MikAmperka/abot_src/ros/README.md

# The Amperka robot "Abot".
RPI4, ROS, DiffDrive, RPLidar, SLAM.
