MikAmperka/abot_src/ARTICLE_RU/description/RU.md

---
title: Как сделать робота на ROS своими руками
short: Собираем своего робота на Raspberry Pi 4 под управлением ROS и C++
date: 2021-04-07
author: Максим Данилин
all_tags:
 - Raspberry Pi 4
 - С++
 - ROS
 - 3D-печать
 - Linux
 - Solidworks
 - RPLIDAR
 - Troyka HAT
 - Двухканальный Н-мост
 - SLAM
 - Навигация
---

## Введение

Привет!

В этой статье мы на подробном примере расскажем о том, как построить настоящего робота целиком на инфракструктуре ROS. Это будет наш первый простой робот со своей операционной системой.

Далее мы постараемся пошагово и как можно подробнее рассказать вам о процессе проектирования, конструирования и программирования робота, а также расскажем, с каким трудностями и проблемами мы столкнулись.

Создание свеого робота — это не самая сложная, но и не тривиальная задача. Она требует опредёленных навыков хотя бы на минимальном уровне:

- Работа с OS Linux.
- Твердотельное 3D-моделирование.
- Программирование на С++ или Python.
- Навыки 3D-печати.

Также вам понадобится персональный компьютер под управлением OS Linux, Windows и локальная сеть Wi-Fi.

Все исходники — как конструкторские САПР-файлы, так и исходный код — мы разместили в GitHub-репозитории [https://github.com/gabbapeople/abot](https://github.com/gabbapeople/abot).

## Цель робота

Постройка робота начинается с идеи. Прежде чем бежать собирать своего робота, вам нужно ответить для себя на следующие вопросы:

- Как должен выглядеть мой робот?
- Из каких частей/сегментов будет состоять мой робот?
- Что должен делать мой робот и как?

Все промышленные роботы создаются с какой-либо целью. Люди стремится облегчить себе жизнь, переложив часть своих задач на роботов. Машины могут выполнять тяжелую физическую работу: например, как сварочные роботы-манипуляторы или транспортные роботы на автоматизированных складах-хранилищах. Или же роботы могут взяться за опасные для человека задачи: например, обезвредить бомбу вместо сапёра, работать в завалах или токсичных и ядовитых средах. А такие вещи, как робот-пылесос и беспилотный транспорт избавляют человека от рутинных задач для экономии времени.

Назначение робота практически полностью определяет его внешний вид, конструкцию и программу. Обычно робот, созданный для конкнретных задач в одной области, не способен работать в какой-либо другой. Цель создания нашего робота будет скорее обучающей и развлекательной, нежели практической.

Мы попробуем создать «офисного питомца» — робота, который будет жить с нами в офисе и передвигаться туда, куда мы ему скажем. При этом робот должен будет самостоятельно ориентироваться в помещении. Кажется, что навигация в офисе — это лёгкая задача, однако это совсем не так. Мы планируем постепенно добавлять нашему роботу новые функции, но начнём именно с этой конкретной задачи.

Поскольку мы решили, что наш робот не стационарный (как робот-манипулятор), а мобильный, то ему сперва понадобится какое-то подвижное шасси.

## Привод робота

### Типы приводов

Рассмотрим разные типы приводов мобильных роботов и выясним, какую механику они используют. Затем, сравнивая все плюсы и минусы, выберем привод для нашего робота.

Роботы могут передвигаться в 2D- или 3D-пространстве. Очевидно, что только летающие роботы способны маневрировать во всех плоскостях, и они чрезвычано сложны. Например, летающие дроны ориентируются в помещении или на местности, используя трёхмерные камеры глубины. Постройка такого робота потребует сложнейшего железа и программного обеспечения, поэтому летающего дрона мы не рассматриваем.

Если роботу нужно передвигаться только в двухмерном пространстве, всё становится уже проще. Мы можем рассмотреть движение робота как движение материальной точки в плоскости (X, Y) в [прямоугольной или Декартовой системе координат](https://ru.wikipedia.org/wiki/Прямоугольная_система_координат) (X, Y, Z).

Движение робота в плоскости может быть [голономным](https://ru.wikipedia.org/wiki/Голономная_система) (Holonomic) или [неголономным](https://ru.wikipedia.org/wiki/Неголономная_система) (Non-holonomic). Что это значит? При голономном движении робот способен свободно двигаться по любому вектору XY, не меняя при этом своей ориентации. При неголономном движении робот может передвигаться только в нескольких ограниченных направлениях.

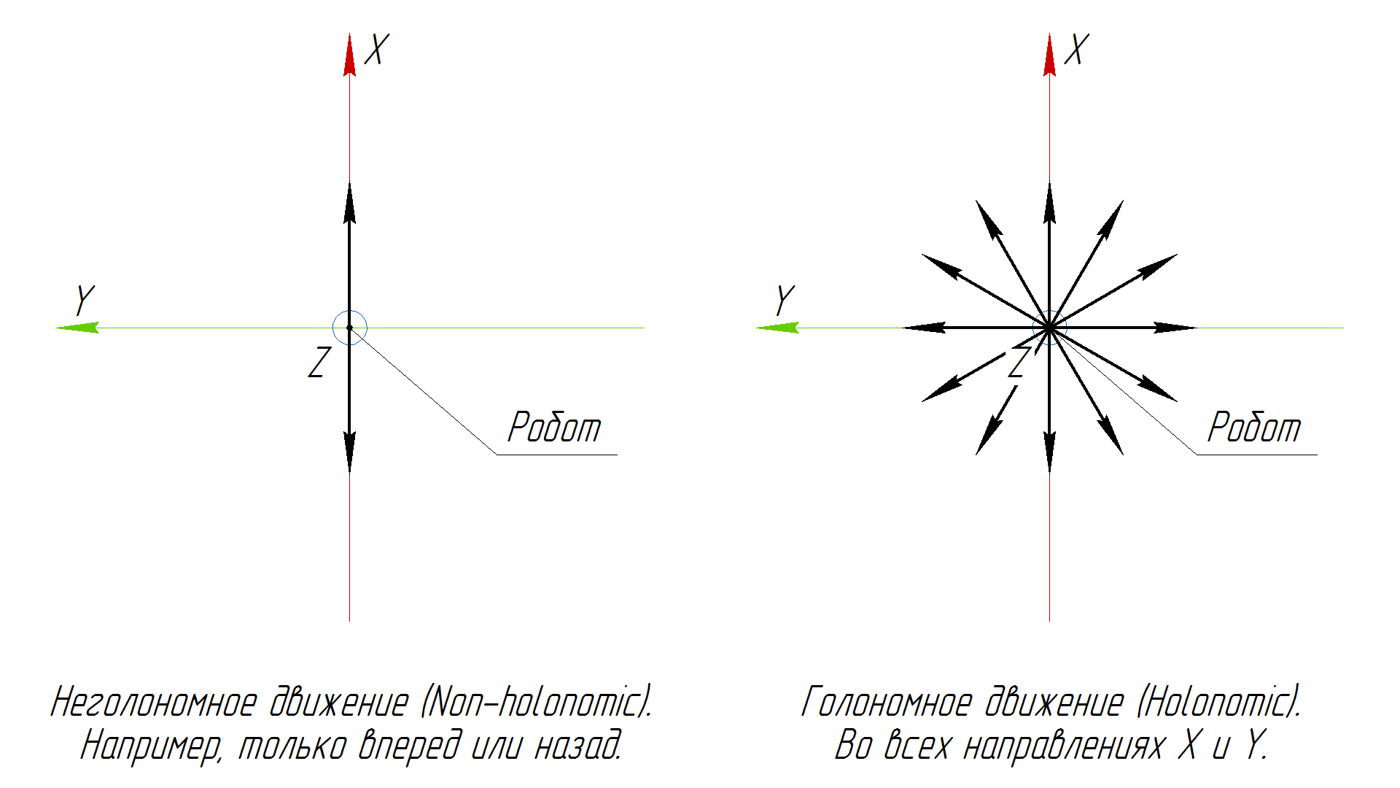
[picture p1: ARTICLE_RU/media/part_1/drive_0/schemes/part_1_ru_robot_drive_0_scheme_1.png]


Например, обычный автомобиль не может взять и подвинуться строго вправо или влево с места — значит, его движение неголономно. С другой стороны, если бы у автомобиля вместо обычных колёс стояли [всенаправленные](https://ru.wikipedia.org/wiki/Всенаправленное_колесо), то он смог бы двигаться голономно.

Вы, наверное, спрашиваете себя: «Зачем мне всё это нужно знать?» Понимание того, каким именно образом движется робот, и понимание принципов получения проекций его скоростей в системе координат чрезвычайно важно при создании управляющей программы. Чем больше направлений движения и вращения имеет робот, тем сложнее сконструировать его механику и контролировать его движение.

Ещё одиним важным фактором при выборе привода робота является сложность получения одометрии и её точность.

[Одометрия](https://ru.wikipedia.org/wiki/Одометрия) — это использование данных с установленных на роботе сенсоров и датчиков для расчёта его текущего положения и ориентации в пространстве. С некоторых приводов получить качественную одометрию очень легко — например, с двухколёсного дифференциального привода (2WD differential drive). Для этого достаточно парочки колёсных энкодеров. С других же приводов получить точную одометрию невероятно трудно: например, для шагающей робо-собаки или робота-гуманоида вам понадобятся десятки различных 2D/3D-сенсоров и сложнейший софт.

Мы попробовали собрать самые популярные способы передвижения для хобби-роботов.

### Дифференциальный привод двумя ведущими колёсами с пассивными опорами

[Двухколёсный дифференциальный привод](https://en.wikipedia.org/wiki/Differential_wheeled_robot) — самый простой и распространённый тип привода в любительской робототехнике. Именно он используется в домашних роботах-пылесосах.

Двухколёсное дифференциальное шасси состоит из двух ведущих колёс, которые установлены на противоположных сторонах корпуса, и одного или нескольких всенаправленных (пассивных) колёс или опор. Каждое ведущее колесо приводится в движение собственным мотором и управляется независимо друг от друга. Пассивные колёса-опоры устанавливаются на такое шасси для достижения равновесия всей платформы.

К слову, именно такой тип привода имеют наши [Робоняша](prod://robonyasha-iskra-js) и [Драгстер](prod://dragster).

Движение двухколёсного дифференциального привода неголономно. Перемещение робота здесь задаётся линейной скоростью по оси Х (вперёд или назад) и угловой скоростью вокруг оси Z (вращение на месте). Синтез этих двух скоростей заставляет робота поворачивать во время движения.

Вот основные типы движения такого робота:

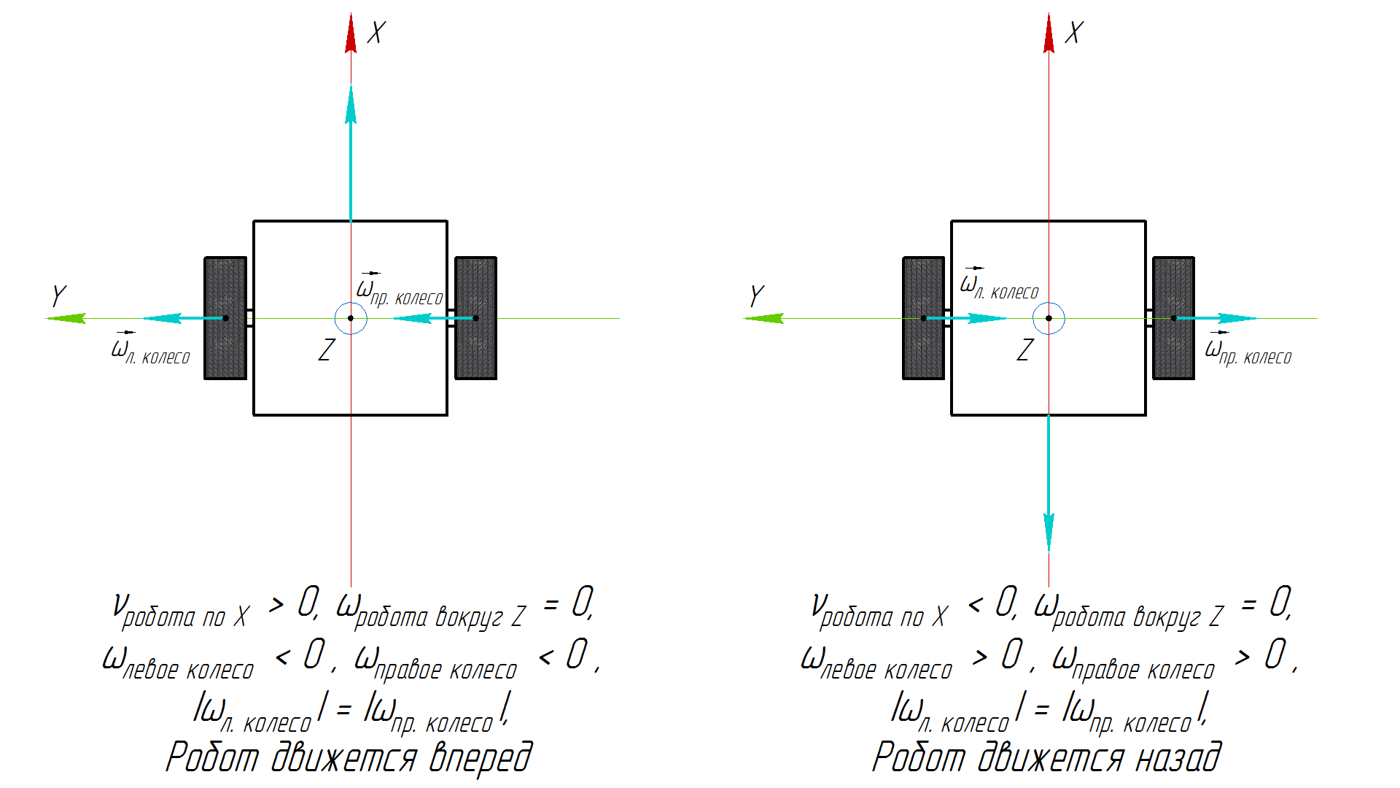
[picture p2: ARTICLE_RU/media/part_1/drive_1/schemes/part_1_ru_robot_drive_1_scheme_1.png]


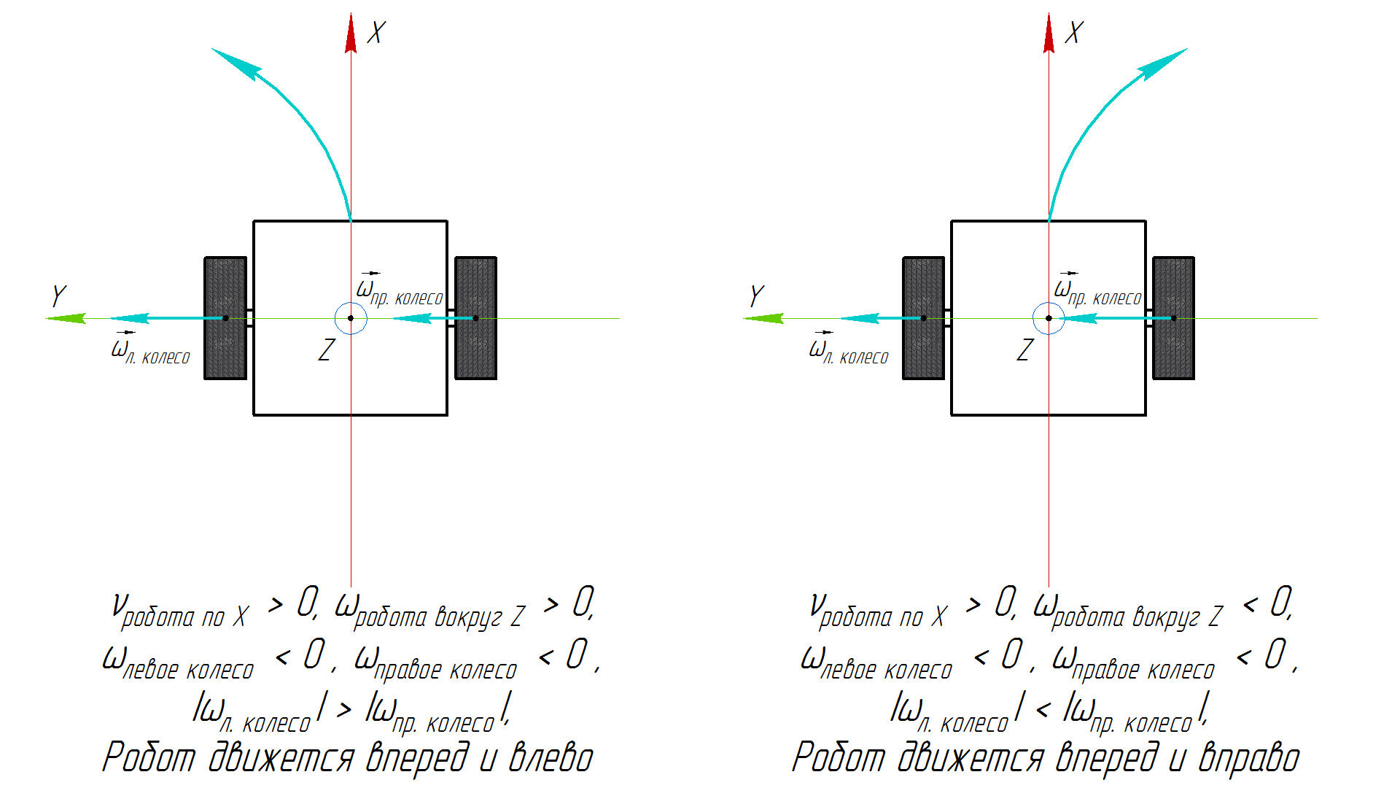
[picture p3: ARTICLE_RU/media/part_1/drive_1/schemes/part_1_ru_robot_drive_1_scheme_2.png]


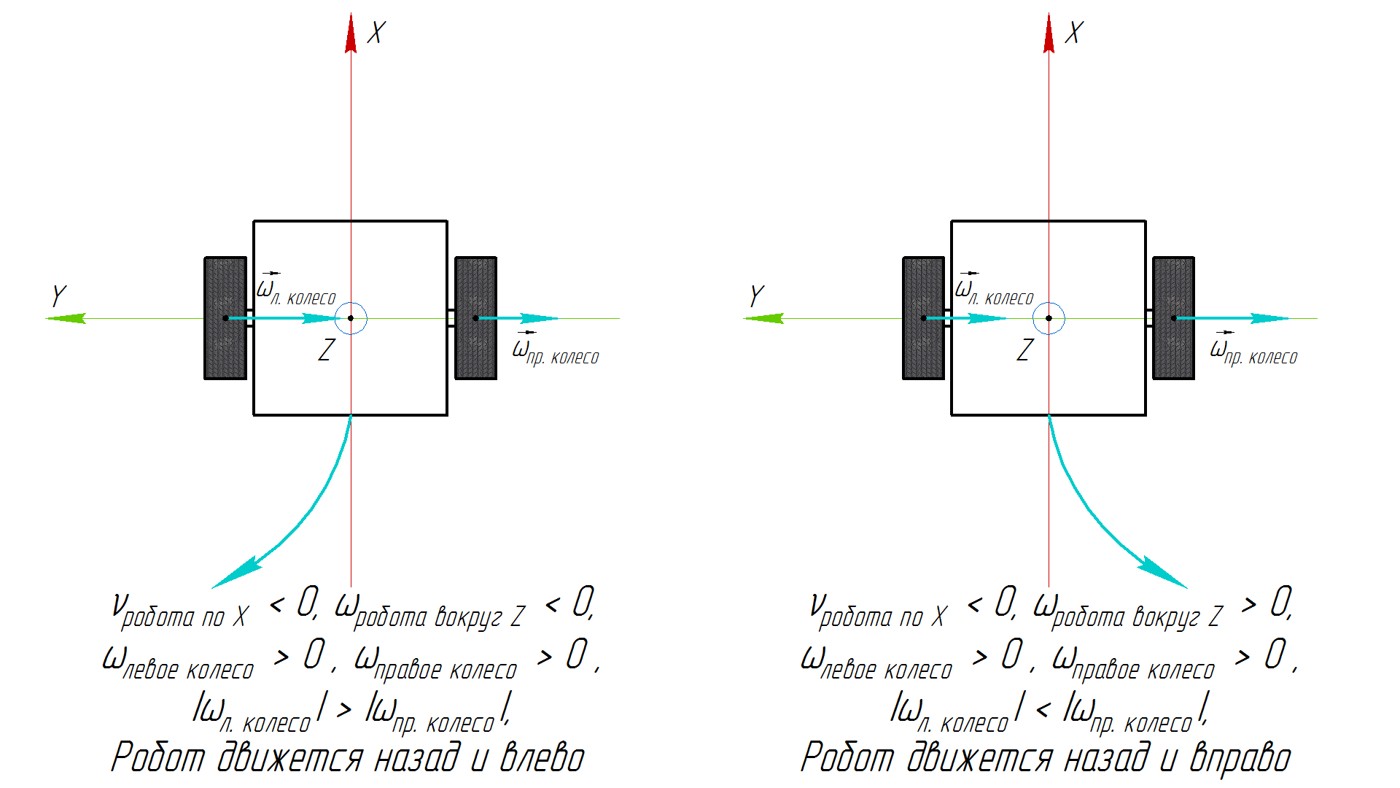
[picture p4: ARTICLE_RU/media/part_1/drive_1/schemes/part_1_ru_robot_drive_1_scheme_3.png]


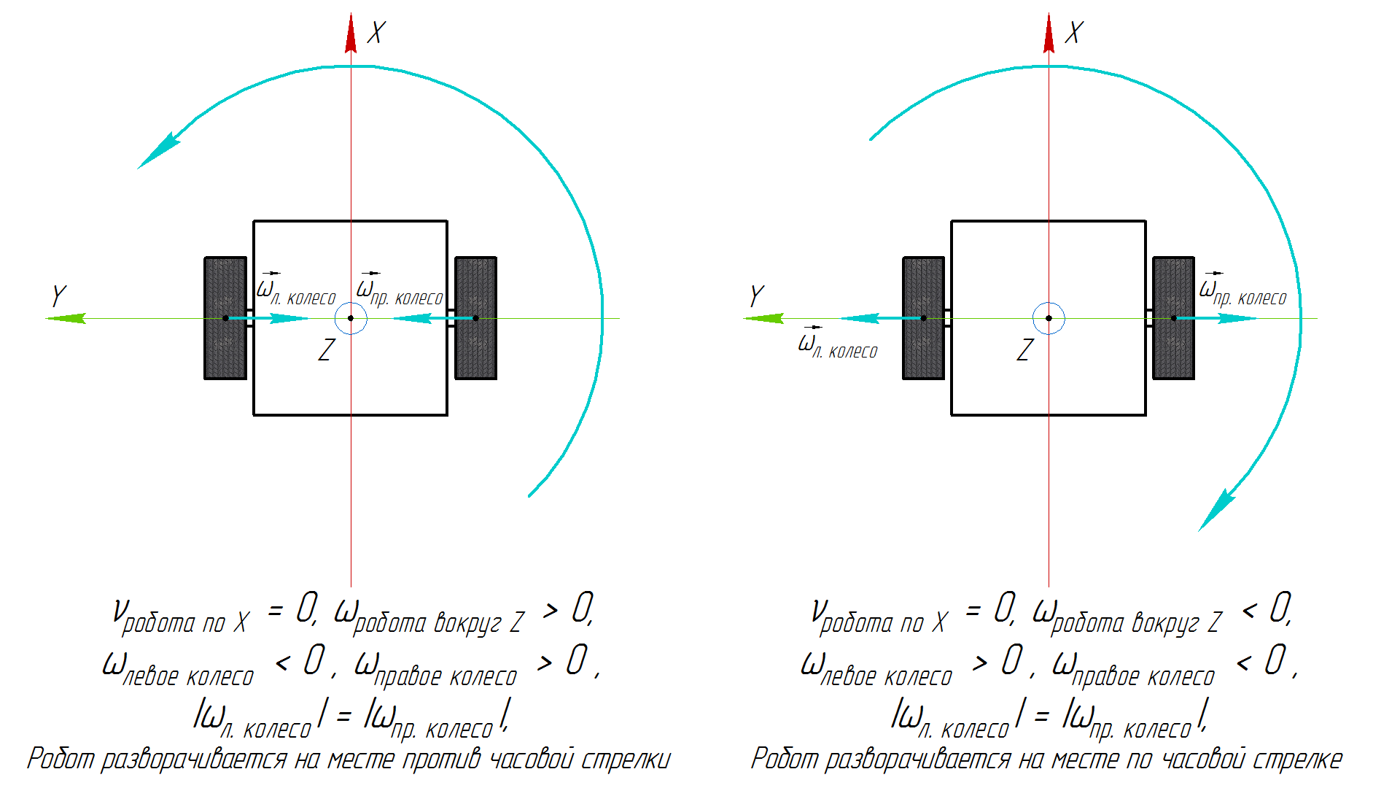
[picture p5: ARTICLE_RU/media/part_1/drive_1/schemes/part_1_ru_robot_drive_1_scheme_4.png]


Особенности шасси:

- Легко сконструировать.
- Легко программировать контроллер движения.
- Легко получить относительно качественную одометрию всего двумя датчиками вращения колёс.
- Шасси не предназначено для движения по бездорожью. Любая значительная преграда на пути может вывести двухколёсную платформу из равновесия. Чаще всего это шасси используется в помещении и для движения по ровной поверхности.

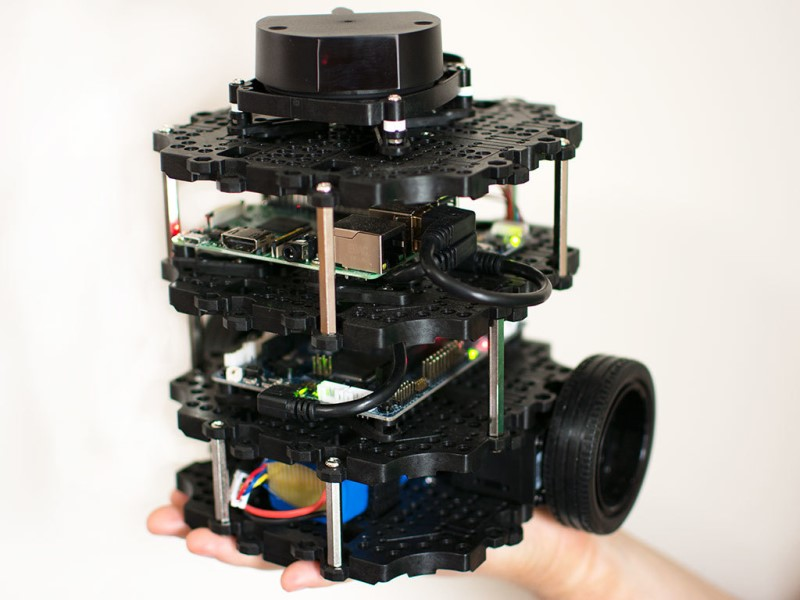
[picture p6: ARTICLE_RU/media/part_1/drive_1/showcase/part_1_robot_drive_1_showcase_1.jpg]


Turtlebot3 от Robotis

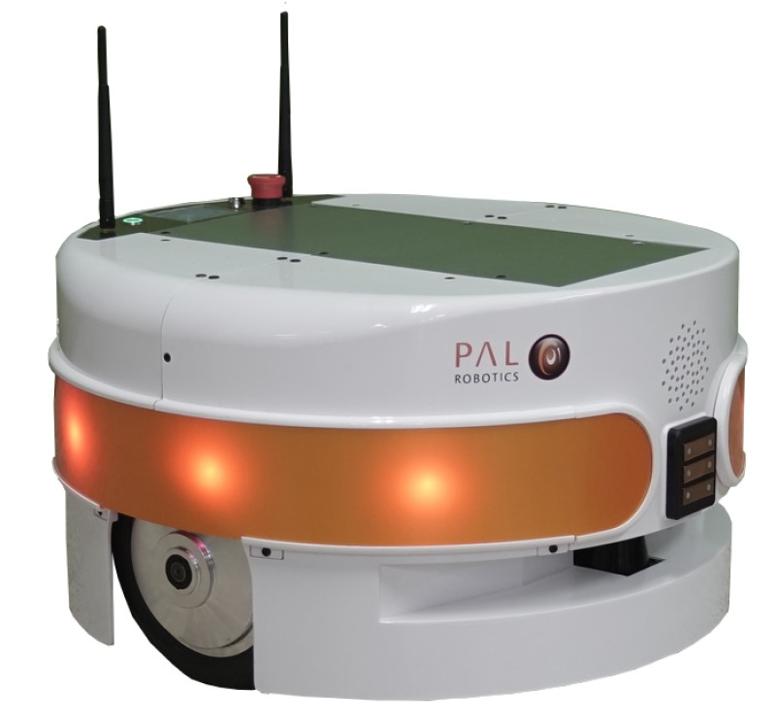
[picture p7: ARTICLE_RU/media/part_1/drive_1/showcase/part_1_robot_drive_1_showcase_2.jpg]


PAL Robotics

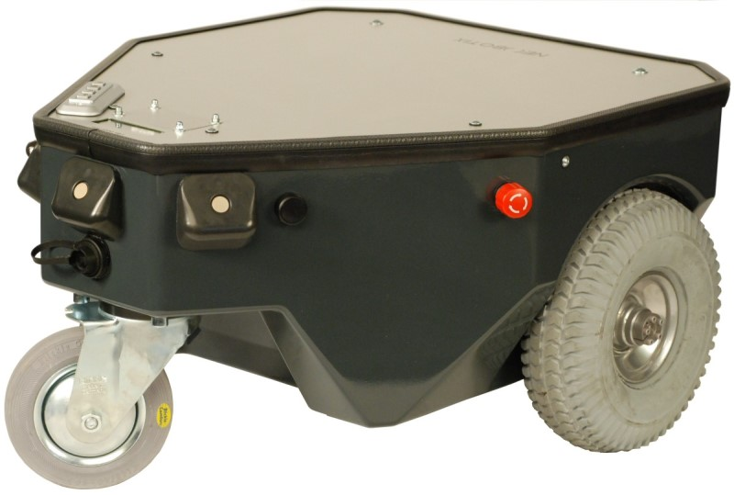
[picture p8: ARTICLE_RU/media/part_1/drive_1/showcase/part_1_robot_drive_1_showcase_3.jpg]


Мобильный робот MP-500 от Neobotix

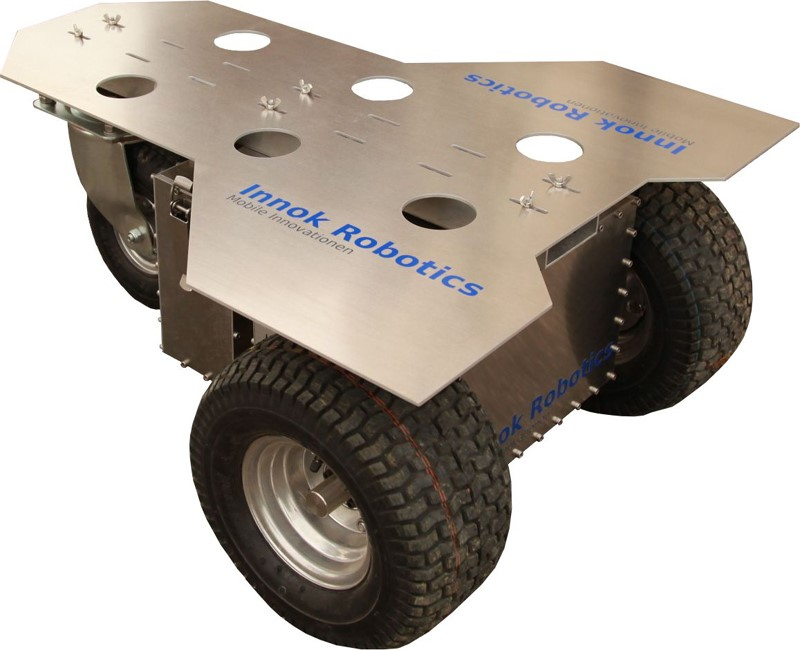
[picture p9: ARTICLE_RU/media/part_1/drive_1/showcase/part_1_robot_drive_1_showcase_4.jpg]


The Innok Robotics

### Дифференциальный привод Skid-steer

Привод skid-steer — это расширенная версия простого двухколёсного дифференциального привода. В этом приводе равновесие платформы достигается не пассивными колесами, как в двухколёсном варианте, а дополнительными ведущими. На каждой стороне робота может быть четыре, пять, шесть и более колёс, которые управляются общим мотором через передачи и вращаются с одинаковой скоростью. Обычно в этом шасси используются два двигателя (по одному на сторону), но бывают плафтормы, где каждое колесо управляется собственным мотором.
  
Движение привода skid-steer неголономно. Принцип движения такой же, как и у двухколёсного дифференциального привода.

Пример задания скоростей робота:

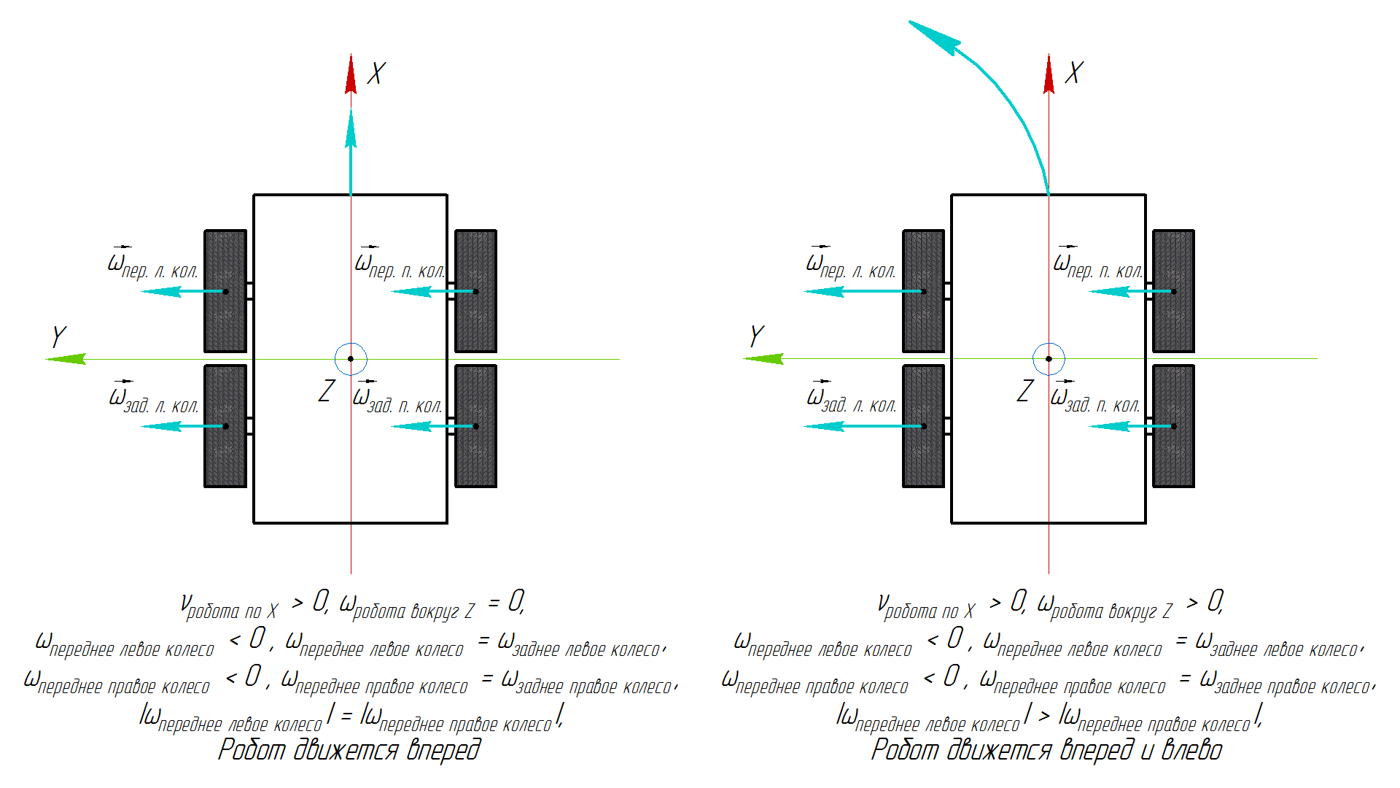
[picture p10: ARTICLE_RU/media/part_1/drive_2/schemes/part_1_ru_robot_drive_2_scheme_1.png]


Особенности шасси:

- В сравнении с двухколёсной платформой skid-steer обладает повышенной проходимостью. Это достигается благодаря множеству колёс и отсутствию пассивных опор. Робот с большими колесами может быть очень эффективен на пересечённой местности.
- Одометрию так же легко получить, используя датчики вращения колёс. Однако каждое колесо шасси skid-steer нуждается в собственном сенсоре. Точность одометрии в сравенении с двухколёсной платформой заметно ниже. При поворотах робота колёса шасси проскальзывают. При движении такого шасси по ровной местности моменты заноса и скольжения можно определить и исправить программно. Но для получения одометрии при движении платформы skid-steer по пересечённой местности одних только датчиков вращения колёс может быть уже не достаточно.

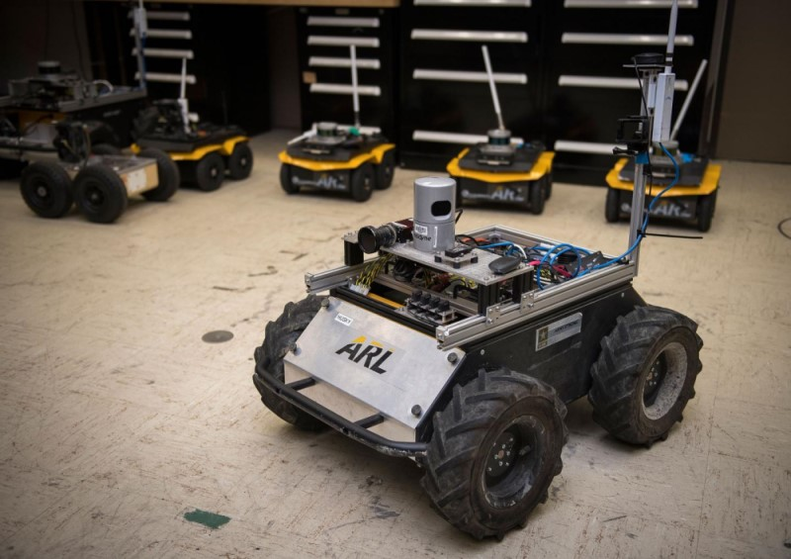
[picture p11: ARTICLE_RU/media/part_1/drive_2/showcase/part_1_robot_drive_2_showcase_1.jpg]


Husky robot

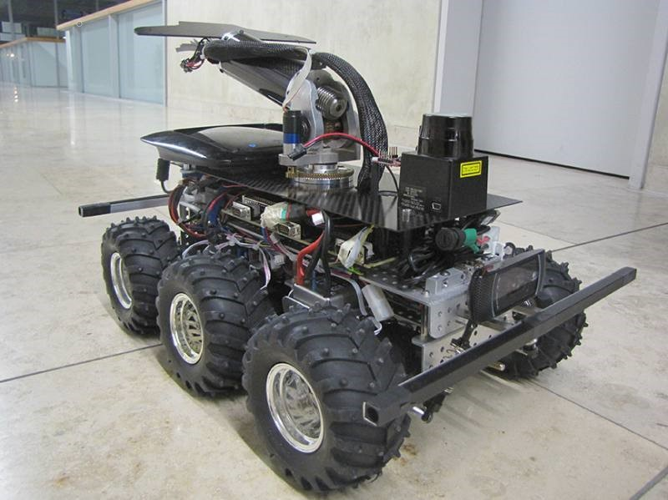
[picture p12: ARTICLE_RU/media/part_1/drive_2/showcase/part_1_robot_drive_2_showcase_2.jpg]


Wild Thumper 6WD от DAGU Electronics

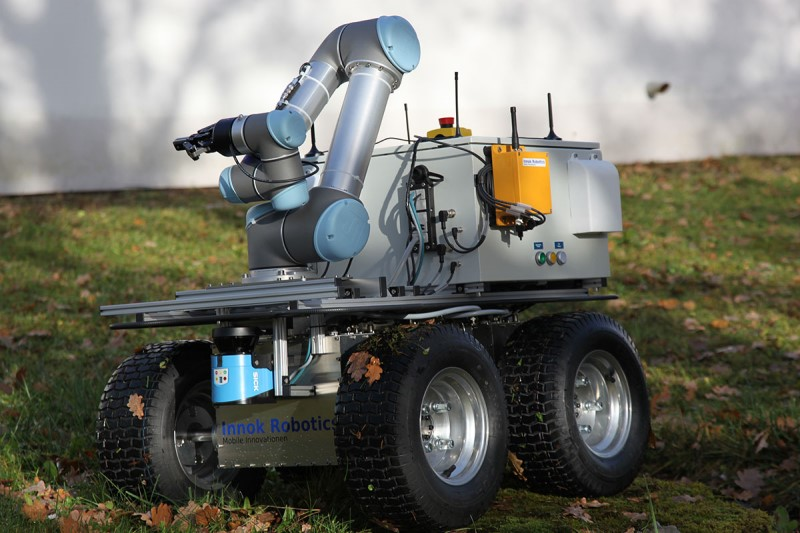
[picture p13: ARTICLE_RU/media/part_1/drive_2/showcase/part_1_robot_drive_2_showcase_3.jpg]


The Innok Robotics

### Дифференциальный привод с гусеницами

Дифференциальный привод с гусеницами (танковое шасси) — версия привода skid-steer с гусеницами вместо дополнительных колёс. Как и ранее, каждая гусеница и сторона робота контролируется одним мотором.

Можно интерпретировать этот привод как двухколёсный дифференциальный, где колесо имеет некруглую форму и увеличенную длину окружности. Или как привод skid-steer с бесконечным количеством колёс на определённой длине.

Движение привода с гусеницами неголономно. Принцип движения тут такой же, как и у привода skid-steer. Только для обработки перемещения робота используются не угловые скорости колёс, а скорости гусениц.

Особенности шасси:

- Танковое шасси обладает самыми высокими эксплуатационными характеристиками на пересечённой местности благодаря форме гусениц и сцеплению с землёй.
- Усложнённая механика. В конструкции танкового шасси множество непростых деталей: части трака, натяжители, опорные ролики и т. д.
- Получить одометрию ещё сложнее, чем при использовании привода skid-steer. При движении танкового шасси тоже происходят проскальзывания гусениц и заносы (особенно это заметно, когда робот-танк вращается на месте на ровной поверхности). Однако ввиду наличия всего двух датчиков вращения программно компенсировать ошибки одометрии очень тяжело. При движении по ровной поверхности одометрия неточная, а на пересечённой местности датчики вращения становятся практически бесполезны, и для одометрии понадобятся другие источники.

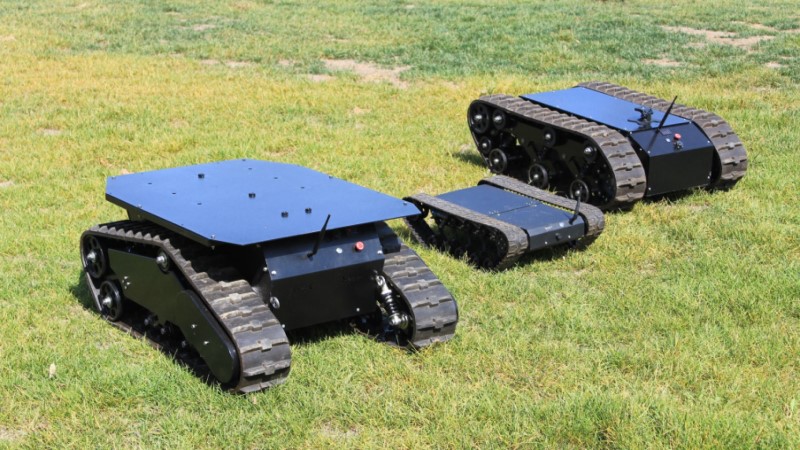
[picture p14: ARTICLE_RU/media/part_1/drive_3/showcase/part_1_robot_drive_3_showcase_1.jpg]


Robodyne MAXXII

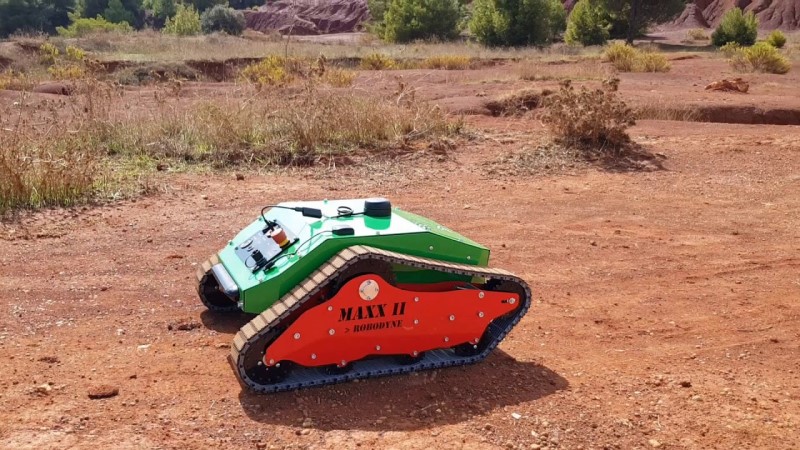
[picture p15: ARTICLE_RU/media/part_1/drive_3/showcase/part_1_robot_drive_3_showcase_2.jpg]


Tank chassis

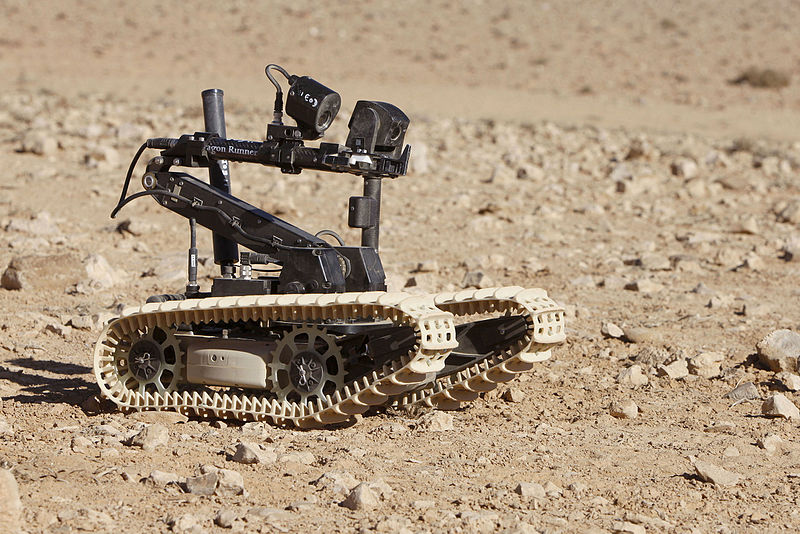
[picture p16: ARTICLE_RU/media/part_1/drive_3/showcase/part_1_robot_drive_3_showcase_3.jpg]


Dragon Runner Bomb Disposal Robot

### Рулевой привод Аккермана

Привод [Ackermann steering](https://en.wikipedia.org/wiki/Ackermann_steering_geometry) — самый распространённый в мире, так как используется в каждом автомобиле. Привод Аккермана состоит из двух ведущих и двух рулевых колёс. Ведущая пара колёс отвечает за движение робота, а рулевые колёса отвечают за повороты. Чтобы избежать заноса и скольжения, рулевое управление Аккермана спроектировано таким образом, что при повороте внутреннее колесо поворачивается на больший угол, чем внешнее. Для каждого колеса угол поворота рассчитывается на основе желаемого диапазона углов поворота робота.

Рулевой привод Аккермана имеет неголономное движение. Этот привод управляется линейной скоростью вдоль оси X и угловой скоростью по оси Z. Но в отличие от дифференциальных приводов, при ненулевой угловой скорости вокруг оси Z линейная скорость по X не может быть равна нулю. Как и автомобиль, робот не сможет развернуться, стоя на месте.

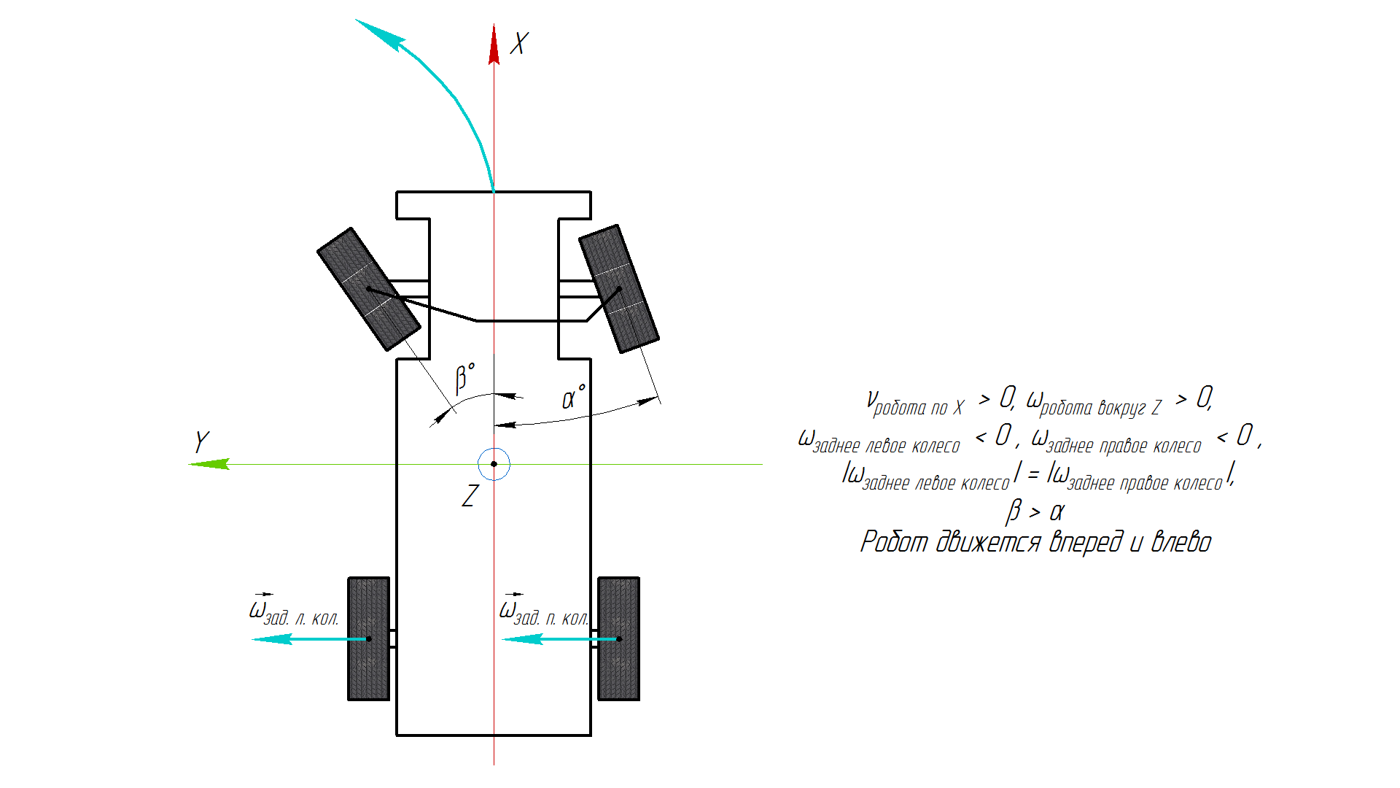
[picture p17: ARTICLE_RU/media/part_1/drive_4/schemes/part_1_ru_robot_drive_4_scheme_1.png]


Особенности шасси:

- Рулевое управление Аккермана обычно используют на ровной поверхности для быстродвижущихся роботов, которые нуждаются в большом дорожном просвете и сцеплении с землёй.
- Наличие вращающихся рулевых колёс усложняет конструкцию робота и требует дополнительных двигателей и приводов.
- Отличный пример использования этого привода в робототехнике — настоящие беспилотные автомобили. Кроме того, этот привод используется в хобби-робототехнике, если робот построен на базе радиоуправляемой игрушечной машинки.

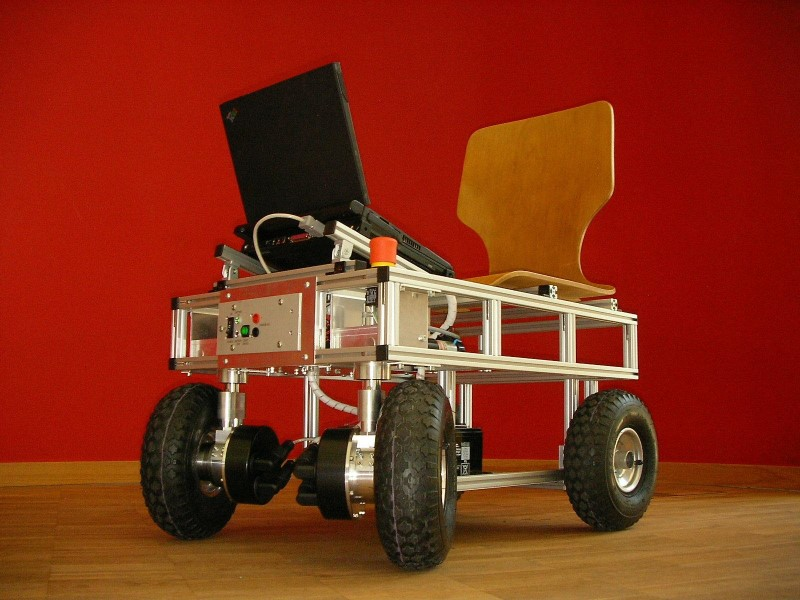
[picture p18: ARTICLE_RU/media/part_1/drive_4/showcase/part_1_robot_drive_4_showcase_1.jpg]


VolksBots

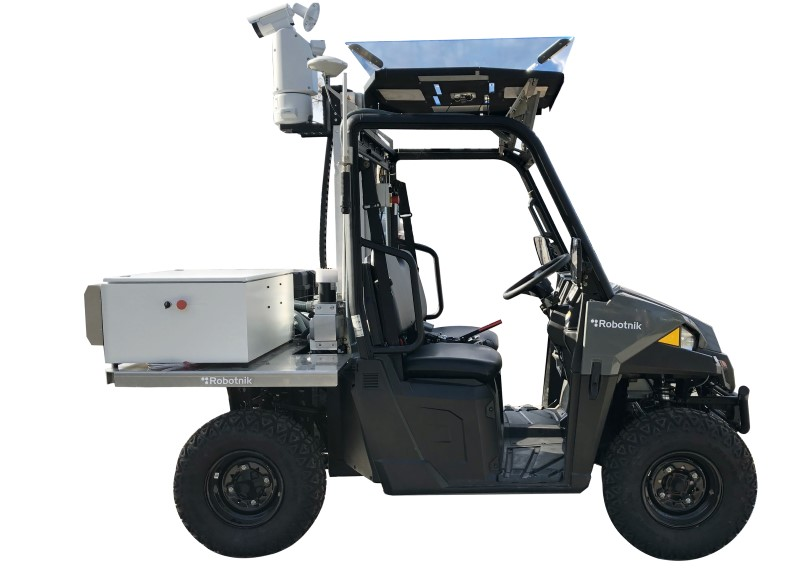
[picture p19: ARTICLE_RU/media/part_1/drive_4/showcase/part_1_robot_drive_4_showcase_2.jpg]


RB-CAR от Robotnik

### Привод с Omni-колёсами

Этот тип привода использует особые [Omni-колёса](https://en.wikipedia.org/wiki/Omni_wheel) вместо обычных. Поликолесо — это всенаправленное колесо с небольшими роликами, расположенными по окружности. Оси роликов перпендикулярны оси вращения колеса. Контролируя скорость и направление вращения поликолёс, вы можете заставить робота двигаться в любом направлении — другими словами, сделать его движение голономным.

Обычно шасси с Omni-колёсами насчитывает ровно 3 или 4 колеса. Шасси с тремя колёсами обеспечивает большую тягу, поскольку любая реактивная сила распределяется только через три точки, и робот хорошо сбалансирован даже на неровной местности. Всенаправленные колёса имеют высокую стоимость, поэтому трёхколёсное шасси обходится заметно дешевле, варианты с четырьмя.

Чаще всего для трёхколёсного шасси выбирают угол установки 120°. Иногда два колеса параллельны друг другу, а третье ставится перпендикулярно к ним. Последняя конструкция может быть более эффективной, потому что когда колёса расположены под углом 120°, только одно из них является ведущим, а два других по сути тормозят его, снижая общую скорость.

Поскольку колёса на таком шасси не выровнены по осям, каждое из них требует индивидуального расчёта скорости.

Пример определения векторов скоростей колёс для трёхколёсного шасси:

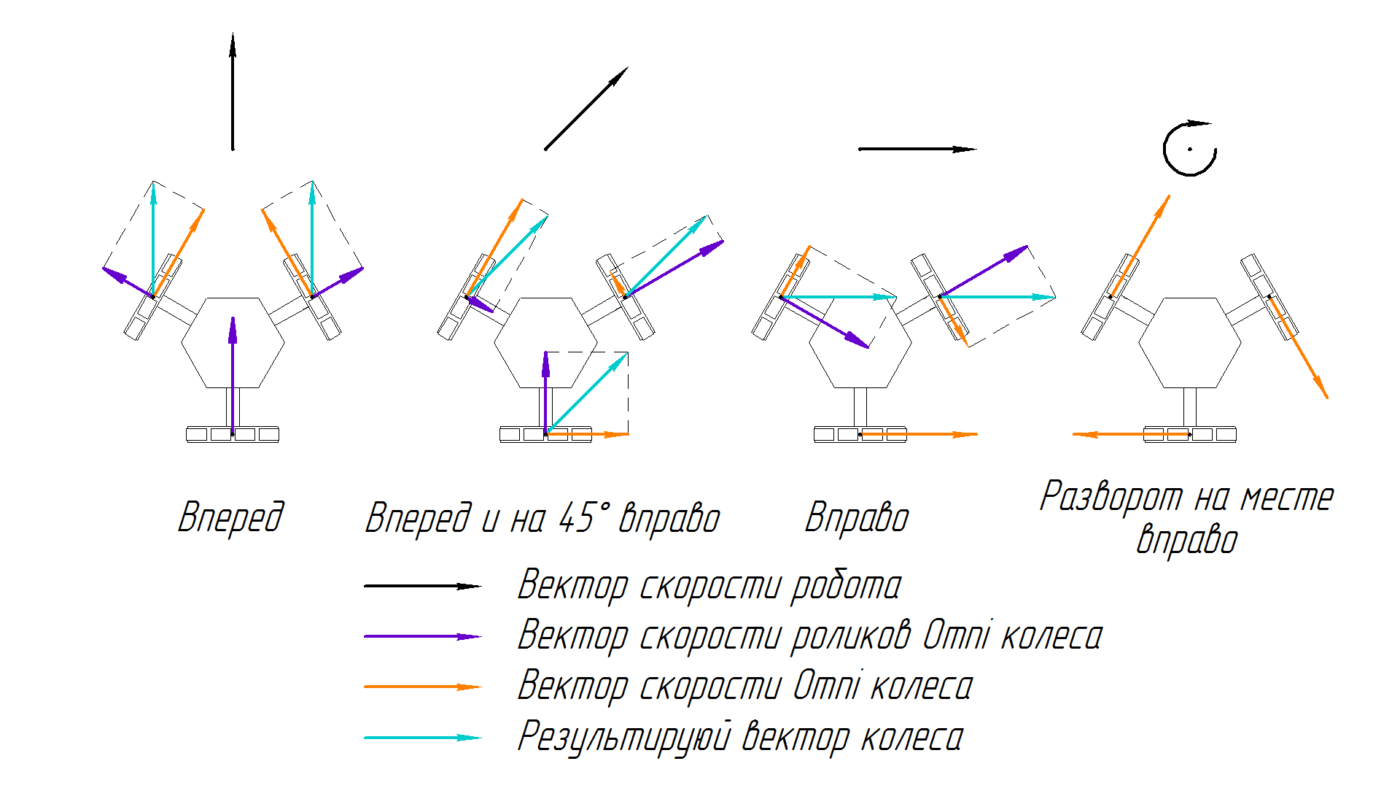
[picture p20: ARTICLE_RU/media/part_1/drive_5/schemes/part_1_ru_robot_drive_5_scheme_1.png]


Четырёхколёсное шасси имеет четыре ведущих колеса, расположенных под углом 90° друг к другу. Эта конструкция удобнее для расчёта скоростей, так как два колеса параллельны друг другу, а два других перпендикулярны к ним. Как и в трёхколёсном шасси, КПД всех колёс также не используется на 100%. Но в отличие от трёхколёсного шасси, здесь есть два ведущих колеса и два свободных. Таким образом, четырёхколёсное шасси движется быстрее, чем трёхколёсное. Четвёртое колесо добавляет шасси ещё одну точку опоры, и на неровной местности одно из колёс робота может оказаться в воздухе.

Пример определения скорости вращения колёс для четырёхколёсного шасси:

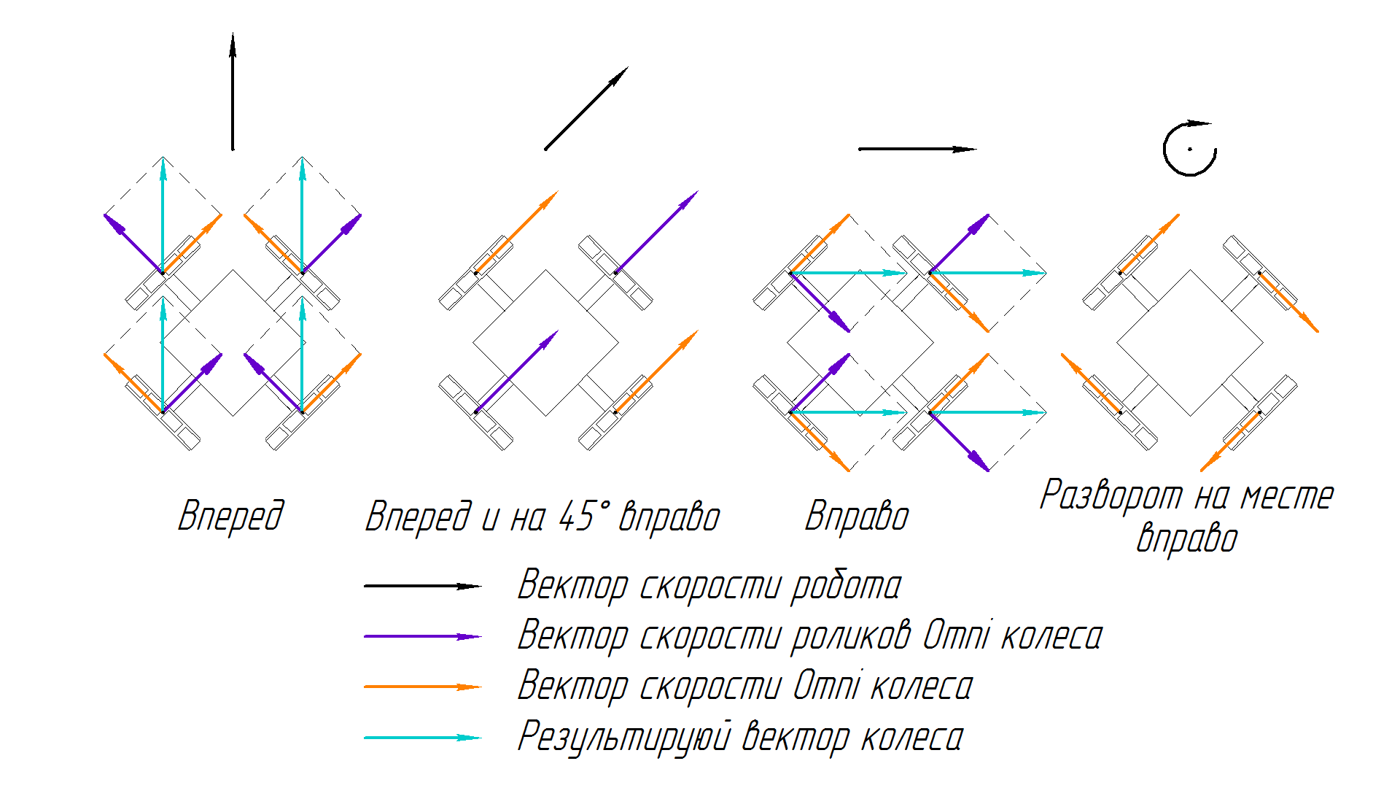
[picture p21: ARTICLE_RU/media/part_1/drive_5/schemes/part_1_ru_robot_drive_5_scheme_2.png]


Особенности шасси:

- Поскольку всенаправленные колёса представляют собой комбинацию из множества роликов, возникает сопротивление вращению, что приводит к повышенному трению и значительным потерям энергии.
- Не все колёса являются ведущими, в каждый момент времени эффективно работают лишь одно-два поликолеса.
- С помощью Omni-колёс достигается голономное движение робота.
- Работа поликолёс изначально строится на принципах проскальзывания. Невозможно поставить датчик вращения на каждый ролик Omni-колеса, поэтому полученная одометрия неточная.
- Чаще всего роботы с таким шасси используются внутри помещений на ровных и гладких поверхностях.

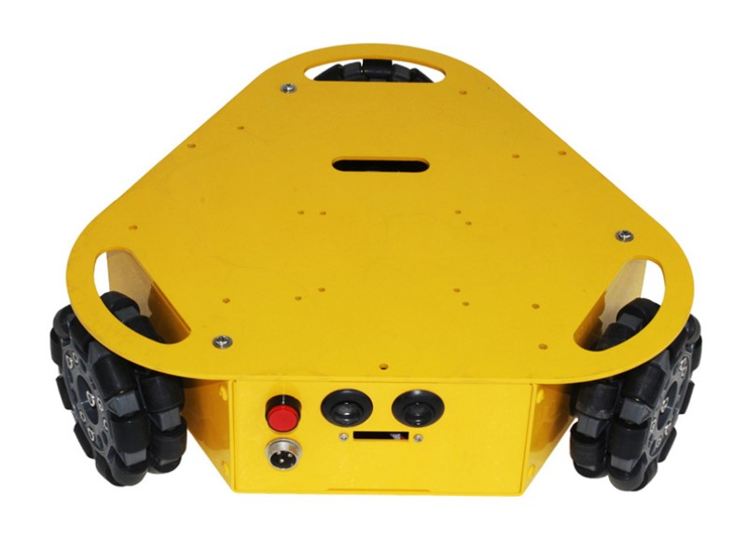
[picture p22: ARTICLE_RU/media/part_1/drive_5/showcase/part_1_robot_drive_5_showcase_1.jpg]


3WD Omni wheel chassis от NEXUS robot

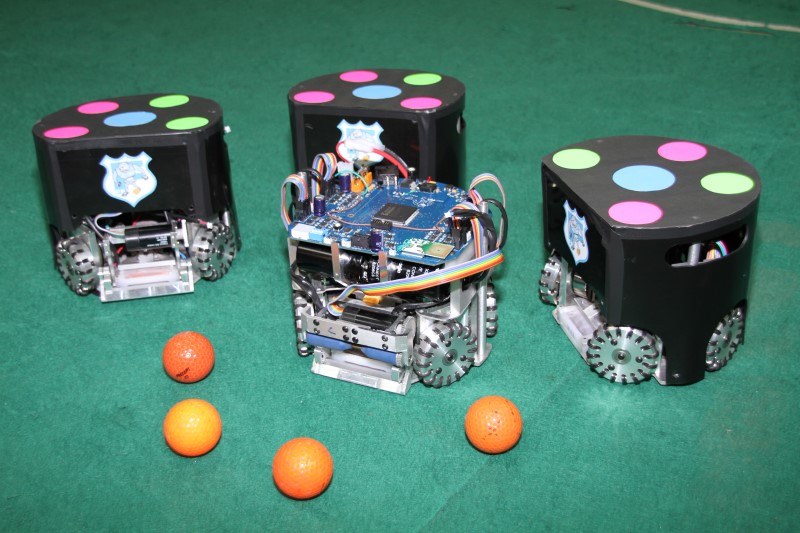
[picture p23: ARTICLE_RU/media/part_1/drive_5/showcase/part_1_robot_drive_5_showcase_2.jpg]


Soccer robots от RoboFEI Team

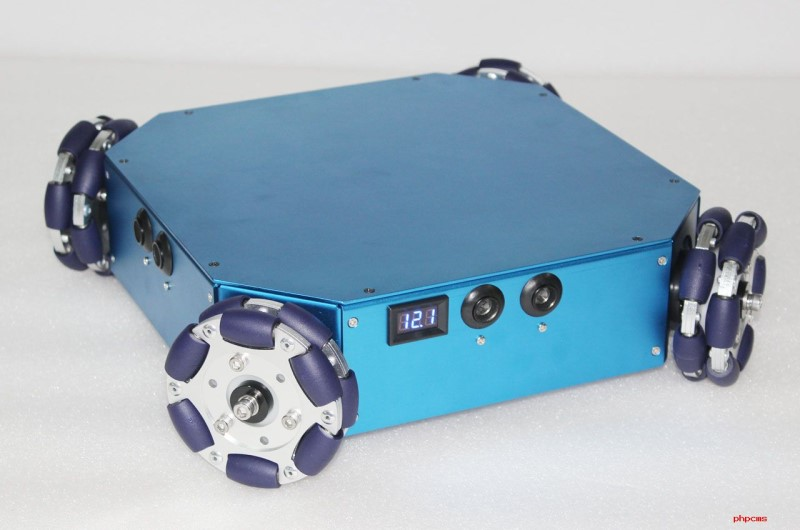
[picture p24: ARTICLE_RU/media/part_1/drive_5/showcase/part_1_robot_drive_5_showcase_3.jpg]


King Kong 4WD Omni Wheel chassis

### Привод с Mecanum-колёсами

Этот тип привода использует вместо обычных [колёса Илона (Mecanum)](https://ru.wikipedia.org/wiki/%D0%9A%D0%BE%D0%BB%D0%B5%D1%81%D0%BE_%D0%98%D0%BB%D0%BE%D0%BD%D0%B0), предназначенные для грузоподъёмных и проходимых роботов. По сути это разновидность Omni-колеса, только на шведском колесе Илона ролики по всей окружности обода расположены под углом 45° к плоскости и 45° к оси вращения колеса.

Поворот оси ролика позволяет использовать колёса Mecanum в приводах skid-steer. Эта комбинация объединяет преимущества шасси skid-steer и привода со всенаправленными колёсами. Колёса Илона заменяют обычные для достижения голономного движения робота. Чаще всего этот тип шасси имеет 4 Mecanum-колеса, но иногда встречается и 6 колёс.

При вращении колеса Илона прилагается сила под углом 45° к его оси. Направление вращения определяет направление приложенной силы. Комбинации сил от всех колёс позволяют роботу двигаться в разных направлениях.

Вгляните на схемы получения скоростей робота:

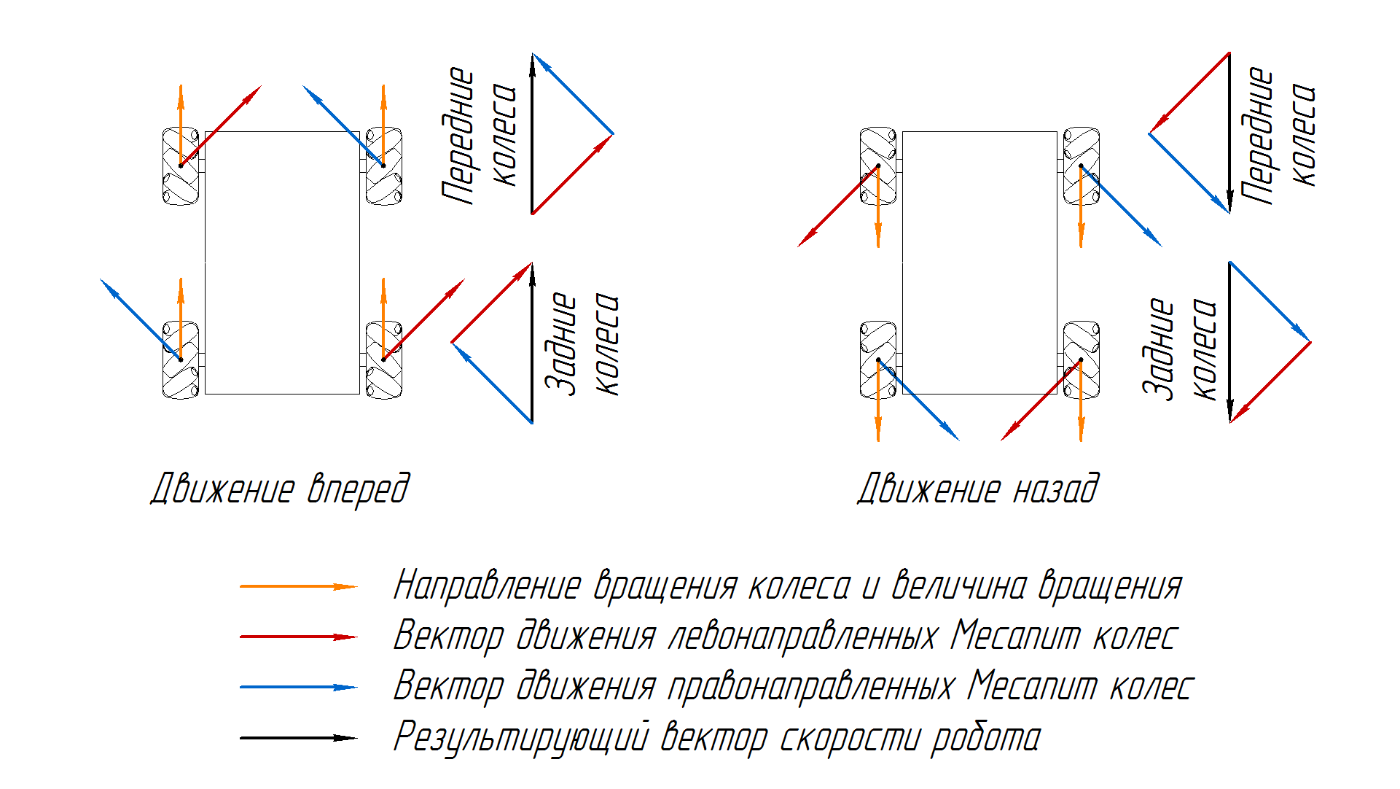
[picture p25: ARTICLE_RU/media/part_1/drive_6/schemes/part_1_ru_robot_drive_6_scheme_1.png]


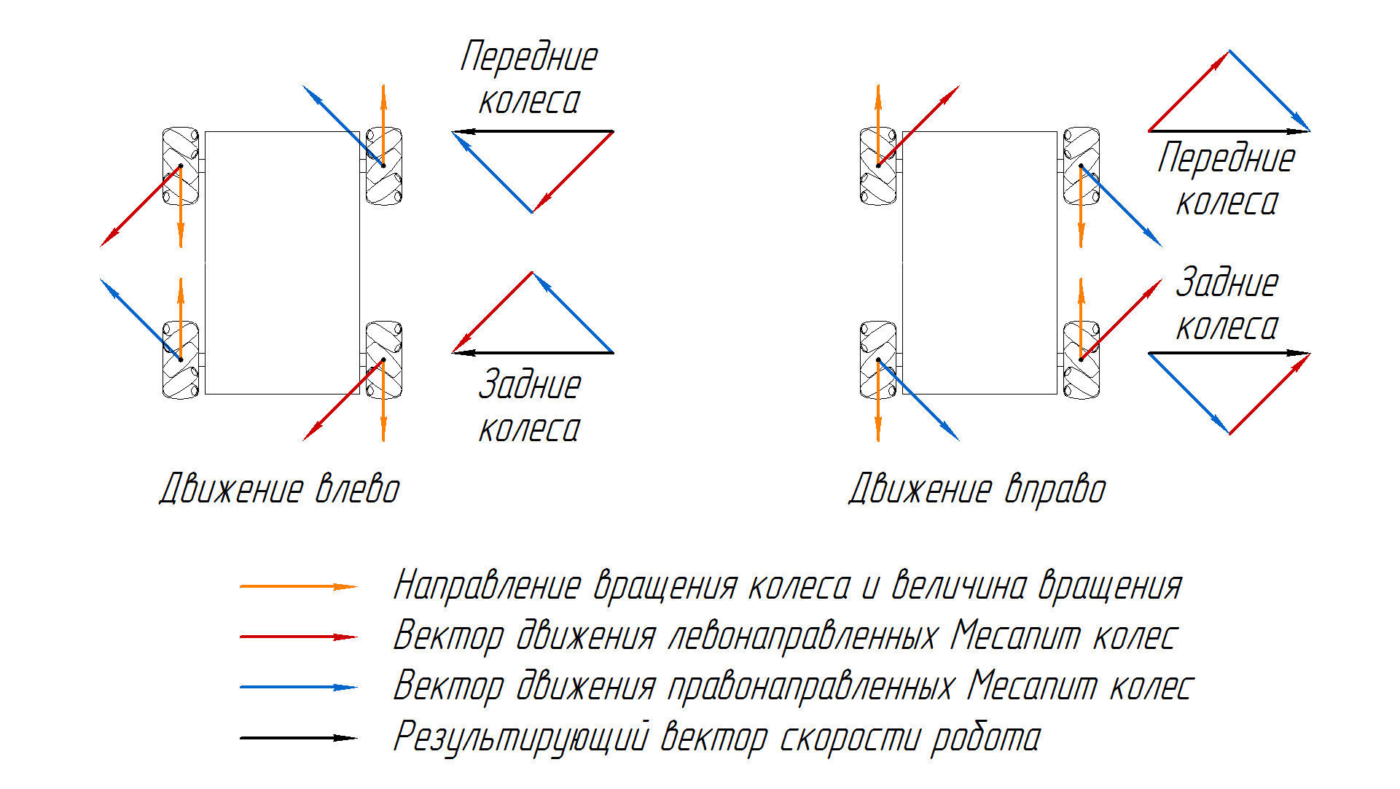
[picture p26: ARTICLE_RU/media/part_1/drive_6/schemes/part_1_ru_robot_drive_6_scheme_2.png]


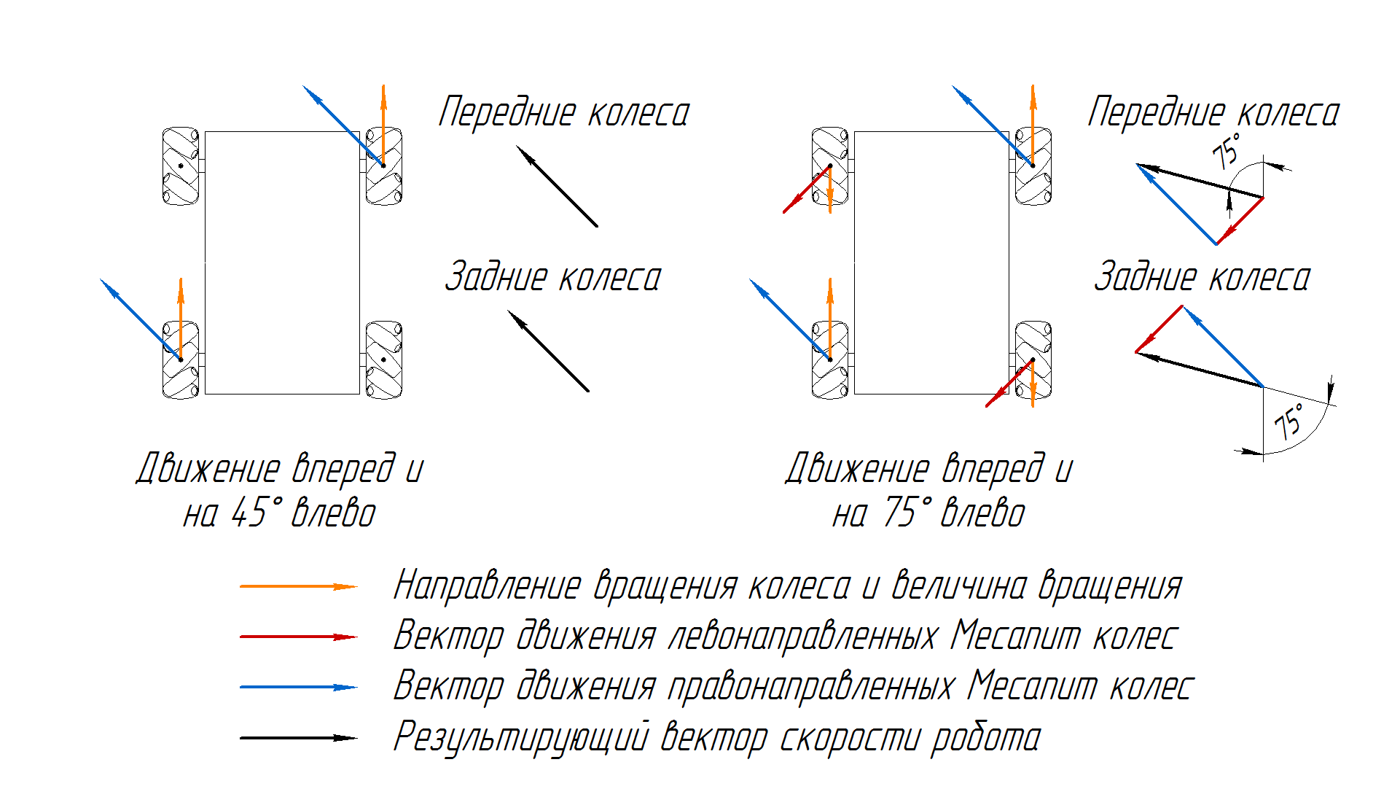
[picture p27: ARTICLE_RU/media/part_1/drive_6/schemes/part_1_ru_robot_drive_6_scheme_3.png]


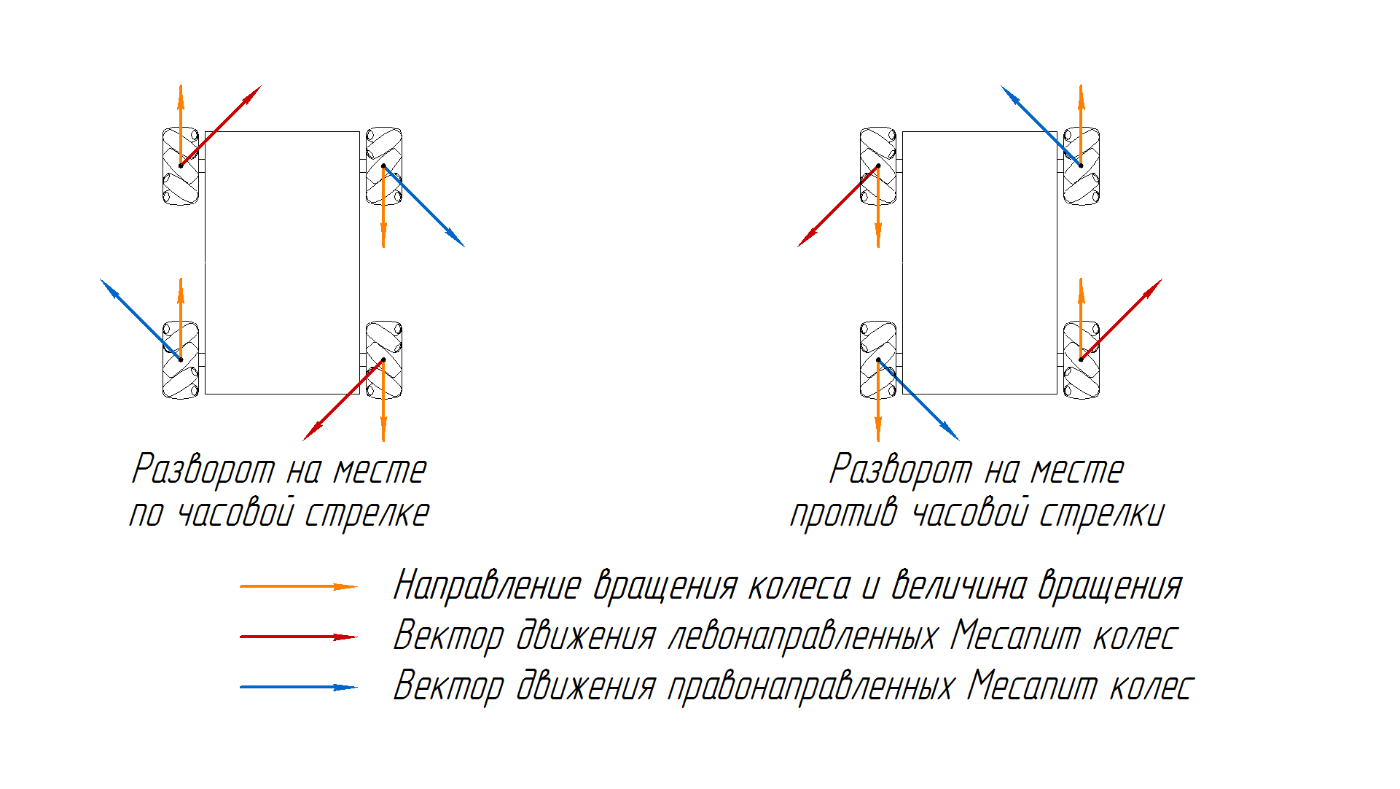
[picture p28: ARTICLE_RU/media/part_1/drive_6/schemes/part_1_ru_robot_drive_6_scheme_4.png]


Особенности шасси:

- Привод с колёсами Илона используется, если робот должен обладать голономным движением и высокой грузоподъёмностью.
- Чаще всего этот тип шасси встречается у грузовых роботов, которые работают на ровной и гладкой поверхности. При использовании такого шасси на бездорожье управление движением и получение качественной одометрии с датчиков вращения колеса крайне затруднено.

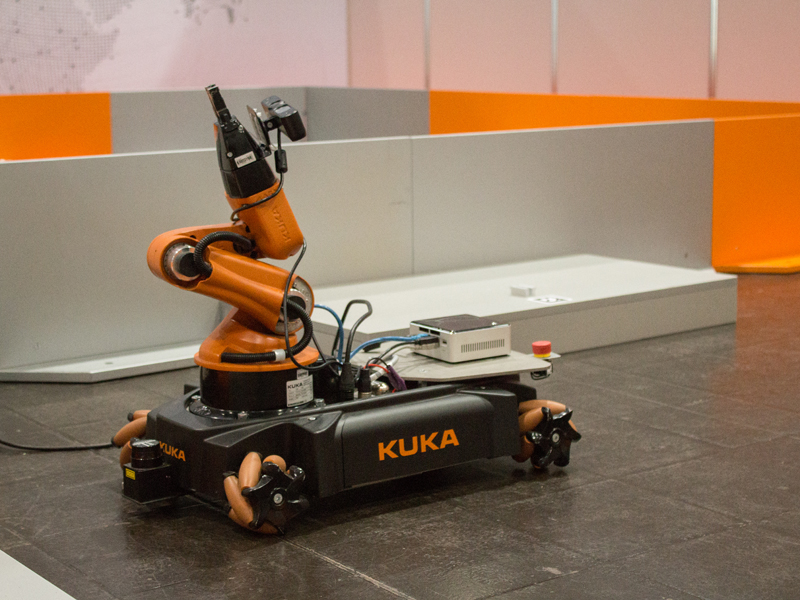
[picture p29: ARTICLE_RU/media/part_1/drive_6/showcase/part_1_robot_drive_6_showcase_1.jpg]


Kuka robot

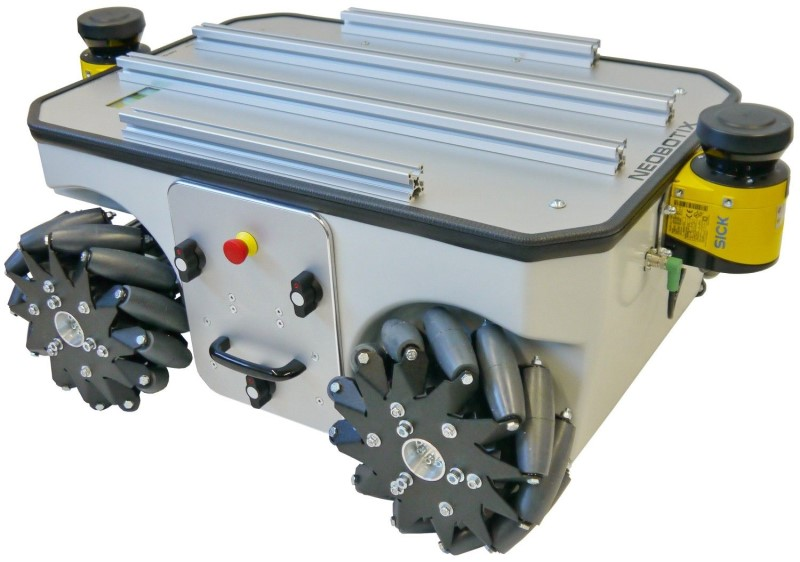
[picture p30: ARTICLE_RU/media/part_1/drive_6/showcase/part_1_robot_drive_6_showcase_2.jpg]


Mobile Robot MPO-500 от Neobotix

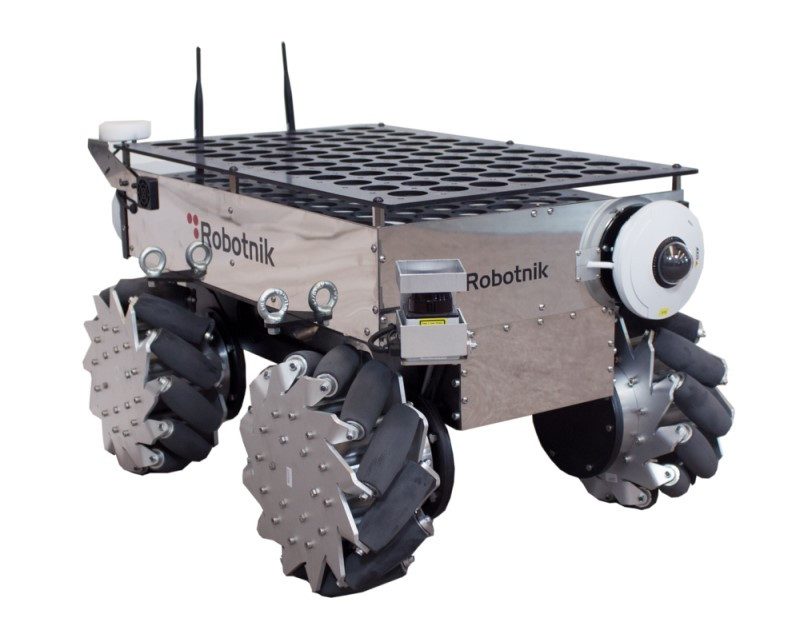
[picture p31: ARTICLE_RU/media/part_1/drive_6/showcase/part_1_robot_drive_6_showcase_3.jpg]


SUMMIT-XL STEEL от Robotnik

### Скелетные роботы

Эти роботы используют конечности или ноги, чтобы перемещаться. Движение таких роботов имитирует естественное движение живого организма.

Роботы на конечностях обладают голономным движением, также как и живые организмы, кинематику которых они повторяют. Например, робот-гексапод может идти в любом направлении, не меняя ориентацию своего тела.

Подобные роботы являюстя самыми мобильными, но и самыми сложными в конструировании. Скелет конечности должен обладать множеством стенепенй свободы. Для этого требуется множество двигателей и приводов, а также сложные системы управления. Из-за большого количества приводов скелетные роботы потребляют больше всего энергии. Для получения одометрии с шагающего шасси используется синтез данных с множества различных сенсоров (энкодеры приводов, IMU-сенсоры, 3D-лидары, 3D RGB-камеры глубины, контактные датчики давления и т. д.), а также машинное обучение.

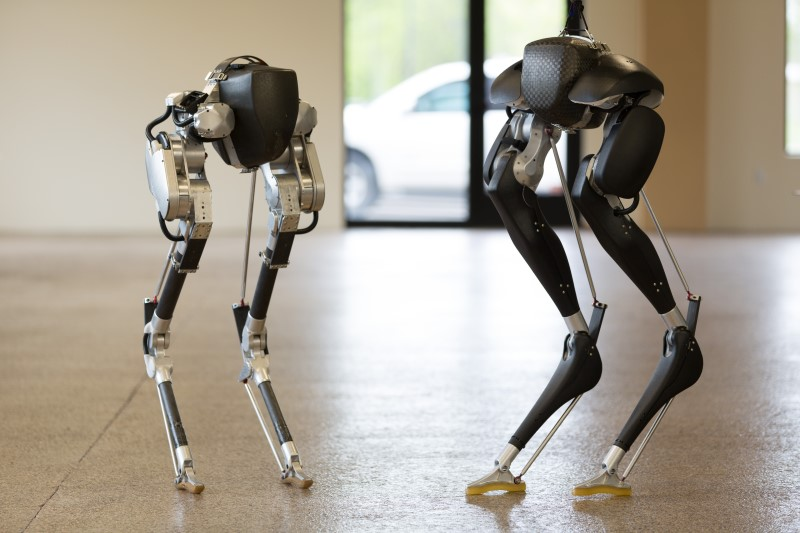
[picture p32: ARTICLE_RU/media/part_1/drive_7/showcase/part_1_robot_drive_7_showcase_1.jpg]


Agility Robotics

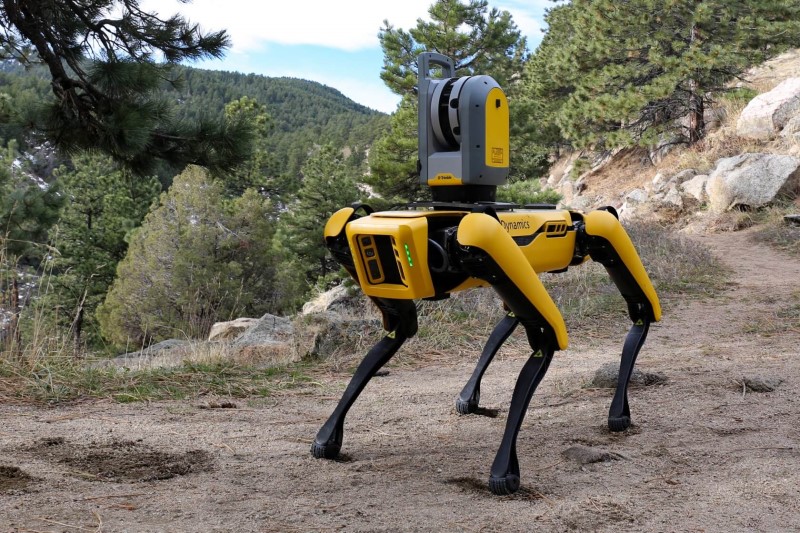
[picture p33: ARTICLE_RU/media/part_1/drive_7/showcase/part_1_robot_drive_7_showcase_2.jpg]


Spot от Boston Dynamics

### Другие типы приводов

В хобби-робототехнике существует великое множество уникальных приводов движения, которые используются крайне редко. Вот лишь некоторые из них:

- Segway drive — дифференциальный двухколёсный привод без пассивных колес. Равновесное состояние робота достигается с помощью датчиков и контроллеров. Пример — автономный сегвей.
- Forklift steering drive — разновидность рулевого привода Аккермана, но с задней парой рулевых колёс и передней парой ведущих.
- Independent drive — привод, в котором все колёса являются ведущими и рулевыми одновременно. Колёс может быть четыре, шесть и более. Пример — марсоход.
- Articulated drive — разновидность рулевого привода Аккермана. Чтобы рулить роботом в движении Articulated drive не поворачивает рулевые колёса, а деформирует всю рулевую часть рамы или шасси.
- Ball drive — привод, при котором робот балансирует и перемещается на сфере.
- Ползучие червеобразные и змееподобные роботы, движение которых основано на трении тела с поверхностью.

## Выбор шасси

Шасси робота напрямую зависит от выбранного типа привода. Мы выбрали двухколесный дифференциальный привод с пассивными колесами. Такой же привод используется в домашних роботах-пылесосах, а они как никто лучше справляются с задачей ориентации в помещении. Кроме того, это самое бюджетное шасси и самое простое в программировании.

При выборе типа привода мы руководствовались эффективностью колесной одометрии. Самая простая одометрия робота, которую вы можете получить - это датчики вращения, установленные на колесах. Обычно, такие датчики скорости представляют собой энкодеры, установленные на валах колес, валах двигателей или валах коробок передач.

Сперва мы попробовали танковое шасси [Rover 5](prod://rover-5-chassis) с резиновыми гусеницами. Установили дополнительные двигатели и энкодеы на колеса. Но, как оказалось, получить качественную одометрию только с помощью энкодеров довольно сложно. Когда робот вращается на месте и на высоких скоростях, гусеницы регулярно проскальзывают, и результирующая одометрия отличается от фактического положения робота. Поэтому мы решили начать с более простого шасси.

Вы можете сначала выбрать тип привода, который вам нравится, а затем самостоятельно построить шасси робота для этого типа. Или наоборот, купить готового шасси для робота и написать программу контроллер под него.

Чтобы самостоятельно собрать качественное робо-шасси, нужно обладать некоторыми навыками проектирования машин, разбираться в материалах, комплектующих и умело работать руками. Собранное своими руками шасси дает вам полное знание всех его деталей, узлов, ключевых моментов и слабых мест. Чем сложнее тип привода и шасси, тем больше вероятность, что вам придется собирать его самостоятельно.

С другой стороны, многие производители предоставляют высококачественные шасси для хобби робототехники. Если вы приобретете готовое шасси, то сможете сэкономить много времени на механической составляющей робота и потратить это время на электронную и программную часть.

**Это важно!** При покупке готового шасси выбирайте наиболее документированное, с маркировкой деталей, информацией о двигателях и полными чертежами основных деталей и компонентов в САПР.

### Шасси Turtle

В нашем роботе мы решили использовать двухколесный диффернциальный привод и робо-платформу [Turtle](prod://turtle-chassis) от DFRobot.

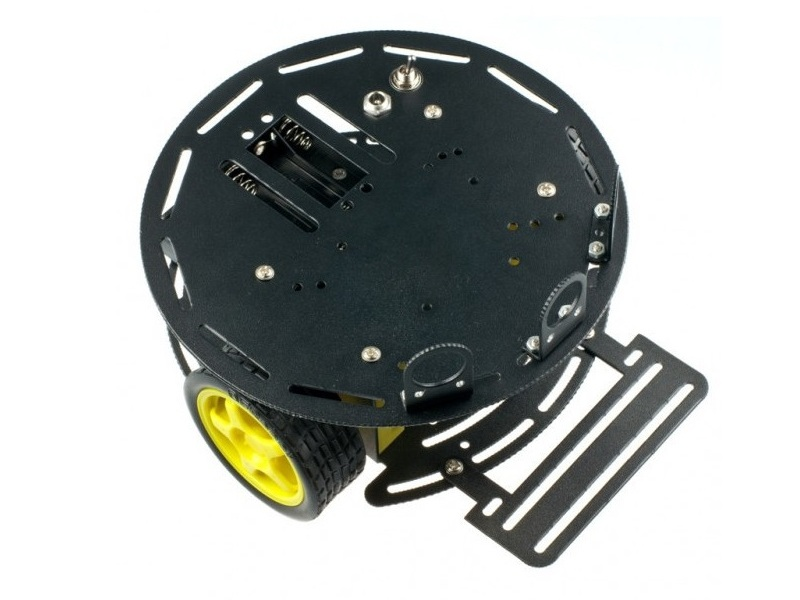
[picture p34: ARTICLE_RU/media/part_2/prod/part_2_prod_chassis_1.jpg]


Это шасси для небольшого робота. Рама изготовлена из металла и состоит из 2 согнутых листовых металлических пластин. Обе пластины имеют перфорацию и вырезы для установки электроники. Шасси имеет два [Мотор-редуктора типа TT с двухсторонним валом (160 об / мин 6 В L-образной формы)](https://www.dfrobot.com/product-100.html), два пластиковых колеса диаметром 65 мм и [15-миллиметровое стальное шариковое колесо](https://www.dfrobot.com/product-225.html). Этот комплект шасси также содержит много других деталей и креплений, но они нам не нужны. Нам нужна только рама шасси.

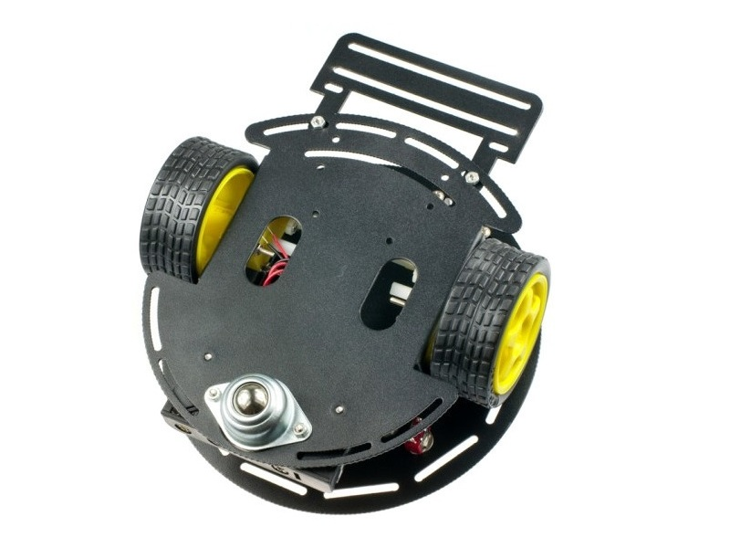
[picture p35: ARTICLE_RU/media/part_2/prod/part_2_prod_chassis_2.jpg]


Это не дорогое шасси, но и не самого лучшего качества:

- Данное шасси слабо документировано. Мы не нашли чертежи шасси в открытом доступе.
- Покрышки колес, которые идут в комплекте, пластиковые и бесполезные, потому что у них почти нет сцепления с землей. Мы сразу же заменили их резиновыми шинами от того же производителя - [Резиновое колесо для 4WD и 2WD (пара)](https://www.dfrobot.com/product-352.html).
- 1:120 Коробки передач моторов типа TT имеют пластиковые шестерни. Было бы лучше, если бы коробка передач была сделана из металла.
- Двигатели постоянного тока работают без обвязки и генерируют значительное количество электромагнитных наводок. На полной скорости эти двигатели существенно влияют на работу близлежащих аналоговых и цифровых электронных устройств.

Подводя итог, можно сказать, что это шасси не предел мечтаний, но оно доступно и популярно в хобби-робототехнике. Выбирая не дорогое шасси, будьте готовы приобрести ответственные детали и комплектующие или изготовить их самостоятельно.

### Энкодеры

Для колесной одометрии нам понадобятся датчики угла поворота или [энкодеры](https://en.wikipedia.org/wiki/Rotary_encoder). Часто готовые шасси уже имеют энкодеры, но эта платформа поставляется без них. По типу отдаваемых данных энкодеры могут быть [абсолютными](https://en.wikipedia.org/wiki/Rotary_encoder#Absolute_encoder) или [инкрементный](https://en.wikipedia.org/wiki/Incremental_encoder).

Абсолютный энкодер выдает сигнал, который однозначно соответствует углу поворота вала. Энкодеры этого типа не требуют привязки системы отсчета к какому-либо нулевому положению.

Инкрементный энкодер генерирует импульсы на выходе. Контроллер подсчитывает количество импульсов с помощью счетчика и определяет текущее положение вала. Сразу после включения контроллера положение вала неизвестно. Существует специальная нулевая отметка, через которую вал должен пройти после включения. Эта метка используется для привязки системы отсчета к нулевой позиции. Основным недостатком энкодеров такого типа является невозможность определить пропуск импульса, вызванный какой-либо причиной. Пропуски импульсов накапливают погрешность в угле поворота вала до тех пор, пока не будет пройдена нулевая отметка. Инкрементный кодер может быть без нулевой отметки. В этом случае отсчет импульсов, полученный в начале накопления, является началом системы отсчета.

По типу действия энкодеры могут быть оптическими, магнитными и механическими. Оптический энкодер использует свет, падающий на фотодиод через щели в металлическом или стеклянном диске, установленном на вращающемся валу. Механический энкодер также имеет вращающийся диск, но здесь угол считывают механические переключатели или контакты. Магнитные энкодеры имеют магнит, установленный на вращающемся валу. Эти энкодеры используют датчики Холла для считывания вращения вала с магнитом.

В основном в хобби-робототехнике используются оптические и магнитные инкрементные энкодеры или магнитные абсолютные энкодеры. Не имеет значения, какой тип энкодера использовать. При выборе энкодера основными параметрами являются количество каналов передачи данных, количество импульсов на оборот (PPR) и максимально допустимая скорость вращения вала.

Наиболее популярны квадратурные энкодеры с двумя каналами А и В. Редко у энкодеров хобби есть канал с нулевой отметкой - Z. Чем выше значение PPR, тем меньше угол поворота вала, который может зафиксировать датчик. Чем точнее энкодер, тем точнее одометрия робота, поэтому не пренебрегайте высококачественными энкодерами и не используйте энкодеры с низким значением PPR. Максимальная скорость вращения может быть любой, так как большинство энкодеров способно работать на очень высоких скоростях. Скорее всего, скорость вращения, которую вы будете измернять, будет в несколько раз меньше максимальной. Даже если вы планируете использовать высокоскоростные BLDC двигатели с высоким значением kv, то существуют энкодеры работающие с максимальными скоростями 28000 об/мин, 60000 об/мин или даже больше.

Если вы используете двигатель с коробкой передач, установите поворотный энкодер на вал двигателя, а не на вал колеса или коробки передач. Это важно. Эта настройка уменьшает минимальный читаемый угол поворота колеса и делает вашу одометрию более точной. Энкодеры могут устанавливаться и на оси передач и редукторов но обычно это делается в приводах скелетных роботов.

Мы обзавелись двумя такими двигателями с энкодерами - [Мотор-редуктор TT с энкодером (6V 160RPM 120:1 L Shape)](https://www.dfrobot.com/product-1458.html)

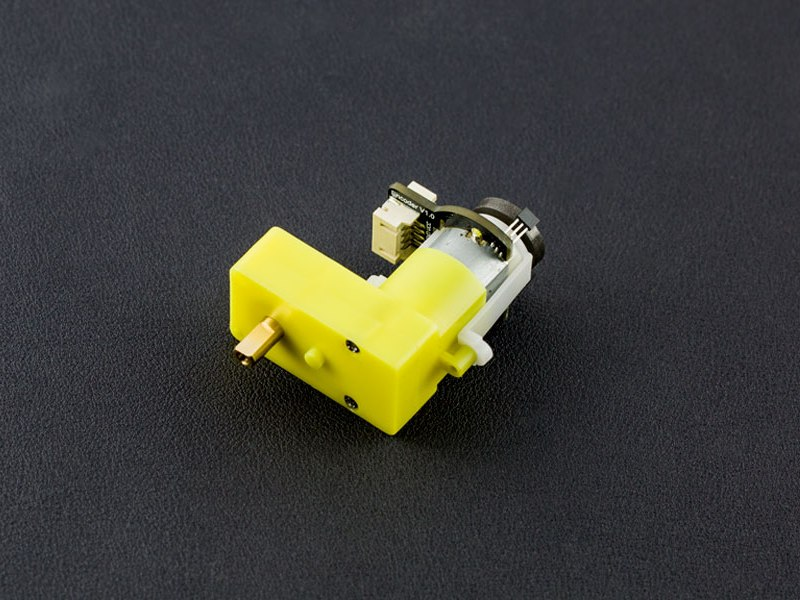
[picture p36: ARTICLE_RU/media/part_2/prod/part_2_prod_chassis_3.jpg]


Почему мы выбрали именно эти моторы?

- Во-первых, их конструкция специально разработана для нашего Turtle шасси, и нам не придется придумывать крепление.
- Во-вторых, производитель исправил существенные недостатки, заменил пластиковые шестерни металлическими и добавил схему двигателя обвязку.
- Эта сборка имеет квадратурный магнитный энкодер с разрешением 16 PPR. Энкодер установлен на валу двигателя. Передаточное отношение редуктора 120:1 дает полное разрешение в 1920 импульсов на оборот колеса с минимальным измеряемым шагом в 0°11'15". Для поставленной нам задачи такой точности более чем достаточно.

Заменив моторы и убрав все лишнее, мы получил вот такое шасси:

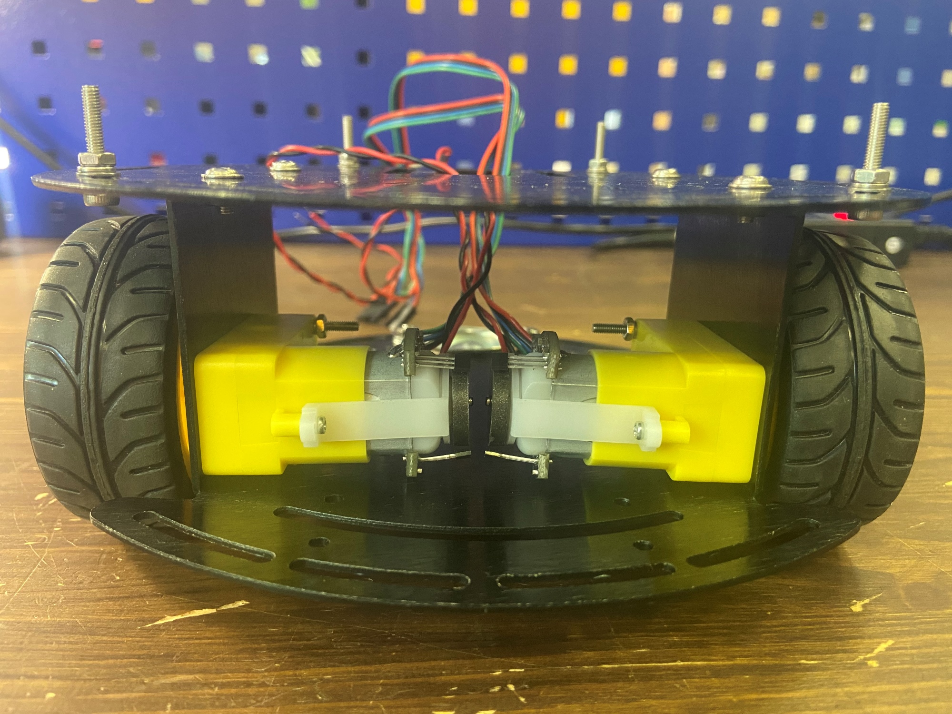
[picture p37: ARTICLE_RU/media/part_2/irl/part_2_irl_chassis_1.jpg]


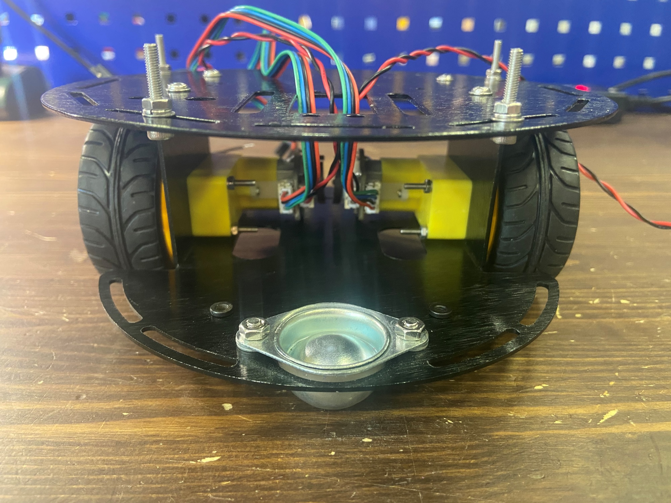
[picture p38: ARTICLE_RU/media/part_2/irl/part_2_irl_chassis_2.jpg]


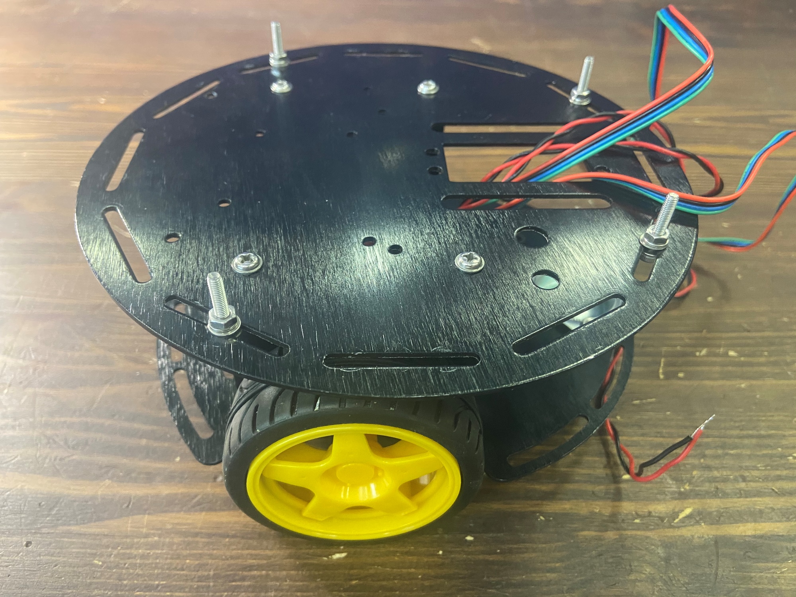
[picture p39: ARTICLE_RU/media/part_2/irl/part_2_irl_chassis_3.jpg]


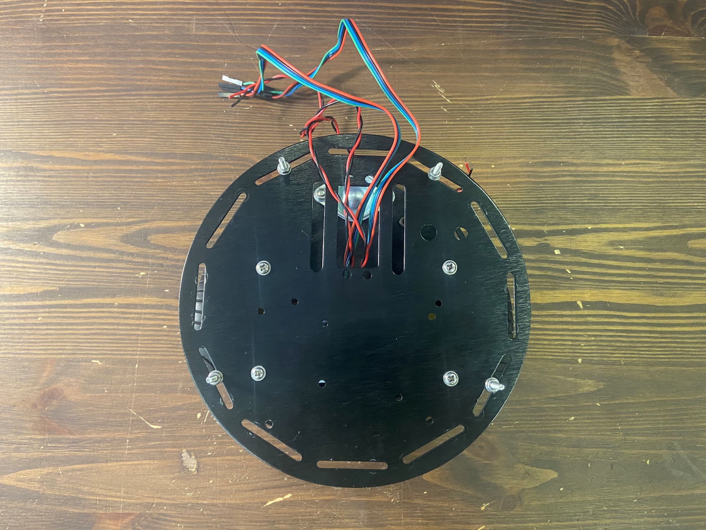
[picture p40: ARTICLE_RU/media/part_2/irl/part_2_irl_chassis_4.jpg]


## ROS

Мы разобрались с шасси. Давайте начнем разбираться в программном обеспечении. Для настоящих роботов привычные нам программы микроконтроллеров не подходят. Вместо этого мы используем ROS.

[ROS(Robot Operation System)](https://www.ros.org) - это [операционная система](https://en.wikipedia.org/wiki/Operating_system) для роботов. ROS обеспечивает весь необходимый функционал для распределенной работы всех узлов робота. На самом деле ROS-это библиотека, надстройка поверх компьютерной операционной системы. ROS предоставляет стандартные услуги операционной системы, такие как аппаратная абстракция, низкоуровневое управление устройствами, реализация часто используемых функций, передача сообщений между процессами и управление пакетами.

ROS имеет графовую архитектуру, где обработка данных происходит в узлах - нодах (`nodes`), которые могут принимать и передавать сообщения между собой. ROS состоит из двух частей. Первая, это ядро - `roscore`. Ядро отвечает за работу системы и взаимодействие всех пакетов. Вторая часть - это пользовательские пакеты (`packages`) или наборы этих пакетов, организованных в стек.

Пакетов очень и очень много. Поскольку ROS-это проект с открытым исходным кодом, благодаря сообществу уже написало большинство пакетов, реализующих стандартные функции роботов. Поэтому ROS так крут и популярен - из-за наличия готовых пакетов с открытым исходным кодом. Тем не менее, некоторые ноды нам придется написать самостоятельно, например низкоуровневые драйверы, но большая часть программного обеспечения уже сделана. Нам останется только собрать все вместе.

Сам ROS и большинство его пакетов очень хорошо документированы. Вы можете найти ответы практически на любые вопросы в [вики ROS](http://wiki.ros.org). Для ознакомления с разработкой под ROS настоятельно рекомендуем вам ознакомиться с ROS вики.

ROS содержит множество пакетов для создания виртуального робота и симулирования его поведения, например стек пакетов [`gazebo_ros_pkgs`](http://wiki.ros.org/gazebo_ros_pkgs). C помощью Gazebo вы можете даже [симулировать знаменитого робота Atlas](http://gazebosim.org/tutorials?tut=drcsim_control_sync&cat=) от Boston dynamics у себя на компьютере.

Изначально ROS предназначен для постройки сложных роботов, которые могут стоить тысячи долларов. Поэтому, прежде чем тратить финансы на какие - либо реальные дорогостоящие физические детали и узлы робота, ROS предлагает - сначала смоделировать робота в симулировать его в виртуальной среде и только потом реализовать его в реальном мире.

Мы сделаем все наоборот. Мы сделаем робота из дешевых деталей, которые у нас уже есть. Не будем использовать симуляцию, но настроим ROS для нашего конкретного робота.

Чтобы использовать программное обеспечение ROS эффективно и для мониторинга, лучше установить его на две разные машины. Первая машина с ROS - это ваш настольный компьютер под управлением ОС Linux. Вторая машина - это бортовой компьютер, установленный на роботе, также работающем под управлением Linux. Позже мы свяжем эти две машины, и ROS будет работать в сети.

Предположим, что у вас уже есть настольный компьютер. Теперь вам нужно рзобраться с бортовым.

## Бортовой компьютер

### Выбор железа

Итак, робот работает на ROS, ROS работает на Linux. Давайте выберем для робота бортовой компьютер работающий на OS Linux.

Большие мобильные роботы способные нести большую нагрузку имеют на борту большие и мощные компьютеры. Если не стоит вопрос в размере боротвого компьютера то чаше всего на робота устанавливают мощный бортовой ноутбук. Наш робот маленький. На нем нет места для кучи оборудования и нечем это оборудование питать. Поэтому мы и используем [одноплатный компьютер](https://en.wikipedia.org/wiki/Single-board_computer). Сегодня существует множество одноплатных компьютеров. Самые популярные это:

- [Raspberry Pi Zero, 3, 4](https://www.raspberrypi.org) - это самые популярные платы. Изначально Raspberry Pi предназначен для обучения программированию и Linux. Эти платы самые дешевые. Семейство Raspberry Pi имеет множество реплик и копий платы оригинала дополненного различными периферийными интерфейсами и устройствами для любой задачи - Orange Pi, Rock Pi, Banana Pi.
- [NVIDIA Jetson Nano Developer Kit](https://www.nvidia.com/ru-ru/autonomous-machines/embedded-systems/jetson-nano/) - это самая многофункциональная плата. Она может быть использована для настольного ПК, но изначально предназначена для разработки мобильного искусственного интеллекта и машинного обучения. Эта плата использует мощный графический процессор из множдества ядер NVIDIA для вычислений.
- [Coral Dev Board](https://coral.ai/products/dev-board/) - это лучшая плата машинного обучения с использованием фреймворка Tensorflow. Плата специально разработана для работы с нейронной сетью TensorFlow Lite для микроконтроллеров.
- [ODYSSEY X86J4105800](https://www.seeedstudio.com/ODYSSEY-X86J4105800-p-4445.html) - самый большой и мощный одноплатник. Он способная работать под полноценной Windows 10 и имеет все функции настольного ПК.
- [Rock Pi N10](https://wiki.radxa.com/RockpiN10) - лучшая плата для машинного обучения. Эта плата имеет вычислительную мощность до 3,0 Терафлопс.

Вы можете выбрать любой одноплатник для робота. Тщательно выясните особенности каждой конкретной платы и определите ту, которая подходит вам лучше всего.

Мы не планируюем заниматься машинным обучением или выполнять массивные вычисления, а это означает, что почти любой негабаритный одноплатник подходит для нашего робота.

Мы выбрали [Raspberry Pi 4 Model B на 4 ГБ](prod://raspberry-pi-4-model-b-4-gb). Плата Raspberry Pi 4 может сильно нагреваться, так что мы установили на нее [пару алюминиевых радиаторов](prod://heatsink-passive-raspberry-pi) для пассивного охлаждения.

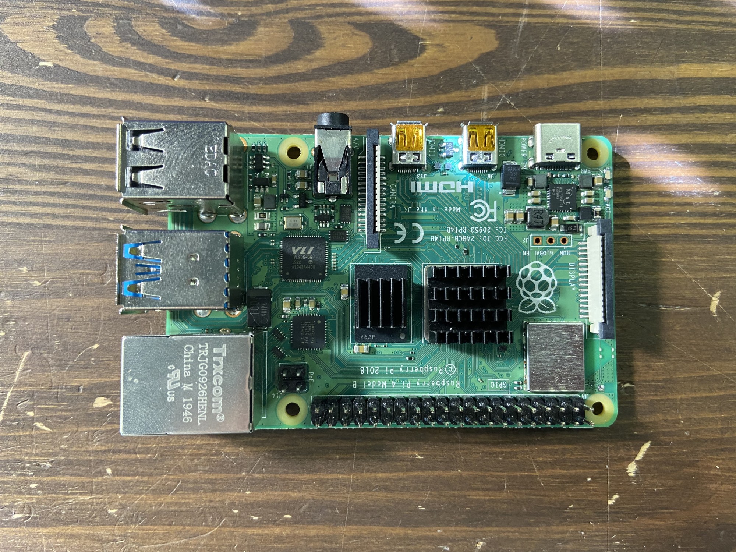
[picture p41: ARTICLE_RU/media/part_3/irl/part_3_irl_mcu_1.jpg]


Подключите любую клавиатуру и мышь к USB-портам платы. Подключите любой дисплей или монитор с помощью кабеля micro-HDMI. 

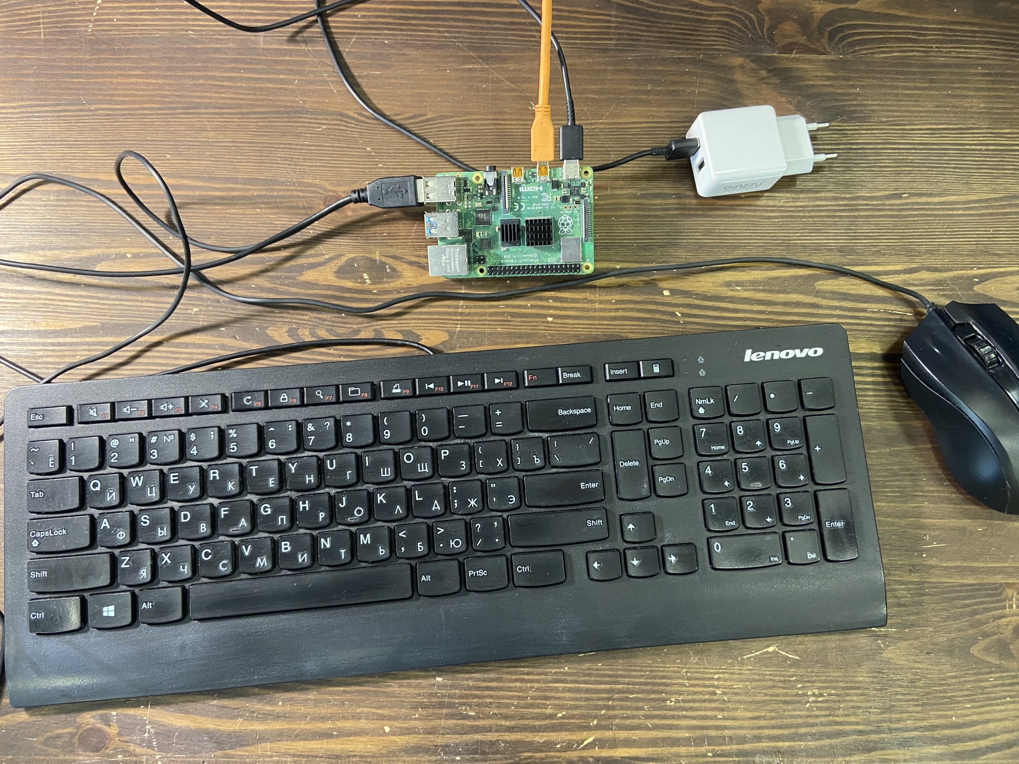
[picture p42: ARTICLE_RU/media/part_3/irl/part_3_irl_mcu_2.jpg]


Все это нам нужно для установки программного обеспечения и отладки программ в первый раз. Позже мы не будем использовать мышь, клавиатуру или дисплей, так как будем работать с Raspberry Pi по сети с помощью SSH.

Производитель одноплатника рекомендует использовать источник питания 3 А и более. Когда мы установим Raspberry Pi на робота, мы обеспечим плату достаточным напряжением и током, но в первый раз мы можем запитать плату от любого источника питания USB через кабель USB Type-C, например от [импульсного блока питания Ginzzu GA-3311UW](prod://usb-power-plug-3a)

***Важно*** Помните! Плату Raspberry Pi 4 с установленной в нее картой памяти не следует выключать просто отключив ее от питания. Выключайте плату правильно, средствами операционной системы.

### Выбор и установка дистрибутива Linux

Прежде чем выбрать ОС для установки, вам нужно выбрать, какую версию ROS использовать. ROS [выпускает дистрибутивы](http://wiki.ros.org/Distributions) для различных операционных систем и архитектур - Ubuntu, Debian, Windows, других ОС Linux. Глобальные обновления ROS основаны на глобальных обновлениях ОС Ubuntu. Вскоре после выходна новой версии Ubuntu появляется и новая версия ROS. Предыдущие версии ROS продолжают поддерживаться до тех пор, пока поддерживается дистрибутивы Ubuntu, для которого они были созданы ([EOL](https://en.wikipedia.org/wiki/End-of-life_(продукт))). На момент написания этого руководства нам доступны два поддерживаемых дистрибутива ROS:

- [ROS Melodic Morenia](http://wiki.ros.org/melodic) нацеленная на [Ubuntu 18.04 (Bionic)](https://releases.ubuntu.com/bionic/). Поддерживает Ubuntu 17.10 (Artful). Дата релиза - 23 мая 2018. Дата конца поддержки - май 2023 (Bionic).
- [ROS Noetic Ninjemys](http://wiki.ros.org/noetic) нацеленная на [Ubuntu 20.04 (Focal)](https://releases.ubuntu.com/focal/). Дата релиза - 23 мая 2020. Дата конца поддержки - май 2025 (Focal).

Официальная документация [рекомендует](https://www.ros.org/install/) установку последней версии ROS - Noetic для последней версии Ubuntu ОС - Focal. ROS живет благодаря сообществу. Если ядро обновляется всегда вовремя то обноваление и поддержка различных пакетов может запаздывать. Обратите внимание, что некоторые интересные пакеты все еще не обновлены для новой версии Noetic, и вам, возможно, придется собирать их вручную.

Перейдем в раздел установки ROS Noetic и взглянем, какие OS и какие [архитектуры](https://en.wikipedia.org/wiki/Comparison_of_instruction_set_architectures) мы можем использовать:

- Ubuntu Focal на `amd64`, `armhf`, `arm64`.
- Debian Buster на `amd64`, `arm64`.
- Windows 10 на `amd64`.
- Не гарантировано, любой дистрибутив Linux на `amd64`, `i686`, `arm`, `armv6h`, `armv7h`, `aarch64`.

Raspberry Pi 4 B имеет набор инструкций ARMv8-A и поддерживает 32-разрядные и 64-разрядные вычисления. Обычно пользователи устанавливают 32-разрядную ОС на Raspberry. Однако у нашей малины 4 ГБ оперативной памяти, (и, кстати, может быть и 8 ГБ). С таким объемом оперативной памяти вы можете попробовать 64-разрядную ОС. С определенными задачами 64-разрядная версия ОС будет справляться быстрее.

Для ROS Noetic мы устанавливаем на одноплатник Ubuntu Server 20.04.2 arm64. Для хранения ОС вам понадобится флэш-накопитель microSD. Чем больше емкость карты, и ее класс тем лучше. Мы использовали [microSD карточку на 16 ГБ](prod://microsd-16gb).

Скачайте образ ОС. Перейдите на официальный сайт [Ubuntu](https://ubuntu.com). Затем перейдите в раздел **Downloads → Ubuntu for IOT → [Raspberry Pi 2, 3 or 4](https://ubuntu.com/download/raspberry-pi)**. Загрузите образ 64-разрядной ОС Ubuntu Server для `arm`.

Установите программу для создания загрузочных флэш-дисков. Мы используем официальную программу от Raspberry - Raspberry Pi Imager. Перейдите на официальный сайт [Raspberry website](http://www.raspberrypi.org). Затем перейдите в раздел **Downloads → Raspberry Pi Imager**. Загрузите и установите [Raspberry Pi Imager](https://www.raspberrypi.org/software/) для вашей ОС.

Вставьте SD-карту в компьютер и отформатируйте ее.

Запустите Raspberry Pi Imager. Затем войдите в меню **Operating system** menu and select **Use custom**.

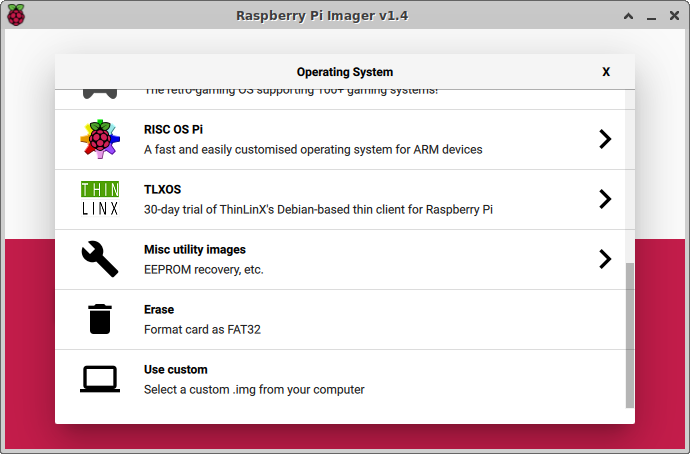
[picture p43: ARTICLE_RU/media/part_4/part_4_linux_install_1.png]


Укажите путь к скаченному образу Ubuntu, затем путь к вашей флеш карте и нажмите кнопку **Write**.

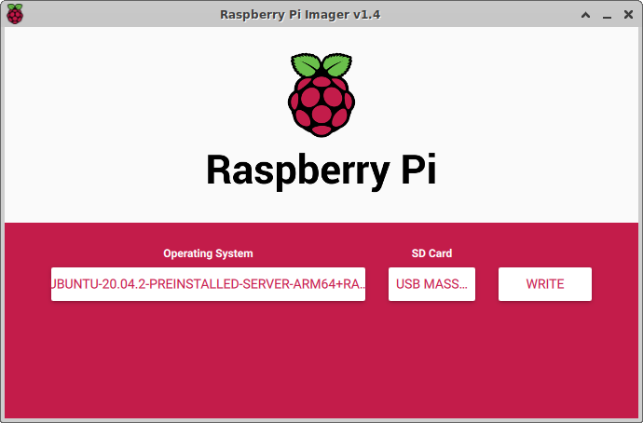
[picture p44: ARTICLE_RU/media/part_4/part_4_linux_install_2.png]


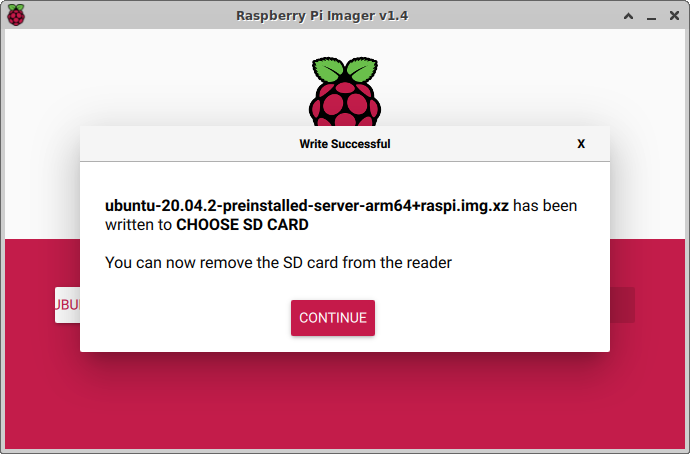
[picture p45: ARTICLE_RU/media/part_4/part_4_linux_install_3.png]


Когда запись ОС завершена вставьте microSD флешку в Raspberry Pi и включите плату подав на нее питание.

### Первый запуск

Убедимся, что Linux работает. При первой загрузке Ubuntu логин - `ubuntu`, пароль - `ubuntu`. При первом входе, ОС просит нас изменить стандартный пароль. Установите новый. Обратите внимание: пароль не может быть палиндромом; это одна из стандартных настроек ОС Ubuntu Server.

```bash
Ubuntu 20.04.2 LTS ubnutu tty1

ubuntu login: ubuntu
Password:
You are requested to change your password immediately (root enforced)
Changing password for ubuntu.
(current) UNIX password:
Enter new UNIX password:
Retype new UNIX password:
Welcome to Ubuntu 20.04.2 LTS (GNU/Linux 5.4.0-1015-raspi aarch64)

 * Documentation:  https://help.ubuntu.com
 * Management:     https://landscape.canonical.com
 * Support:        https://ubuntu.com/advantage

  System information as of Wed Apr 1 17:25:35 UTC 2020

  System load:  0.27                Swap usage:  0%          Users logged in: 0
  Usage of /:   12.8% of 14.03GB    Temperature: 46.7 C 
  Memory usage: 6%                  Processes:   134

0 packages can be updated.
0 updates are security updates.

The programs included with the Ubuntu system are free software;
the exact distribution terms for each program are described in the
individual files in /usr/share/doc/*/copyright.

Ubuntu comes with ABSOLUTELY NO WARRANTY, to the extent permitted by
applicable law.

To run a command as administrator (user "root"), use "sudo <command>".
See "man sudo_root" for details.

ubuntu@ubuntu:~$
```

Пароль для `root` не установлен в Ubuntu по умолчанию, и вход в систему пользователя `root` отключен. Включим учетную запись `root` и установим для нее пароль. Затем переключимся на `root`: 

```bash
sudo passwd root
su root
```

При желании вы можете переименовать стандартное имя текущего хоста в более привлекательное. Мы назовем бортовой компютер `robot`.

Отредактируем файл `/etc/hostname` и заменим `ubuntu` на `robot`:

```bash
nano /etc/hostname
```

Затем перезагрузимся и снова войдите в систему под `root`:

```bash
reboot now
```

### Настройка Wi-Fi и графической оболочки

Теперь нам нужно подключиться к Интернету через Wi-fi адаптер на Raspberry. Предполагается, что у вас уже есть точка доступа Wi-Fi.

Первый шаг - определить имя вашего беспроводного сетевого интерфейса. Имя интерфейса беспроводной сети может быть разное но обычно это `wlan0`:

```bash
ls /sys/class/net/
```

Затем перейдем в каталог `/etc/netplan` и найдем соответствующие файлы конфигурации Netplan. Файл конфигурации имеет имя типа `50-cloud-init.yaml`:

```bash
ls /etc/netplan/
```

Отредактируем файл конфигурации Netplan:

```bash
nano /etc/netplan/50-cloud-init.yaml
```

Весь файл конфигурации должен выглядеть примерно так, как показано ниже. Убедитесь, что все блоки кода выровнены. Для выравнивания используйте пробелы вместо табуляции. Замените строки `SSID` и `PASSWORD` на имя и пароль вашей сети Wi-Fi.

```bash
# This file is generated from information provided by the datasource.  Changes
# to it will not persist across an instance reboot.  To disable cloud-init's
# network configuration capabilities, write a file
# /etc/cloud/cloud.cfg.d/99-disable-network-config.cfg with the following:
# network: {config: disabled}
network:
    ethernets:
        eth0:
            dhcp4: true
            optional: true
    version: 2
    wifis:
        wlan0:
            optional: true
            access-points:
                "SSID":
                    password: "PASSWORD"
            dhcp4: true
```

Запустим службу, перезагрузимся и войдем в систему:

```bash
systemctl start wpa_supplicant
reboot now
```

Применим изменения Netplan и подключимся к беспроводной сети:

```bash
sudo netplan generate
sudo netplan apply
```

Еще раз перезагрузимся и снова войдем в систему. Теперь наша Raspberry в сети Wi-Fi, и мы можем пропинговать наш сетевой шлюз:

```bash
ip addr show
ping 192.168.88.1
```

Следующим шагом будет установка графического интерфейса для удобства работы с OS. Обновим список пакетов из репозитория, обновим пакеты их и установим любую понравившуюся графическую оболочку. Например, мы выбрали [XFce](https://en.wikipedia.org/wiki/Xfce):

```bash
sudo apt-get update && apt-get upgrade
sudo apt-get install xubuntu-desktop
```

Установка графической оболочки может занять некоторое время. После установки перезагрузимся и войдите в систему под `ubuntu`.

## Установка и настройка ROS

Мы установим ROS на две машины, на Raspberry Pi и на настольный компьютер. Затем мы обьединим ROS на этих компьютерах в единую сеть.

Зачем нужно два компьютера с ROS? Разработка программного обеспечения для робота тесно связана с ресурсоемкой визуализацией. Работа с графикой, трехмерными обьектами и визуализация на Raspberry существенно тормозит разработку ПО.

Кроме этого некоторые поставленные нами задачи, например навигация в помещении, очень сложные и требуют большие вычислительные мощности. Выполнение подобных задач на  Raspberry может быть очень медленно а то и вовсе невыполнимо.

Если бы вместо Raspberry Pi на нашем роботе стоял мощный ноутбук, то мы смогли бы вести весь проект от начала и до конца на одной ROS машине. В нашем случае, ROS на роботе будет оперировать простыми вычислениями и поддерживать работу драйверов низкого уровня а настольный компьютер с ROS будет осуществлять трудоемкие вычисления навигации и визуализацию.

### Установка ROS на Raspberry

Установим ROS Noetic на Raspberry так как рекомендуется в [installation guide for ROS Noetic](http://wiki.ros.org/noetic/Installation/Ubuntu). Откроем новый терминал и продолжим под юзером `ubuntu`.

Настроим Raspberry на прием программного обеспечения из репозитория [packages.ros.org](http://packages.ros.org/):

```bash
sudo sh -c 'echo "deb http://packages.ros.org/ros/ubuntu $(lsb_release -sc) main" > /etc/apt/sources.list.d/ros-latest.list'
```

Настраиваем ключи:

```bash
sudo apt-key adv --keyserver 'hkp://keyserver.ubuntu.com:80' --recv-key C1CF6E31E6BADE8868B172B4F42ED6FBAB17C654
```

Обновим список пакетов:

```bash
sudo apt-get update
```

Установим полную версию ROS используя стек пакетов `ros-noetic-desktop-full`:

```bash
sudo apt install ros-noetic-desktop-full
```

Настраиваем переменные окружения ROS и автоматически добавляем их в bash сеанс при каждом новом запуске Ubuntu:

```bash
echo "source /opt/ros/noetic/setup.bash" >> ~/.bashrc
source ~/.bashrc
```

Установим пакет `rosdep`. `rosdep` позволяет вам легко устанавливать системные зависимости для исходного кода, который вы хотите скомпилировать, и необходим для запуска некоторых основных компонентов в ROS:

```bash
sudo apt-get install python3-rosdep python3-rosinstall python3-rosinstall-generator python3-wsstool build-essential
```

Инициализируем `rosdep`:

```bash
sudo rosdep init
rosdep update
```

Убедимся, что ROS на Raspberry работает. Откроем новый терминал и запустим ядро ROS:

```bash
roscore
```

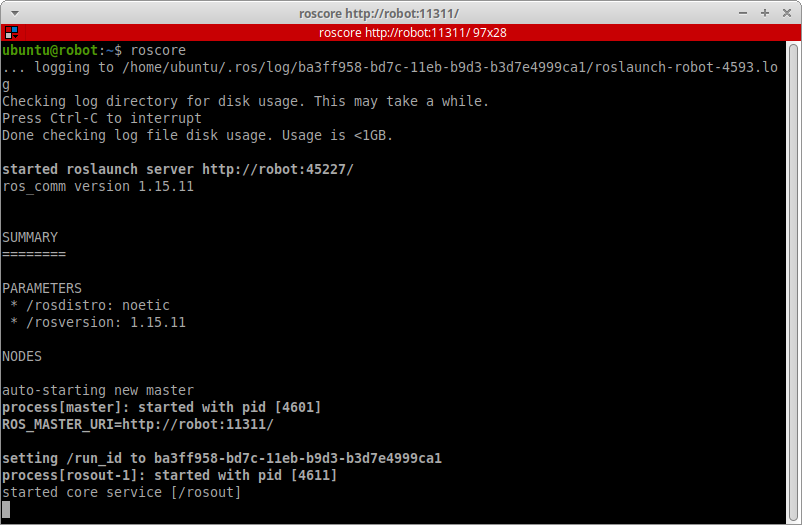
[picture p46: ARTICLE_RU/media/part_5/rpi_side/part_5_rpi_side_screen_1.png]


### Установка ROS на настольный компьютер

Установка ROS на настольный компьютер ничем не отличается от установки ROS на Raspberry. Установка версии ROS по-прежнему зависит от версии операционной системы Linux, установленной у вас на настольном компьютере.

Наш настольный компьютер работает под Ubuntu 20.04.1 LTS Focal поэтому на него мы так же устанавливаем ROS Noetic.

### Создание рабочего пространства ROS

Прежде чем создавать рабочее пространство, мы настоятельно рекомендуюем вам прочитать [уроки ROS для начинающих](http://wiki.ros.org/ROS/Tutorials). Это отличная документация. В первый раз документация может показаться сложной и непонятной. Со временем, когда вы привыкнете к ROS, официальная документация ответит вам на все возникающие вопросы. Ознакомьтесь с документаций и, для начала, попытайтесь понять некоторые основные принципы ROS:

- Что такое переменные среды ROS?
- Как выглядит файловая система ROS и какова структура пакета ROS?
- Что такое ноды или узлы (`nodes`), топики или темы (`topics`), сервисы (`sevices`), сообщения (`messages`), издатели (`publishers`), подписчики (`subscribers`)?
- Каким образом все описанные выше обьекты взаимодействуют друг с другом?

Создадим новое рабочее пространство ROS. Рабочее пространство ROS - это место, где вы храните все программное обеспечение робота или проекта: пакеты с нодами, исполняемые файлы, файлы конфигурации, файлы описаний и прочее. На самом деле рабочее пространство - это просто папка в файловой системе Linux.

Мы назвали наше рабочее пространство `ros`. Пакеты с исходным кодом должны находиться в подкаталоге `src`.

```bash
mkdir -p ~/ros/src
cd ~/ros/
```

Рабочее пространство в настоящее время пусто, давайте соберем его с помощью [catkin](http://wiki.ros.org/catkin). Это удобный инструмент для компиляции исходного кода C++ или Python, создания исполняемых файлов, связывания пакетов, и этот инструмент регулярно используется при работе с ROS.

```bash
catkin_make
```

Взгляните в каталог рабочего пространства. Теперь там появились папки `build` и `devel`. В папке `build` хранятся исполняемые файлы, бинарные файлы и файлы сборки. Папка `devel` содержит множество сгенерированных файлов setup.*sh, которые используются для наложения рабочей области ROS поверх среды Linux.

### Процесс разработки

Поскольку мы используем ROS на двух компьютерах то и рабочее пространство нужно создать на обоих машинах. И там и там нужно держать одинаковые и актуальные файлы вашего проекта. Да, звучит не очень удобно, но такова цена за использование двух машин вместо одной.

Добиться актуализации данных и синхронизировать рабочие пространсва на декстопном компьютере и Raspberry можно используя `git` или различные утилиты типа `rsync`.

Далее, если мы производим какие нибудь изменения в рабочем пространсве `ros` то подразумевается что эти изменения выполнены как на Raspberry так и на настольном компьютере. Наш проект будет храниться в одинаковом виде в двух местах. Но, на разных машинах, мы будем запускать разные части нашего проекта.

### Настойка локальной сети и сети ROS

Настроим общение по сети между настольным копьютером и Raspberry а так же обьединим ROS на обоих в компьютерах в сеть. В [вики ROS](http://wiki.ros.org) есть подробная статья о настройки [ROS на нескольких машинах](http://wiki.ros.org/ROS/Tutorials/MultipleMachines).

Узнаем IP адреса Raspberry и IP адрес дектопного компьютера в локальной сети. У нас настольный компютер имеет адрес в сети `192.168.88.24` а Raspberry `192.168.88.82`. IP адрес можно узнать утилитами `ip addr` или `ifconfig`

Настольный компьютер имеет имя `robot-user` а Raspberry имя `robot`. Имена можно посмотреть в файле `/etc/hostname`.

Отредактируем `etc/hosts` на обоих машинах:

```bash
sudo nano /etc/hosts
```

Добавим в этот файл несколько строк:

```bash
192.168.88.24 robot-user
192.168.88.82 robot
```

В сети ROS может быть запущено только одно ядро `roscore`. Именно машина с запущенным ядром отвечает за работу всей системы. Такая машина в сети ROS будет являться **master** а остальные машины **slave**. Мы в качестве **master** выбираем настольный компьютер `robot-user`. Для всех компьютеров с ROS в сети нужно указать какая именно машина является **master**.

Добавим новые сетевые переменные окружения ROS в автозапуск. Сперва на настольном компьютере:

```bash
echo "ROS_MASTER_URI=http://robot-user:11311" >> ~/.bashrc
echo "ROS_HOSTNAME=robot-user" >> ~/.bashrc
echo "ROS_IP=192.168.88.24" >> ~/.bashrc
```

А затем так же на raspberry:

```bash
echo "ROS_MASTER_URI=http://robot-user:11311" >> ~/.bashrc
echo "ROS_HOSTNAME=robot" >> ~/.bashrc
echo "ROS_IP=192.168.88.82" >> ~/.bashrc
```

Перезагрузим обе машины и протестируем сеть ROS.

Запустим ядро на настольном компьютере:

```bash
roscore
```

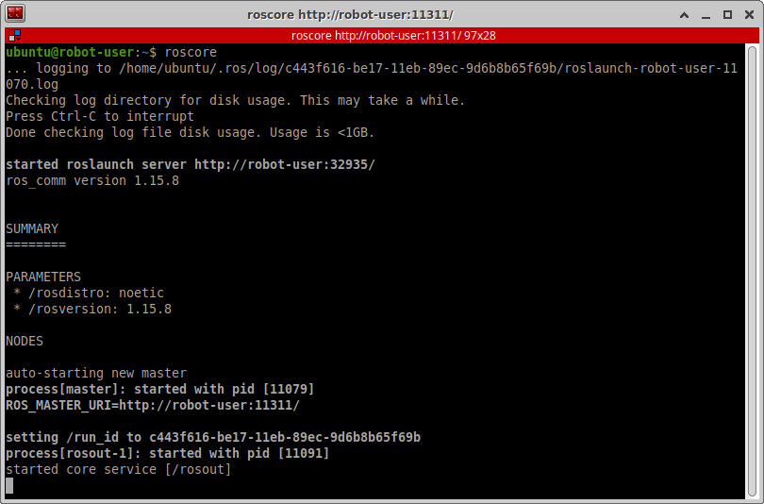
[picture p47: ARTICLE_RU/media/part_5/desk_side/part_5_desk_side_screen_1.png]


Как мы видим из лога ядро ROS запустилось на машине которая имеет в сети имя `robot-user`. А значит мы уже можем увидеть ядро в сети. На Raspberry проверим появились ли какие либо топики ROS:

```bash
rostopic list
```

У нас появились два системных топика ROS. Это значит что ROS на Raspberry видит наш мастер.



## Описание робота (Robot Description)

Пришло время дать нашему роботу имя. Мы решили назвать нашего робота - `abot`, акроним от Amberka Bot.

Имя робота очень важно так как имя является своего рода пространством имен (`namespace`) при работе с программным обеспечением.

Человек, работающий с роботом, может физически взаимодействовать с ним. В любой момент вы можете потрогать робота, взглянуть на части из которых он состоит, взвесить его или снять размеры с его деталей. То есть у вас есть к нему доступ.

Программное обеспечение для робота также должно иметь полный доступ к роботу в любой момент времени. Для этого программе необходимо предоставить полное описание реального робота.

### Формат URDF

Для описания роботов существют различные форматы. ROS использует формат [URDF (Unified Robot Description Format)](http://wiki.ros.org/urdf). Этот формат является специализацией формата [XML](https://en.wikipedia.org/wiki/XML).

С помощью URDF можно описать каждую часть реального робота. Чем лучше описание робота, тем больше программных функций можно использовать, например, для физического моделирования. Детали робота - сегменты (links), сочленения (joints), датчики (sensors) организованы в виде дерева. Описание URDF может различается в зависимости от реализации, но есть несколько основных элементов:

- `<link>` - описывает кинематические и динамические свойства жесткой инерционной детали робота (абслолютно твердого тела). Элемент также может включать визуальные составляющию и свойства коллизий (collisions).
- `<visual>` - описывает визуальные свойства `<link>`. Этот элемент определяет геометрическую форму объекта детали робота (`куб, цилиндр, сфера) или 3D-модель визуализации.
- `<collision>` - описывает упрощенную геометрию части робота. Элемент используется для задания хитбоксов и областей, используемых в физических расчетах во время моделирования.
- `<inertial>` - описывает инерционные свойства части робота. Элемент определяет массу детали робота, центр масс и [тензор инерции](https://ru.wikipedia.org/wiki/Тензор_инерции) детали в виде матрицы 3х3.
- `<joint>` описывает шарнир, сочленение, соединение двух жестких частей (`<link>`). Этот элемент определяет кинематику и динамику соединения, пределы безопасного движения, физическое демпфирование и параметры трения.
- `<transmission>` описывает взаимосвязь между приводом и `<joint>`.

Описание робота с множеством частей и соединений может занимать тысячи строк и быть неудобным для чтения. Решением является язык макросов [xacro](http://wiki.ros.org/xacro). С помощью `xacro` вы можете создавать более короткие и удобочитаемые XML-файлы, используя макросы.

Для описание нашего abot'a мы использем `urdf` и `xacro`. Вы можете просмотреть примеры описаний роботов в [URDF уроках](http://wiki.ros.org/urdf/Tutorials).

Вы можете написать описание вашего робота в формате URDF вручную. Создайте новый пустой файл и описывайте элемент за элементом. Однако, это трудоемкий процесс, требующий внимания, потому что можно наделать много ошибок. Процесс создания файла URDF можно автоматизировать с помощью специального программного обеспечения, которое экспортирует 3D-модель робота в URDF. А для этого вам понадобится 3D модель робота в [САПР (Системе автоматизированного проектирования)](https://ru.wikipedia.org/wiki/Система_автоматизированного_проектирования).

### 3D модель робота в САПР

В теории, 3D-модель робота можно создать в любом 3D редакторе, но лучше использовать твердотельное моделирование.

Мы используюем [SolidWorks 2017](https://www.solidworks.com) на настольном компьютере под управлением ОС Windows. Мы выбрали SolidWorks, потому что в нем есть отличный плагин для экспорта проекта в формат URDF.

Старайтесь не описывать сразу всего робота. Добавляйте различные части к модели постепенно. Это поможет вам освоить процесс описания. Мы начал с деталирования шасси робота.

Все наше шасси пришлось детализировать вручную. Вот почему так важны чертежи от производителя. Вот что у нас получилось:

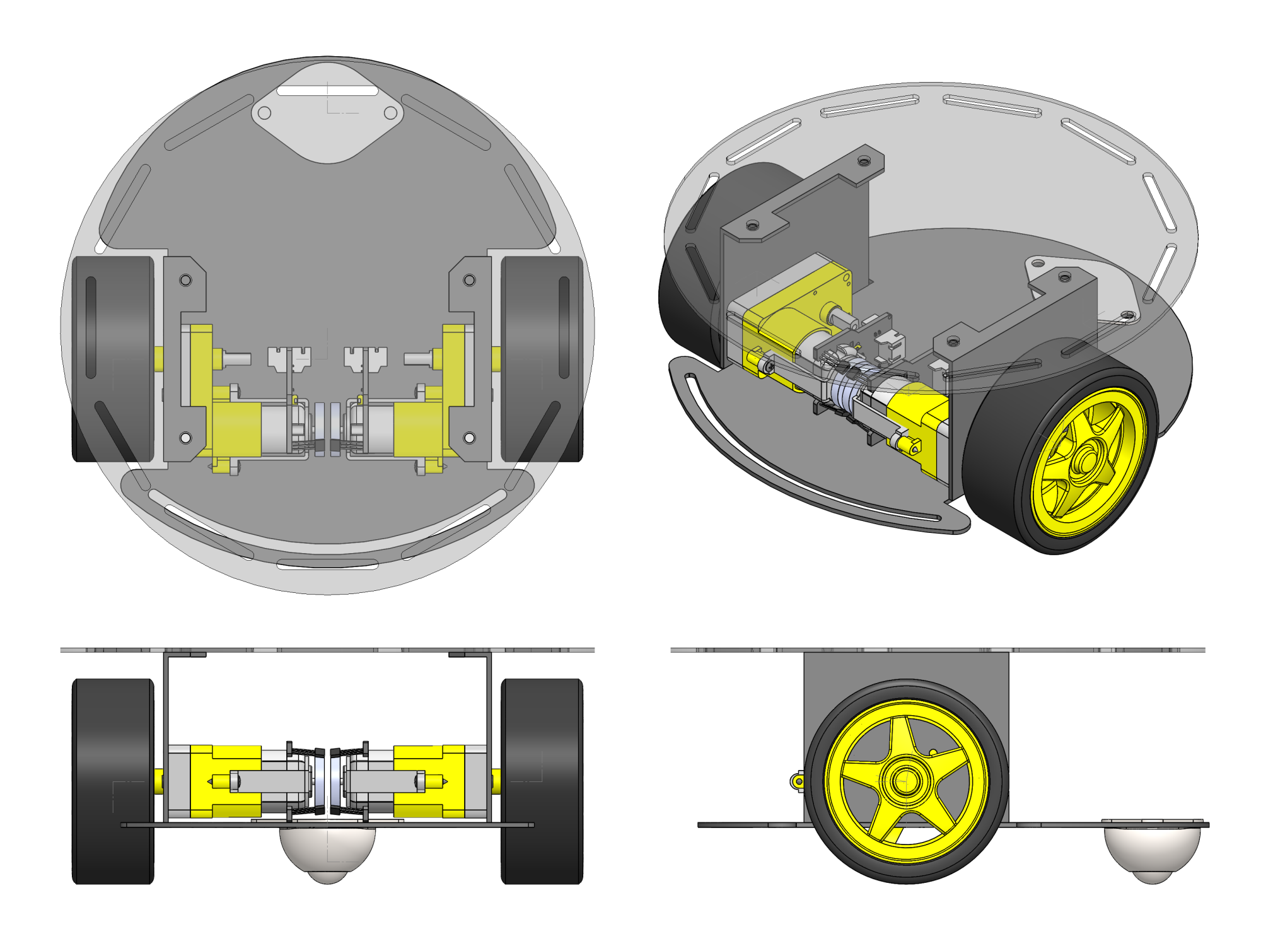
[picture p48: ARTICLE_RU/media/part_6/cad/part_6_cad_drawing_1.png]
part_6_cad_drawing_1


На данный момент наша модель состоит из четырех сегментов:

- `abot_base`
- `abot_left_wheel`
- `abot_right_wheel`
- `abot_caster_wheel`

И трех сочленений (joints):

- `left_wheel_to_base`
- `right_wheel_to_base`
- `caster_wheel_to_base`

Для правильного экспорта нужно выполнить несколько действий.

Добавьте системы координат. Определите системы координат для всех сегментов. Лучше всего указывать системы координат от исходных точек деталей модели. Лучше использовать центр симметрии детали, точку на оси симметрии или центр масс в качестве начала системы координат.

ROS и URDF требуют правосторонних систем координат ([Правило правой руки](https://ru.wikipedia.org/wiki/Правило_буравчика)). Определите, где находится передняя, задняя и верхняя части вашего робота. Ось X должна указывать вперед, ось Y - влево, а ось Z - вверх. По умолчанию стандартные виды Solidworks и система координат повернуты на 90 градусов вокруг осей X и Z. Для удобства правильного размещения осей в Solidworks можно разместить направляющие линии.

Каждый сегмент модели имеет свою систему координат:

- `CS_BASE`
- `CS_RIGHT_WHEEL`
- `CS_LEFT_WHEEL`
- `CS_CASTER_WHEEL`

Система координат `CS_BASE` условно расположена в центре нашего робота. `CS_LEFT_WHEEL` и `CS_RIGHT_WHEEL` находятся в центрах колес. `CS_CASTER_WHEEL` находится в центре сферы всенаправленного опорного колеса.

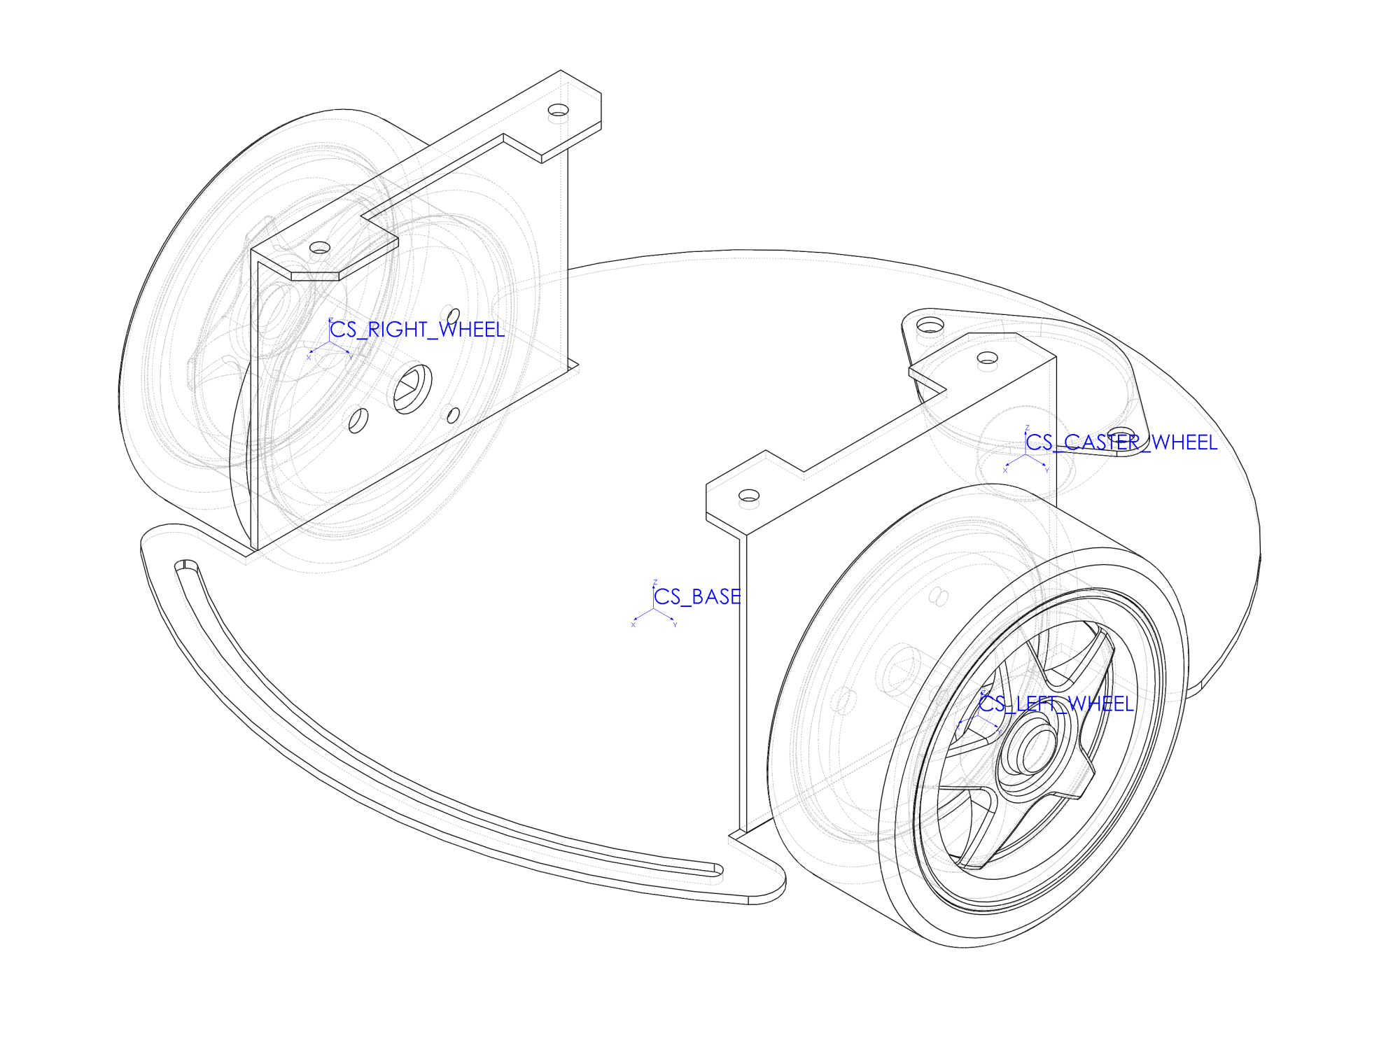
[picture p49: ARTICLE_RU/media/part_6/cad/part_6_cad_drawing_2.png]
part_6_cad_drawing_2


Добавьте оси вращения для подвижных соединений, сочленений (joints). У нас есть три подвижных соединения - два вращающихся на осях колеса и одно всенаправленное колесо которое вращается во все стороны. Всенаправленное колесо не нуждается в оси. Для колес мы поместили оси `AXIS_LEFT_WHEEL` и `AXIS_RIGHT_WHEEL`.

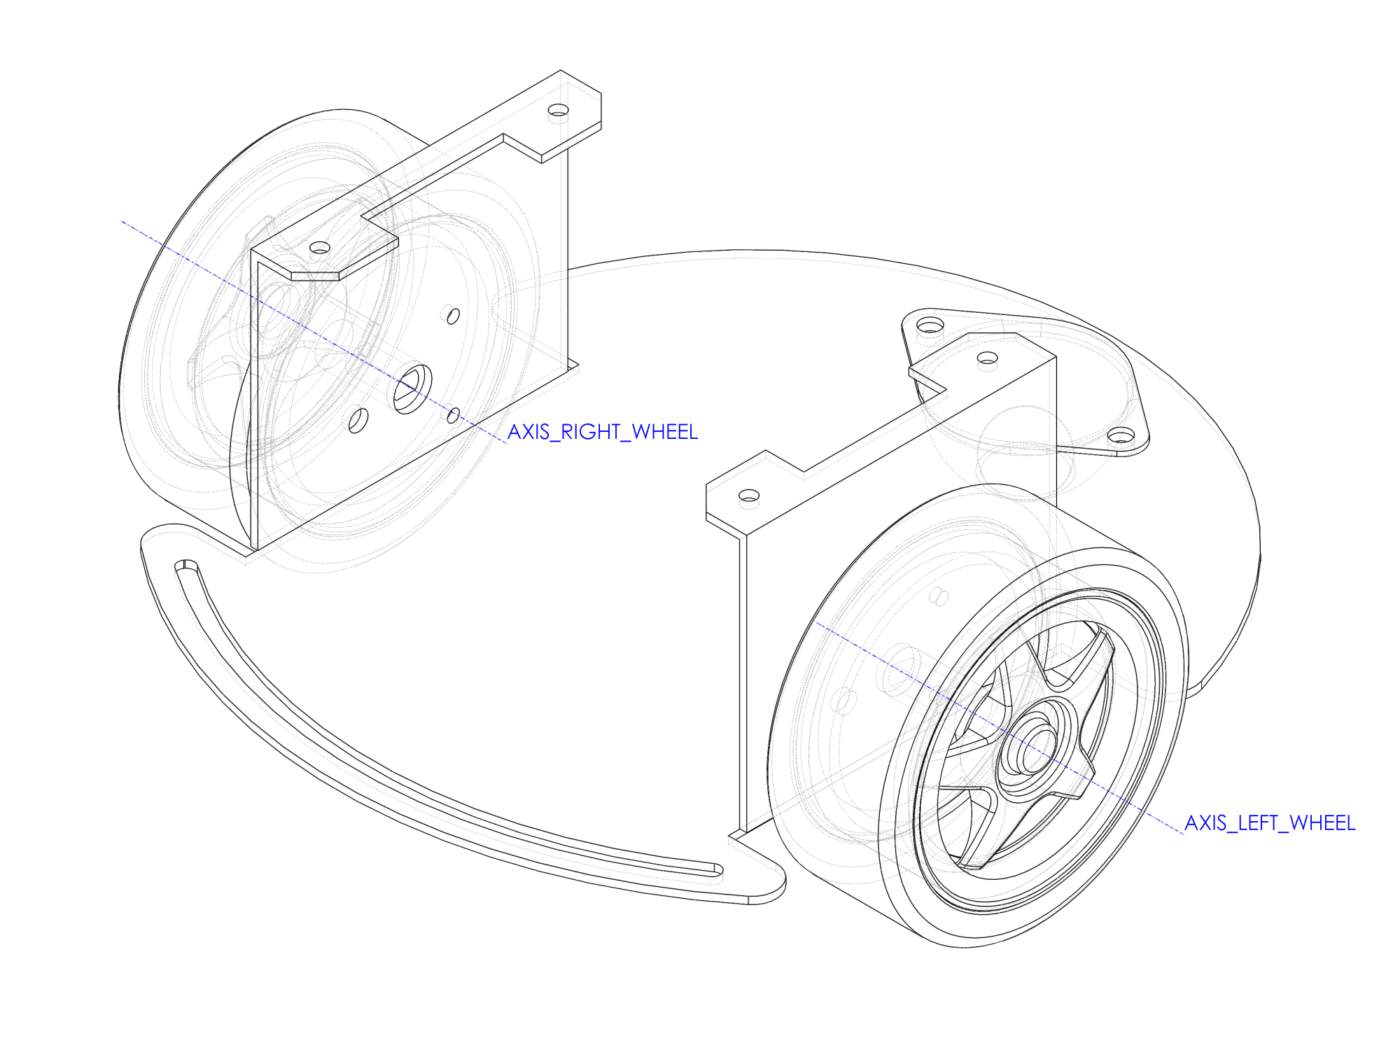
[picture p50: ARTICLE_RU/media/part_6/cad/part_6_cad_drawing_3.png]
part_6_cad_drawing_3


Если вы планируете использовать описание вашего робота в симуляциях, вам необходимо так же задать реальные материалы для всех деталей модели. Вы можете подобрать материалы приблизительно, из стандартной библиотеки материалов SolidWorks. Экспортер использует материалы деталей для моделирования и расчета инерционных параметров сегментов - массы, координаты центра масс а так же тензора инерции.

### Экспорт в URDF

Чтобы экспортировать модель, мы установили специальный плагин [`solidworks_urdf_exporter`](https://github.com/ros/solidworks_urdf_exporter). Последовательность установки хорошо описана в [документации на плагин](http://wiki.ros.org/sw_urdf_exporter).

После установки включите этот плагин в SolidWorks. Для этого перейдите в меню **Tools → Add-Ins** и установите флажок рядом с плагином `SW2URDF`. Чтобы начать экспорт, перейдите в раздел **Tools - Export as UPDF** или в **Files - Export as UPDF**. Откроется меню экспорта. В этом меню необходимо указать все сегменты, используемые в модели.

Сначала мы указываем сегмент `abot_base`. Это базовый сегмент и родительский сегмент. В качестве базового сегмента для робота лучше выбрать что-то массивное, например каркас корпуса робота.

Затем мы определем три дочерних сегмента для `abot_base` и систему координат `CS_BASE`. Для задания геометрии этого сегмента мы выбираем все части 3D-модели, кроме боковых колес и всенаправленного колеса. При экспорте выбранные нами детали преобразуются в mesh-модели формата STL необходимые для визуализации.

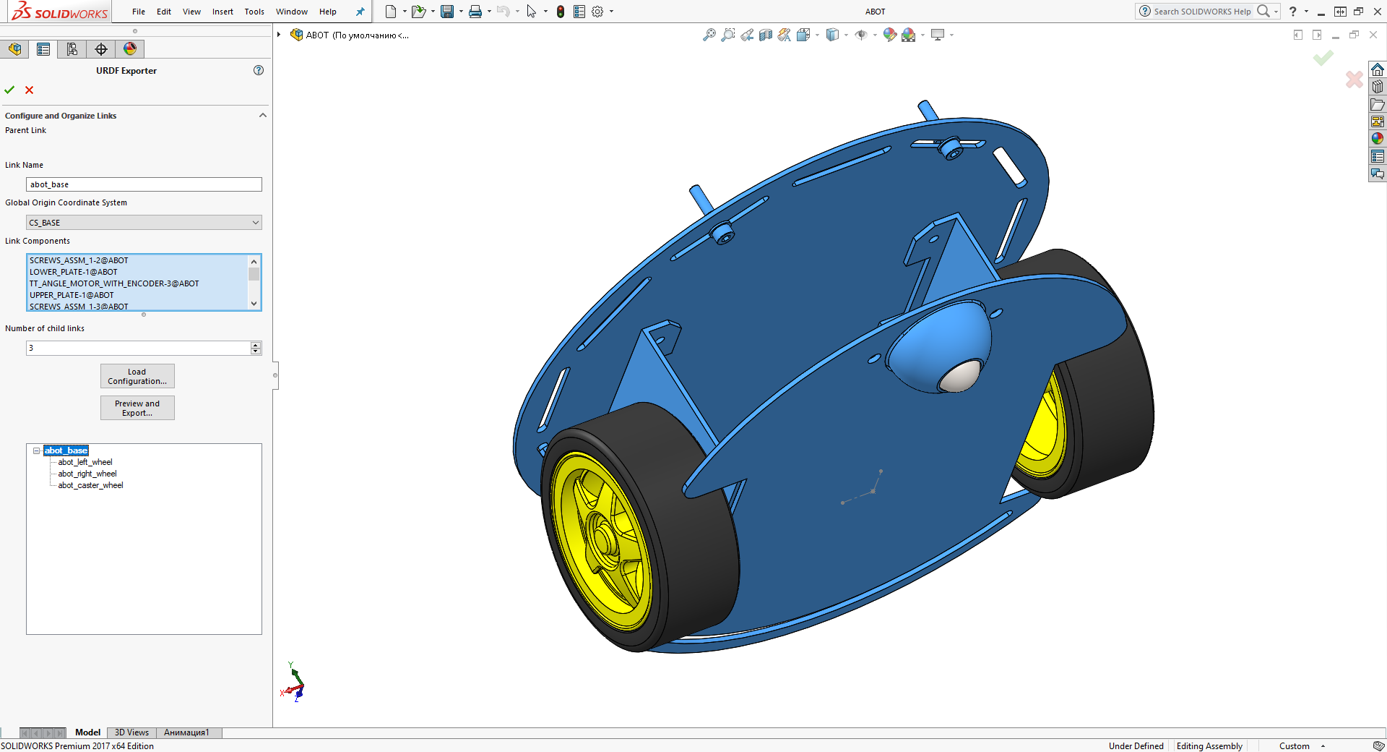
[picture p51: ARTICLE_RU/media/part_6/cad/part_6_cad_drawing_4.png]
part_6_cad_drawing_4


Следующий шаг - описать сегменты боковых колес. Эти сегменты являются сегментами потомками `abot_base`. Мы установили имена соединений `abot_left_wheel` и `abot_right_wheel`. В качестве систем координат мы выбираем соответствующие `CS_LEFT_WHEEL` и `CS_RIGHT_WHEEL`. Оси вращения колес - `AXIS_LEFT_WHEEL` и `AXIS_RIGHT_WHEEL`. В качестве геометрии мы выбираем детали колес нашей 3D-модели. Для обычного колеса тип соединения (joint) является `continuous`. Так же задаем имена для сочленений колес - `left_wheel_to_base` и `right_wheel_to_base`.

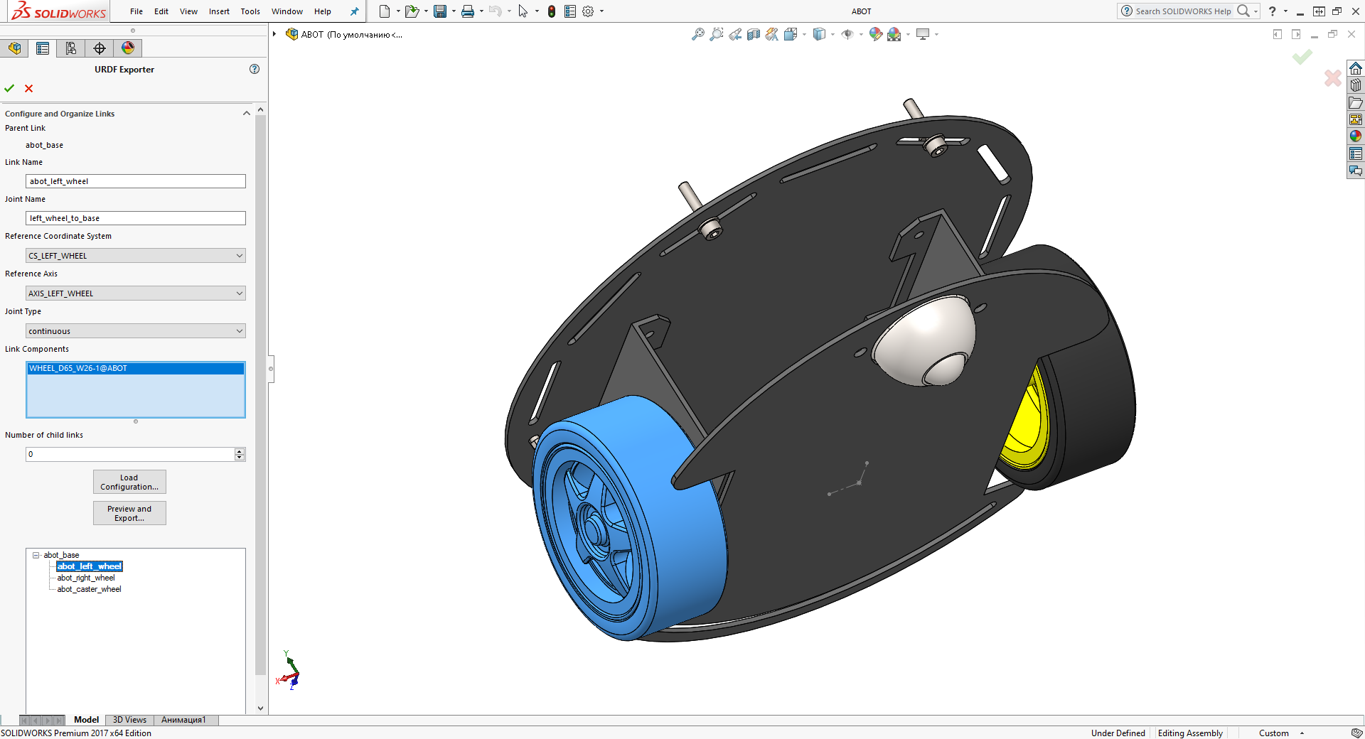
[picture p52: ARTICLE_RU/media/part_6/cad/part_6_cad_drawing_5.png]
part_6_cad_drawing_5


Добавляем последний сегмент `abot_caster_wheel` и сочленение `caster_wheel_to_base` для всенаправленного колеса. Здесь тип соединения должен быть `continuous`, а система координат - `CS_CASTER_WHEEL`.

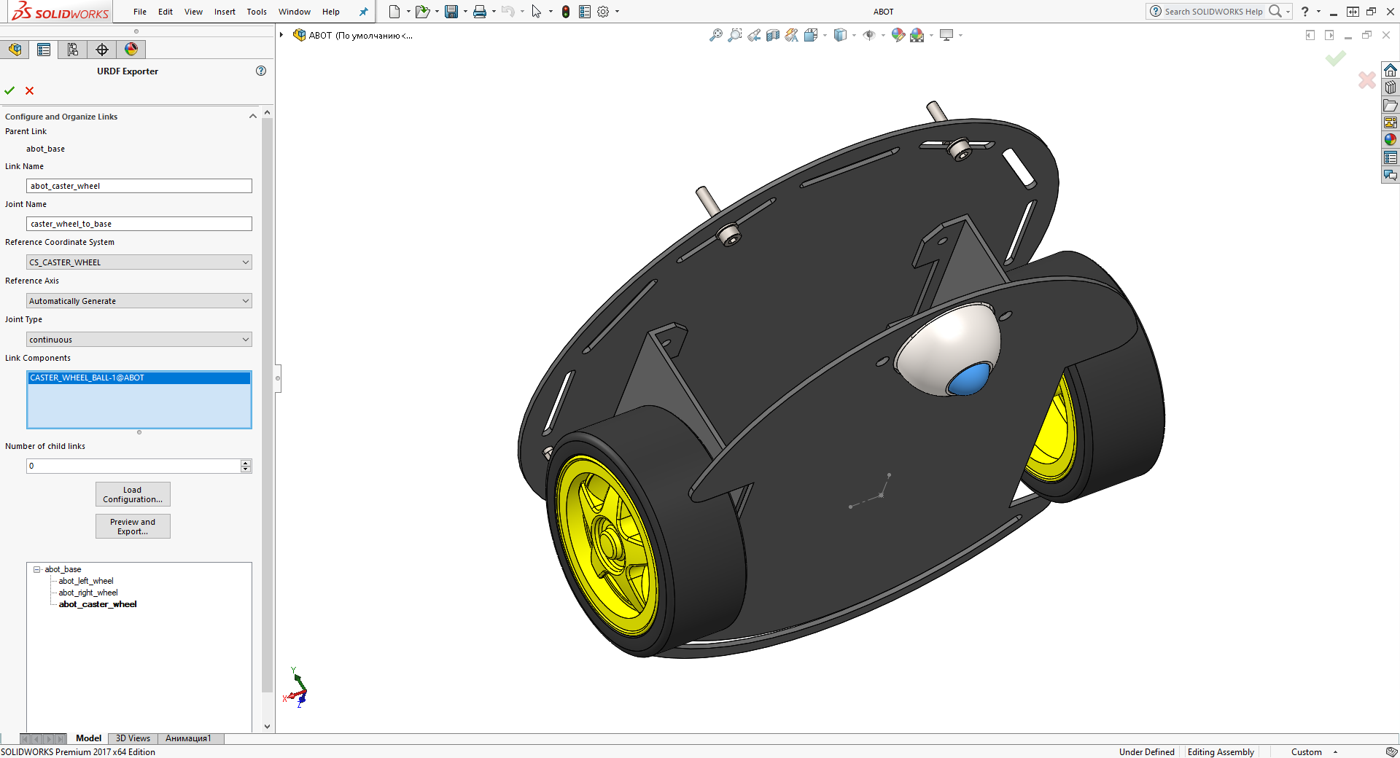
[picture p53: ARTICLE_RU/media/part_6/cad/part_6_cad_drawing_6.png]
part_6_cad_drawing_6


**Важно** Для двухколесного дифференциального привода, последнее, всенаправленное колесо никак не влияет на алгоритм задания скоростей движения робота. Мы не можем управлять этим колесом, задавать скорость его вращения и контролировать его. То есть, в теории, нет необходимости описывать его в модели и можно "слить" сегмент всенаправленного колеса с базовым сегментом всего робота. Однако это не так. Описывать желательно все подвижные части вашего робота. Если что то в роботе двигается - значит для этого нужно сочленение (joint) даже если вы не планируете его использовать. Особенно это важно если вы планируте использовать симуляции. Например, мы можем не описывать всенаправленное колесо, тогда оно останется в описании робота твердой опорой и частью другого сегмента. В этом случае при симуляции поведения движения робота описанного таким образом, программа не будет знать что это колесо. Программа расценит колесо как твердый обьект который роботу приходится "тащить" по полу и который создает силы трения и препятствует движению. Таким образом движение робота в симуляции и в реальной жизни будет координально отличаться.

Когда вы опишите все сегменты и сочленения, нажмите кнопку **Preview and Export.. button**.

Проверьте параметры сочленений и нажмите кнопку **Next**.

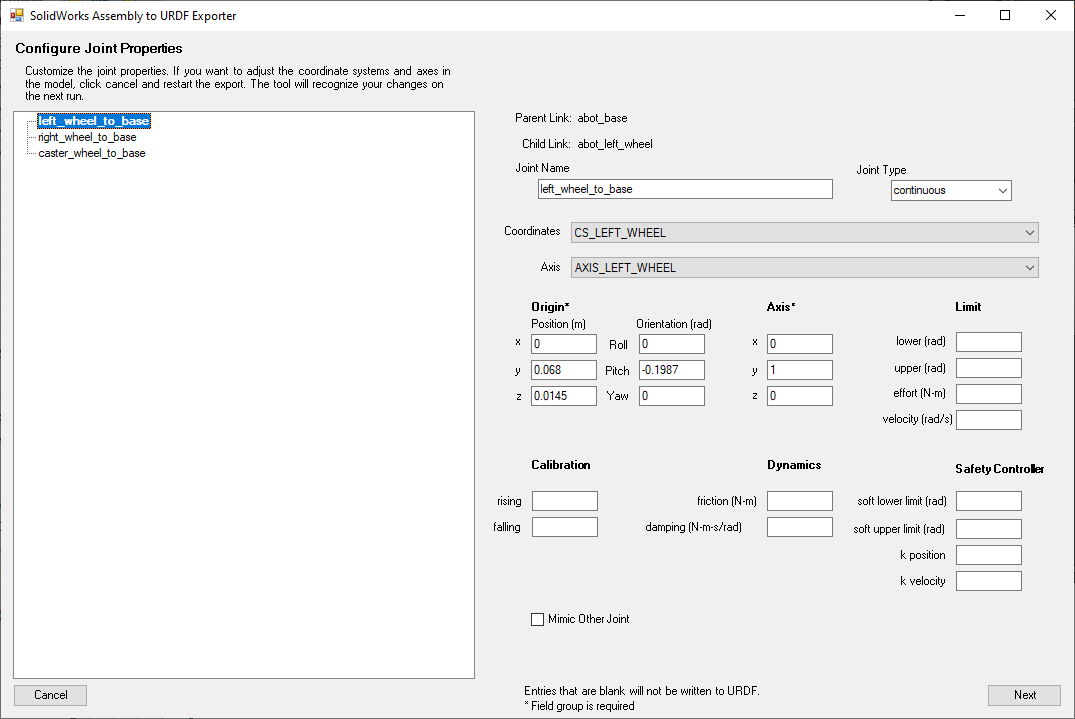
[picture p54: ARTICLE_RU/media/part_6/cad/part_6_cad_drawing_7.png]
part_6_cad_drawing_7


Проверьте параметры сегментов.

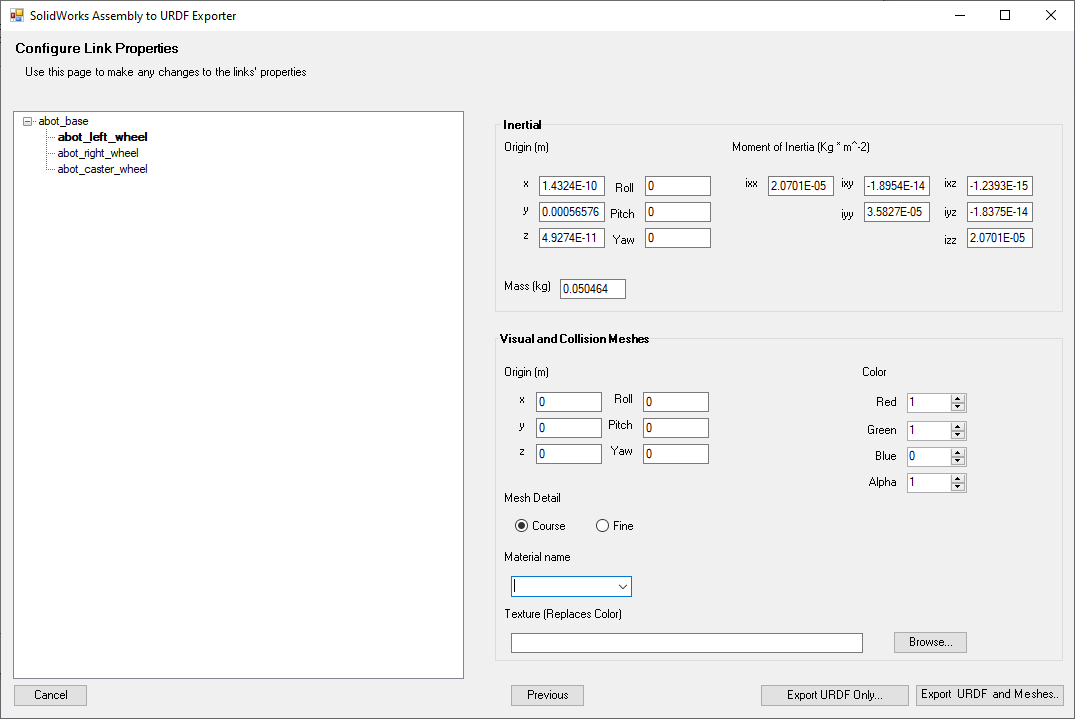
[picture p55: ARTICLE_RU/media/part_6/cad/part_6_cad_drawing_8.png]
part_6_cad_drawing_8


Обратите внимание, если вы укажете материал деталей, то программа экспортер сама вычислит массу сегментов, их центры массс и тензор инерции. Это крайне важные параметры если вы планируете симулировть робота!

Завершите экспорт, нажав на кнопку **Export URDF and Meshes..**. Укажите имя папки для экспорта. Мы назвали нашу папку `abot`. Экспортер создаст в этой папке готовый пакет ROS со многими файлами, которые вам в действительности не нужны. Вам нужны 3D-файлы формата *.STL из папки `meshes` и файл описания `abot.urdf` из папки `urdf`.

Отложим эти файлы на некоторое время в сторону.

## Пакет robot_description

Вернемся на Linux и перейдем в наше рабочее пространство `ros` настольном компьютере.

Cоздадим наш первый пакет проекта робота. Это пакет который содержит описание робота. Традиционно этот пакет называют `robot_description`. Чтобы избежать путаницы с именем, мы назовем его `abot_description`. В директории `ros/src`, в терминали вводим:

```bash
catkin_create_pkg abot_description tf rviz urdf xacro
```

С помощью этой команды вы можете создать пустой пакет ROS, а именно файлы `CMakelists.txt` и `package.xml`. В команде после имени пакета указываются ппакеты зависимости. Для пакета `abot_description` мы установливаем пакеты зависимостей `tf`, `urdf`, `xacro` и `rviz`.

Для каждого пакета ROS не забывайте указывать необходимые пакеты зависимости а так отредактировать файлы `CMakelists.txt` и `package.xml` при добавлении новых функций. Подробнее о процессе создания пакета читайте в [учебной статье](http://wiki.ros.org/ROS/Tutorials/CreatingPackage).

Внутри пакета мы создаем четыре папки с именами `urdf`, `meshes`, `rviz`, and `launch`.

```bash
mkdir abot_description/urdf abot_description/meshes abot_description/rviz abot_description/launch
```

В папку `abot_description/meshes` нужно поместить 3D STL файлы сгенерированные ранее при экспорте нашей модели в URDF. В папку `abot_description/urdf` поместите файл `abot.urdf` так же сгенерированный при экспорте.

***Важно*** Внутри пакета ROS, в папке c именем `launch` традиционно хранятся файлы запуска нод. Эти файлы имеют расширение .launch. С помощью `launch` файлов можно запустить несколько ROS нод используя всего один терминал. Кроме этого через `launch` файл можно задать различные параметры для нод или глобальные параметры для параметрического сервера ROS. Читайте подробнее в [документации на `roslaunch`](http://wiki.ros.org/roslaunch).

### Приводим в порядок URDF файл описания робота

Экспортер генерирует описание URDF в одном большом файле. Это не всегда удобно. Откройте файл `abot.urdf` и посмотрите, как выглядит описание робота.

В будущем мы будем постоянно совершенствовать нашего робота и расширять его описание, поэтому для удобства давайте разделим файл `abot.urdf` на несколько частей с помощью макросов `xacro` и исправим некоторые сгенерированные ошибки.

Мы решил разделить описание на несколько частей:

- `abot.xacro` - основная информация о роботе, о его базовых сегментах.
- `abot_left_wheel.xacro` - описание сегмента левого колеса и сочленения левого колеса с базой робота.
- `abot_right_wheel.xacro` - описание сегмента правого колеса и сочленения правого колеса с базой робота.
- `abot_caster_wheel.xacro` - описание сегмента всенаправленного колеса и сочленения всенаправленного колеса с базой робота.
- `abot_materials.xacro` - описание цветов для визуализации.

Давайте разбираться. Начнем с простого. Создадим цвета для визуализации. В папке `urdf` cоздадим файл `abot_materials.xacro` и заполните его несколькими элементами описывающими цвета:

```xml
<?xml version="1.0"?>
<robot
	xmlns:xacro="http://www.ros.org/wiki/xacro">
	<material name="Green">
		<color rgba="0.0 1.0 0.0 1.0"/>
	</material>
	<material name="Blue">
		<color rgba="0.0 0.0 1.0 1.0"/>
	</material>
	<material name="Red">
		<color rgba="1.0 0.0 0.0 1.0"/>
	</material>
	<material name="White">
		<color rgba="1.0 1.0 1.0 1.0"/>
	</material>
	<material name="Yellow">
		<color rgba="1.0 1.0 0.0 1.0"/>
	</material>
</robot>
```

Теперь создадим файл `abot.xacro` и заполним его информацией о сегменте `abot_base`.

Изменим путь до трехмерных файлов с  `package://abot/meshes/abot_base.STL` на `package://abot_description/meshes/abot_base.STL`.

Включим `abot.xacro` файл с нашими цветами `abot_materials.xacro` и замените все экспортированные теги `material` на новые. Пусть сегмент `abot_base` визуализируется белым цветом. 

Вот какое получилось содержание файла `abot.xacro`.

```xml
<?xml version="1.0" encoding="utf-8"?>
<robot name="abot"
	xmlns:xacro="http://www.ros.org/wiki/xacro">
	<!-- Matherials -->
	<xacro:include filename="$(find abot_description)/urdf/abot_matherials.xacro" />
	<!-- abot_base -->
	<link name="abot_base">
		<inertial>
			<origin xyz="-0.024498 1.0952E-13 0.022295" rpy="0 0 0"/>
			<mass value="0.27459"/>
			<inertia ixx="0.00032396" ixy="-1.1142E-12" ixz="-9.1302E-06" iyy="0.00030091" iyz="-3.3253E-10" izz="0.00056103"/>
		</inertial>
		<visual>
			<origin xyz="0 0 0" rpy="0 0 0" />
			<geometry>
				<mesh filename="package://abot_description/meshes/abot_base.STL" />
			</geometry>
			<material name="White" />
		</visual>
		<collision>
			<origin xyz="0 0 0" rpy="0 0 0" />
			<geometry>
				<mesh filename="package://abot_description/meshes/abot_base.STL" />
			</geometry>
		</collision>
	</link>
</robot>
```

Еще одна фундаментальная деталь. Согласно конвенции, описание URDF для ROS должно иметь сегмент с именем `base_link`. Именно этот сегмент служит отправной точкой для дерева описания робота. Вы можете добавить этот сегмент в дерево описания с любой простой геометрией, например, со сферой радиусом 1 мм. 

Мы добавляем в описание `base_link` и "прикрепляем" его к сегменту `abot_base` с помощью соединения `fixed`. Добавляем следующие строки в файл `abot.xacro`:

```xml
<!-- base_link -->
<link name="base_link">
	<visual>
		<origin xyz="0 0 0" rpy="0 0 0" />
		<geometry>
			<sphere radius="0.001" />
		</geometry>
	</visual>
</link>
<joint name="base_link_to_abot_base" type="fixed">
	<origin xyz="0 0 0" rpy="0 0 0" />
	<parent link="base_link" />
	<child link="abot_base" />
</joint>
```

Заполним файлы для правого колеса (`abot_right_wheel.xacro`), для левого колеса (`abot_left_wheel.xacro`) и всенаправлленого колеса (`abot_caster_wheel.xacro`) подобным образом. Отредактируем все экспортированные данные, и разделим их по файлам. Пусть все колеса будут зелеными.

Файл описания левого колеса:

```xml
<?xml version="1.0" encoding="utf-8"?>
<robot name="abot"
	xmlns:xacro="http://www.ros.org/wiki/xacro">
	<!-- left_wheel -->
	<link name="abot_left_wheel">
		<inertial>
			<origin xyz="1.9255E-10 0.00056576 -1.0414E-10" rpy="0 0 0"/>
			<mass value="0.050464"/>
			<inertia ixx="2.0701E-05" ixy="-3.8089E-14" ixz="1.3584E-15" iyy="3.5827E-05" iyz="2.1838E-15" izz="2.0701E-05"/>
		</inertial>
		<visual>
			<origin xyz="0 0 0" rpy="0 0 0" />
			<geometry>
				<mesh filename="package://abot_description/meshes/abot_left_wheel.STL" />
			</geometry>
			<material name="Green" />
		</visual>
		<collision>
			<origin xyz="0 0 0" rpy="0 0 0" />
			<geometry>
				<mesh filename="package://abot_description/meshes/abot_left_wheel.STL" />
			</geometry>
		</collision>
	</link>
	<joint name="left_wheel_to_base" type="continuous">
		<origin xyz="0 0.068 0.0145" rpy="0 0 0" />
		<parent link="abot_base" />
		<child link="abot_left_wheel" />
		<axis xyz="0 1 0" />
	</joint>
</robot>
```

Файл описания правого колеса:

```xml
<?xml version="1.0" encoding="utf-8"?>
<robot name="abot"
	xmlns:xacro="http://www.ros.org/wiki/xacro">
	<!-- right_wheel -->
	<link name="abot_right_wheel">
		<inertial>
			<origin xyz="1.9255E-10 -0.00056576 1.0414E-10" rpy="0 0 0"/>
			<mass value="0.050464"/>
			<inertia ixx="2.0701E-05" ixy="3.8089E-14" ixz="-1.3584E-15" iyy="3.5827E-05" iyz="2.1838E-15" izz="2.0701E-05"/>
		</inertial>
		<visual>
			<origin xyz="0 0 0" rpy="0 0 0" />
			<geometry>
				<mesh filename="package://abot_description/meshes/abot_right_wheel.STL" />
			</geometry>
			<material name="Green" />
		</visual>
		<collision>
			<origin xyz="0 0 0" rpy="0 0 0" />
			<geometry>
				<mesh filename="package://abot_description/meshes/abot_right_wheel.STL" />
			</geometry>
		</collision>
	</link>
	<joint name="right_wheel_to_base" type="continuous">
		<origin xyz="0 -0.068 0.0145" rpy="0 0 0" />
		<parent link="abot_base" />
		<child link="abot_right_wheel" />
		<axis xyz="0 1 0" />
	</joint>
</robot>
```

Файл описания всенаправленного колеса:

```xml
<?xml version="1.0" encoding="utf-8"?>
<robot name="abot"
	xmlns:xacro="http://www.ros.org/wiki/xacro">
	<!-- caster_wheel -->
	<link name="abot_caster_wheel">
		<inertial>
			<origin xyz="0 1.6073E-19 0" rpy="0 0 0"/>
			<mass value="0.011207"/>
			<inertia ixx="2.1965E-07" ixy="-1.5533E-55" ixz="-1.9776E-56" iyy="2.1965E-07" iyz="-2.2674E-40" izz="2.1965E-07"/>
		</inertial>
		<visual>
			<origin xyz="0 0 0" rpy="0 0 0" />
			<geometry>
				<mesh filename="package://abot_description/meshes/abot_caster_wheel.STL" />
			</geometry>
			<material name="Green" />
		</visual>
		<collision>
			<origin xyz="0 0 0" rpy="0 0 0" />
			<geometry>
				<mesh filename="package://abot_description/meshes/abot_caster_wheel.STL" />
			</geometry>
		</collision>
	</link>
	<joint name="caster_wheel_to_base" type="continuous">
		<origin xyz="-0.078 0 -0.011" rpy="0 0 0" />
		<parent link="abot_base" />
		<child link="abot_caster_wheel" />
		<axis xyz="0 1 0" />
	</joint>
</robot>
```

Включим все новые файл описания колес в конец главного файла `abot.xacro`.

```xml
<!-- Wheels -->
<xacro:include filename="$(find abot_description)/urdf/abot_left_wheel.xacro" />
<xacro:include filename="$(find abot_description)/urdf/abot_right_wheel.xacro" />
<xacro:include filename="$(find abot_description)/urdf/abot_caster_wheel.xacro" />
```

### Визуализация URDF модели

Давайте визуализируем нашего робота в ROS на настольном компьютере машине и посмотрим что получается.

Для визуализации используем мощный инструмент `rviz`. Вы можете прочитать больше о `rviz` в [документации на вики](http://wiki.ros.org/rviz).

Если вы установили полную версию ROS (`ros-desktop-full`), то у вас уже есть все необходимые пакеты ROS для визуализации. Однако так же нужно установить дополнительный пакет `joint-state-publisher-gui` для ручного управления сочленениями. Для нашей ROS Noetic устанавливаем:

```bash
sudo apt-get install ros-noetic-joint-state-publisher-gui
```

Создадим новый файл запуска нод ROS. В ROS эти файлы имеют разрешение *.launch.

В нашем пакете `abot_description` в папке `launch` создаем файл `display_model.launch`. Заполним файл следующими строками:

```xml
<launch>
	<!-- Args -->
	<arg name="gui" default="true" />
	<arg name="model" default="$(find abot_description)/urdf/abot.xacro" />
	<!-- Params -->
	<param name="use_gui" value="$(arg gui)" />
	<!-- Robot Description from URDF -->
	<param name="robot_description" command="$(find xacro)/xacro --inorder $(arg model)" />
	<node name="joint_state_publisher_gui" pkg="joint_state_publisher_gui" type="joint_state_publisher_gui" />
	<node name="robot_state_publisher" pkg="robot_state_publisher" type="robot_state_publisher" />
	<!-- Rviz -->
	<node name="rviz" pkg="rviz" type="rviz" required="false"/>
</launch>
```

Что делает этот файл? При запуске данный файл загрузит необходимые для визуализации ноды ROS а так же загрузит URDF описание нашего робота на сервер параметров ROS. 

Перейдем в наше рабочее пространство `ros` и соберем его с нашим новым пакетом `abot_description`.

```bash
cd ~/ros
catkin_make
```

Загрузим переменные окружения нашего рабочего пространства и запустим `display_model.launch`.

```bash
source devel/setup.bash
roslaunch abot_description display_model.launch
```

Если вы все сделали верно то появится оконо `rviz` и окно `joint_state_publisher_gui`.

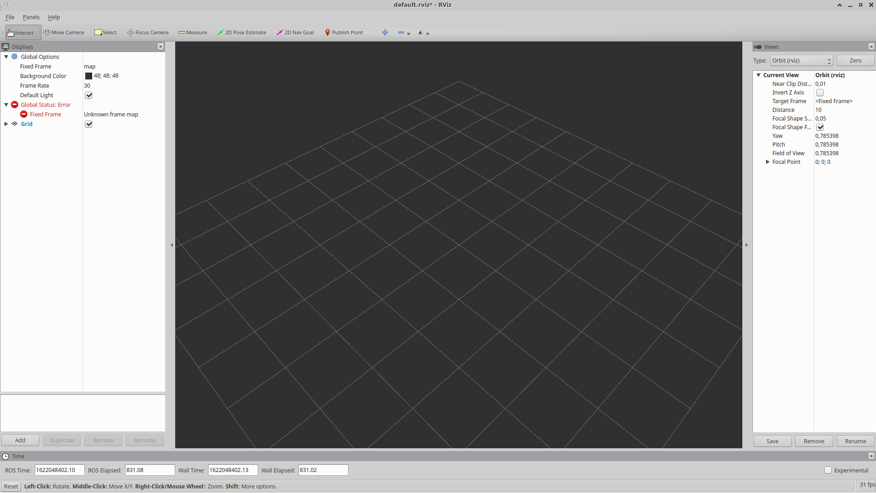
[picture p56: ARTICLE_RU/media/part_6/rviz/part_6_rviz_screen_1.png]
part_6_rviz_screen_1


В окне `rviz`, в меню **Displays → Global Options** устанавливаем значение параметра `Fixed Frame` в `base_link`. 

Нажимаем кнопку **Add** в левой нижней части экрана и добавляем две визуализцаии `RobotModel` и `TF`. 

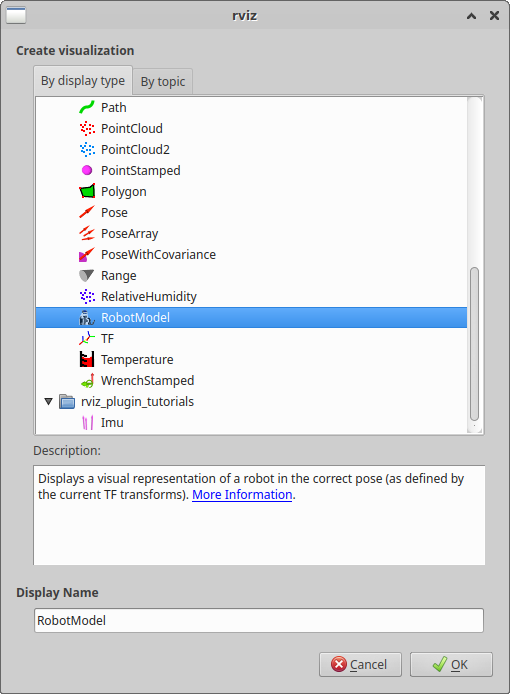
[picture p57: ARTICLE_RU/media/part_6/rviz/part_6_rviz_screen_2.png]
part_6_rviz_screen_2


На экране появится модель робота созданная по нашему URDF описанию и дерево транформаций.

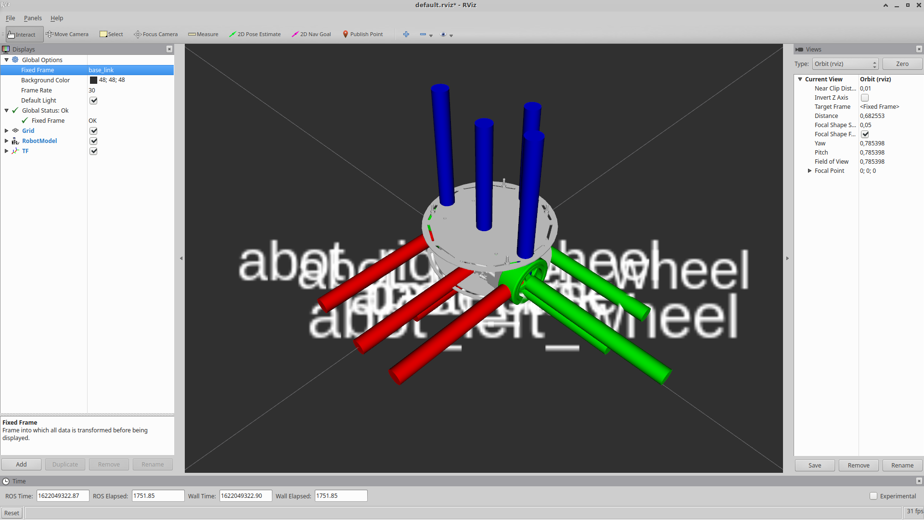
[picture p58: ARTICLE_RU/media/part_6/rviz/part_6_rviz_screen_3.png]
part_6_rviz_screen_3


Выглядит не очень понятно. Это потому что сейчас `rviz` имеет стандартные настройки. Вы можете настроить отображение всех данных под себя и сохранить файл настроек. Файл настроек имеет разрешение *.rviz.

Например, мы сохраняем настройки `rviz` для отображения модели в виде файла `abot_model.rviz` в папке `abot_description/rviz` и добавляем соответствующий аргумент в файл запуска `display_model.launch`.

Теперь наш файл запуска `display_model.launch` выглядит таким образом:

```xml
<launch>
	<!-- Args -->
	<arg name="gui" default="true" />
	<arg name="rvizconfig" default="$(find abot_description)/rviz/abot_model.rviz" />
	<arg name="model" default="$(find abot_description)/urdf/abot.xacro" />
	<!-- Params -->
	<param name="use_gui" value="$(arg gui)" />
	<!-- Robot Description from URDF -->
	<param name="robot_description" command="$(find xacro)/xacro --inorder $(arg model)" />
	<node name="joint_state_publisher_gui" pkg="joint_state_publisher_gui" type="joint_state_publisher_gui" />
	<node name="robot_state_publisher" pkg="robot_state_publisher" type="robot_state_publisher" />
	<!-- Rviz -->
	<node name="rviz" pkg="rviz" type="rviz" args="-d $(arg rvizconfig)" required="false"/>
</launch>
```

А отображение модели стало намного более приятным и понятным:

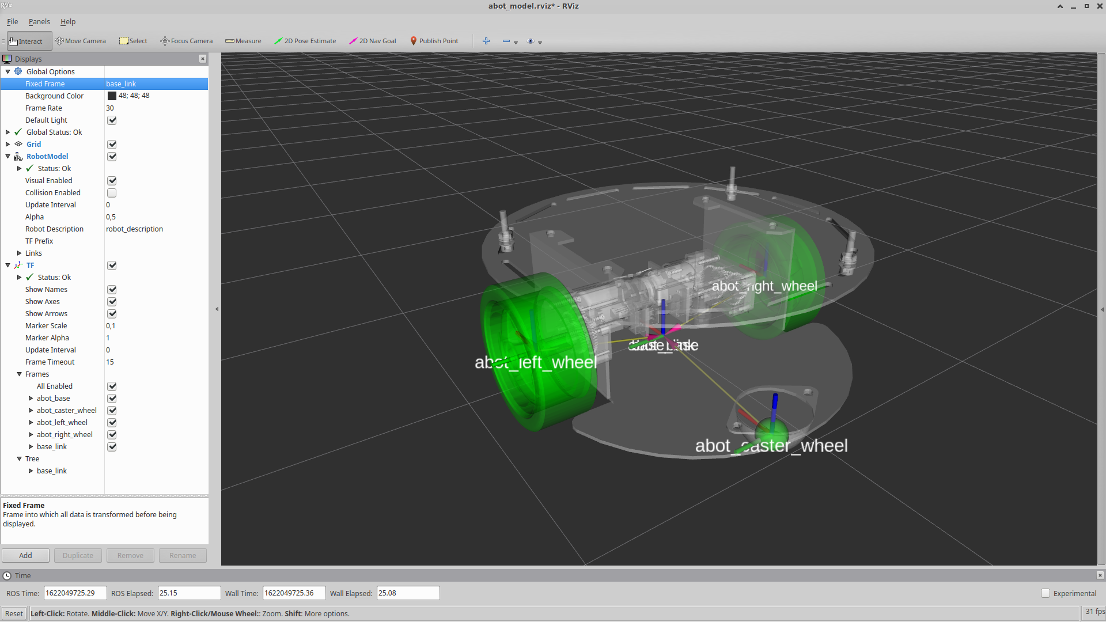
[picture p59: ARTICLE_RU/media/part_6/rviz/part_6_rviz_screen_4.png]
part_6_rviz_screen_4


Можно отключить видимость 3D моделей и проверьть все дерево элементов вашего описания а так же направление осей систем координат.

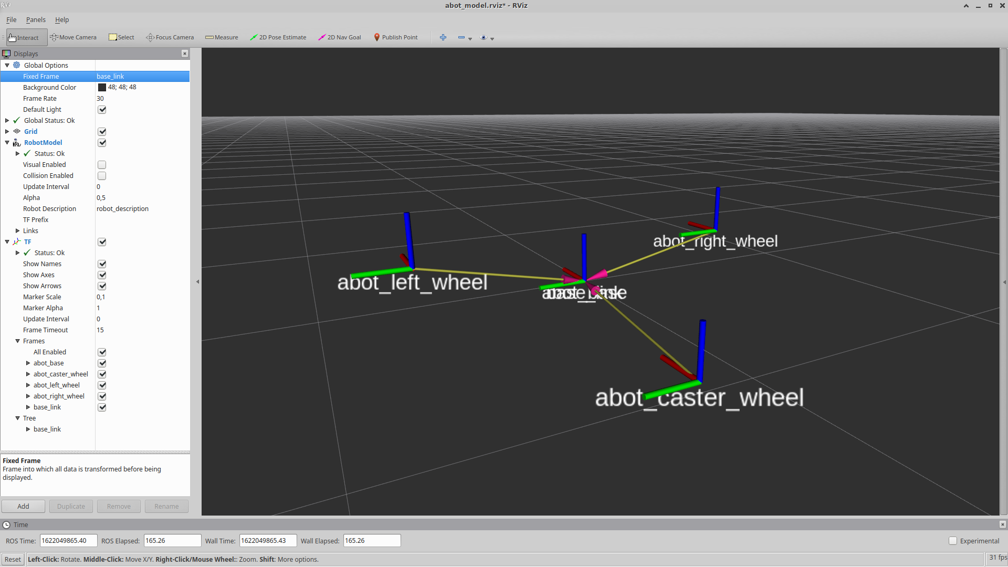
[picture p60: ARTICLE_RU/media/part_6/rviz/part_6_rviz_screen_5.png]
part_6_rviz_screen_5


Не забудьте что у нас открыто и второе окно `joint_state_publisher_gui`.

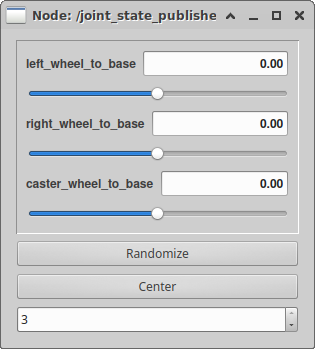
[picture p61: ARTICLE_RU/media/part_6/rviz/part_6_rviz_screen_6.png]
part_6_rviz_screen_6


Используя слайдеры в этом окне вы можете вручную поуправлять всеми сочленениями модели вашего робота. В нашем случае, перемещая слайдер мы вращаем колеса.

### Footprint робота

Сейчас, при визуализации, наш робот находится в точке (0, 0, 0) на плоскости `grid` которая выступает в роли пола а фиксированный кадр `Fixed Frame` в котором отображается наш робот является глобальным (`Global Frame`). На самом деле робот не должен находится в этой точке, ведь он стоит на своих колесах а не замурован где-то в полу.

Нам необходимо "поднять" робота над полом а так же указать его проекцию на пол - его `footprint`. В соответствии конвенцией в ROS, для этого используется сегмент `base_footprint`. Нам нужно ввести в описание нашего робота этот новый сегмент и связать его с базовым сегментом `base_link`. Так же нужно указать геометрические размеры проекции робота на пол и клиренс.

Добавим новые данные в основной файл описания робота `abot.xacro`. Добавим параметр `clearance` в начало файла. Это будет расстояние в метрах от пола до исходных точкек сегментов `base_link` и `abot_base`. Поместим следующую строку в начало файла `abot.xacro`:

```xml
<xacro:property name="clearance" value="0.018" />
```

В качестве проекции робота на пол можно указать простую геометрическую фигуру. Например, наш робот условно круглый и в качестве проекции мы можем указать цилиндр высотой в 1 мм и радиусом 100 мм. Пусть на визуализации цвет проекции будет синим.

Добавляем в `abot.xacro` новый сегмент и связываем его с имеющимися.

```xml
<!-- base_footprint -->
<link name="base_footprint">
	<visual>
		<origin xyz="0 0 0" rpy="0 0 0" />
		<geometry>
			<cylinder length="0.001" radius="0.010" />
		</geometry>
		<material name="Blue" />
	</visual>
</link>
<joint name="base_footprint_to_base_link" type="fixed">
	<origin xyz="0 0 ${clearance}" rpy="0 0 0" />
	<parent link="base_footprint" />
	<child link="base_link" />
</joint>
```

Давайте опять запустим визуализацию `rviz`, но в качестве фиксированного кадра визуализации (`Fixed Frame`) укажем `base_footprint`.

Теперь наш робот стоит на земле своими колесами:

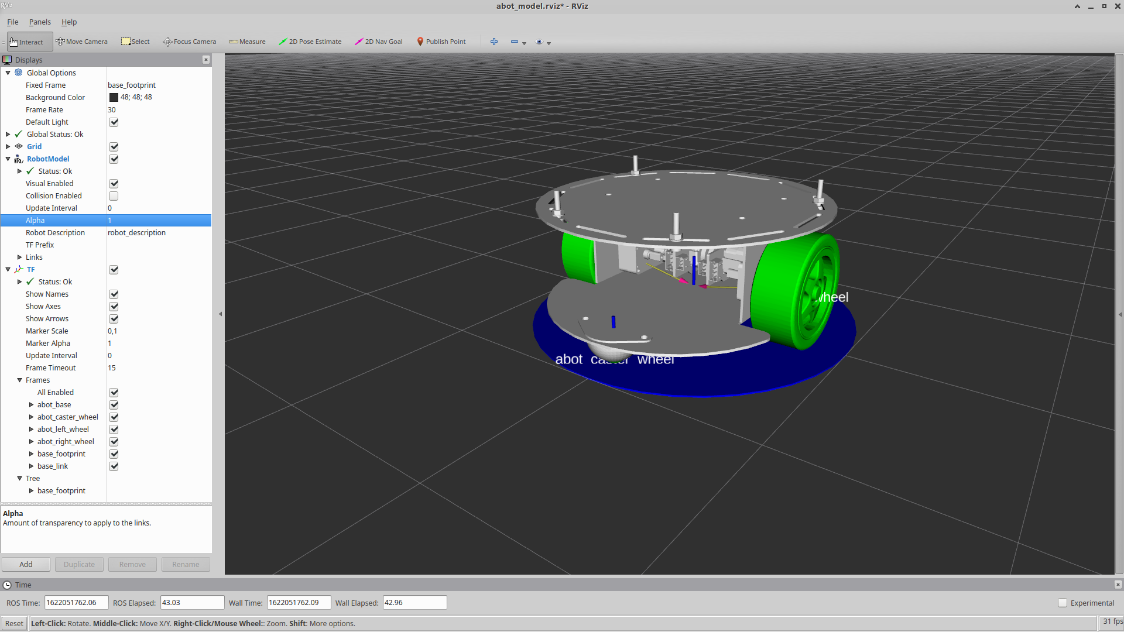
[picture p62: ARTICLE_RU/media/part_6/rviz/part_6_rviz_screen_7.png]
part_6_rviz_screen_7


Сейчас дерево сегментов и сочлненений нашего робота выглядит так:

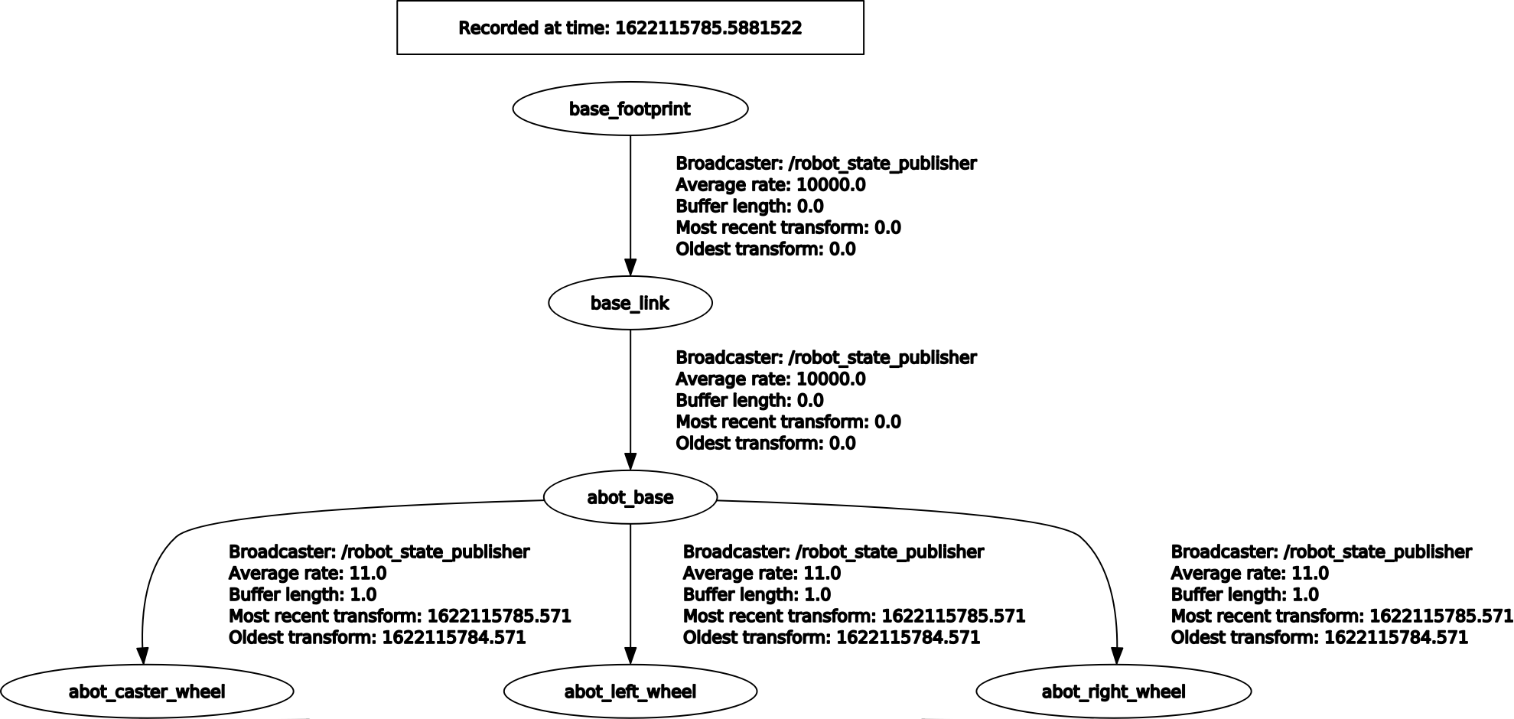
[picture p63: ARTICLE_RU/media/part_6/rqt/part_6_rqt_screen_1.png]
part_6_rqt_screen_1


## Raspberry Pi Hat и крепление электроники

Следующим нашим шагом будет подключение двигатели и энкодеров к роботу. Одноплатник Raspberry в этом плане - отличный выбор, так как дает прямой доступ к контактам GPIO.

Однако не всегда удобно подключать электронику к плате Raspberry напрямую. Лучше использовать специальные платы расширения и адаптеры.

Для нашего робота мы используем универсальный хаб для Raspberry [Troyka HAT](prod://raspberry-pi-troyka-hat).

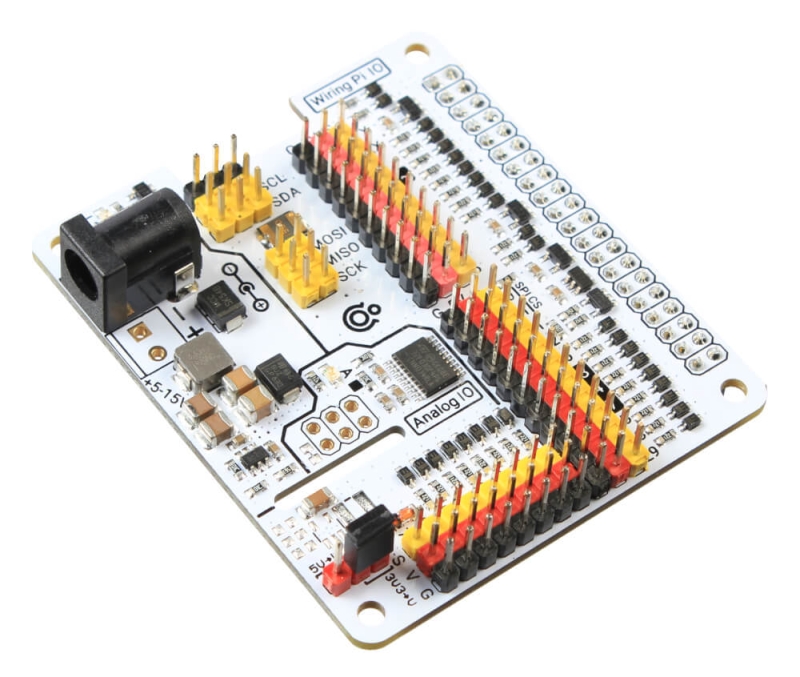
[picture p64: ARTICLE_RU/media/part_7/prod/part_7_prod_electronics_1.jpg]


Этот адаптер легко вставляется в гребенку пинов Raspberry. Установим Troyka HAT на Raspberry:

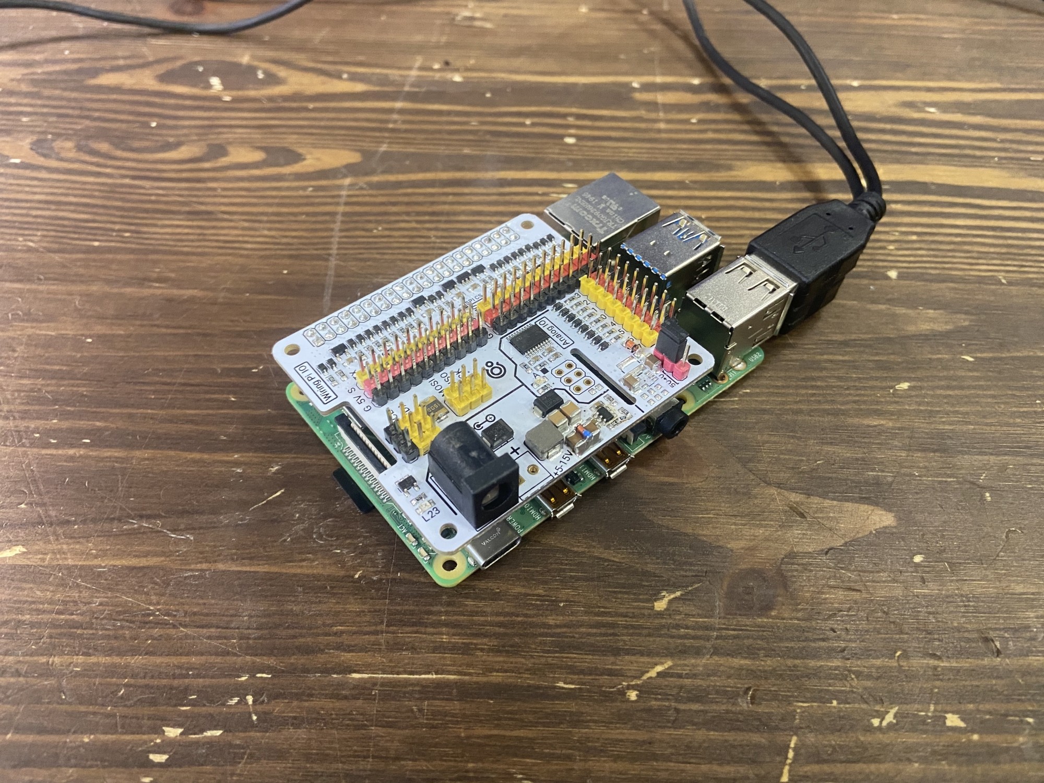
[picture p65: ARTICLE_RU/media/part_7/irl/part_7_irl_electronics_1.jpg]


Troyka HAT также имеет дополнительный контроллер-расширитель GPIO портов. Этот контроллер обеспечивает восемь дополнительных портов ввода-вывода с аппаратной поддержкой 12-битного АЦП и 16-битной ШИМ. Позже мы обязательно воспользуемся этой собенностью.

Так выглядит распиновка платы Troyka HAT:

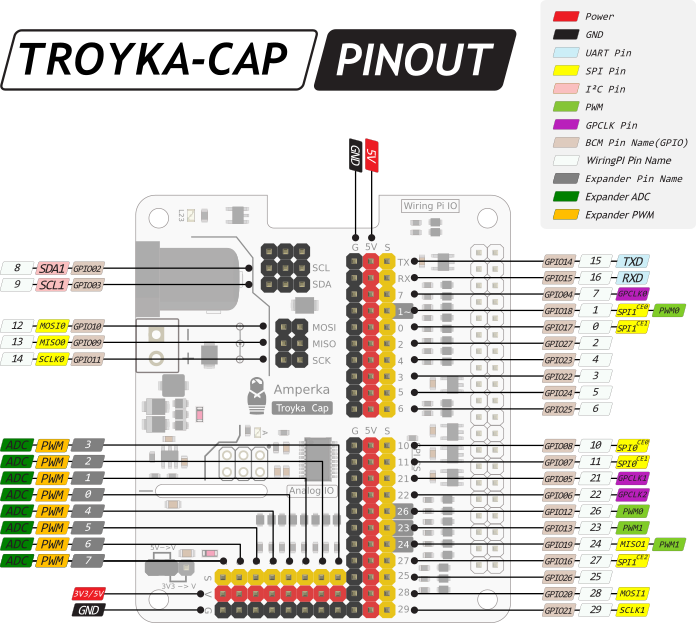
[picture p66: ARTICLE_RU/media/part_7/schemes/part_7_schemes_1.png]


Пришло время прикрепить наш бортовой компьютер к шасси робота. Можно не заморачиваться с крепежом и прикрепить Raspberry хоть на двухсторонний скотч. Однако если вы хотите сделать качественного робота, все следует делать по уму.

Для крепления электроники мы спроектировали и напечатали на 3D принтере новую деталь для робота в виде панели или диска. На этой детали мы сделали отверстия для крепежа Raspberry и прочих электронных компонентов. Деталь напечатали на [Prusa i3 MK3S](prod://3d-printer-prusa-i3-mk3s) из [серого PLA-пластика ESUN](prod://3d-printer-filament-esun-pla-plus-grey).

Вот так выглядит панель:

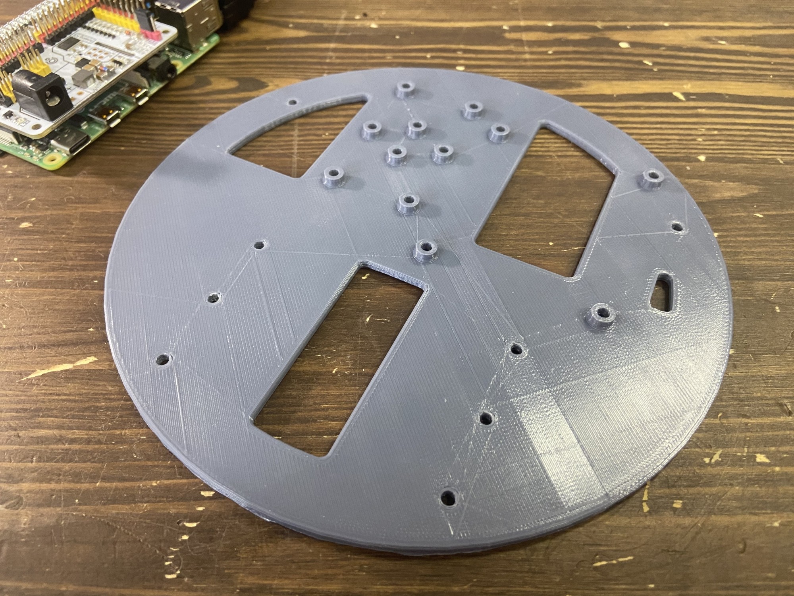
[picture p67: ARTICLE_RU/media/part_7/irl/part_7_irl_electronics_2.jpg]


Крепим на напечатанную панель Raspberry винтами M2,5x10, гайками M2,5 и контрим гроверными шайбами M2,5.

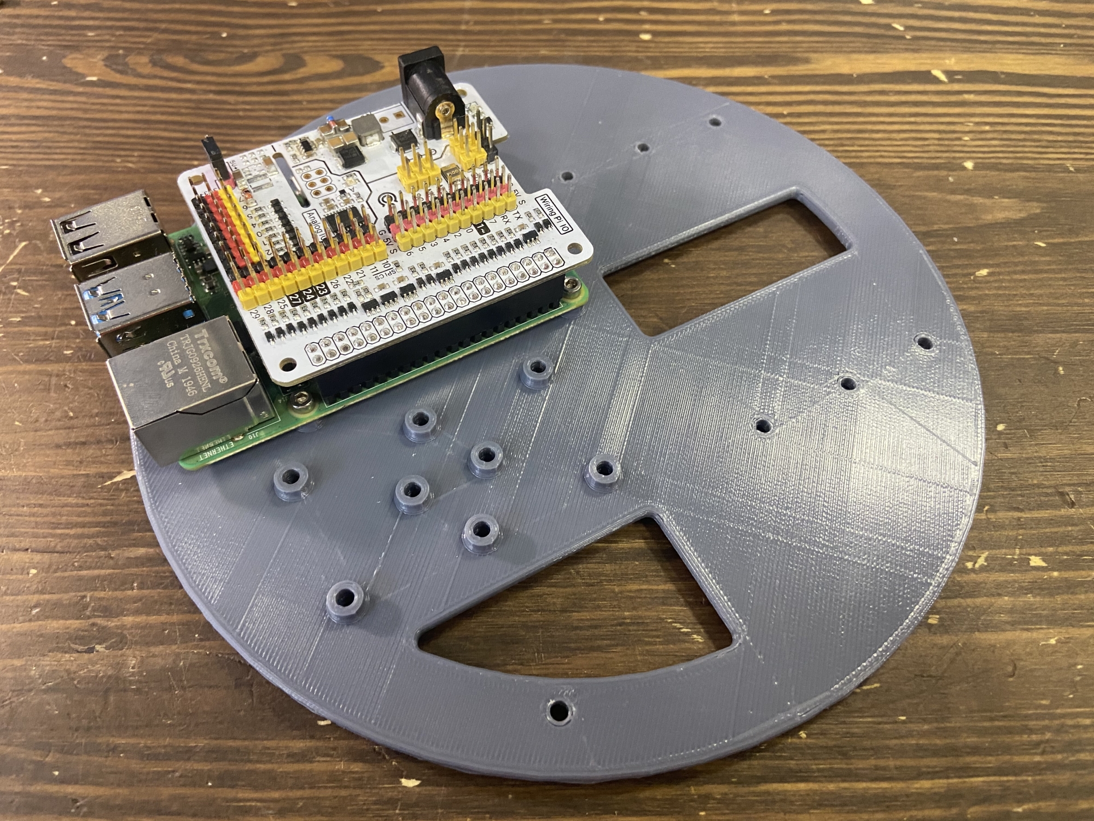
[picture p68: ARTICLE_RU/media/part_7/irl/part_7_irl_electronics_3.jpg]


## Бортовое питание

Для бортового питания нашего робота мы будем использовать [Li-ion аккумуляторы](https://ru.wikipedia.org/wiki/Литий-ионный_аккумулятор). Энергии нужно много, одна только Raspberry Pi 4 нуждается в 3 А тока а ведь помимо нее на борту робота будут и другие потребители. Так что нужны аккумуляторы с большой токоотдачей и емкостью. Можно использовать [Li-po аккумуляторы](https://ru.wikipedia.org/wiki/Литий-полимерный_аккумулятор) которые обычно применяются в радиоуправляемых моделях и способны отдавать токи величиной в 2С и более. Однако слишком уж большие токи нам не к чему и мы решили использовать именно Li-ion аккумуляторы в формате 18650.

Мы выбрали аккумуляторы [Li-Ion 18650 Ansmann 3.6 В 2600 мА·ч](battery-li-ion-18650-rechargeable-fourfold-protection).

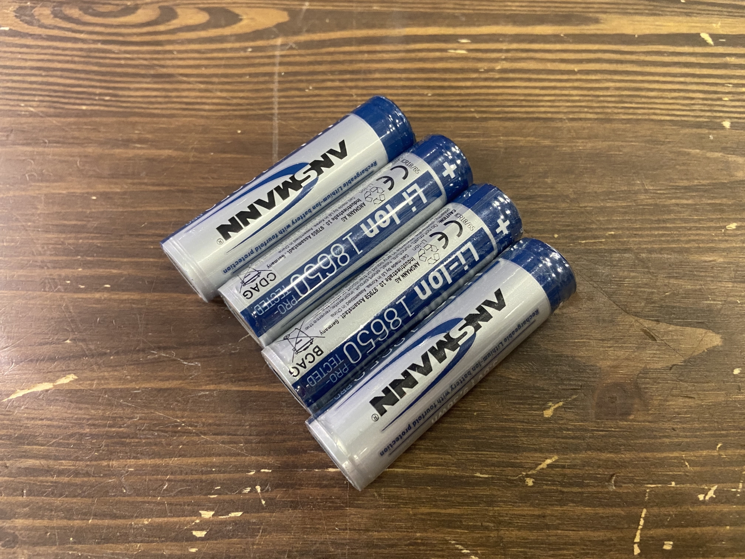
[picture p69: ARTICLE_RU/media/part_7/irl/part_7_irl_electronics_4.jpg]


Один такой аккумулятор это одна Li-ion "банка" 3.6 В с максимальной отдачей тока в 5 А. Всего мы будем использовать четыре аккумулятора соединенных попарно паралеленно. В сумме это даст нам батарею 7.2 В и 5200 мА·ч. Это не так уж и много для мобильного робота, но на первое время нам хватит. Еще один существенный плюс этих аккумуляторов это наличие схемы защиты от грубокого разряда и короткого замыкания.

7.2 В с батареи мы можем подать на DC-разъём платы Troyka HAT и на ее понижающий DC-DC преобразователь. Этими же 7.2 В мы можем управлять двумя 6-вольтовыми DC моторами в нашем шассии.

Аккумуляторы поместим в два [батарейных отсека 2x18650](https://www.chipdip.ru/product1/8007250932).

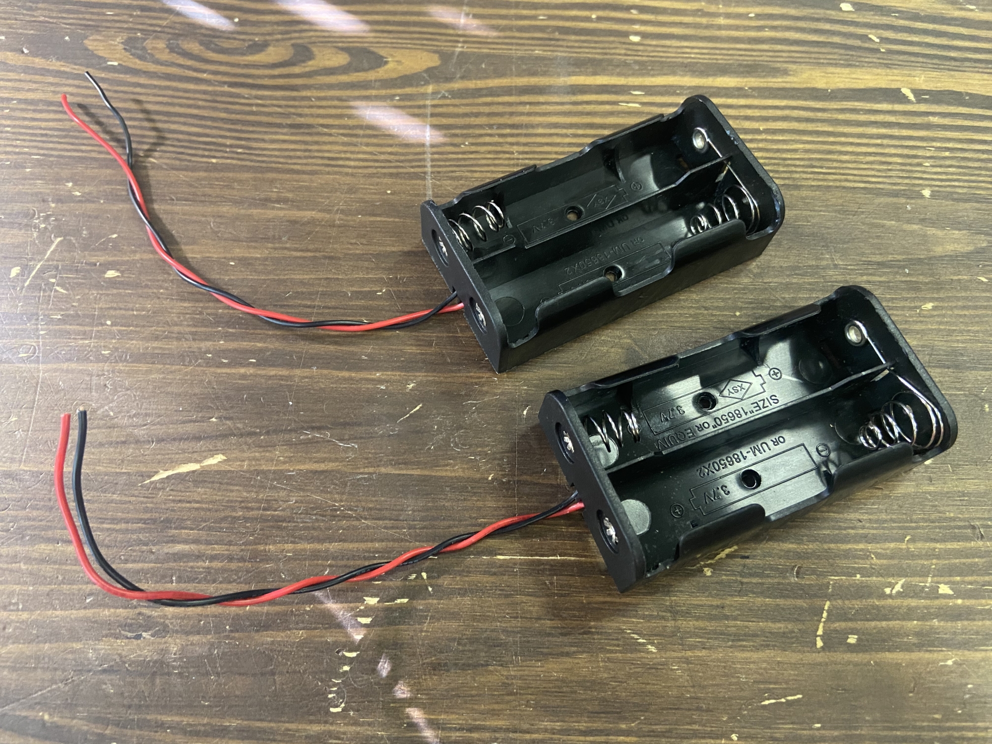
[picture p70: ARTICLE_RU/media/part_7/irl/part_7_irl_electronics_5.jpg]


Батарейные отсеки крепим на панели робота винтами М2х6, гайками М2, контрим гроверными шайбами М2.

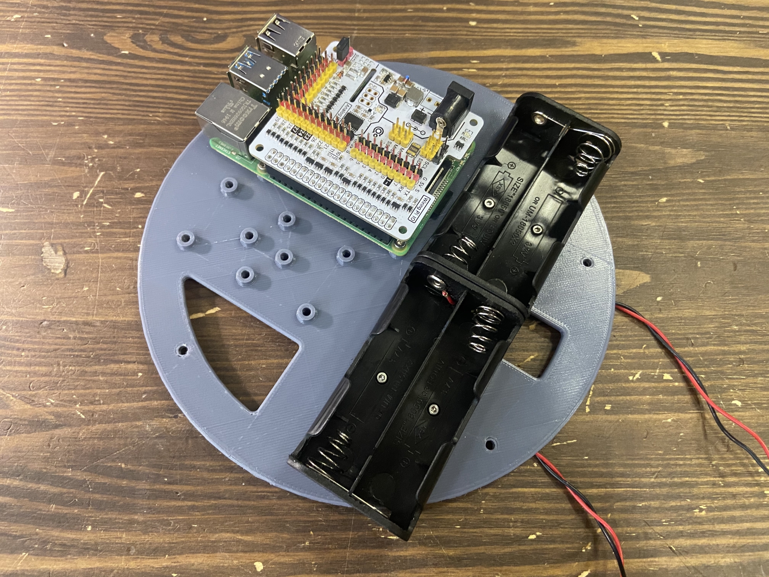
[picture p71: ARTICLE_RU/media/part_7/irl/part_7_irl_electronics_6.jpg]


Примерим собранную панель на шасси:

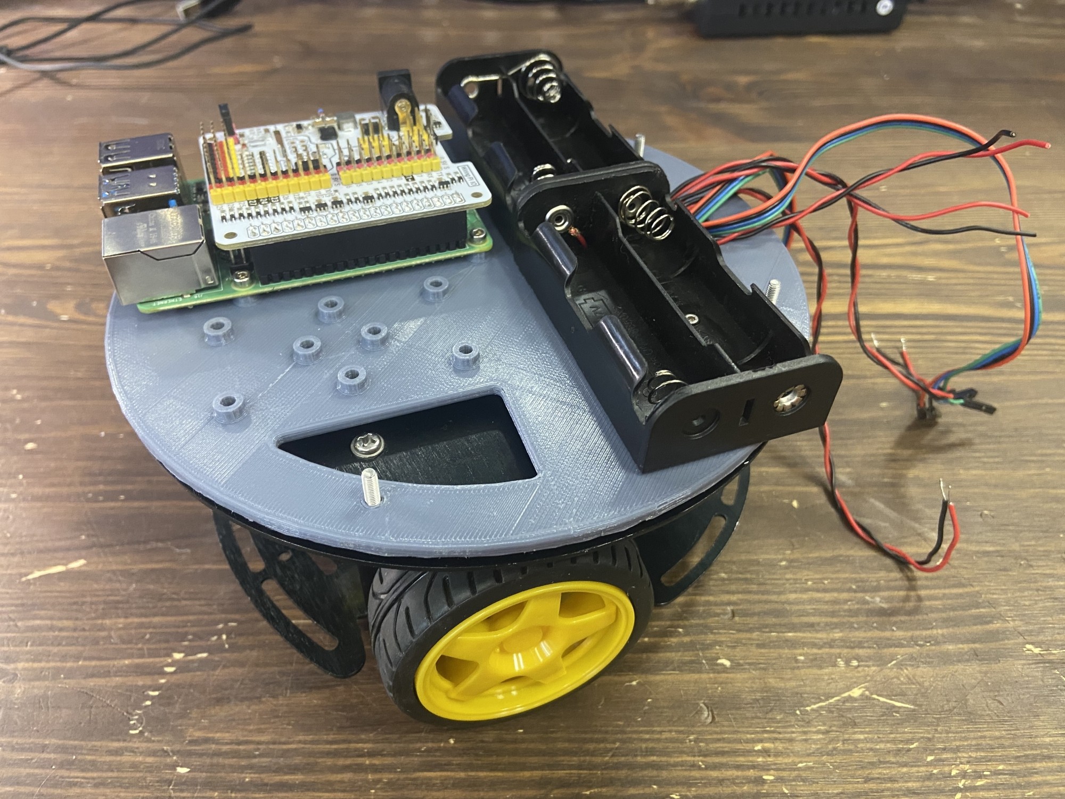
[picture p72: ARTICLE_RU/media/part_7/irl/part_7_irl_electronics_7.jpg]


## Актуализация модели робота

С добавлением новой напечатанной детали наш робот внешне немного изменился. А это значит что изменилась его 3D модель. И мы должны отредактировать его URDF описание.

***Важно*** Всегда регистрируйте любые изменения реального робота как в САПР документации так и в URDF описании. Это действие не является обязательным но оно прививает привычку контролировать документацию и поможет вам быстрее находить ошибки программах и что еще важнее причины ошибок.

Обновляем 3D модель:

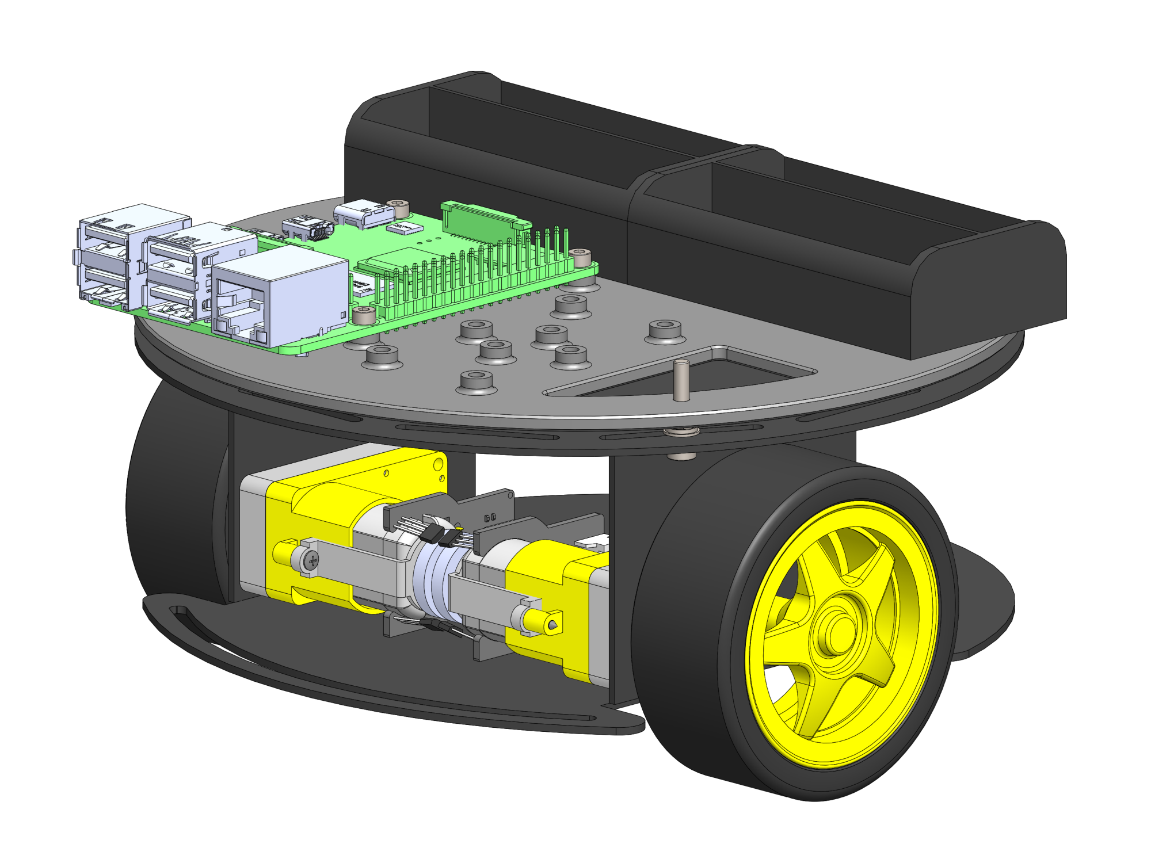
[picture p73: ARTICLE_RU/media/part_7/cad/part_7_cad_1.png]


Также обновляем URDF описание робота. Делаем все через экспортер, так же как в прошлый раз. На этот раз не будем описывать процесс экспорта так же подробно. В этот раз у нас изменился только сегмент `abot_base`. А именно его `<visual>` составляющая, STL файл а так же инерционные свойства.

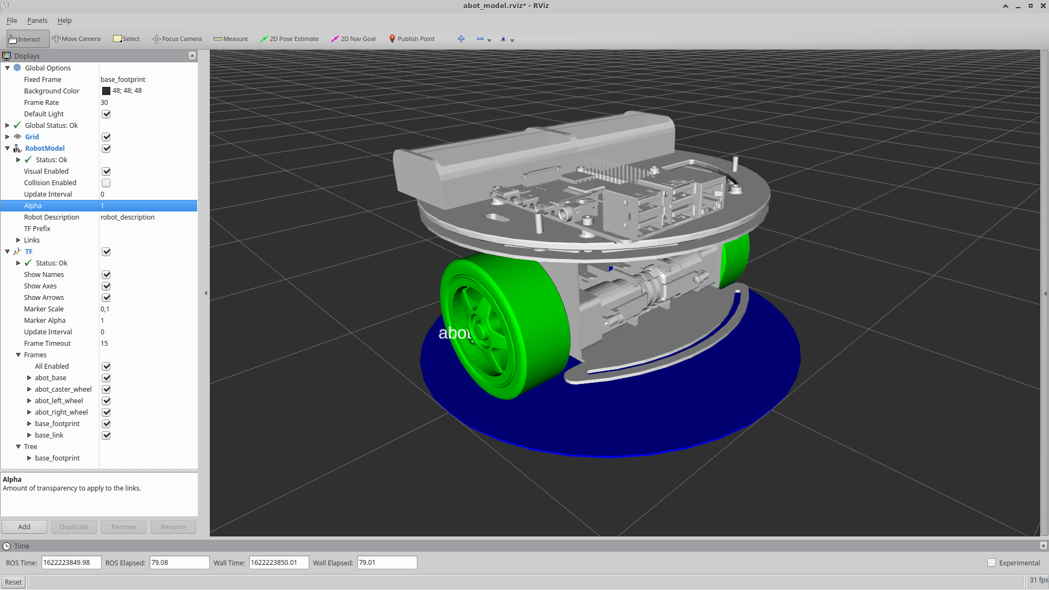
[picture p74: ARTICLE_RU/media/part_7/rviz/part_7_rviz_1.png]


## Низкоуровневые драйверы

Давайте начнем писать драйверы для железа нашего робота.

### Пакет abot_driver

Создадим в рабочем пространстве `ros` новый ROS пакет который будет отвечать за драйверы.

Назовем пакет `abot_driver`.

Не забываем оформлять файлы `CMakelists.txt` и `package.xml` для каждого нового пакета. В качестве пакетов зависимостей устанавливаем:

- [`roscpp`](http://wiki.ros.org/roscpp)
- [`std_msgs`](http://wiki.ros.org/std_msgs)

Внутри пакета создаем папку с именем `src`. В папке с именем `src` в ROS конвенционально хранятся исходные файлы программ.

***Важно*** ROS ноды которые мы напишем для этого пакета будут запускаться только на Raspberry (не на настольном компьютере).

### Библиотека WiringPi

Чтобы использовать контакты Raspberry GPIO, вам нужна библиотека. Существует множество библиотек для управления GPIO Raspberry, они различаются по языку и по глубине использования функций. Существуют библиотеки для C, С++, C#, Python, JavaScript, Perl, Java и Ruby. Вы можете просмотреть [полный список существующих библиотек](https://docs.google.com/spreadsheets/d/1sFCJuPZ9k5GN0A6j7gHRckvbwIdnwzPH1sTCuPNFNRQ/edit#gid=0), который мы наши. Мы будем использовать библиотеку для C++ [WiringPi](http://wiringpi.com/) потому что писать наши ноды ROS мы так же будем на C++.

WiringPi это не сложная и известная библиотека. Однако она уже долгое время не поддерживается, потому что ее [разработка была прекращена](http://wiringpi.com/wiringpi-deprecated/). В ней и сейчас есть нереализованные функции и программные ошибки. Последняя официальная версия библиотеки - [2.52 для Raspberry Pi 4B](http://wiringpi.com/wiringpi-updated-to-2-52-for-the-raspberry-pi-4b/), и она собрана для архитектуры `armhf` а унас архетектура `arm64`.

На просторах Github мы нашли хороший форк библиотеки - [https://github.com/WiringPi/WiringPi](https://github.com/WiringPi/WiringPi). Мы будем использем эту версию библиотеки WiringPi и cоберем ее под нашу версию Linux.

В терминале на Raspberry Pi вводим:

```bash
git clone https://github.com/WiringPi/WiringPi.git
cd WiringPi
./build
```

Убедимся, что библиотека собралась и установилась правильно:

```bash
gpio -v
```

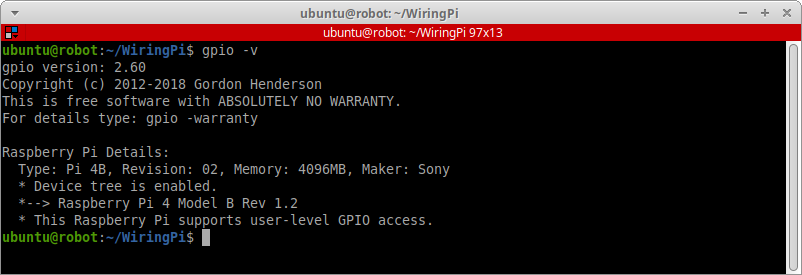
[picture p75: ARTICLE_RU/media/part_8/rpi_side/part_8_rpi_side_screen_1.png]


Чтобы просмотреть назначение всех контактов Raspberry Pi 4B а так же их GPIO/Broadcom/WiringPi маппинг, используйте команду:

```bash
gpio readall
```

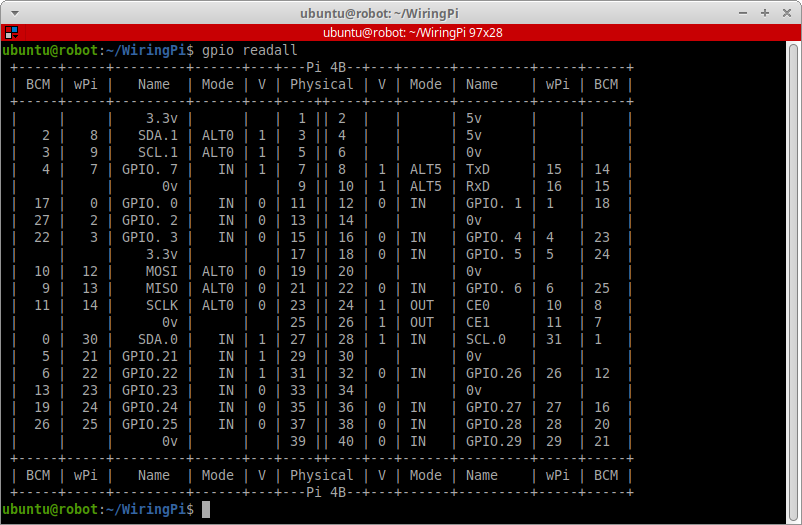
[picture p76: ARTICLE_RU/media/part_8/rpi_side/part_8_rpi_side_screen_2.png]


### Драйвер энкодеров

Наш первый драйвер это драйвер для считывания показаний энкодеров моторов.

#### Схема подключения энкодеров

Мы используем квадратурные энкодеры, каждый из которых имеет два канала - A и B, и подключается по двум проводам. Энкодер генерирует простые логические сигналы (HIGH или LOW). Если вал двигателя вращается быстро, то и изменения в логических сигналах так же генерируются быстро. Поэтому, чтобы случайно не пропустить какие либо изменения, мы будем считывать сигналы с энкодеров используя аппаратные прерывания Raspberry. Raspberry допускает использование прерывания на всех выводах, и вы можете подключить энкодер к любым неиспользуемым пинам.

Мы подключили энкодер левого двигателя к выводу Broadcom `BCM 17` (пин 0 для WiringPi) и `BCM 27` (пин 2 для WiringPi 2). Энкодер правого двигателя на выводы `BCM 24` (пин 5 для WiringPi) и `BCM 25` (пин 6 для WiringPi).

Энкодеры питаются от 5 В. 5 В можно взять с колодок Troyka Hat.

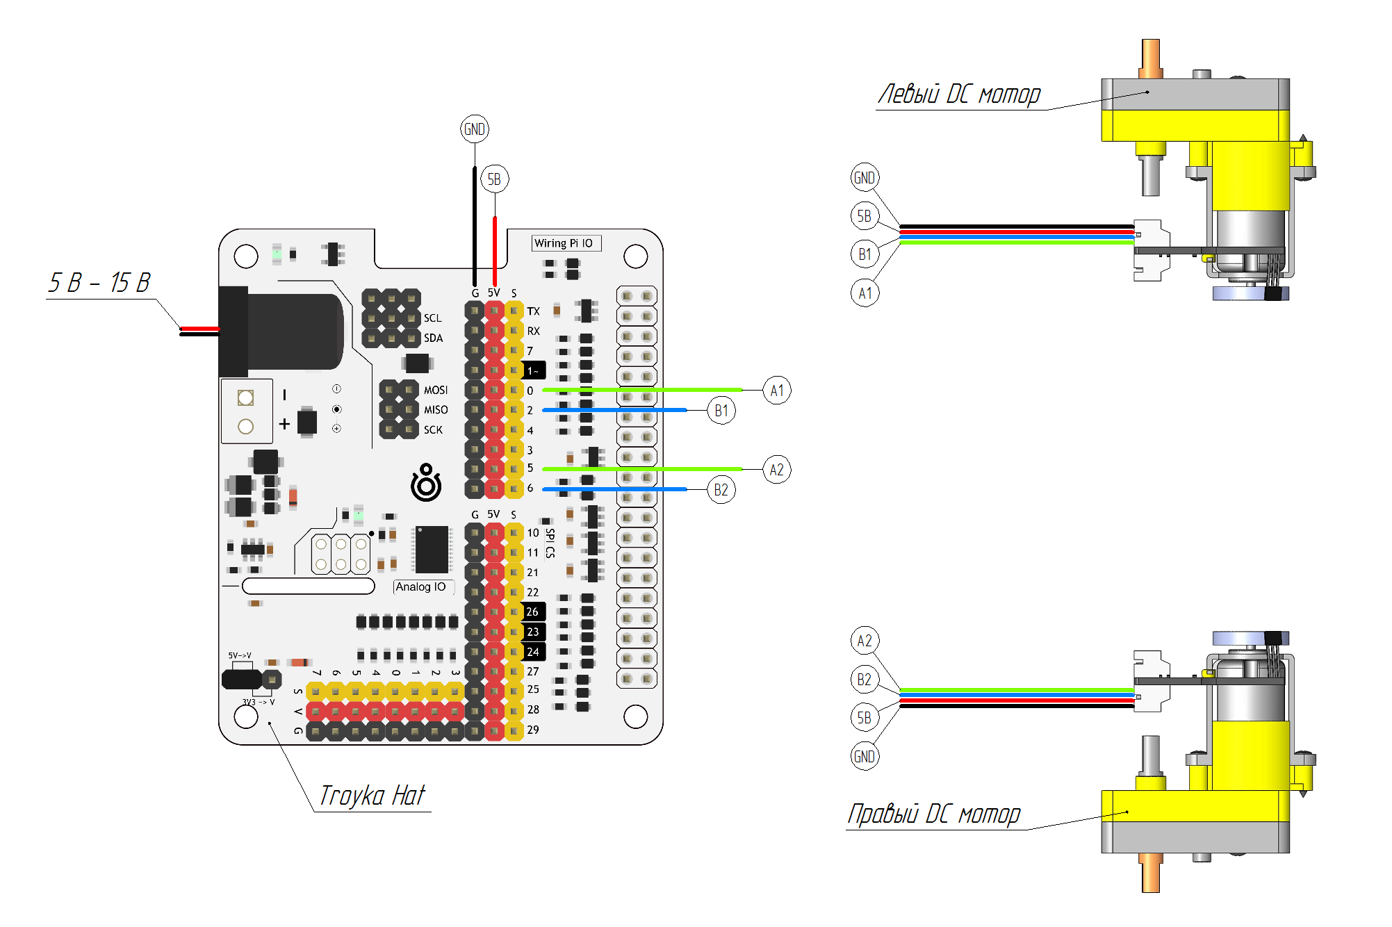
[picture p77: ARTICLE_RU/media/part_8/schemes/part_8_schemes_1.png]


#### Класс Encoder

Напишем класс С++ для декодирования квадратурного энкодера на Raspberry с использованием прерываний.

Чтобы использовать прерывания, мы создали две глобальные Сallback функции `encoder IS R1` и `encoderISR2`. Необработанные значения тиков энкодера содержатся в переменных `encoderPosition1` и `encoderPosition2` типа `long`. Так же нам нужна будет проверка на "переполнение" этих переменных, но об этом позже.

Задайте значение PPR (Импульсы на оборот) ваших энкодеров в коде. Для наших энкодеров значение `PULSES_PER_REVOLUTION` равно 1920.

Создаем заголовочный С++ файл `encoder_wiring_pi.hpp` в папке `abot_driver/src`.

```cpp
#ifndef ENCODER_WIRING_PI_HPP_
#define ENCODER_WIRING_PI_HPP_

#include <ros/ros.h>
#include <wiringPi.h>

#define ENCODER_1_PIN_A 17  // Wiring pi 0 = BCM 17
#define ENCODER_1_PIN_B 27  // Wiring pi 2 = BCM 27
#define ENCODER_2_PIN_A 24  // Wiring pi 5 = BCM 24
#define ENCODER_2_PIN_B 25  // Wiring pi 6 = BCM 25

#define PULSES_PER_REVOLUTION 1920

namespace EncoderWiringPiISR {

    volatile long encoderPosition1;
    volatile long encoderPosition2;
    volatile uint8_t encoderState1;
    volatile uint8_t encoderState2;

    void encoderISR(const int pinA, const int pinB, volatile long &encoderPosition, volatile uint8_t &encoderState) {
        uint8_t valA = digitalRead(pinA);
        uint8_t valB = digitalRead(pinB);
        uint8_t s = encoderState & 3;
        if (valA) s |= 4;
        if (valB) s |= 8; 
        encoderState = (s >> 2);
        switch (s) {
            case 1: case 7: case 8: case 14:
                encoderPosition++;
                return;
            case 2: case 4: case 11: case 13:
                encoderPosition--;
                return;
            case 3: case 12:
                encoderPosition += 2;
                return;
            case 6: case 9:
                encoderPosition -= 2;
                return;
        }
    }

    void encoderISR1(void) {
        encoderISR(ENCODER_1_PIN_A, ENCODER_1_PIN_B, encoderPosition1, encoderState1);
    }

    void encoderISR2(void) {
        encoderISR(ENCODER_2_PIN_A, ENCODER_2_PIN_B, encoderPosition2, encoderState2);
    }
}

class EncoderWiringPi {
public:
    EncoderWiringPi(const int &pinA, const int &pinB, void (*isrFunction)(void), volatile long* encoderPosition);
    double getAngle();
private:
    int _pinA;
    int _pinB;
    volatile long* _encoderPosition;
    double _initial_angle;
    double ticks2Angle(long position);
};

EncoderWiringPi::EncoderWiringPi(const int &pinA, const int &pinB, void (*isrFunction)(void), volatile long* encoderPosition) {
    _encoderPosition = encoderPosition;

    if (wiringPiSetupSys() < 0) {
        ROS_ERROR("Encoder wiringPi error: GPIO setup error");
        throw std::runtime_error("");
    }
    ROS_INFO("Encoder wiringPi: GPIO setup");

    _pinA = pinA;
    _pinB = pinB;
    pinMode(_pinA, INPUT);
    pinMode(_pinB, INPUT);
    pullUpDnControl(_pinA, PUD_UP);
    pullUpDnControl(_pinB, PUD_UP);

    if (wiringPiISR(_pinA, INT_EDGE_BOTH, isrFunction) < 0) {
        ROS_ERROR("Encoder wiringPi error: ISR pinA error");
        throw std::runtime_error("");
    }

    if (wiringPiISR(_pinB, INT_EDGE_BOTH, isrFunction) < 0) {
        ROS_ERROR("Encoder wiringPi error: ISR pinB error");
        throw std::runtime_error("");
    }

    _initial_angle = ticks2Angle(*_encoderPosition);
    ROS_INFO("Encoder wiringPi: ISR setup");
}

double EncoderWiringPi::getAngle() {
    double current_angle = ticks2Angle(*_encoderPosition);
    return current_angle - _initial_angle;
}

double EncoderWiringPi::ticks2Angle(long position) {
    return position * ((double)2 * M_PI / PULSES_PER_REVOLUTION / 2);
}

#endif // ENCODER_WIRING_PI_HPP_
```

#### Нода энкодеров

Теперь напишем ROS ноду для наших энкодеров. Назовем ее `encoders`.

Как будет работать эта нода? Класс `Encoder` который мы описали выше считывает сигналы с энкодеров используя прерывания, накапливает их а затем конвертирует в углы поворота колес (в радианах). Углы поворота колес используются для расчета одометрии робота и для определения текущей скорости вращения колес.

Так же мы создадим класс `EncodersPair` который использует углы поворота колес для расчета:

- Пройденного каждым колесом растояния (`left_wheel_angle`, `right_wheel_angle`). В нашем случае, пройденное расстояние мы храним в виде количества оборотов колеса в радианах.
- Текущей скорости вращения колеса (`letf_wheel_velocity`, `right_wheel_velocity`) в радианах в секунду.

Расчеты производятся раз в 10 мс по ROS таймеру `encoders_timer` , то есть с частотой 100 герц.

Пройденные колесами расстояния помещаются в сообщения типа `std_msgs/Float64` и публикуются в топики `/abot/left_wheel/angle` и `/abot/right_wheel/angle`.

Теукщие скорости вращения колес так же помещаются в сообщения типа `std_msgs/Float64` и публикуются в топики `/abot/left_wheel/current_velocity` и `/abot/right_wheel/current_velocity`.

Создадим файл `encoders.cpp` в папке `abot_driver/src`:

```cpp

#include "encoder_wiring_pi.hpp"
#include <std_msgs/Float64.h>
#include <chrono>

typedef boost::chrono::steady_clock time_source;

class EncodersPair {
public:
    EncodersPair(double update_rate);
private:
    ros::NodeHandle node;

    ros::Publisher left_wheel_angle_pub;
    ros::Publisher right_wheel_angle_pub;
    ros::Publisher left_wheel_velocity_pub;
    ros::Publisher right_wheel_velocity_pub;

    ros::Timer encoders_timer;

    std_msgs::Float64 left_wheel_angle_msg;
    std_msgs::Float64 right_wheel_angle_msg;
    std_msgs::Float64 left_wheel_velocity_msg;
    std_msgs::Float64 right_wheel_velocity_msg;

    EncoderWiringPi encoder_left;
    EncoderWiringPi encoder_right;

    double left_wheel_angle;
    double right_wheel_angle;
    double left_wheel_velocity;
    double right_wheel_velocity;
    double left_wheel_position;
    double right_wheel_position;

    time_source::time_point last_time;

    void encodersCallback(const ros::TimerEvent& event);
};

EncodersPair::EncodersPair(double update_rate) :
    encoder_left(ENCODER_1_PIN_A, ENCODER_1_PIN_B, &EncoderWiringPiISR::encoderISR1, &EncoderWiringPiISR::encoderPosition1),
    encoder_right(ENCODER_2_PIN_A, ENCODER_2_PIN_B, &EncoderWiringPiISR::encoderISR2, &EncoderWiringPiISR::encoderPosition2) {
    
    left_wheel_angle_pub = node.advertise<std_msgs::Float64>("/abot/left_wheel/angle", 1);
    right_wheel_angle_pub = node.advertise<std_msgs::Float64>("/abot/right_wheel/angle", 1);
    left_wheel_velocity_pub = node.advertise<std_msgs::Float64>("/abot/left_wheel/current_velocity", 1);
    right_wheel_velocity_pub = node.advertise<std_msgs::Float64>("/abot/right_wheel/current_velocity", 1);
   
    encoders_timer = node.createTimer(ros::Duration(update_rate), &EncodersPair::encodersCallback, this);
}

void EncodersPair::encodersCallback(const ros::TimerEvent& event) {
    time_source::time_point this_time = time_source::now();
    boost::chrono::duration<double> elapsed_duration = this_time - last_time;
    ros::Duration elapsed(elapsed_duration.count());
    last_time = this_time;

    left_wheel_angle = -1 * encoder_left.getAngle();
    right_wheel_angle = 1 * encoder_right.getAngle();

    left_wheel_angle_msg.data = left_wheel_angle;
    right_wheel_angle_msg.data = right_wheel_angle;

    left_wheel_angle_pub.publish(left_wheel_angle_msg);
    right_wheel_angle_pub.publish(right_wheel_angle_msg);

    double delta_left_wheel = left_wheel_angle - left_wheel_position;
    double delta_right_wheel = right_wheel_angle - right_wheel_position;

    left_wheel_position += delta_left_wheel;
    left_wheel_velocity = delta_left_wheel / elapsed.toSec();

    right_wheel_position += delta_right_wheel;
    right_wheel_velocity = delta_right_wheel / elapsed.toSec();
 
    left_wheel_velocity_msg.data = left_wheel_velocity;
    right_wheel_velocity_msg.data = right_wheel_velocity;

    left_wheel_velocity_pub.publish(left_wheel_velocity_msg);
    right_wheel_velocity_pub.publish(right_wheel_velocity_msg);
}

int main(int argc, char** argv) {
    ros::init(argc, argv, "encoders");
    EncodersPair encoders_pair(0.01);
    ros::spin();
    return 0;
}
```

Добавим новый исполняемый файл в правило сборки `CMakelists.txt` пакета `abot_driver`:

```makefile
add_executable(encoders src/encoders.cpp)
target_link_libraries(encoders ${catkin_LIBRARIES} -lwiringPi -lpthread -lcrypt -lm -lrt)
```

Собремем пакет `abot_driver` с новой нодой:

```bash
cd ~/ros
catkin_make
```

#### Тест энкодеров

Проверим как работает новая нода `encoders`.

Если вдруг вы выключили ядро (`roscore`) на настольном компьютере то включите его заного.

В рабочем пространстве на Raspberry, под `root`, запустим новую ноду вручную:

```bash
cd ~/ros
su root
source devel/setup.bash
rosrun abot_driver encoders
```

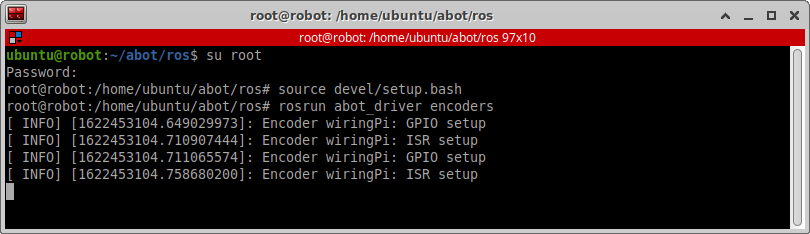
[picture p78: ARTICLE_RU/media/part_8/rpi_side/part_8_rpi_side_screen_3.png]


На настольном компьютере, проверим появились ли новые топики `/abot/left_wheel/angle`, `/abot/right_wheel/angle`, `/abot/left_wheel/current_velocity` и `/abot/right_wheel/current_velocity` созданные нодой `encoders`.

```bash
rostopic list
```



Посмотрим какие сообщения приходят в эти топики командой `rostopic echo`. Например посмотрим на пройденный путь и скорость вращения правого колеса:

```bash
rostopic echo /abot/right_wheel/angle
rostopic echo /abot/right_wheel/current_velocity
```

Проверим работу энкодеров. Установим робота на какую-нибудь подставку. Будем руками поворачивать колесо робота и при этом наблюдать за изменениями угла поворота и скорости вращения в мониторе топика.

Например, повернув правое колесо примерно на один оборот. Значение угла поворота колеса в топике `/abot/right_wheel/angle` должно соответственно измениться с `0` до примерно `2 * PI`.

Ту же операцию проделаем и с левым колесом.

<iframe width="1280"
        height="720"
        src="https://www.youtube.com/embed/Xif2Y0600SY"
        title="Abot. Encoders test."
        frameborder="0"
        class="article__cover-youtube"
        allowfullscreen="">
</iframe>

### Драйвер моторов

Второй наш драйвер это драйвер для управления двумя DC моторами установленными на шасси.

#### Подключение моторов

Моторы нужно подключить к Raspberry. Но мы не можем напрямую подключить двигатели постоянно тока к плате Raspberry и управлять ими. Нам нужен специльный модуль - плата которая будет управлять моторами.

Наши DC моторы, не потребляют больших токов и не нуждаются в большом напряжении поэтому в качестве платы управления мы можем использовать небольшой H-мост. Мы используем [двухканальный H-мост](prod://troyka-h-bridge-dual) в формате Troyka-модуля. Этот модуль разработан для управления двумя DC моторами с максимальным током до 1,2 А на канал.

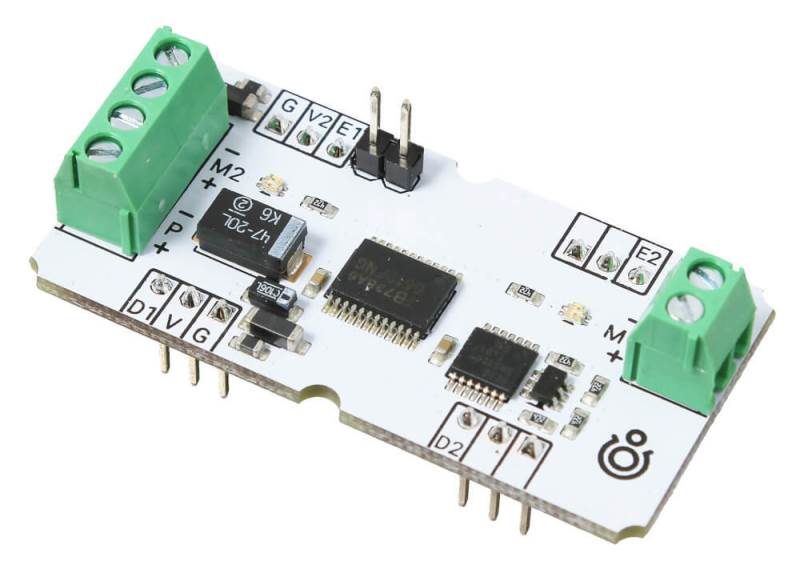
[picture p79: ARTICLE_RU/media/part_8/prod/part_8_prod_electronics_1.jpg]


Мы также используем адаптер [Troyka Pad 1×2](prod://troyka-pad-1x2) для более удобного подключения Troyka модулей. С помощью адаптера мы можем прикрепить двухканальный H-мост к нашей панели электроники. На панели мы зарнее предусмотрели монтажные отверстия для двухюнитого Troyka Pad.

Закрепляем модуль на панели:

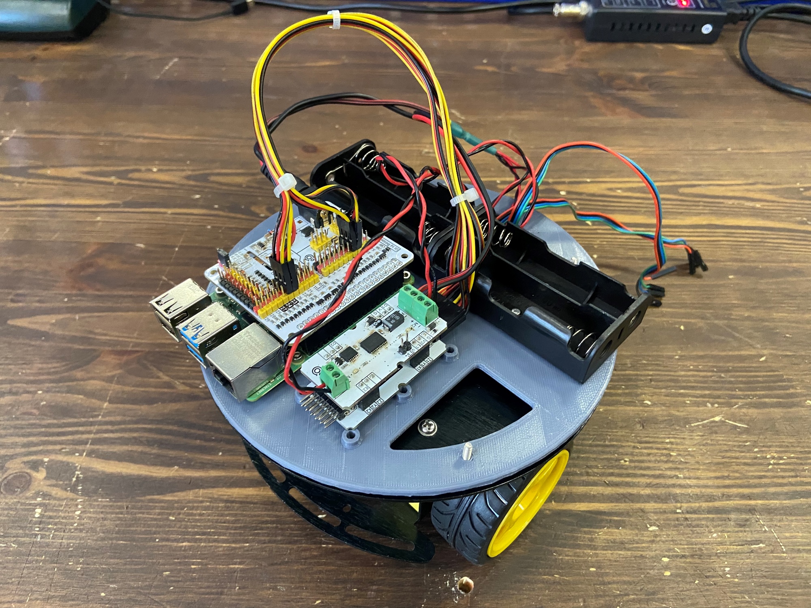
[picture p80: ARTICLE_RU/media/part_8/irl/part_8_irl_electronics_1.jpg]


Два контакта - D и E, управляют одним каналом двигателя. Вывод E (Enable) принимает ШИМ сигнал который отвечает за скорость вращения двигателя. Вывод D (Направление) принимает логический (HIGH или LOW) сигнал для задания направления вращения. Всего нужно четыре контакта для управления двумя DC моторами. 

#### Схема подключения моторов

Raspberry Pi 4B может генерировать аппаратный ШИМ-сигнал только на двух каналах `PWM0` и `PWM1`. Эти каналы мы и будем использовать. Кроме аппаратного, Raspberry может генерировать программный ШИМ-сигнал на любом из своих выводов, но такой сигнал будет потреблять значительную часть вычислительной мощности. Канал `PWM0` может быть назначен на Broadcom вывод `BCM 12` (пин 26 для WiringPi) или `BCM 18` (пин 1 для WiringPi). Канал `PWM1` может быть назначен на вывод Broadcom `BCM 13` (пин 23 для WiringPi) или `BCM 19` (пин 24 для WiringPi). Логические контакты для управления направлением вращения моторов можно подлючить к любым пинам Raspberry.

Мы подключили левый двигатель к WiringPi контактам 7 и 1, а правый двигатель к WiringPi контактам 12 и 13:

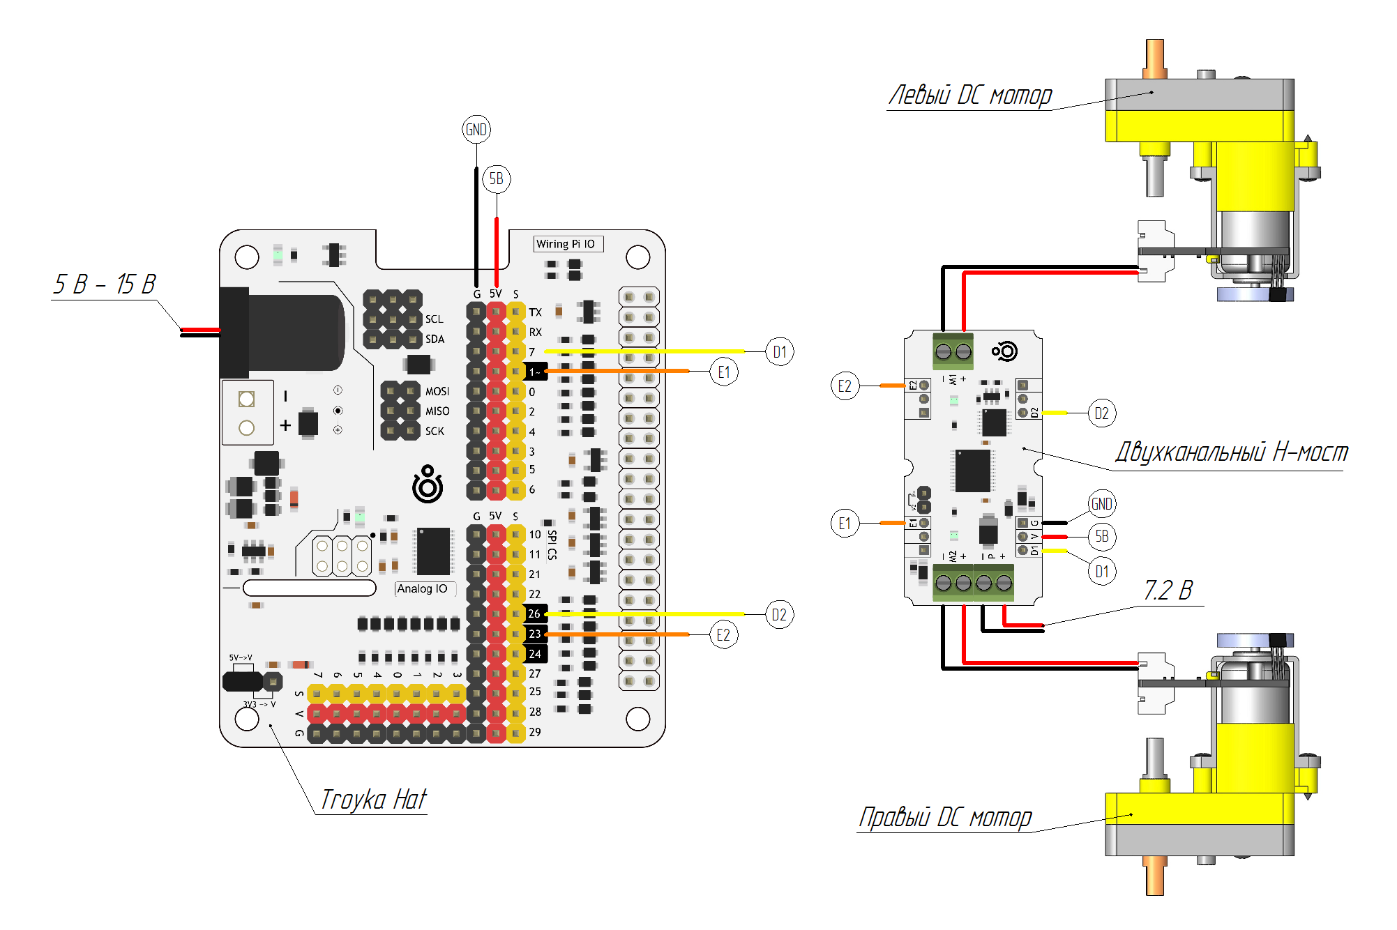
[picture p81: ARTICLE_RU/media/part_8/schemes/part_8_schemes_2.png]


#### Класс DCMotor

Напишем простой С++ класс для управления двигателем постоянного тока на ROS и Raspberry через H-мост.

Вал двигателя может вращаться `cw` - clockwise (по часовой стрелке), `ccw` - counter clockwise (против часовой стрелки) или остановиться  - `stop`. Разрешение аппаратного ШИМ Raspberry составляет 10 бит (максимальное значение - `1023`).

Создим заголовочный файл C++ `dc_motor_wiring_pi.hpp` и поместим его в папку `abot_driver/src`.

```cpp
#ifndef DC_MOTOR_WIRING_PI_HPP_
#define DC_MOTOR_WIRING_PI_HPP_

#include <ros/ros.h>
#include <wiringPi.h>

#define RPI_MAX_PWM_VALUE 1023

class DCMotorWiringPi {
public:
    DCMotorWiringPi(int8_t direction_pin, int8_t enable_pin);
    void cw(uint16_t val);
    void ccw(uint16_t val);
    void stop();
private:
    int8_t _direction_pin;
    int8_t _enable_pin;
    uint16_t protectOutput(uint16_t val);
};

DCMotorWiringPi::DCMotorWiringPi(int8_t direction_pin, int8_t enable_pin) {
    _direction_pin = direction_pin;
    _enable_pin = enable_pin;
    if (wiringPiSetupGpio() < 0) {
        ROS_ERROR("DCMotor wiringPi error: GPIO setup error");
        throw std::runtime_error("");
    }
    ROS_INFO("DCMotor wiringPi: GPIO setup");
    pinMode(_direction_pin, OUTPUT);
    pinMode(_enable_pin, PWM_OUTPUT);
    stop();
    ROS_INFO("DCMotor wiringPi: Motor setup");
}

void DCMotorWiringPi::stop() {
    pwmWrite(_enable_pin, 0);
    digitalWrite(_direction_pin, 0);
}

void DCMotorWiringPi::cw(uint16_t val) {
    pwmWrite(_enable_pin, protectOutput(val));
    digitalWrite(_direction_pin, 1);
}

void DCMotorWiringPi::ccw(uint16_t val) {
    pwmWrite(_enable_pin, protectOutput(val));
    digitalWrite(_direction_pin, 0);
}

uint16_t DCMotorWiringPi::protectOutput(uint16_t val) {
    return val > RPI_MAX_PWM_VALUE ? RPI_MAX_PWM_VALUE : val;
}

#endif // DC_MOTOR_WIRING_PI_HPP_
```

#### PID-контроллер

Для управления скоростью вращения колес мы будем использовать [PID-контроллер](мhttps://ru.wikipedia.org/wiki/ПИД-регулятор). Каждому колесу будет присвоен свой PID-контроллер. Задача PID-контроллера - поддержание необходимой скорости вращения колеса.

Реализацию программы PID-контроллера писать самим не обязательно, в ROS уже есть готовый пакет - [`pid`](http://wiki.ros.org/pid).

Установим ROS пакет `pid` на Raspberry:

```bash
sudo apt-get install ros-noetic-pid
```

Принцип действия PID-контроллера для колеса нашего робота:

- На вход PID-контроллера (Input или State) поступает текущая скорость вращения колеса (в радианах в секунду). Текущая скорость вращения считается нодой энкодеров и публикуюется в топики `/abot/right_wheel/current_velocity` и `/abot/left_wheel/current_velocity`.
- Целью PID-контроллера (Setpoint) является поддержание требуемой скорости вращения колеса (в радианах в секунду). Нужную нам скорость вращения мы будем публиковать в топики `/abot/right_wheel/target_velocity` и `/abot/left_wheel/target_velocity`.
- На выходе PID-контроллера (Output или Сontrol effort) будет величина ШИМ которую нужно подать на H-мост для коррекции скорости вращения. Значения ШИМ будем публиковать в топики `/abot/right_wheel/pwm` и `/abot/left_wheel/pwm`.

Настроим два PID-контроллера для левого и правого колеса.

В пакете `abot_driver` создадим папку `launch`. В этой папке создадим новый файл `abot_pid.launch` для запуска двух нод `controller` из пакета `pid`.

```xml
<launch>
    <node name="controller" pkg="pid" type="controller" ns="/abot/left_wheel" output="screen" >
        <param name="node_name" value="left_wheel_pid" />
        <param name="Kp" value="1.0" />
        <param name="Ki" value="0.0" />
        <param name="Kd" value="0.0" />
        <param name="upper_limit" value="10.23" />
        <param name="lower_limit" value="-10.23" />
        <param name="windup_limit" value="10.23" />
        <param name="max_loop_frequency" value="100.0" />
        <param name="min_loop_frequency" value="100.0" />
        <remap from="/abot/left_wheel/setpoint" to="/abot/left_wheel/target_velocity" />
        <remap from="/abot/left_wheel/state" to="/abot/left_wheel/current_velocity" />
        <remap from="/abot/left_wheel/control_effort" to="/abot/left_wheel/pwm" />
    </node>
    <node name="controller" pkg="pid" type="controller" ns="/abot/right_wheel" output="screen" >
        <param name="node_name" value="right_wheel_pid" />
        <param name="Kp" value="1.0" />
        <param name="Ki" value="0.0" />
        <param name="Kd" value="0.0" />
        <param name="upper_limit" value="10.23" />
        <param name="lower_limit" value="-10.23" />
        <param name="windup_limit" value="10.23" />
        <param name="max_loop_frequency" value="100.0" />
        <param name="min_loop_frequency" value="100.0" />
        <remap from="/abot/right_wheel/setpoint" to="/abot/right_wheel/target_velocity" />
        <remap from="/abot/right_wheel/state" to="/abot/right_wheel/current_velocity" />
        <remap from="/abot/right_wheel/control_effort" to="/abot/right_wheel/pwm" />
    </node>
</launch>
```

Этим файлом мы запустим две ноды PID-контроллера. Эти ноды подписываются на топики `/abot/right_wheel/target_velocity`, `/abot/left_wheel/target_velocity`, `/abot/right_wheel/current_velocity` и `/abot/left_wheel/current_velocity`.

Оба PID-контроллера работают с частотой в 100 герц (за это отвечают параметры `min_loop_frequency` и `max_loop_frequency`). Для корректировки скорости наши PID-контроллеры публикуют значения ШИМ в топики `/abot/right_wheel/pwm` и `/abot/left_wheel/pwm`. 

***Важно*** Значения ШИМ находятся в диапазоне от [-10.23 , 10.23]. Мы решили отправлять значения ШИМ именно в таком диапазоне, а не в диапазоне от [-1023 , 1023]. Это обусловлено особенностями подбора коэффициентов контроллера - `Kp`, `Ki`, `Kd` в ROS пакете `pid`. По нашему опыту, в ROS не очень часто можно встретить целочисленные значения. Большинство ROS нод обмениваются сообщениями со значениями типа [floating-point (с_плавающей_запятой)](https://ru.wikipedia.org/wiki/Число_с_плавающей_запятой) и в диапазоне от [-1.0 , 1.0]. 

На этом этапе мы задаем стандартные значения коэффициентов `Kp`, `Ki`, `Kd`. Настраивать коэффициенты будем чуть позже.

#### Нода моторов

Теперь мы можем написать окончательную ROS ноду для моторов робота. Назовем ее `dc_motors`.

Создадим файл `dc_motors.cpp` в папке `about_driver/src`.

Как будет работать нода моторов? Нода подписывается на два топика ROS - `/abot/right_wheel/pwm` и `/abot/left_wheel/pwm`. Через эти топики нода получает сообщения типа `std_msgs/Float64`. Эти сообщения содержат значения ШИМ сигналов коррекции скоростей в диапазоне [-10.23 , 10.23]. Далее эти значения умножаются на 100 и отправляются на H-мосты через обьекты класса `DCMotorWiringPi`.

```cpp
#include "dc_motor_wiring_pi.hpp"
#include <std_msgs/Float64.h>

#define MOTOR_1_PIN_D 4     // Wiring pi 7 = BCM 4
#define MOTOR_1_PIN_E 18    // Wiring pi 1 = BCM 18
#define MOTOR_2_PIN_D 12    // Wiring pi 26 = BCM 12
#define MOTOR_2_PIN_E 13    // Wiring pi 23 = BCM 13

DCMotorWiringPi left_dc_motor(MOTOR_1_PIN_D, MOTOR_1_PIN_E);
DCMotorWiringPi right_dc_motor(MOTOR_2_PIN_D, MOTOR_2_PIN_E);

void leftMotorCallback(const std_msgs::Float64& msg) {
    int16_t pwm = msg.data * 100;
    if (pwm > 0) {
        left_dc_motor.ccw(abs(pwm));
    } else if (pwm < 0) {
        left_dc_motor.cw(abs(pwm));
    } else if (pwm == 0) {
        left_dc_motor.stop();
    }
}

void rightMotorCallback(const std_msgs::Float64& msg) {
    int16_t pwm = msg.data * 100;
    if (pwm > 0) {
        right_dc_motor.ccw(abs(pwm));
    } else if (pwm < 0) {
        right_dc_motor.cw(abs(pwm));
    } else if (pwm == 0) {
        right_dc_motor.stop();
    }
}

int main(int argc, char **argv) {
    ros::init(argc, argv, "dc_motors");
    ros::NodeHandle node;
    ros::Subscriber left_motor_target_vel_sub = node.subscribe("/abot/left_wheel/pwm", 1, &leftMotorCallback);
    ros::Subscriber right_motor_target_vel_sub = node.subscribe("/abot/right_wheel/pwm", 1, &rightMotorCallback);
    ros::spin();
    return 0;
}
```

Добавим новый исполняемый файл в правило сборки `CMakelists.txt` в нашем пакете `abot_driver`.

```makefile
add_executable(dc_motors src/dc_motors.cpp)
target_link_libraries(dc_motors ${catkin_LIBRARIES} -lwiringPi -lpthread -lcrypt -lm -lrt)
```

Собремем пакет `abot_driver` с новой нодой:

```bash
cd ~/ros
catkin_make
```

### Запуск драйверов

Отлично! Наши драйверы готовы.

Давайте создадим новый файл запуска для всех созданных нод чтобы нам не приходилось каждый раз запускать все драйверы вручную. 

В пакете `abot_driver` в папке `launch` создадим файл запуска `abot_drivers.launch`. В нем запустим созданные нами ноды а так же включим файл запуска PID-контроллеров:

```xml
<launch>
    <node name="encoders" pkg="abot_driver" type="encoders" output="screen" />
    <node name="dc_motors" pkg="abot_driver" type="dc_motors" output="screen" />
    <include file="$(find abot_driver)/launch/abot_pid.launch" />
</launch>
```

Теперь мы можем запускать все наши драйверы одновременно и одной командой. Запустим драйверы на Raspberry:

```bash
su root
source devel/setup.bash
roslaunch abot_driver abot_drivers.launch
```

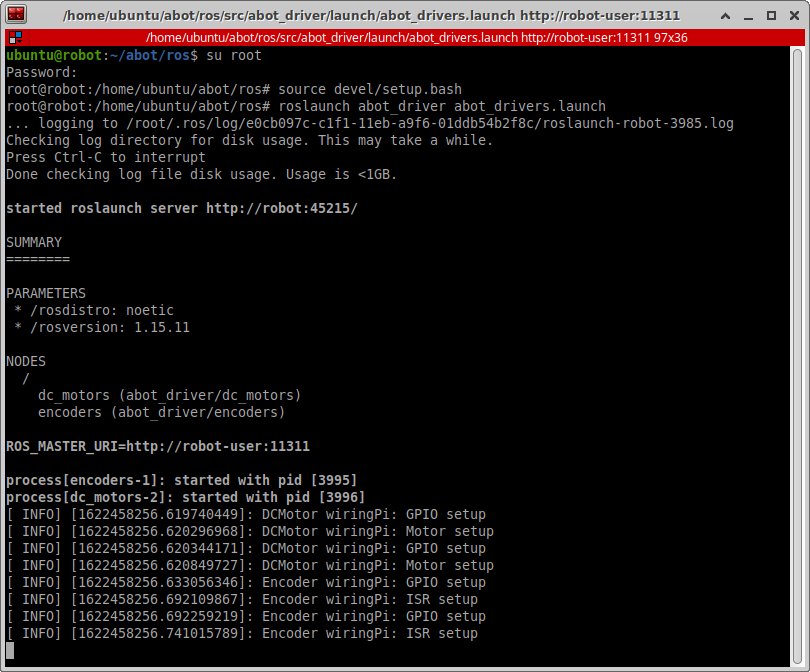
[picture p82: ARTICLE_RU/media/part_8/rpi_side/part_8_rpi_side_screen_5.png]


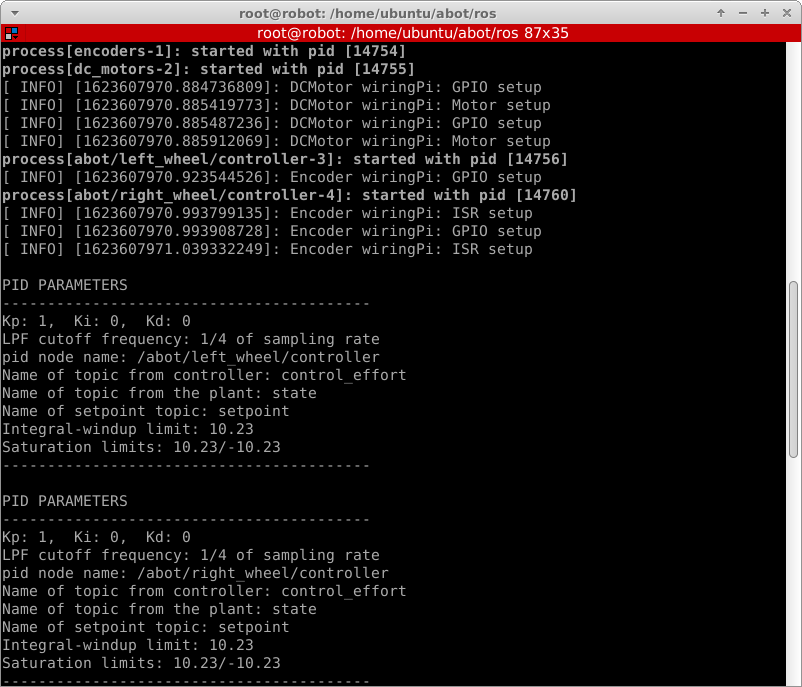
[picture p83: ARTICLE_RU/media/part_8/rpi_side/part_8_rpi_side_screen_6.png]


На настольном компьютере проверяем что появились топики от обоих драйверов и от PID-контроллеров:

```bash
rostopic list
```

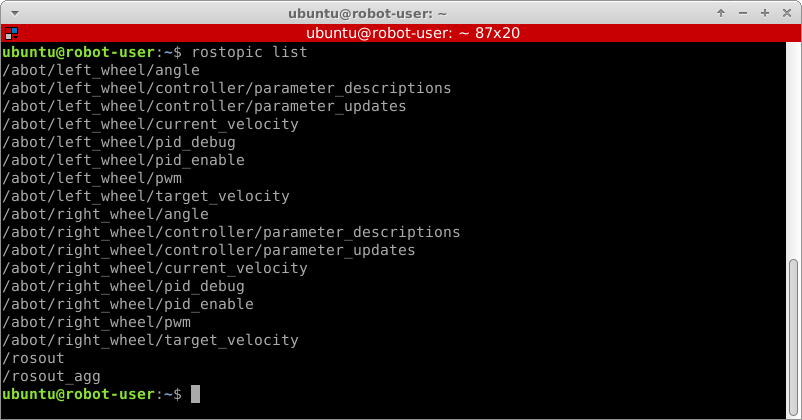
[picture p84: ARTICLE_RU/media/part_8/desk_side/part_8_desk_side_screen_2.png]


### Тест моторов и настройка параметров PID-контроллера

Протестируем как работают наши моторы. И настроим коэффициенты PID-контроллеров.

На Raspberry в первом терминале запустим все наши драйверы под пользователем `root`:

```bash
cd ~/ros
su root
source devel/setup.bash
roslaunch abot_driver abot_drivers.launch
```

Чтобы публиковать значения в топики вручную через терминалы, используем ROS утилиту [`rqt`](http://wiki.ros.org/rqt).

`rqt` это святая святых любого разработчика под ROS. Набор плагинов `rqt` предоставляет графический интерфейс для взаимодействия пользователя с нодами и топиками, мониторинга, визуализации графов зависиомостей и много чего еще.

На настольном компьютере, в новом терминале вводим:

```bash
rqt
```

Перед нами появится окно `rqt`.

Сперва откроем плагин для публикации сообщений в топик. Нажмем **Plugins → Topics → Message Publisher**. В появившимся окне добавим два наших топика задания скоростей - `/abot/left_wheel/target_velocity` и `/abot/right_wheel/target_velocity`. В эти топики будем публиковать сообщения типа `std_msgs/Float64`. В столбце `rate` установим частоту публикации сообщений в 100 герц. Для запуска процесса публикации нужно установить галочку слева от имени топика.



Теперь откроем плагин для просмотра сообщений в топике. Нажмем **Plugins → Visualisation → Plot**. Данный плагин отслеживает значения в указанных топиках и строит график изменения этих значений в реальном времени. Например для отслеживания скоростей левого колеса добавим два наших скоростей - `/abot/left_wheel/target_velocity` и `/abot/left_wheel/current_velocity`.

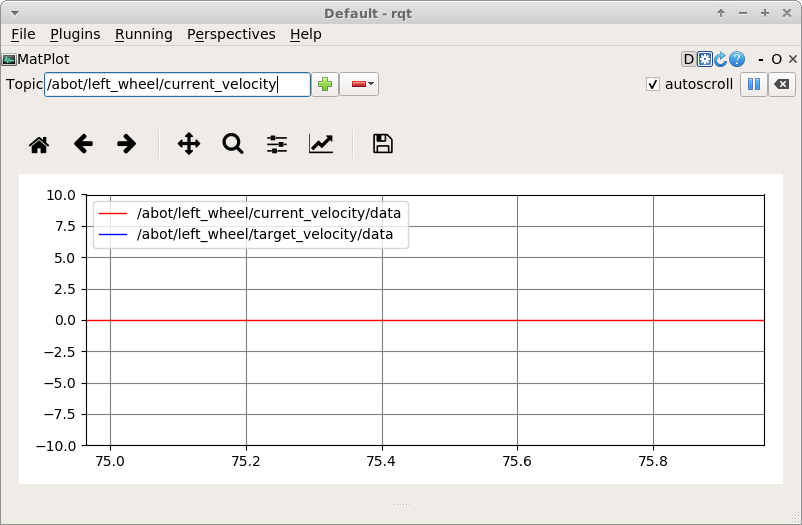
[picture p85: ARTICLE_RU/media/part_8/desk_side/part_8_desk_side_screen_4.png]


Еще откроем плагин для настройки коэффициентов PID-контроллера в реальном времени. Нажмем **Plugins → Dynamic Reconfigure**.

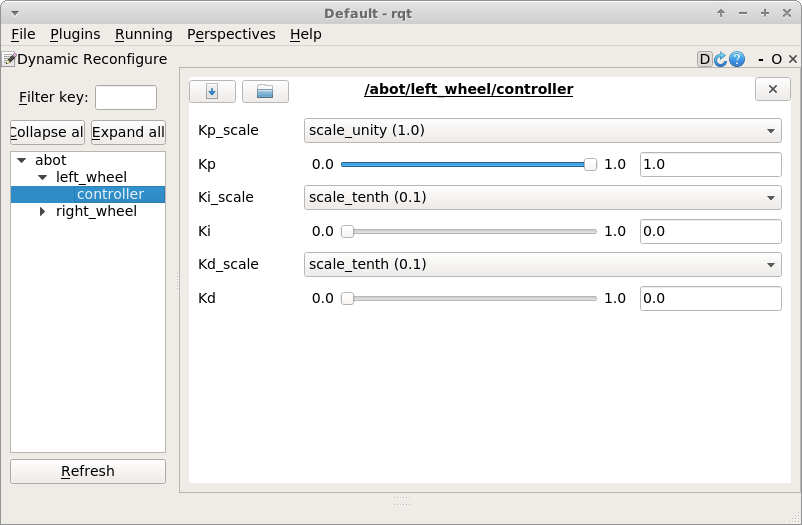
[picture p86: ARTICLE_RU/media/part_8/desk_side/part_8_desk_side_screen_5.png]


На этом шаге вам нужно скоректировать коэффициенты обоих PID-контроллеров. Нужно добиться того чтобы колесо вращалось именно с заданной скоростью. Так же желательно добиться плавной регулировки скорости, без резких разгонов и торможений. Чем больше дейстительная скорость вращения соответствует реальной тем легче будет реальзовать навигацию робота.

Оперируем значениями в топиках `/abot/left_wheel/target_velocity`, `/abot/right_wheel/target_velocity` и коэффициентами PID-контроллеров и наблюдаем за скоростями вращения колес `/abot/right_wheel/сurrent_velocity` и `/abot/left_wheel/сurrent_velocity`.

<iframe width="1280"
        height="720"
        src="https://www.youtube.com/embed/YhNl_YzcEuA"
        title="Abot. Motors test."
        frameborder="0"
        class="article__cover-youtube"
        allowfullscreen="">
</iframe>

## Контроль движения

Сейчас мы можем управлять колесами робота отдельно, а так же узнать скорость их вращения и поддерживать ее. Теперь нам нужно создать контроллер, который будет оперировать скоростью движения всего робота, то есть управлять его приводом.

### Пакет robot_control

В ROS есть много готовых контроллеров - [`ros_controllers`](http://wiki.ros.org/ros_controllers?distro=noetic). Ознакомьтесь с ними.

Шасси нашего робота представляет собой дифференциальный двухколесный привод. Для этого типа привода есть готовое решение - контроллер [`diff_drive_controller`](http://wiki.ros.org/diff_drive_controller). Это означает, что нам не нужно будет писать алгоритм получения скоростей дифференциального привода.

Традиционно в ROS пакет с контроллерами робота называют `robot_control`. Мы назовем наш пакет `abot_control`.

Cоздим новый пакет с именем `abot_control` в рабочей области `ros` нашего проекта. Этот пакет будет хранить описание контроллеров нашего робота. Для пакета установим следующие пакеты-зависимости:

- [`controller_manager`](http://wiki.ros.org/controller_manager)
- [`hardware_interface`](http://wiki.ros.org/hardware_interface?distro=noetic)
- [`trajectory_msgs`](http://wiki.ros.org/trajectory_msgs)
- [`ros_controllers`](http://wiki.ros.org/ros_controllers)
- [`joint_state_controller`](http://wiki.ros.org/joint_state_controller)
- [`robot_state_publisher`](http://wiki.ros.org/robot_state_publisher).

#### Настройки контроллеров робота

В созданном пакете `abot_control` создим папку `config` а в ней файл `abot_controllers.yaml`. Этот файл будет хранить настройки контроллеров нашего робота. В ROS файлы настроек контроллеров традиционно имеют формат *.yaml.

Сперва у нашего робота будет два контроллера.

Первый контроллер - это контроллер типа `joint_state_controller/JointStateController`. Он отвечает за обновление положений всех сочленений (`joints`) вашего робота на параметрическом сервере ROS.

Любому используемому контроллеру нужно дать имя. Мы назвали этот первый контроллер `joint_state_controller`.

Контроллер имеет один единственный параметр - частоту обновления положений сочленений - `publish_rate`. Установим частоту обновления в `100` герц.

```yaml
joint_state_controller:
  type: joint_state_controller/JointStateController
  publish_rate: 100
```

Второй контроллер - это контроллер типа `diff_drive_controller/DiffDriveController`. Мы назвали его `mobile_abot`.

Этот тип контроллера, непосредственно отвечает за движение двухколесного робота. Как это работает? Мы даем контроллеру входные данные. Например, мы хотим чтобы робот ехал с линейной скоростью в 1 м/c и угловой скростью в 2 рад/c. Но не знаем какие при этом должны быть скороти колес. Контроллер берет эти входные данные, так же он берет значения текущих скоростей и положение робота полученный с одометрии, обрабатывает все это и на выходе отдает необходимые угловые скорости вращения колес чтобы наш робот двигался именно таким образом.

В ROS движение робота конвенционально осуществляется через топики, которые обмениваются сообщения типа `geometry_msgs/Twist`. Сообщение этого типа состоит из двух векторов `linear` и `angular` типа `geometry_msgs/Vector3`. Каждый такой вектор - трехмерный. Вектор `geometry_msgs/Vector3 linear` описывает линейные скорости робота вдоль осей X Y Z в глобальной системе координат. Вектор `geometry_msgs/Vector3 angular` представляет скорость вращения робота вокруг осей X Y Z.

Наш двухколесный дифференциальный привод обладает неголономным движением. Этот привод контролируется только линейной скростью по оси X и угловой скоростью вокруг оси Z. Таким образом наш вектор скорости `linear` будет всегда иметь нулевые линейные скорости по осям Y и Z и нулевые угловые скорости вокруг осей X и Y.

Принцип работы этого контроллера. Мы будем отправлять желаемые векторы скорости робота в топик `/cmd_vel`. Контроллер будет анализировать полученные векторы, вычислять необходимые скорости вращения правого и левого колес и отправлять рассчитанные значения в топики моторов левого и правого колеса. Одновременно с этим, контроллер будет считывает текущие углы поворота колес и вычислять текущую траекторию и одометрию робота. Сообщения об одометрии имеют тип `nav_msgs/Odometry` и публикуются в топик `/odom`.

В отличии от первого нашего котроллера, этот имеет множество параметров, но вы можете настроить только основные из них. Вам необходимо указать:

- Имена сочленений из описания робота для правого и левого колеса - `left_wheel` и `right_wheel`. У нас это `left_wheel_to_base` и `right_wheel_to_base`.
- Имя базового сегмента робота - `base_frame_id`. У нас это `base_footprint`.
- Максимальную линейную скорость и ускорение робота робота вдоль оси X, а также максимальную угловую скорость и ускорение робота вокруг оси Z. Минимальные значения этих скоростей можно не указывать, по умолчанию они равны максильным с противоположным знаком.
- Матрицы смещения `twist_covariance_diagonal` и `pose_covariance_diagonal` для одометрии. Эти параметры можно оставить по умолчанию.

***Важно*** Откуда можно узнать максимальные значения скоростей и ускорений робота? Эти параметры - расчетные. Например, максимальную линейную скорость робота по оси Х легко вычислить замерив пройденный путь колеса при максимальной скорости вращения. Тем не менее точный расчет максимальных скоростей а ососбенно ускорений робота это трудная математическая задача и для ее решения пришлось бы написать десяток тестов. Мы же только новички в робототехнике поэтому максимальные скорости будем вычислять эмпирически.

Сперва мы установили все скорости и ускорения равными нулю а затем постепенно увеличивали их и наблюдали за поведением робота во время отладки. Не стоит задавать слишком большие значения скоростей и ускорений. Так же стоит помнить о том что робот не сможет двигаться со скоростью выше чем та что указана в файле конфигурации контроллера. Нужно найти золотую середину.

Мы установили частоту работы контроллера в `100` герц а наши максимальные скорости и ускорения выглядят следующим образом:

```yaml
mobile_abot:
  type : "diff_drive_controller/DiffDriveController"
  left_wheel: 'left_wheel_to_base'
  right_wheel: 'right_wheel_to_base'
  publish_rate: 100.0
  pose_covariance_diagonal: [0.001, 0.001, 1000000.0, 1000000.0, 1000000.0, 1000.0]
  twist_covariance_diagonal: [0.001, 0.001, 1000000.0, 1000000.0, 1000000.0, 1000.0]
  wheel_separation_multiplier: 1.0 # default: 1.0
  wheel_radius_multiplier    : 1.0 # default: 1.0
  cmd_vel_timeout: 0.1
  base_frame_id: base_footprint
  linear:
    x:
      has_velocity_limits : true
      max_velocity : 0.6 # m/s
      has_acceleration_limits: true
      max_acceleration : 6.0 # m/s^2
  angular:
    z:
      has_velocity_limits : true
      max_velocity : 4.71 # rad/s
      has_acceleration_limits: true
      max_acceleration : 9.42 # rad/s^2
  enable_odom_tf: true
```

#### Настраиваем описания робота для контроллера

Для правильного расчета скоростей и одометрии контроллеру необходимы еще два параметра: радиус колеса - `wheel_radius` и расстояние между колесами - `wheel_separation`. По умолчанию контроллер ищет эти параметры в описании робота `robot_description` а нашем случае в `abot_description`.

Кроме этого, нам необходимо внести некоторые радикальные изменения в описание робота. В настройках контроллера `mobile_abot` мы указали имена сочленений колес. Однако контроллер типа `diff_drive_controller/DiffDriveController` ожидает что сегменты колес, прикрепленные к этим сочленениям, имеют круглую форму.

Сейчас в описании нашего робота левое и правое колесо представлены в виде 3D модели взятой из .STL файла. Колесо круглой формы из .STL файла является лишь набором полигонов. Контроллеру же нужна точная геометрия колеса, то есть колесо должно быть описано математически.

Для этого мы создим еще два сегмента в URDF описании `abot_description`. Назовем их `left_wheel` и `right_wheel`. В этих сегментах мы опишем визуальную составлящую `<visual>` не 3D моделью а геометрией `<geometry>`. Теперь сочленения `left_wheel_to_base` и `right_wheel_to_base` будут вести к этим двум новым сегментам колес. Старые сегменты с 3D моделями мы не будем удалять а оставим их зафиксированными на новых. Новые сегменты колес описываем как цилиндры (`<cylinder>`) высотой 26 мм и радиусом 32,5 мм.

Вносим изменения в файл описания `abot.xacro`:

```xml
<xacro:property name="wheel_radius" value="0.0325"/>
<xacro:property name="wheel_separation" value="0.128"/>
<xacro:property name="wheel_width" value="0.026"/>
<xacro:property name="PI" value="3.1415926"/>
```

В описание левого колеса:

```xml
<link name="left_wheel">
	<visual>
		<origin xyz="0 0 0" rpy="${PI/2} 0 0" />
		<geometry>
			<cylinder length="${wheel_width}" radius="${wheel_radius}"/>
		</geometry>
		<material name="Green" />
	</visual>
	<collision>
		<origin xyz="0 0 0" rpy="${PI/2} 0 0" />
		<geometry>
			<cylinder length="${wheel_width}" radius="${wheel_radius}"/>
		</geometry>
	</collision>
</link>
<joint name="left_wheel_to_abot_left_wheel" type="fixed">
	<origin xyz="0 0 0" rpy="0 0 0" />
	<parent link="left_wheel" />
	<child link="abot_left_wheel" />
</joint>
<joint name="left_wheel_to_base" type="continuous">
	<origin xyz="0 0.068 0.0145" rpy="0 0 0" />
	<parent link="abot_base" />
	<child link="left_wheel" />
	<axis xyz="0 1 0" />
</joint>
```

В описание правого колеса:

```xml
<link name="right_wheel">
	<visual>
		<origin xyz="0 0 0" rpy="${PI/2} 0 0" />
		<geometry>
			<cylinder length="${wheel_width}" radius="${wheel_radius}"/>
		</geometry>
		<material name="Green" />
	</visual>
	<collision>
		<origin xyz="0 0 0" rpy="${PI/2} 0 0" />
		<geometry>
			<cylinder length="${wheel_width}" radius="${wheel_radius}"/>
		</geometry>
	</collision>
</link>
<joint name="right_wheel_to_abot_right_wheel" type="fixed">
	<origin xyz="0 0 0" rpy="0 0 0" />
	<parent link="right_wheel" />
	<child link="abot_right_wheel" />
</joint>
<joint name="right_wheel_to_base" type="continuous">
	<origin xyz="0 -0.068 0.0145" rpy="0 0 0" />
	<parent link="abot_base" />
	<child link="right_wheel" />
	<axis xyz="0 1 0" />
</joint>
```

Дерево нашей модели теперь выглядит подобным образом:

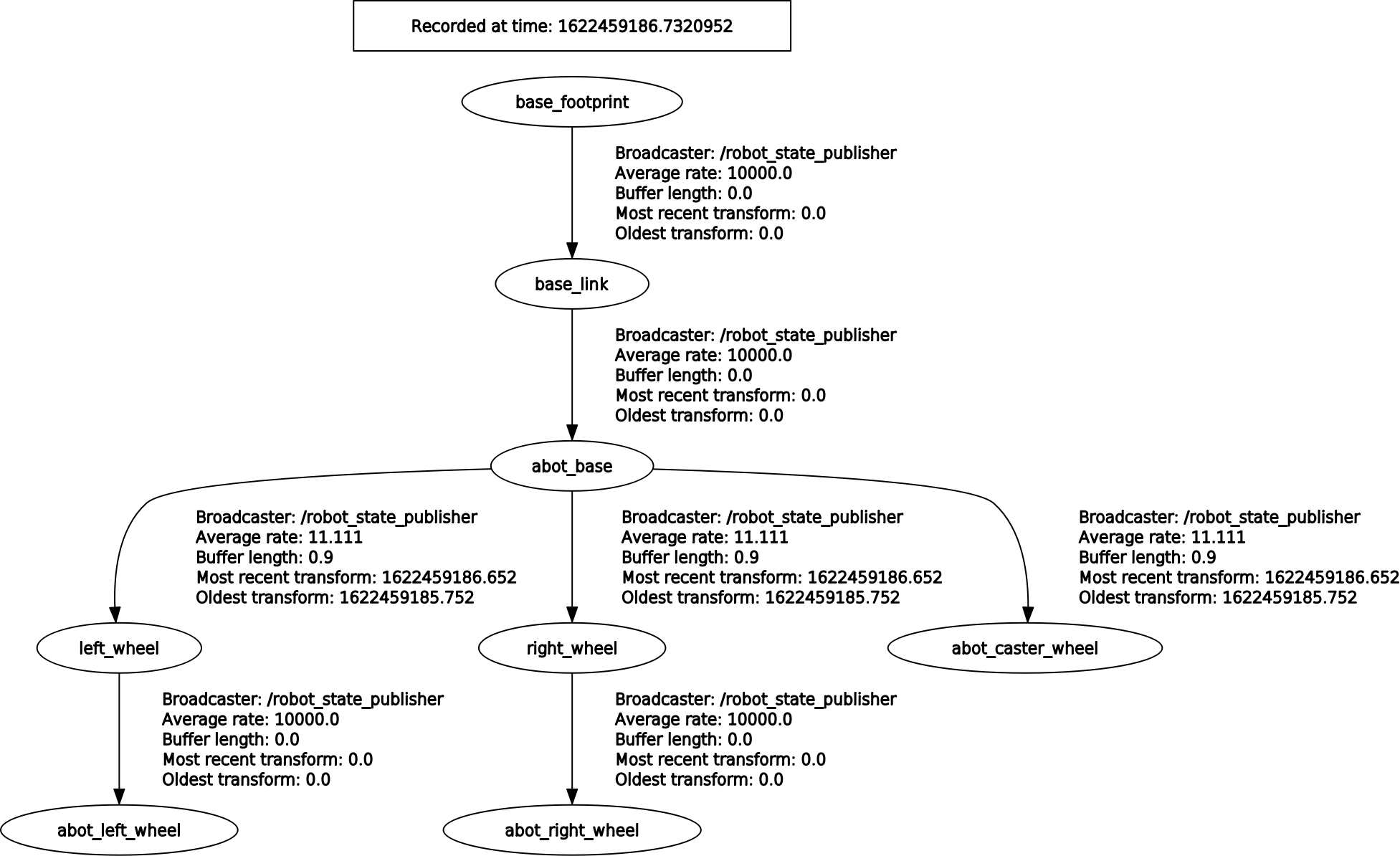
[picture p87: ARTICLE_RU/media/part_9/rqt/part_9_rqt_screen_1.png]


#### Запуск контроллеров

Для запуска контроллеров создадим новый файл запуска. Все контроллеры будем запускать одновременно.

В пакете `abot_control` создадим папку `launch` а в ней новый файл запуска `abot_control.launch`.

В новом файле запуска мы загрузим на параметрический сервер ROS параметры наших контроллеров из файла `abot_controllers.yaml` и запустим ноду менеджер контроллеров - `controller_spawner`:

```xml
<launch>
	<rosparam file="$(find abot_control)/config/abot_controllers.yaml" command="load"/>
	<node name="controller_spawner" pkg="controller_manager" type="spawner" respawn="false" output="screen"
		args="joint_state_controller mobile_abot"></node>
</launch>
```

### Пакет robot_base

Мы создали два контроллера и два драйвера. Контроллеры которые мы создали, полностью настроены и готовы к работе, но они не знают с чем именно им нужно работать. Мы должны соединить наши контроллеры с нашими драйверами. Для этого нам нужно написать так называемый [hardware interface](http://wiki.ros.org/hardware_interface). С помощью этого интерфейса мы подключим низкоуровневые драйверы нашего конкретного робота к ROS инфраструктуре более высокого уровня.

Традиционно в ROS для описания `hardware interface` используется пакет с именем `robot_base`. Нашу пакет уже по привычке называем `abot_base`.

Создаем в рабочем пространстве новый пакет `abot_base`.

В качестве пакетов зависимостей устанавливаем:

- [`controller_manager`](http://wiki.ros.org/controller_manager)
- [`hardware_interface`](http://wiki.ros.org/hardware_interface?distro=noetic)
- [`trajectory_msgs`](http://wiki.ros.org/trajectory_msgs)
- [`roscpp`](http://wiki.ros.org/roscpp)
- `diff_drive_controller`

#### Класс AbotHardwareInterface

В пакете `abot_base` необходимо создать определенный класс C++, наследник С++ класса `hardware_interface::RobotHW` пакета `hardware_interface` в ROS. Это обязательное условие. Подробнее вы можете прочитать в [вики на пакет ros_controls](https://github.com/ros-controls/ros_control/wiki). Данный класс-наследник должен регистрировать все описанные контроллеры робота и взаимодествовать с драйверами.

Мы назвали наш класс `AbotHardwareInterface`. Класс подписывается на топики драйверов `/abot/left_wheel_angle` and `/abot/right_wheel_angle` и публикует сообщения в топики `/abot/left_wheel_target_velocity` и `/abot/right_wheel_target_velocity`.

Два главных метода класса это `updateJointsFromHardware` и `writeCommandsToHardware`. Метод `updateJointsFromHardware` обрабатывает текущие углы поворота колес с драйвера, вычислят текущие скорости вращения колес и передает их в наш контроллер `mobile_abot`. С другой стороны метод `writeCommandsToHardware` берет от контроллера `mobile_abot` значения необхоидмых скоростей колес и отправляет их в драйвер.

В пакете `abot_base` создаем папку `src` а в ней новый заголовочный файл C++ `abot_hardware_interface.hpp`.

```cpp

#ifndef ABOT_HARDWARE_INTERFACE_HPP_
#define ABOT_HARDWARE_INTERFACE_HPP_

#include <boost/assign/list_of.hpp>
#include <sstream>
#include <std_msgs/Float64.h>
#include <std_srvs/Empty.h>

#include <controller_manager/controller_manager.h>
#include <hardware_interface/joint_command_interface.h>
#include <hardware_interface/joint_state_interface.h>
#include <hardware_interface/robot_hw.h>
#include <ros/ros.h>
#include <ros/console.h>

class AbotHardwareInterface : public hardware_interface::RobotHW {
public:
    AbotHardwareInterface(ros::NodeHandle node, ros::NodeHandle private_node, double target_max_wheel_angular_speed);

    void updateJointsFromHardware(const ros::Duration& period);
    void writeCommandsToHardware();
private:
    ros::NodeHandle _node;
    ros::NodeHandle _private_node;

    hardware_interface::JointStateInterface _joint_state_interface;
    hardware_interface::VelocityJointInterface _velocity_joint_interface;

    ros::Subscriber _left_wheel_angle_sub;
    ros::Subscriber _right_wheel_angle_sub;
    ros::Publisher _left_wheel_vel_pub;
    ros::Publisher _right_wheel_vel_pub;

    struct Joint {
        double position;
        double position_offset;
        double velocity;
        double effort;
        double velocity_command;

        Joint()
            : position(0)
            , velocity(0)
            , effort(0)
            , velocity_command(0) {}
    } _joints[2];

    double _left_wheel_angle;
    double _right_wheel_angle;
    double _max_wheel_angular_speed;

    void registerControlInterfaces();
    void leftWheelAngleCallback(const std_msgs::Float64& msg);
    void rightWheelAngleCallback(const std_msgs::Float64& msg);
    void limitDifferentialSpeed(double& diff_speed_left_side, double& diff_speed_right_side);
};

AbotHardwareInterface::AbotHardwareInterface(ros::NodeHandle node, ros::NodeHandle private_node, double target_max_wheel_angular_speed)
    : _node(node)
    , _private_node(private_node)
    , _max_wheel_angular_speed(target_max_wheel_angular_speed) {

    registerControlInterfaces();

    _left_wheel_vel_pub = _node.advertise<std_msgs::Float64>("/abot/left_wheel/target_velocity", 1);
    _right_wheel_vel_pub = _node.advertise<std_msgs::Float64>("/abot/right_wheel/target_velocity", 1);
    _left_wheel_angle_sub = _node.subscribe("abot/left_wheel/angle", 1, &AbotHardwareInterface::leftWheelAngleCallback, this);
    _right_wheel_angle_sub = _node.subscribe("abot/right_wheel/angle", 1, &AbotHardwareInterface::rightWheelAngleCallback, this);
}

void AbotHardwareInterface::writeCommandsToHardware() {
    double diff_angle_speed_left = _joints[0].velocity_command;
    double diff_angle_speed_right = _joints[1].velocity_command;

    limitDifferentialSpeed(diff_angle_speed_left, diff_angle_speed_right);

    std_msgs::Float64 left_wheel_vel_msg;
    std_msgs::Float64 right_wheel_vel_msg;

    left_wheel_vel_msg.data = diff_angle_speed_left;
    right_wheel_vel_msg.data = diff_angle_speed_right;

    _left_wheel_vel_pub.publish(left_wheel_vel_msg);
    _right_wheel_vel_pub.publish(right_wheel_vel_msg);
}

void AbotHardwareInterface::updateJointsFromHardware(const ros::Duration& period) {

    double delta_left_wheel = _left_wheel_angle - _joints[0].position - _joints[0].position_offset;
    double delta_right_wheel = _right_wheel_angle - _joints[1].position - _joints[1].position_offset;

    if (std::abs(delta_left_wheel) < 1) {
        _joints[0].position += delta_left_wheel;
        _joints[0].velocity = delta_left_wheel / period.toSec();
    } else {
        _joints[0].position_offset += delta_left_wheel;
    }

    if (std::abs(delta_right_wheel) < 1) {
        _joints[1].position += delta_right_wheel;
        _joints[1].velocity = delta_right_wheel / period.toSec();
    } else {
        _joints[1].position_offset += delta_right_wheel;
    }
}

void AbotHardwareInterface::registerControlInterfaces() {
    ros::V_string joint_names = boost::assign::list_of("left_wheel_to_base")("right_wheel_to_base");

    for (unsigned int i = 0; i < joint_names.size(); i++) {
        hardware_interface::JointStateHandle joint_state_handle(joint_names[i], &_joints[i].position, &_joints[i].velocity, &_joints[i].effort);
        _joint_state_interface.registerHandle(joint_state_handle);

        hardware_interface::JointHandle joint_handle(joint_state_handle, &_joints[i].velocity_command);
        _velocity_joint_interface.registerHandle(joint_handle);
    }
    registerInterface(&_joint_state_interface);
    registerInterface(&_velocity_joint_interface);
}

void AbotHardwareInterface::leftWheelAngleCallback(const std_msgs::Float64& msg) {
    _left_wheel_angle = msg.data;
}

void AbotHardwareInterface::rightWheelAngleCallback(const std_msgs::Float64& msg) {
    _right_wheel_angle = msg.data;
}

void AbotHardwareInterface::limitDifferentialSpeed(double& diff_speed_left_side, double& diff_speed_right_side) {
    double large_speed = std::max(std::abs(diff_speed_left_side), std::abs(diff_speed_right_side));
    if (large_speed >  _max_wheel_angular_speed) {
        diff_speed_left_side *=  _max_wheel_angular_speed / large_speed;
        diff_speed_right_side *=  _max_wheel_angular_speed / large_speed;
    }
}

#endif // ABOT_HARDWARE_INTERFACE_HPP_
```

Весь этот процесс может быть описан классической [теорией управления](https://ru.wikipedia.org/wiki/Теория_управления). У нас есть [контроллер типа closed-loop](https://en.wikipedia.org/wiki/Control_theory#Closed-loop_transfer_function). На входе контроллера - вектора скорости движения робота на плоскости (X, Y). На выходе - требуемая скорость вращения колес для заданной скорости робота. В качестве обратной связи используются текущая скорость вращения колес робота и одометрия.

#### Нода robot_base

Теперь создадим ноду `robot_base` которая запустит наш closed-loop контроллер и свяжет ROS с нашими драйверами. Нашу ноду назовем `abot_base`.

Нода будет принимать два параметра ROS:

- `control_frequency` - частота работа контроллера.
- `max_wheel_angular_speed` - максимальная угловая скрость вращения колеса. Этот параметр нужен чтобы случайно не отправить на драйвер колеса слишком большую скорость вращения.

Контроллер срабатывает по таймеру `control_loop` типа `ros::Timer` с частотой `control_frequency`.

В пакете `abot_base` создаем новый файл `abot_base.cpp`:

```cpp

#include <chrono>
#include <functional>
#include <ros/callback_queue.h>

#include "abot_hardware_interface.h"

typedef boost::chrono::steady_clock time_source;

void controlLoop(AbotHardwareInterface& hardware, controller_manager::ControllerManager& cm, time_source::time_point& last_time) {

    time_source::time_point this_time = time_source::now();
    boost::chrono::duration<double> elapsed_duration = this_time - last_time;
    ros::Duration elapsed(elapsed_duration.count());
    last_time = this_time;

    hardware.updateJointsFromHardware(elapsed);
    cm.update(ros::Time::now(), elapsed);
    hardware.writeCommandsToHardware();
}

int main(int argc, char** argv) {
    ros::init(argc, argv, "abot_base");
    ros::NodeHandle node;
    ros::NodeHandle private_node("~");

    int control_frequency;
    double max_wheel_angular_speed;

    private_node.param<int>("control_frequency", control_frequency, 1);
    private_node.param<double>("max_wheel_angular_speed", max_wheel_angular_speed, 1.0);

    AbotHardwareInterface hardware(node, private_node, max_wheel_angular_speed);

    controller_manager::ControllerManager cm(&hardware, node);

    ros::CallbackQueue abot_queue;
    ros::AsyncSpinner abot_spinner(1, &abot_queue);

    time_source::time_point last_time = time_source::now();

    ros::TimerOptions control_timer(
        ros::Duration(1 / control_frequency),
        boost::bind(controlLoop, std::ref(hardware), std::ref(cm), std::ref(last_time)), &abot_queue);

    ros::Timer control_loop = node.createTimer(control_timer);

    abot_spinner.start();
    ros::spin();
    return 0;
}
```

Не забываем пересобирать наш проект при добавлении в него новых исходных C++ файлов:

```bash
catkin_make
```

#### Запуск ноды robot_base

Создим файл запуска для новой ноды. В пакете `abot_base` создадим папку `launch` а в ней новый файл запуска `abot_base.launch`:

```xml
<launch>
	<node name="abot_base_node" pkg="abot_base" type="abot_base_node" output="screen">
		<param name="control_frequency" type="int" value="100"/>
		<param name="max_wheel_angular_speed" type="double" value="18.0"/>
	</node>
</launch>
```

### Тестируем движение робота

Пришло время проверить движение нашего робота. У нас есть все необходимое для этого.

Давайте создадим новый файл запуска для тестов движения робота. Назовем файл `bringup.launch`. Разместим его в пакете с описанием робота `abot_description`.

***Важно*** Это будет один из наших главных файлов запуска. Сейчас и далее, этот файл мы будем запускать только на Raspberry. ROS ноды запущенные этим файлом должны будут работать только на борту робота!

В этом файле запуска мы:

- Загрузим URDF описание робота на параметрический сервер ROS.
- Запустим драйверы робота.
- Запустим контроллеры робота.
- Запустим ноду `abot_base`.

```xml
<launch>
	<param name="robot_description" command="$(find xacro)/xacro '$(find abot_description)/urdf/abot.xacro' --inorder"/>
	<node name="robot_state_publisher" pkg="robot_state_publisher" type="robot_state_publisher" respawn="false" output="screen" />
	<include file="$(find abot_base)/launch/abot_base.launch" />
	<include file="$(find abot_control)/launch/abot_control.launch" />
	<include file="$(find abot_driver)/launch/abot_drivers.launch" />
</launch>
```

Для теста управлять роботом будем с настольного компьютера через сеть ROS. Убедитесь, что и робот, и настольный компьютер подключены к сети.

На настольном компьютере запускаем ядро ROS:

```bash
roscore
```

Затем на raspberry запускаем файл запуска `bringup.launch`.

```bash
cd ~/ros
su root
source devel/setup.bash
roslaunch abot_description bringup.launch
```

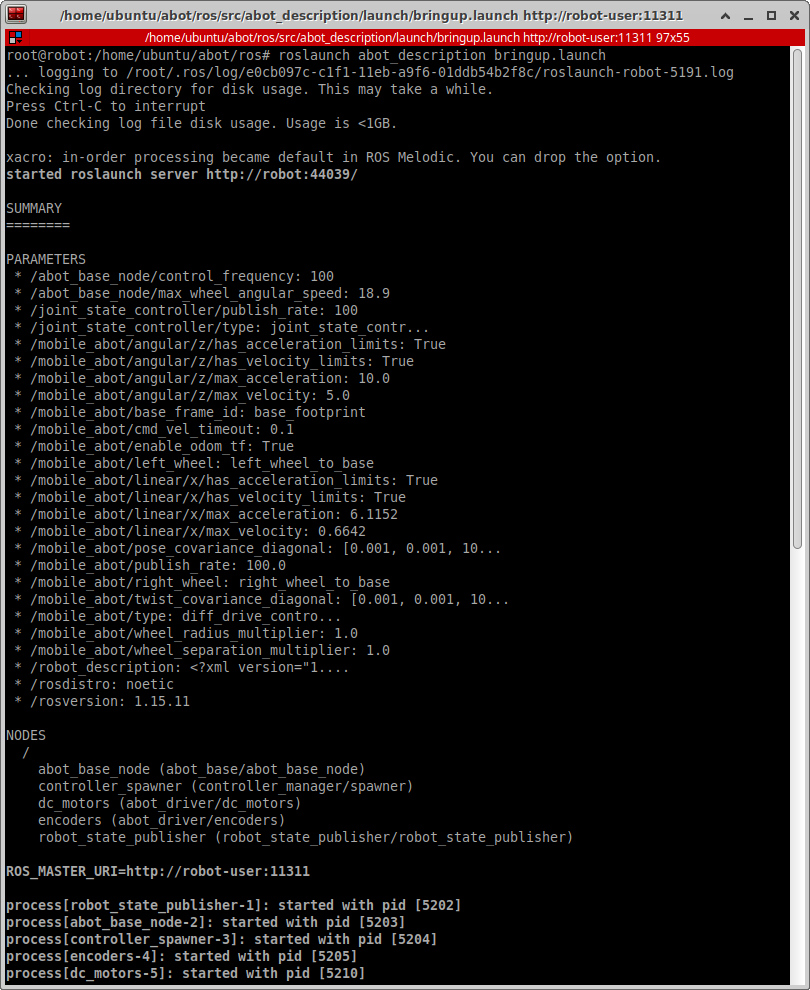
[picture p88: ARTICLE_RU/media/part_9/rpi_side/part_9_rpi_side_screen_1.png]


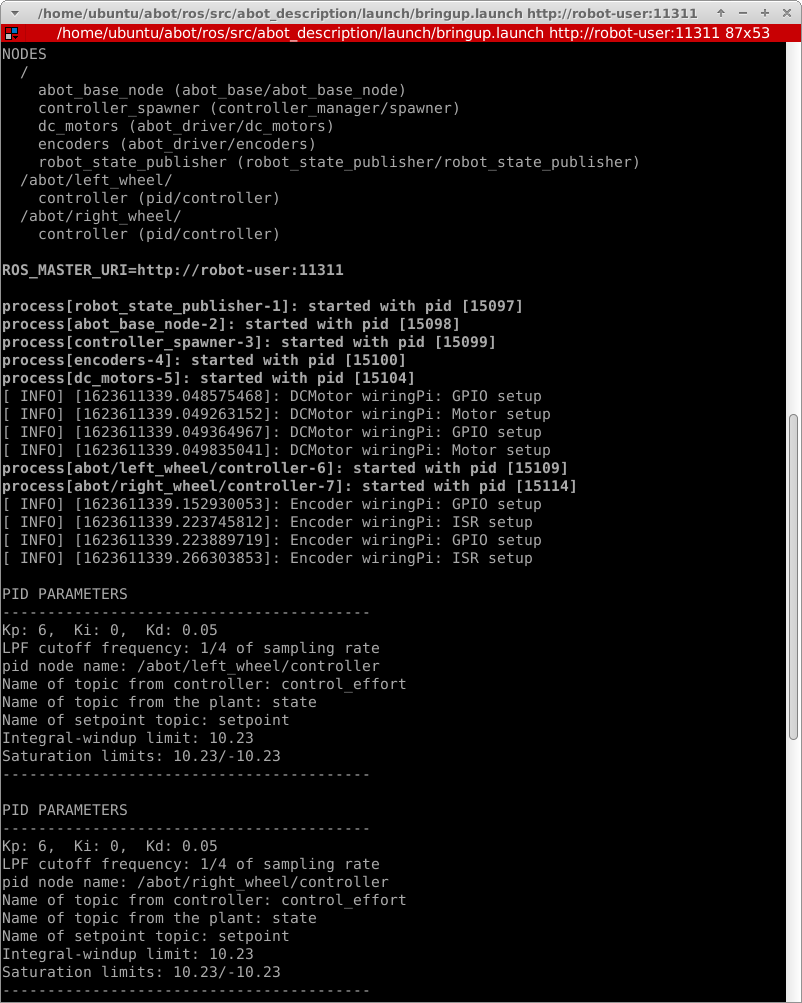
[picture p89: ARTICLE_RU/media/part_9/rpi_side/part_9_rpi_side_screen_2.png]


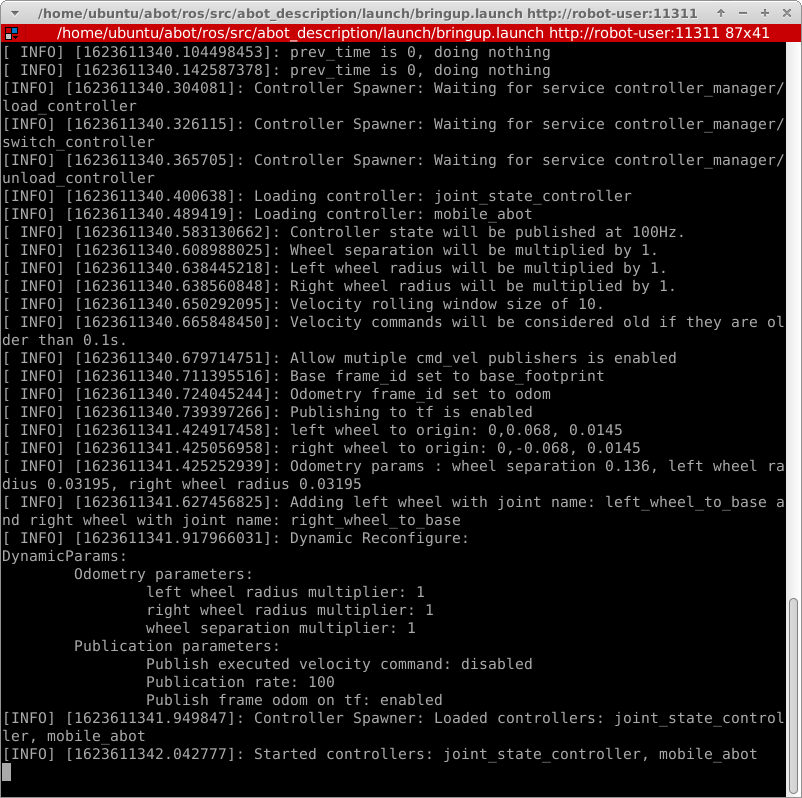
[picture p90: ARTICLE_RU/media/part_9/rpi_side/part_9_rpi_side_screen_3.png]


На настольном компьютере проверим список топиков ROS:

```bash
rostopic list
```

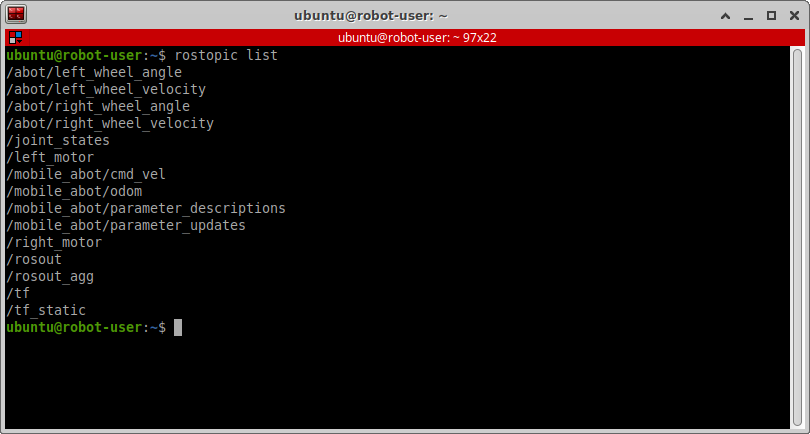
[picture p91: ARTICLE_RU/media/part_9/desk_side/part_9_desk_side_screen_1.png]


Как видите у нас появилось много новых топиков.

Самые интересные топики это топики созданные нашим контроллером движения дифференциального привода `mobile_abot` - `/mobile_abot/cmd_vel` и `/mobile_abot/odom`. Ради этих топиков мы и создавали наши контроллеры.

Топик `/mobile_abot/cmd_vel` принимает сообщения типа `geometry_msgs/Twist`. В этот топик мы отправляем желаемые скорости движения робота.

Топик `/mobile_abot/odom` отдает нам сообщения типа `nav_msgs/Odometry`. Эти сообщения содержат рассчитанную контроллером одометрию робота, его положение и ориентацию в пространстве. 

Попробуем порулить роботом.

Для рулежки будем использовать уже привычную утилиту `rqt` и плагин `rqt_robot_steering`. Этот плагин специально создан для управления двухколесным дифференциальным приводом.

На настольном комьютере, в новом терминале запустим `rqt`. В окне `rqt` выбираем **Plugins → Robot Tools → Robot Steering**. Откроется окно со слайдерами используемыми для рулежки.

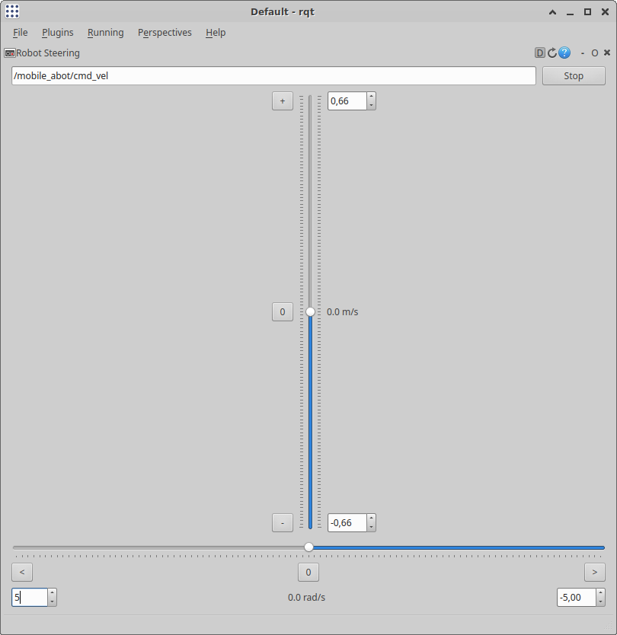
[picture p92: ARTICLE_RU/media/part_9/rqt/part_9_rqt_screen_2.png]


В верхней части окна в имени топика скоростей нам нужно написать имя нашего топика `/mobile_abot/cmd_vel`.

На краях слайдеров есть поля куда нужно установить максимальные и минимальные значения скоростей робота. Мы их уже знаем. Их можно взять из файла конфигурации контроллера - `abot_controllers.yaml`.

Начнем двигать слайдеры и следить за движением робота.

<iframe width="1280"
        height="720"
        src="https://www.youtube.com/embed/mcaFwJTXz0w"
        title="Abot. Robot steering test."
        frameborder="0"
        class="article__cover-youtube"
        allowfullscreen="">
</iframe>

### Визуализация одометрии

Мы проверили работу контроллера в одном направлении - отправили желаемые скорости робота в топик `/mobile_abot/cmd_vel`.

Теперь проверим как работает наш контроллер в обратном направлении - визуализируем одометрию робота.

В пакете `abot_description` в папке `launch` создадим новый файл запуска для визуализации одометрии. Назовем его `display_movement.launch`.

Визуализировать одометрию будем с помощью уже знакомого нам `rviz`. В файле запуска запустим ноду `rviz` с новым файлом настройки визуализации `abot_movement.rviz`. 

Новый файл настроек `abot_movement.rviz` отличается от прежнего `abot_model.rviz` тем что параметр `Fixed Frame` из меню `Global Options` теперь имеет значение `odom`. 

```xml
<launch>
	<arg name="rvizconfig" default="$(find abot_description)/rviz/abot_movement.rviz" />
	<arg name="model" default="$(find abot_description)/urdf/abot.xacro" />
	<param name="robot_description" command="$(find xacro)/xacro --inorder $(arg model)" />
	<node name="rviz" pkg="rviz" type="rviz" args="-d $(arg rvizconfig)" required="false"/>
</launch>
```

Запускаем все файлы запуска как в прошлой главе (если вы вдруг их закрыли, то запускаем на raspberry главный файл запуска `bringup.launch`, а на настольном компьютере `rqt` с плагином `rqt_robot_steering`).

Запускаем на настольном компьютере визуализацию одометрии:

```bash
cd ~/ros
source devel/setup.bash
roslaunch abot_description display_movement.launch
```

Откроется окно `rviz` с новыми настройками. Попробуйте порулить роботом из `rqt_robot_steering` и наблюдайте за визуализацией в `rviz`.

Вот она магия инфраструктуры ROS! Если вы все сделали верно, то любое реальное движение робота будет регистрироваться и визуализироваться в `rviz`! Одна ячейка сетки (`grid`) у нас равна 10 см. Мы можем даже не смотреть на реального робота (а может даже находиться в километре от него), но мы будем знать где он находится и куда смотрит.

<iframe width="1280"
        height="720"
        src="https://www.youtube.com/embed/hwrXCKCM0-I"
        title="Abot. Odometry visualisation."
        frameborder="0"
        class="article__cover-youtube"
        allowfullscreen="">
</iframe>

Изначально, при запуске `bringup.launch` робот находится в точке с координатой (0, 0, 0) в глобальной системе координат. В этих же координатах находится базовая точка одометрии - `odom`. Когда мы начинаем рулить роботом то мы уезжаем от этой базовой точки. В процессе движения `rviz` рисует нам вектор до базовой точки, тем самым показывая как далеко уехал робот с начала работы программы.

Эту визуализацию мы получили лишь используя простую колесную одометрию робота а именно два инкрементных энкодера. Представьте как точно можно отслеживать робота используя более точные сенсоры и алгоритмы.

Тем не менее колесная одометрия не является точной. Со временем данные одометрии начинают дрифтить (odometry drift) и в ней накаливаются ошибки. Точность одометрии достигается настройской драйверов робота и параметров контроллера движения.

Точность колесной одометрии легко проверить. Можно нарисовать под роботом, на его стартовой позиции, крестик обозначив таким образом координату (0, 0, 0) в реальном мире. Затем как следует порулить роботом определенное время, поделать развороты, повороты, разгоны и торможения. Спустя это время нужно сравнить вектор смещения робота относительно базовой точки `odom` в `rviz` с реальным смещением робота относительно крестика на полу. Если эти смещения более менее совпадают (робот смотрит в одну и ту же сторону, находится на примерно одинаковом расстоянии) то одометрию можно считать точной.

## Дистанционное управление

Мы можем управлять роботом через плагин `rqt_robot_steering` однако в "боевых условиях" не удобно двигать ползунки слайдеров на компьютере. Так же через плагин не удобно поворачивать роботом во время движения. Нам нужно удобное дистанционное управление роботом. 

В будущем наш робот будет ездить самостоятельно. Однако нам все равно нужно дистанционное ручное управление. Прежде всего для отладки программного обеспечения и для чтобы мы могли в случае чего перехватить атомномное управление роботом.

Мы сделаем дистанционное уравление роботом на джойстике Dualshock 4 от приставки Sony Playstation 4 по Bluetooth. Если вы до этого где то использовали свой джойстик Dualshock 4, сбросьте его настройки до заводских ткнув иголкой в кнопку в отверстии на задней крышке.

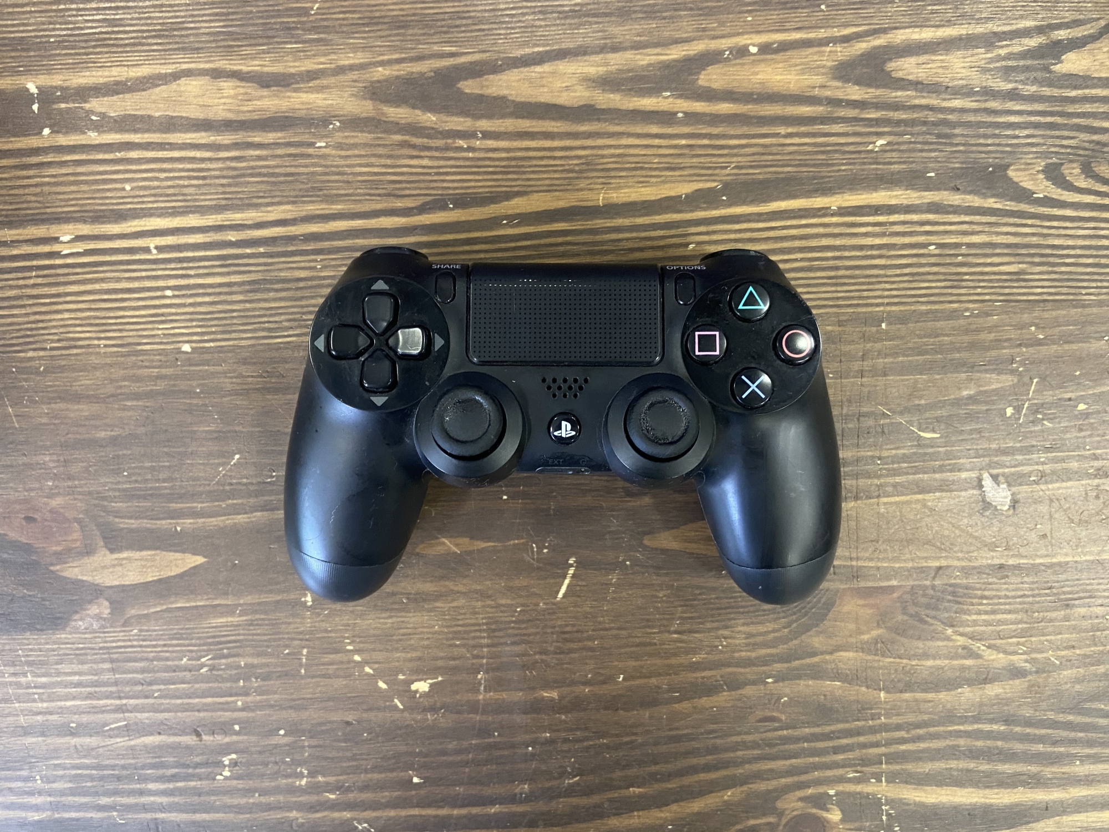
[picture p93: ARTICLE_RU/media/part_10/irl/part_10_irl_teleop_1.jpg]


### Установка драйверов

#### Настройка Bluetooth на Raspberry Pi

Плата Raspberry Pi 4 уже имеет на борту Bluetooth модуль, нам не нужно покупать какие-либо дополнительные шилды и платы.

Bluetooth чип на плате Raspberry общается с процессором Broadcom по аппаратному [UART интерфейсу](https://ru.wikipedia.org/wiki/Универсальный_асинхронный_приёмопередатчик). Изначально эта аппаратная UART шина доступна для ввода/вывода пользователю. То есть нам нужно отказаться от этого UART интерфейса и назначить на этот интерфейс Bluetooth модуль.

Устанавливаем специальный пакет `pi-bluetooth` который подключит драйверы для Bluetooth модуля и создаст новое устройство в системе.

```bash
sudo apt-get install pi-bluetooth
```

Установим ПО для управления Bluetooth и при желании графический интерфейс:

```bash
sudo apt-get install bluetooth bluez bluez-tools
sudo apt-get install blueman 
```

Перезагружаем Raspberry. Проверяем что Bluetooth модуль Raspberry вклюяился и работает (`UP RUNNING`):

```bash
hciconfig -a
```

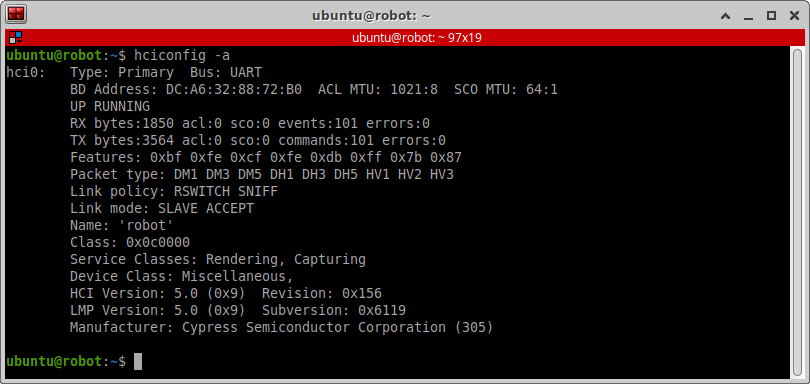
[picture p94: ARTICLE_RU/media/part_10/rpi_side/part_10_rpi_side_screen_1.png]


#### Настройка Bluetooth соединения

Теперь нам нужно создать пару между нашим джойстиком и Bluetooth модулем.

Чтобы джойстик перешел в режим спаривания нажмите одновременно кнопки **Share** и **PS4** и держите их одну - две секунды. Светодиодный индикатор джойстика начнет быстро мигать (быстрее обычного).

Запускаем `bluetoothctl` и режим сканирования.

```bash
bluetoothctl
power on
scan on
```

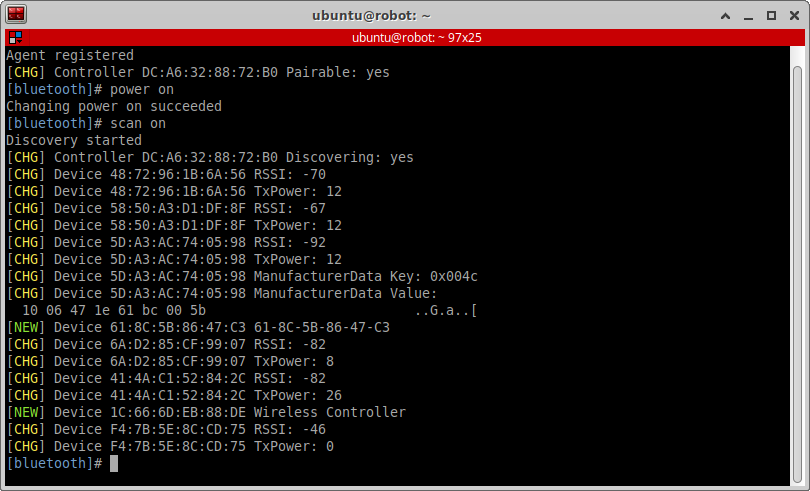
[picture p95: ARTICLE_RU/media/part_10/rpi_side/part_10_rpi_side_screen_2.png]


Джойстик должен определиться как `Wireless Controller`. Нам нужен MAC-адрес джойстика. Адрес нашего джойстика `1C:66:6D:EB:88:DE`.

Теперь, пока светодиод джойстика быстро мигает (идет режим спаривания), создадим новую пару устройств. Так же добавим наш джойстик в список доверенных устройств чтобы при включении джойстика подключение устанавливалось автоматически.

В том же `bluetoothctl` продолжаем:

```bash
trust 1C:66:6D:EB:88:DE
pair 1C:66:6D:EB:88:DE
connect 1C:66:6D:EB:88:DE
```

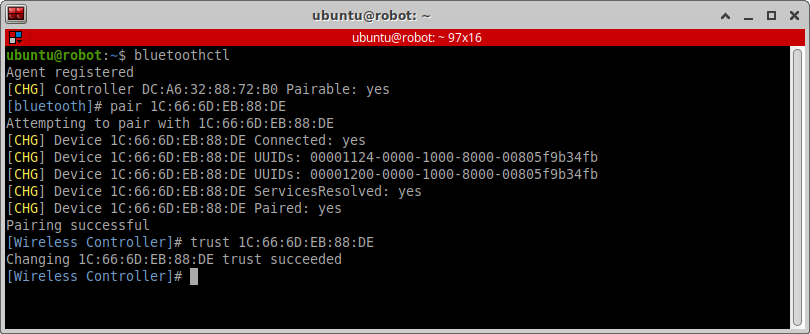
[picture p96: ARTICLE_RU/media/part_10/rpi_side/part_10_rpi_side_screen_3.png]


Создастся новая пара а светодиод джойстика начнет гореть ярко синим цветом.

#### Установка драйвера Dualshock 4

Теперь установим Linux драйвер для конкретно джойстика Dualshock 4.

Мы используем отличный драйвер [ds4drv](https://github.com/naoki-mizuno/ds4drv). Во-первых потому что у него открытый исходный код а во-вторых потому что в ROS уже есть пакет-обертка для этого драйвера.

Драйвер написан на Python поэтому сперва установим `pip` а уже используя `pip` установим `ds4drv`.

В терминале на Raspberry вводим:

```bash
sudo apt-get install python3-venv python3-pip
sudo apt-get install python-is-python3
sudo pip3 install ds4drv
```

Запустим драйвер `ds4drv` под `root`:

```bash
su root
ds4drv --hidraw
```

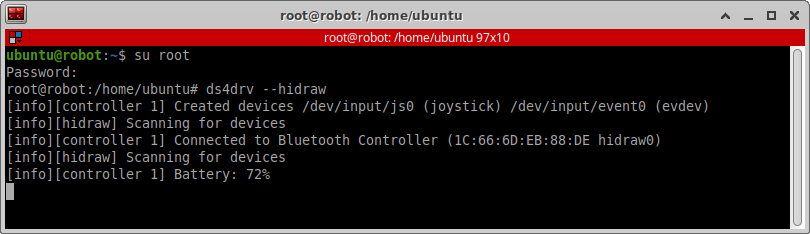
[picture p97: ARTICLE_RU/media/part_10/rpi_side/part_10_rpi_side_screen_4.png]


Пока драйвер запущен, в новом терминале проверим появилось ли новое устройство ввода. У нас оно появилось под именем `js0`:

```bash
ls /dev/input | grep js
```



При желании проверить все кнопки джойстика можно утилитой `jstest`:

```bash
sudo apt-get install jstest-gtk
jstest /dev/input/js0
```

#### Устанавливем пакет ROS для Dualshock 4

В ROS есть пакет [`ds4_driver`](http://wiki.ros.org/ds4_driver) который является оберткой драйвера `ds4drv`. 

Пакет не оффициальный. Он создан и поддреживается пользователем [naoki-mizuno](https://github.com/naoki-mizuno/ds4_driver). Этого пакета нет в сборке ROS Noetic поэтому мы соберем его вручную. 

Для этого скачаем его и просто добавим в наш ROS проект `ros`:

```bash
cd ~/ros/src
git clone https://github.com/naoki-mizuno/ds4_driver.git
cd ~/ros
catkin_make
```

Так же нужно установить ROS пакет для управления джойстиками - [`joy`](http://wiki.ros.org/joy):

```bash
sudo apt-get install ros-noetic-joy
```

### Пакет abot_teleop

Создадим в нашем проекте новый пакет для дистанционного управления роботом. Назовем его `abot_teleop`. В этом пакете будут храниться все наши ROS ноды, которые каким-либо образом относятся к дистанционному управлению. Установим пакеты-зависимости:

- [`roscpp`](http://wiki.ros.org/roscpp)
- [`geometry_msgs`](http://wiki.ros.org/geometry_msgs)
- [`sensor_msgs`](http://wiki.ros.org/sensor_msgs?distro=noetic)
- [`joy`](http://wiki.ros.org/joy)

Как это работает? Конвенционально в ROS, ноды джойстиков публикуют сообщения типа [`sensor_msgs/Joy`](http://docs.ros.org/en/api/sensor_msgs/html/msg/Joy.html). Пакет [`ds4_driver`](http://wiki.ros.org/ds4_driver) который мы добавили в наш проект cобирает информацию о статусе всех кнопок джойстика через Linux драйвер `ds4drv`. Затем пакет `ds4_driver` помещает состояние всех кнопок в сообщение и отправляет его в ROS топик `/joy`. Соответственно мы можем подписаться на этот топик и отслеживать нажата ли какая либо клавиша джойстика.

На джойстике очень много кнопок и все они нам не нужны. Пока мы будем использовать только левый и правый "грибок-манипулятор" для задания скоростей робота. Вертикальное перемещение левого грибка будет отвечать за линейный вектор скорости робота вдоль оси X. Горизонтальное перемещение правого грибка будет отвечать за угловую скорость робота вокруг оси Z.

#### Класс AbotTeleop

Напишем простой класс C++, который реагирует на изменения состояний кнопок джойстика. Назовем его `AbotTeleop`.

В пакете `abot_teleop` создаем папку `src` а в ней новый заголовочный С++ файл `about_teleop.hpp`.

Что делает этот класс? Класс подписывается на топик `/joy` и получает данные о состояниях всех кнопок Dualshock 4. Для грибков на джойстике, значения положения грибка находятся диапазоне от -1 до 1, где 0 - это нейтральное положение.

Затем положения левого и правого грибка умножаются на коэффициенты `_linear_speed_scale` и `_angular_speed_scale` для преобразования позиции грибка в значение скорости. Коэффициенты задаются через параметрический сервер. 

Полученные значения скорости преобразуются в вектора и помещаются в сообщение типа `geometry_msgs::Twist`. Готовое сообщение со скоростями для робота отправляется непосредственно в топик контроллера дифференциального привода - `/mobile_about/cmd_vel`.

```cpp
#ifndef ABOT_TELEOP_HPP_
#define ABOT_TELEOP_HPP_

#include <ros/ros.h>
#include <geometry_msgs/Twist.h>
#include <sensor_msgs/Joy.h>

#define PS4_AXIS_STICK_LEFT_LEFTWARDS 0
#define PS4_AXIS_STICK_LEFT_UPWARDS 1
#define PS4_AXIS_STICK_RIGHT_LEFTWARDS 2
#define PS4_AXIS_STICK_RIGHT_UPWARDS 3

class AbotTeleop {
public:
    AbotTeleop(ros::NodeHandle private_node);
private:
    ros::NodeHandle _node;
    ros::NodeHandle _private_node;
    ros::Subscriber _joy_sub;
    ros::Publisher _cmd_vel_pub;

    bool _last_zero_twist = true; 
    double _linear_speed_scale;
    double _angular_speed_scale;
    
    void joyCallback(const sensor_msgs::Joy::ConstPtr& joy);
};

AbotTeleop::AbotTeleop(ros::NodeHandle private_node) :
    _private_node(private_node) {

    _private_node.param<double>("linear_speed_scale", _linear_speed_scale, 0.0);
    _private_node.param<double>("angular_speed_scale", _angular_speed_scale, 0.0);
    _cmd_vel_pub = _node.advertise<geometry_msgs::Twist>("/mobile_abot/cmd_vel", 1);
    _joy_sub = _node.subscribe<sensor_msgs::Joy>("joy", 10, &AbotTeleop::joyCallback, this);
    ROS_INFO("Abot teleop node: Start");
}

void AbotTeleop::joyCallback(const sensor_msgs::Joy::ConstPtr& joy) {

    geometry_msgs::Twist twist;

    double twist_linear_x_vel =  _linear_speed_scale * joy->axes[PS4_AXIS_STICK_LEFT_UPWARDS];
    double twist_angular_z_vel = _angular_speed_scale * joy->axes[PS4_AXIS_STICK_RIGHT_LEFTWARDS];

    twist.linear.x = twist_linear_x_vel;
    twist.angular.z = twist_angular_z_vel;

    if (twist_linear_x_vel == 0 && twist_angular_z_vel == 0) {
        if (_last_zero_twist == false) {
            _cmd_vel_pub.publish(twist);
            _last_zero_twist = true;
        } 
    } else {
        _last_zero_twist = false;
        _cmd_vel_pub.publish(twist);
    }
}

#endif // ABOT_TELEOP_HPP_
```

#### Нода abot_teleop

Создадим простоую ROS ноду которая будет работать с нашим классом `AbotTeleop`.

В папке `src` пакета `abot_teleop` создадим следующий файл `abot_teleop.cpp`:

```cpp
#include "abot_teleop.hpp"

int main(int argc, char **argv) {
    ros::init(argc, argv, "abot_teleop");
    ros::NodeHandle private_node("~");
    AbotTeleop abotTeleop(private_node);
    ros::spin();
}
```

Добавим исполняемый файл в правило сборки пакета `CMakelists.txt`:

```makefile
add_executable(abot_teleop src/abot_teleop.cpp)
target_link_libraries(abot_teleop ${catkin_LIBRARIES})
```

Соберем проект с новым пакетом:

```bash
cd ~/ros
catkin_make
```

#### Запуск ноды abot_teleop

Cоздадим новый файл запуска для новых нод ответственных за дистанционное управление.

В пакете `abot_teleop` создадим папку `launch` а в ней файл `abot_teleop.launch`.

Эти файлом мы будем запускать две ноды из двух новых пакетов нашего проекта - `abot_teleop` и `ds4_driver`.

```xml
<launch>
	<arg name="addr" default="" />
	<arg name="use_standard_msgs" default="true" />
	<arg name="autorepeat_rate" default="50" if="$(arg use_standard_msgs)" />
	<node pkg="ds4_driver" type="ds4_driver_node.py" name="ds4_driver" output="screen" >
		<param name="device_addr" value="$(arg addr)" />
		<param name="use_standard_msgs" value="$(arg use_standard_msgs)" />
		<param name="autorepeat_rate" value="$(arg autorepeat_rate)" if="$(arg use_standard_msgs)" />
		<param name="deadzone" value="0.1" />
	</node>
	<node pkg="abot_teleop" type="abot_teleop" name="abot_teleop" >
		<param name="linear_speed_scale" type="double" value="0.20"/> 
		<param name="angular_speed_scale" type="double" value="1.57"/>
	</node>
</launch>
```

Параметр `deadzone` отвечает за "слепую зону" грибков джойстика. Установим его равным `0.1`. Так, значения грибков джойстика будут не равны нулю после 10% их хода.

Настраиваем коэффициенты преобразования скоростей из положений грибков джойстика. В `linear_speed_scale` устанавливаем максимальную линейную скорость робота `0.2` м/с, а в `angular_speed_scale` угловую скорость `1.57` рад/с. С такими скоростями вполне удобно рулить роботом с джойстика.

Не забудьте что нельзя задавать скорости больше тех что указаны в файле настроек контроллера дифференциального привода `abot_controllers.yaml`! Так же не стоит задавать слишком большие скорости, особенно угловые - роботом будет тяжело рулить.

Включим новый файл запуска в общий файл запуска робота `abot_description/bringup.launch`:

```xml
<include file="$(find abot_teleop)/launch/abot_teleop.launch" />
```

### Тестируем дистанционное управление

Все готово для управления роботом с помощью джойстика.

На Raspberry запустим главный файл запуска робота `bringup.launch` от `root`:

```bash
cd ~/ros
su root
source devel/setup.bash
roslaunch abot_description bringup.launch
```

На настольном компьютере запустим визуализацию движения робота (`display_movement.launch`). Все то же что и в прошлый раз:

```bash
cd ~/ros
source devel/setup.bash
roslaunch abot_description display_movement.launch
```

Управляем роботом с помощью джойстика и наблюдаем одометрию в `rviz`.

<iframe width="1280"
        height="720"
        src="https://www.youtube.com/embed/ljRfe1y0yBw"
        title="Abot. Teleoperation test."
        frameborder="0"
        class="article__cover-youtube"
        allowfullscreen="">
</iframe>

## Навигация

Давайте разбираться с навигацией робота.

Предположим, что вокруг робота есть какая-то среда. Чтобы ориентироваться в этой среде, робот должен "видеть" ее и локализоваться в ней. Для этого роботы используют различные датчики и сенсоры. То, как робот видит окружающую его среду, зависит от набора имеющихся у него датчиков.

Эти датчики могут быть простыми или сложными, работать в 2D или 3D пространстве. Это могут быть цифровые камеры, камеры глубины ([Time-of-Flight](https://ru.wikipedia.org/wiki/Time-of-Flight-камера)), лазерные/ультразвуковые/инфракрасные дальномеры, простые бинарные контактные датчики (бамперы) и так далее. Чем больше датчиков установлено на роботе и чем лучше они синхронизированы друг с другом, тем больше информации робот может получить об окружающем его мире. ROS поддерживает широкий спектр датчиков. Подробнее читайте в [документации на сенсоры в ROS](http://wiki.ros.org/Sensors).

### Лидар RPLIDAR A1

Новичкам, как мы, лучше всего начинать с простых но эффективных датчиков. Самым популярным датчиком среди новичков является [Лидар](https://ru.wikipedia.org/wiki/Лидар) с полем зрения в 360°.

Такой датчик способен отсканировать всю плоскость в которой он установлен. Почему именно лидар? Потому что этот тип датчиков настолько эффективен, что одного устройства может быть достаточно для реализации навигации в помещении!

Мы выбрали самый популярный и дешевый лидар [RPLIDAR A1](https://www.samtec.com/en/Lidar/A1) от SLAMTECH.

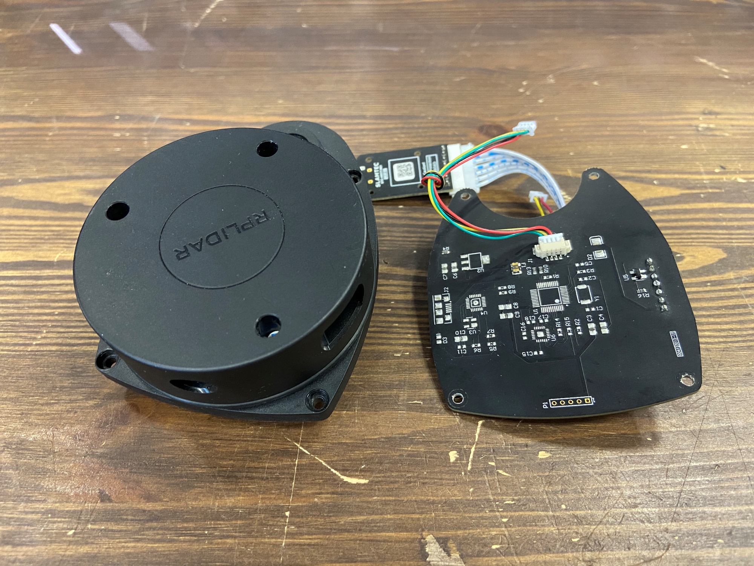
[picture p98: ARTICLE_RU/media/part_11/irl/part_11_irl_lidar_1.jpg]


Этот лидар обеспечивает 360-градусное поле сканирования с частотой обновления от 5,5 Гц до 10 Гц. Дальность действия лидара RPLIDAR A1 составляет около 8 метров. Этот лидар поставляется в виде готового устройства. Вы можете просто закрепить его на своем роботе и подключить к бортовому компьютеру робота. Самый простой способ подключения RPLIDAR это USB-порт, темболее что USB-UART преобразователь идет в комплекте.

Но главная причина, по которой мы используем этот конкретный лидар это пакет [`rplidar`](http://wiki.ros.org/rplidar) в ROS. Данный пакет официальный и поддерживается производителем лидара - SLAMTECH.

#### Крепление лидара

Чтобы закрепить лидар на роботе мы разработали еще одну деталь-площадку и напечатали ее на 3D-принтере. Печатали как и раньше на [Prusa i3 MK3S](prod://3d-printer-prusa-i3-mk3s) из [серого PLA-пластика ESUN](prod://3d-printer-filament-esun-pla-plus-grey).

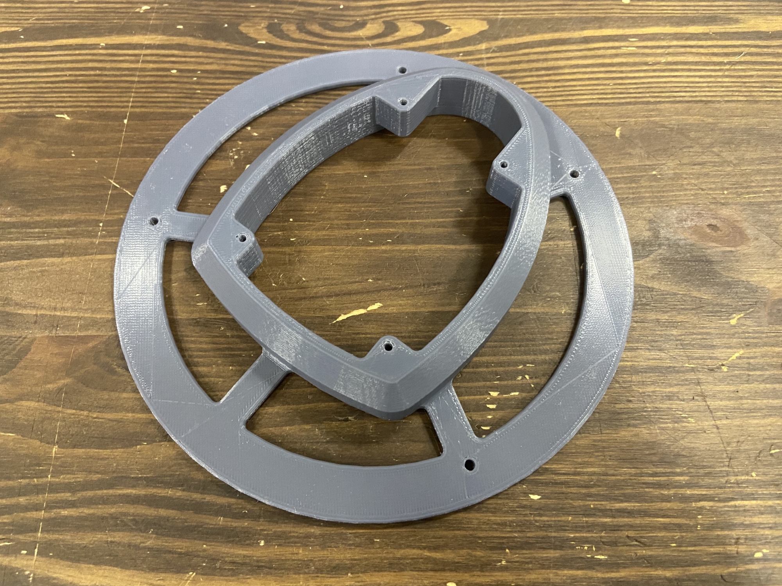
[picture p99: ARTICLE_RU/media/part_11/irl/part_11_irl_lidar_2.jpg]


В эту площадку мы встроили наш лидар и закрепили его винтами M2.5x25, гайками, шайбами и гроверными шайбами.

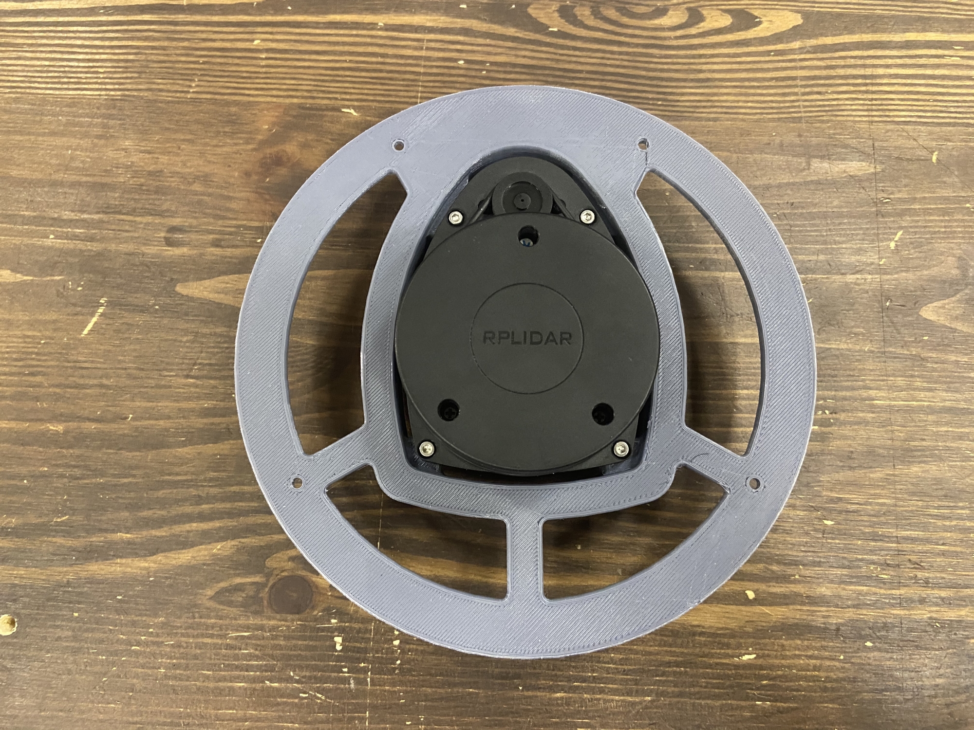
[picture p100: ARTICLE_RU/media/part_11/irl/part_11_irl_lidar_3.jpg]


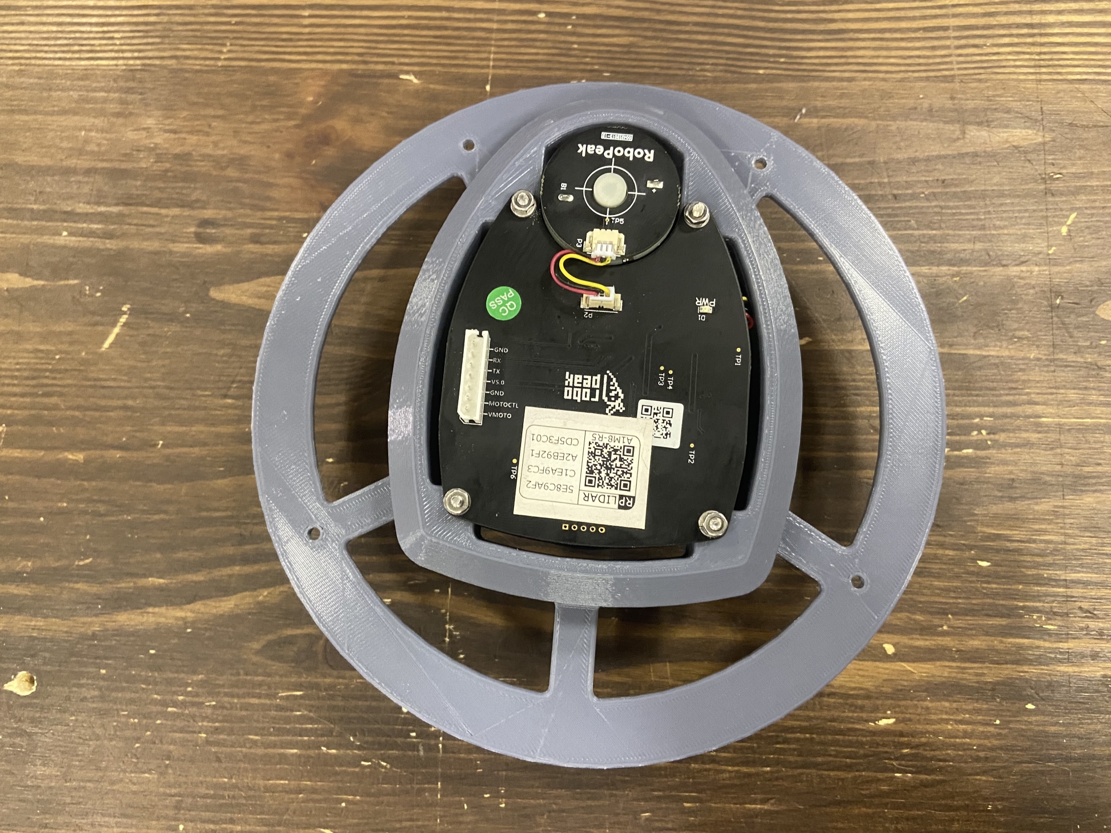
[picture p101: ARTICLE_RU/media/part_11/irl/part_11_irl_lidar_4.jpg]


Саму площадку установили на робота через стоки М3х60.

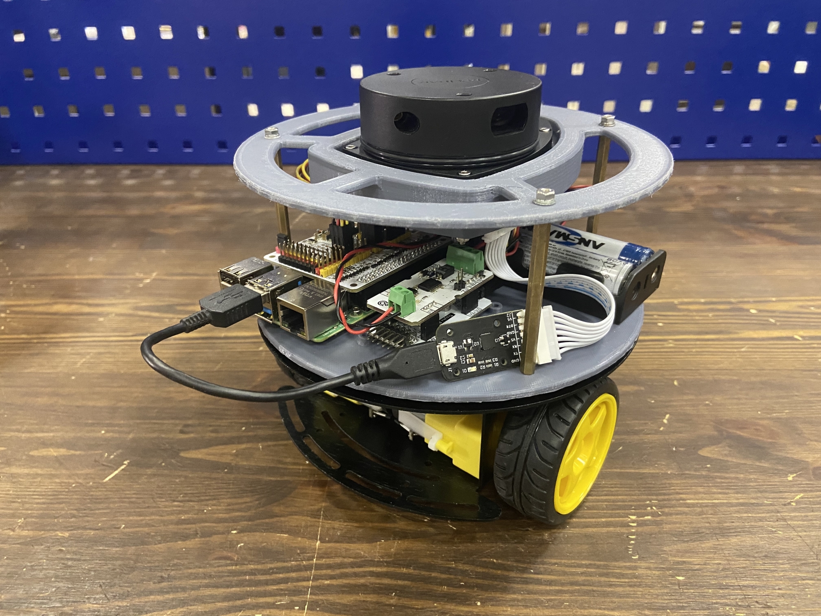
[picture p102: ARTICLE_RU/media/part_11/irl/part_11_irl_lidar_5.jpg]


Когда лидар вращается, вокруг него не должно быть никаких других частей робота, которые могли бы помешать процессу сканированию. На разных роботах лидары устанавливаются по-разному и в разных местах. Чаще всего лидар является самой высокой точкой робота. На наш взгляд лучше всего установить лидар ближе к земле. Эффективность обнаружения препятствий для лидаров, установленных таким образом, выше. Однако лидар установленный низко имеет меньший угол обзора и помехи в виде других окружающих его частей робота. Мы решил установить лидар традиционно сверху робота. Таким образом, наш лидар не сможет обнаружить обьекты высотой ниже робота, но зато сохранит полноценный круговой обзор.

#### Обновляем описание робота в 3D модели и URDF

Регистрируем изменения конструкии нашего реального робота в 3D модели.

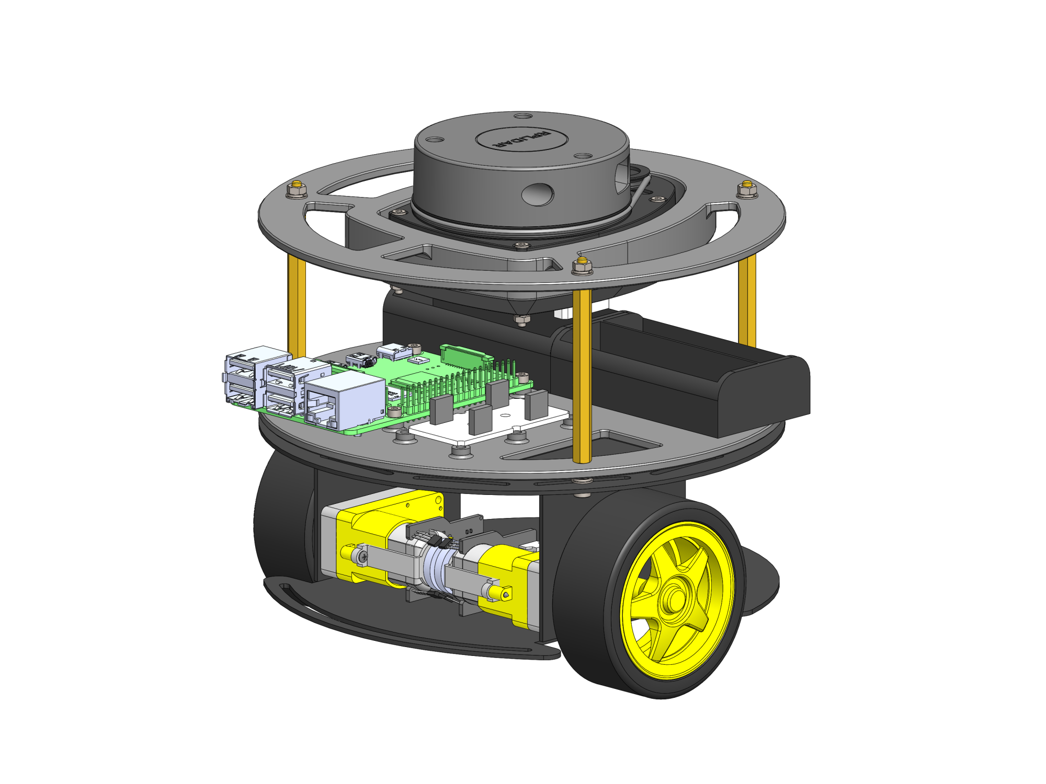
[picture p103: ARTICLE_RU/media/part_11/cad/part_11_cad_lidar_1.png]


Так же нужно обновить URDF описание робота. В этот раз помимо обновления визуальной части робота у нас появится описание нового слоя URDF - слоя датчиков и сенсоров.

Каждый сенсор или датчик в URDF описании должен иметь собственный сегмент. Нам нужно создать сегмент для лидара.

При добавлении датчиков и сенсоров в описание робота крайне важно установить их правильные системы координат. Системы координат датчиков будут впоследствии использованы для определения геометрической области их действия. Для RPLIDAR A1 в ROS рекомендуется следующая ориентация системы координат:

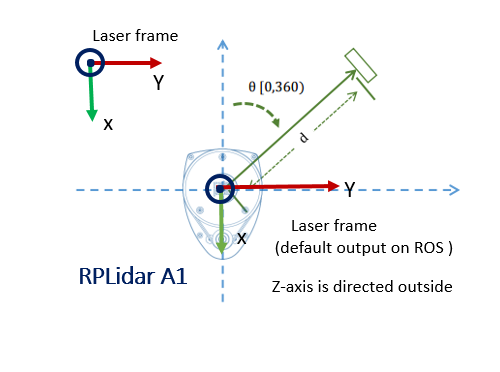
[picture p104: ARTICLE_RU/media/part_11/schemes/part_11_schemes_lidar_1.png]


В Solidworks создаем новую систему координат сегмента лидара `CS_LIDAR`. Начальная точка системы координат находится условно в центре лидара и в плоскости лазера.

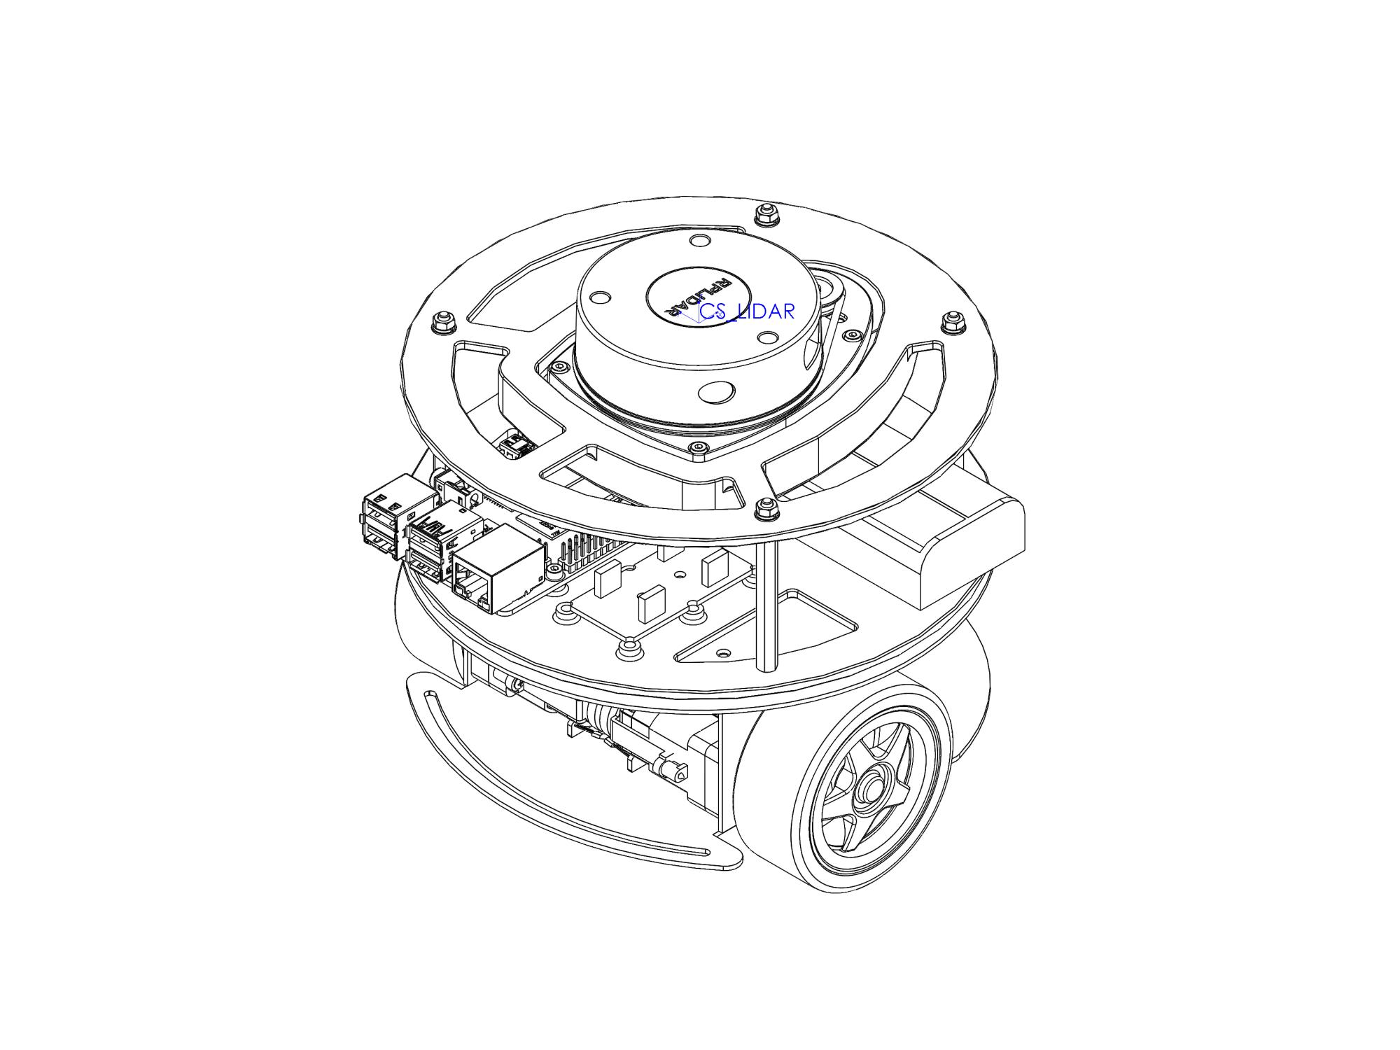
[picture p105: ARTICLE_RU/media/part_11/cad/part_11_cad_lidar_2.png]


Как и прежде используем плагин [`solidworks_urdf_exporter`](https://github.com/ros/solidworks_urdf_exporter) для экспорта URDF описания из 3D модели.

Обновляем визуальную составляющую для нашего базового сегмента `abot_base`. Новый сегмент - `abot_lidar`. Теперь у базового сегмента будет четыре сегмента наследника:

- `abot_left_wheel`
- `abot_right_wheel`
- `abot_caster_wheel`
- `abot_lidar`

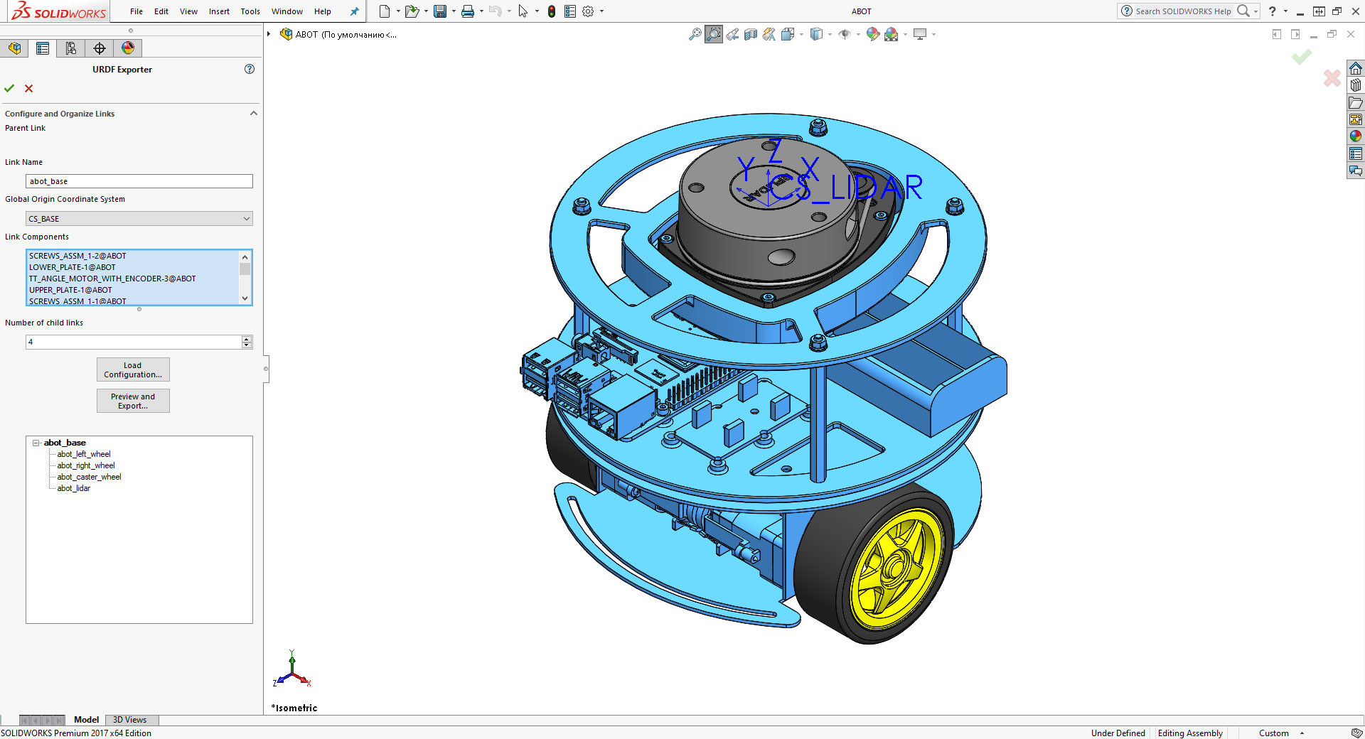
[picture p106: ARTICLE_RU/media/part_11/cad/part_11_cad_lidar_3.png]


Назовем сочленение сегмента лидара с базой робота `lidar_to_base`. В поле системы координат устанавливаем нашу систему координат Solidworks `CS_LIDAR`. Тип сочлененния - `fixed`. В качестве визуальной составляющей сегмента выбираем 3D модель лидара RPLIDAR A1.

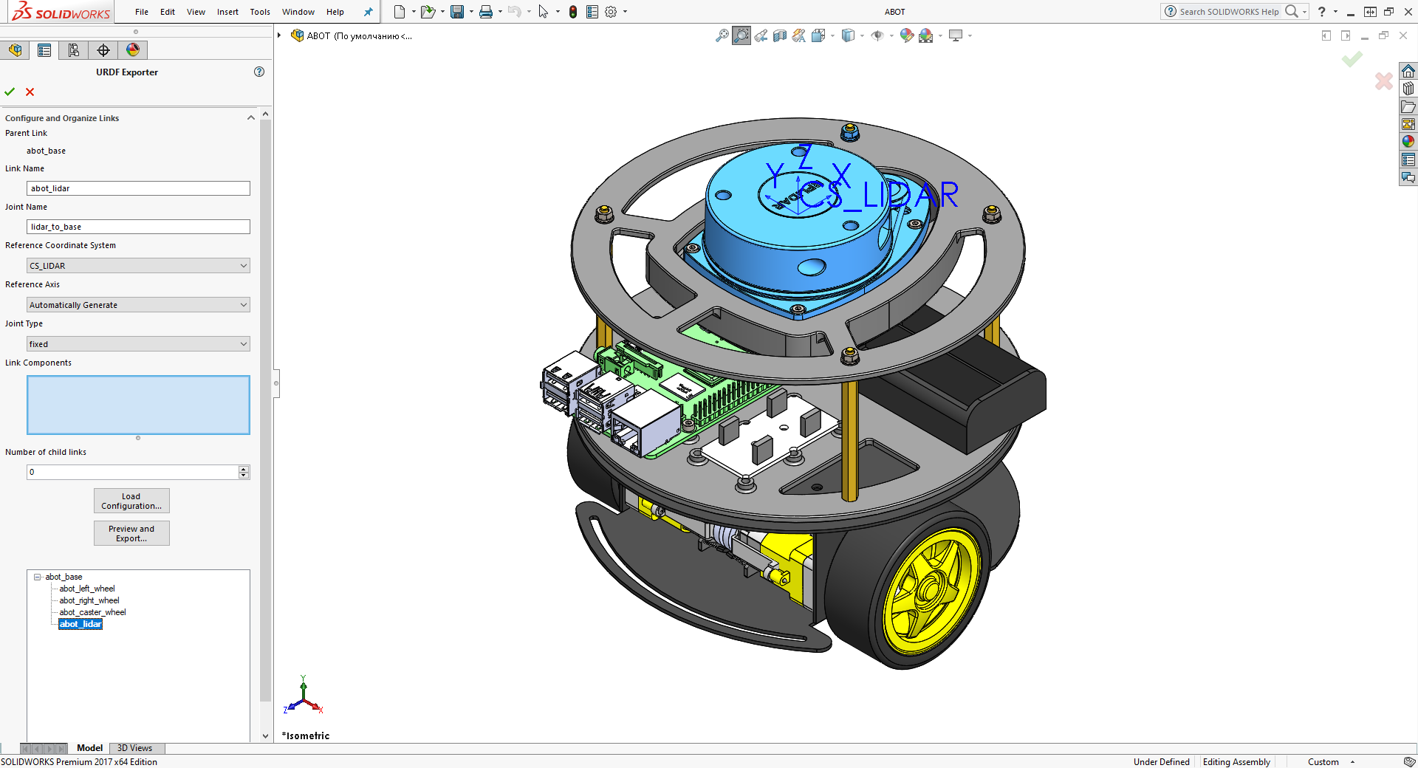
[picture p107: ARTICLE_RU/media/part_11/cad/part_11_cad_lidar_4.png]


Когда все готово нажимаем **Preview and Export...** заканчиваем процесс экспорта URDF описания.

Переносим новые сгенерированные экспортером 3D .STL модели в папку `meshes` в пакет описания нашего робота `abot_description`.

Как и прежде экспортер выдает нам все в виде одного большого URDF файла а нам нужно разбить его и разложить по полочкам. Что изменилось в описании? Изменились инерционные характеристики сегмента `abot_base` и добавился новый сегмент `abot_lidar` c новым сочленением `lidar_to_base`.

Для описания всех сенсоров и датчиков нашего робота используя макросы `xacro` создадим новый отдельный файл. Назовем его `abot_sensors.xacro` и поместив в папку `urdf` пакета `abot_description`.

В этот новый файл скопируем сгенерированное описание лидара. Пусть все сенсоры в нашем описании имеют желтый цвет.

```xml
<?xml version="1.0" encoding="utf-8"?>
<robot name="abot"
	xmlns:xacro="http://www.ros.org/wiki/xacro">
	<!-- lidar -->
	<link name="abot_lidar">
		<inertial>
		<origin xyz="0 0 0" rpy="0 0 0"/>
		<mass value="0"/>
		<inertia ixx="0" ixy="0" ixz="0" iyy="0" iyz="0" izz="0"/>
	</inertial>
	<visual>
		<origin xyz="0 0 0" rpy="0 0 0"/>
		<geometry>
			<mesh filename="package://abot_description/meshes/abot_lidar.STL"/>
		</geometry>
		<material name="Yellow" />
	</visual>
	<collision>
		<origin xyz="0 0 0" rpy="0 0 0"/>
		<geometry>
			<mesh filename="package://abot_description/meshes/abot_lidar.STL"/>
		</geometry>
	</collision>
	</link>
	<joint name="lidar_to_base" type="fixed">
		<origin xyz="-0.01 0 0.1419" rpy="0 0 ${PI}"/>
		<parent link="abot_base"/>
		<child link="abot_lidar"/>
		<axis xyz="0 0 0"/>
	</joint>
</robot>
```

Включите новый файл описания датчиков `abot_sensors.xacro` в наш основной файл описания `abot.xacro`:

```xml
<xacro:include filename="$(find abot_description)/urdf/abot_sensors.xacro" />
```

Протестируем как выглядит наше новое описание робота с лидаром в `rviz`. На настольном компьютере запустим файл визуализации модели `display_model.launch`:

```bash
cd ~/ros
source devel/setup.bash
roslaunch abot_description display_model.launch
```

Визуцализация робота обновилась:

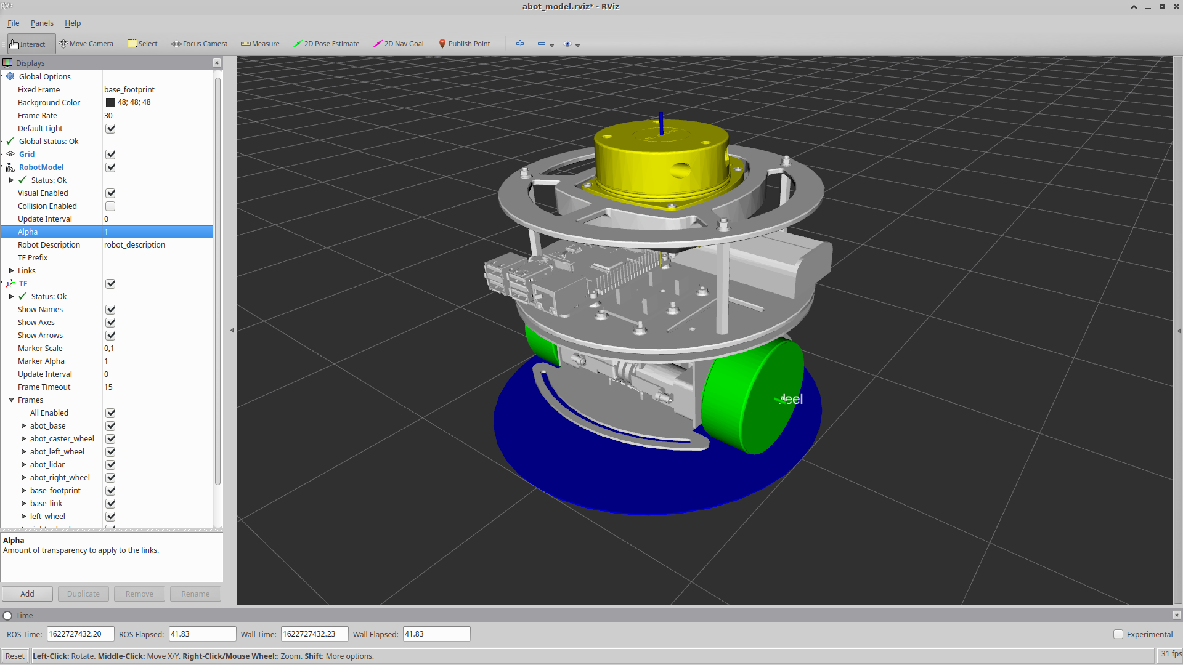
[picture p108: ARTICLE_RU/media/part_11/desk_side/part_11_desk_side_screen_1.png]


Так же проверяем положение и систему координат нового сегмента лидара в пространстве:

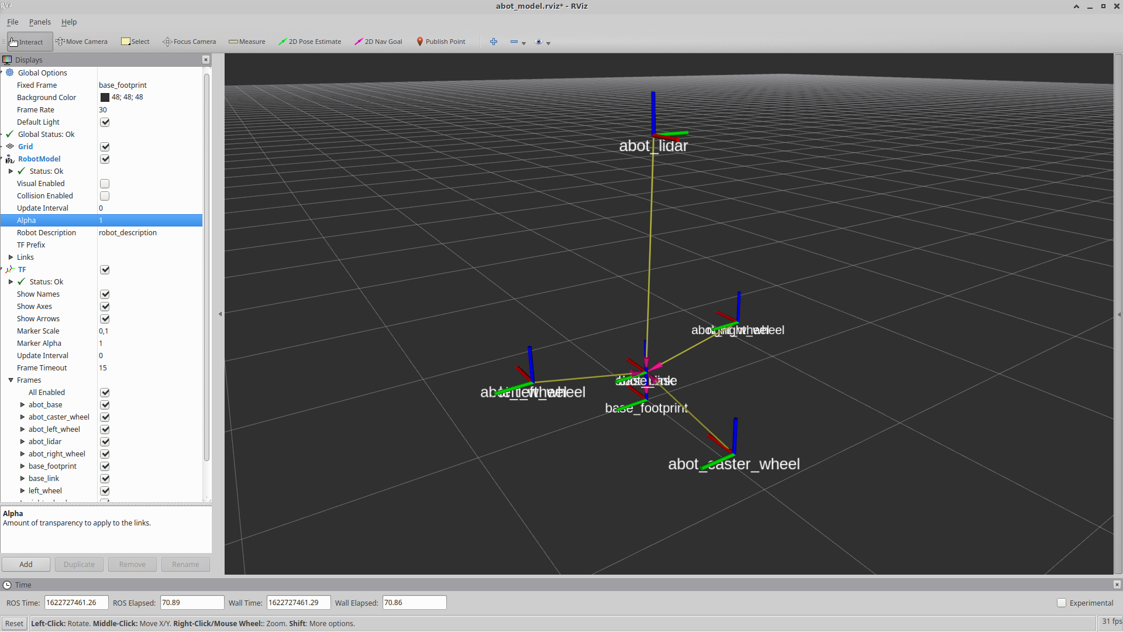
[picture p109: ARTICLE_RU/media/part_11/desk_side/part_11_desk_side_screen_2.png]


Теперь дерево сегментов и сочленений нашего робота выглядит так:

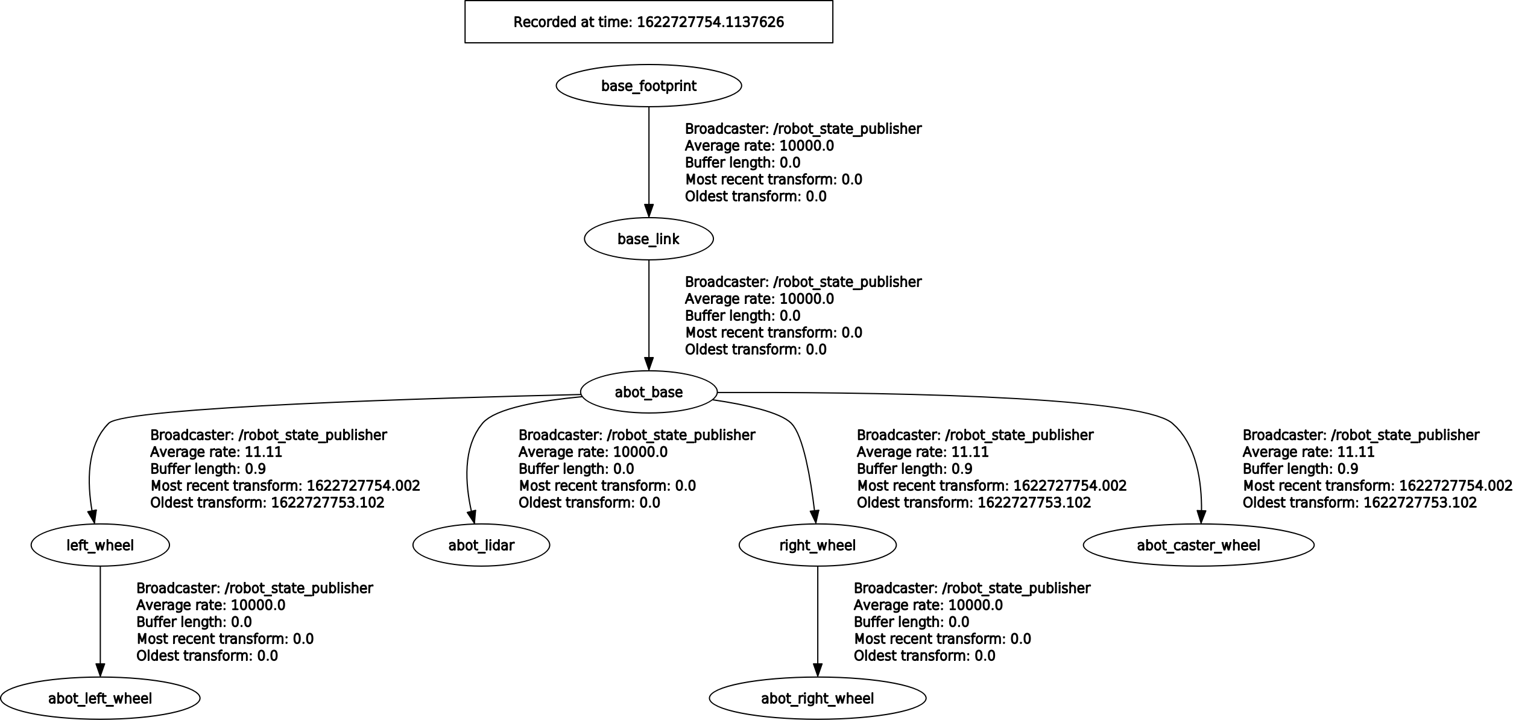
[picture p110: ARTICLE_RU/media/part_11/rqt/part_11_rqt_screen_1.png]


#### Подключение лидара и USB alias 

RPLIDAR A1 подключается к Raspberry по USB через USB-UART преобразователь. Давайте создадим [alias](https://ru.wikipedia.org/wiki/Alias) псевдоним для USB устройства лидара в Linux.

Зачем это нужно? Это нужно чтобы операционная система всегда знала к какому физическому USB порту Raspberry подлючен именно лидар а не другое оборудование. Для того чтобы наша программа не стала опрашивать лидар на том порту где физически его нет а есть например клавиатура или мышь.

Подключим лидар в любой порт Raspberry используя короткий Micro-USB кабель длиной 10 см.

На Raspberry, посмотрим как устройство лидара определилось в системе:

```bash
lsusb
ls /dev | grep ttyUSB
```

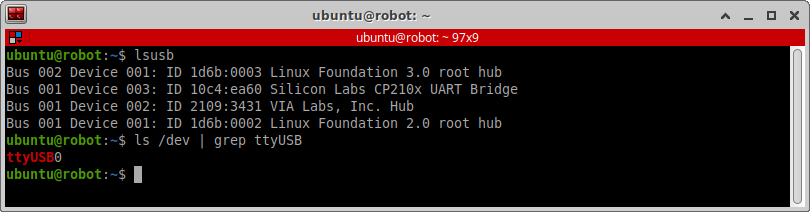
[picture p111: ARTICLE_RU/media/part_11/rpi_side/part_11_rpi_side_screen_1.png]


Наш лидар, определился как `Bus 001 Device 003: ID 10c4:ea60 Silicon Labs CP210x UART Bridge`. Здесь закодирована определенная информация. `10c4` это идентификтор поставщика продукта (`ATTRS{idVendor}`) а `ea60` это идентификатор самого продукта (`ATTRS{idProduct}`). Чаще всего эти идентификаторы уникальны для каждого USB устройства. По ним операционная система и будет определять что к ней подлючили именно лидар.

Вы так же можете получить больше информации об атрибутах USB-устройства командой:

```bash
udevadm info -a -n /dev/ttyUSB0
```
sudo re
Создадим новое udev правило. Под пользователем `root`, в директории `/etc/udev/rules.d` создадим файл `99-usb-serial.rules`.

```bash
su root
nano /etc/udev/rules.d/99-usb-serial.rules
```

В этот файл поместим следующее правило:

```bash
SUBSYSTEM=="tty", ATTRS{idVendor}=="10c4", ATTRS{idProduct}=="ea60", SYMLINK+="lidar"
```

В соответствии с этим правилом любое подключенное USB устройство с указанными параметрами `idVendor` и `idProduct` будет определяться в системе как `lidar`.

Перезагрузим udev правила, переподключим RPLIDAR на другой порт и убедимся, что новый alias работает:

```bash
sudo udevadm control --reload-rules && udevadm trigger
ls -l /dev/lidar
```

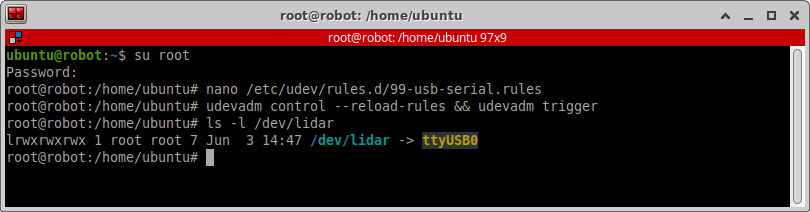
[picture p112: ARTICLE_RU/media/part_11/rpi_side/part_11_rpi_side_screen_2.png]


#### ROS Пакет для RPLIDAR

Чтобы использовать RPLIDAR A1 в ROS, вам не нужно устанавливать никаких дополнительных драйверов, просто используйте ROS пакет [`rplidar_ros`](http://wiki.ros.org/rplidar).
В официальной сборке для ROS Noetic этого пакета, но мы можем просто склонировать его в наш ROS проект. Так же как мы делали с драйверами на джойстик.

```bash
cd ~/ros/src
git clone https://github.com/Slamtec/rplidar_ros.git
cd ~/ros
catkin_make
```

Чтобы запустить ноды для нашего лидара, создим новый файл запуска `abot_lidar.launch`. Поскольку лидар это сенсор и он относится к аппаратному уровню нашего робота, разместим файл запуска в пакете `abot_driver` в папке `launch`.

Данный файл будет запускать ноду `rplidar` из пакета `rplidar_ros`. RPLIDAR отдает данные по интерфейсу UART со скоростью передачи данных по умолчанию в 115200 бод. В качестве пути к устройству указываем созданный нами ранее псевдоним `/dev/lidar`. Также здесь необходимо указать имя сегмента `frame_id` вашего лидара из описания URDF.
Сегмент нашего лидара называется `abot_lidar`.

Значение `Boost` параметра `scan_mode` установит наибольшую скорость сканирования лидара RPLIDAR A1 - 10 герц.

```xml
<launch>
	<node name="rplidarNode" pkg="rplidar_ros"  type="rplidarNode" output="screen">
		<param name="serial_port" type="string" value="/dev/lidar"/>  
		<param name="serial_baudrate" type="int" value="115200"/>
		<param name="frame_id" type="string" value="abot_lidar"/>
		<param name="inverted" type="bool" value="false"/>
		<param name="angle_compensate" type="bool" value="true"/>
		<param name="scan_mode" type="string" value="Boost" />
	</node>
</launch>
```

Включим новый файл запуска нод лидара в общий файл запуска всех драйверов нашего робота `abot_drivers.launch`:

```xml
<include file="$(find abot_driver)/launch/abot_lidar.launch" />
```

### Визуализация данных с лидара

Давайте проверим, как работает наш лидар и что он показывает.

На Raspberry запускаем наш главный файл запуска робота `bringup.launch` от пользователя `root`:

```bash
cd ~/ros
su root
source devel/setup.bash
roslaunch abot_desription bringup.launch
```

Проверим что лидар заработал и начал отдавать данные. Конвенционально лидары в ROS отдают сообщения типа `sensor_msgs/laserscan` которые традиционно публикуются в топик `/scan`. На настольном компьютере посмотрим список топиков, у нас должен появиться топик с именем `/scan`.

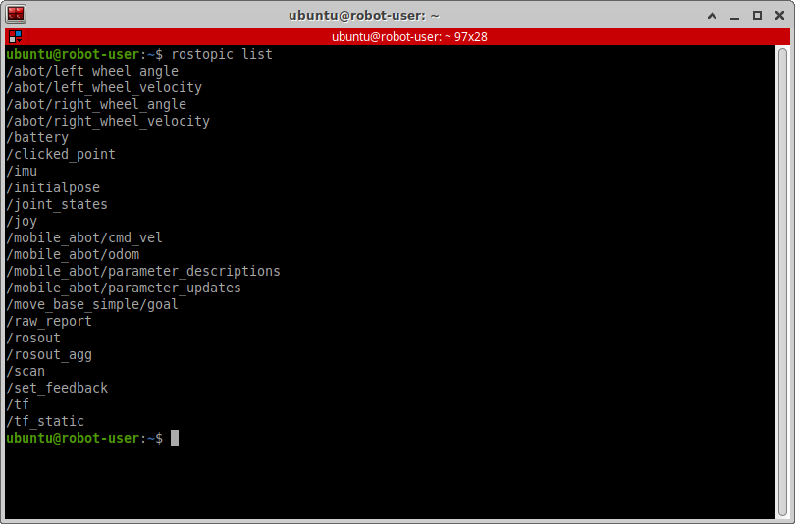
[picture p113: ARTICLE_RU/media/part_11/desk_side/part_11_desk_side_screen_3.png]


На настольном комьютере запускаем уже имеющийся у нас файл визуализации движения робота `display_movement.launch`.

```bash
source devel/setup.bash
roslaunch abot_description display_sensors.launch
```

В уже привычном окне `rviz` добавим новые обьекты для визуализации. 

Конвенционально Лидары в ROS отдают сообщения типа `sensor_msgs/laserscan` и традиционно публикуются в топик `/scan`. В `rviz` на панели `Displays` нажмем **Add → By topic** и выберем визуализацию топика `/scan`.

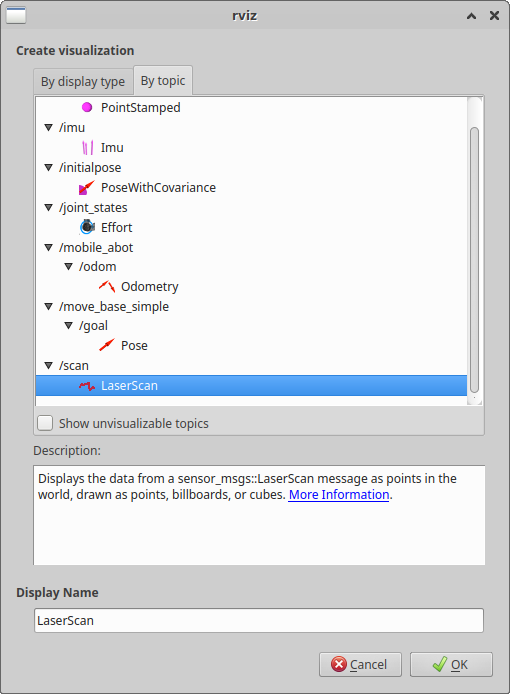
[picture p114: ARTICLE_RU/media/part_11/desk_side/part_11_desk_side_screen_4.png]


Вокруг нашего робота, на уровне лидара появятся красные точки обозначающие окружающие робота преграды. При желании вы можете настроить отображение этих так как нравится вам в настройках `rviz`.

Наш робот начинает видеть! 

<iframe width="1280"
        height="720"
        src="https://www.youtube.com/embed/TuQ89r0-iBg"
        title="Abot. Lidar test."
        frameborder="0"
        class="article__cover-youtube"
        allowfullscreen="">
</iframe>

Попробуйте так же порулить роботом с джойстика и поездить помещению с включенной визуализацией лидара. Взгляните на то как робот видит окружающий мир.

### Теория навигации

Создание автономных мобильных роботов - сложная задача, требующая огромных теоретических и практических знаний. Попробуем рассказать вам о навигации роботов как можно проще, так как мы ее понимаем.

Автономная навигация робота строится на трех фундаментальных принципах:

- Построение карт -[Mapping](https://en.wikipedia.org/wiki/Robotic_mapping)
- Локализация в пространстве - [Localization](https://en.wikipedia.org/wiki/Robot_navigation)
- Планирование пути - [Path planning](https://en.wikipedia.org/wiki/Motion_planning)

Задача Mapping состоит в том, чтобы ответить на вопрос робота "Как выглядит окружающее меня пространство?". Во время картографирования данные с различных датчиков передаются роботу. На основе этих данных робот строит карту окружающего мира (map) в том представлении в котором она понятна для него - [топологическом или метрическом](https://en.wikipedia.org/wiki/Robotic_mapping#Map_representation).

Задача Localization состоит в том, чтобы ответить на вопрос робота "Где я нахожусь в окружающем меня мире?". Во время локализации робот определяет свое положение относительно карты (map). Карта может быть уже известна роботу или строиться в режиме реального времени. При локализации на уже известной карте, робот должен быть способен определять свое положение где бы он ни находился.

Задача Path planning состоит в том, чтобы ответить на вопрос робота "Как я могу добраться до определенной точки на карте?". Целевая точка на карте может быть установлена оператором робота или же самим роботом. Робот должен уметь cамостоятельно спланировать траекторию движения к целевой точке на карте и добраться до этой точки. Кроме этого траектория движения должна быть безопасна для робота и эффективна.

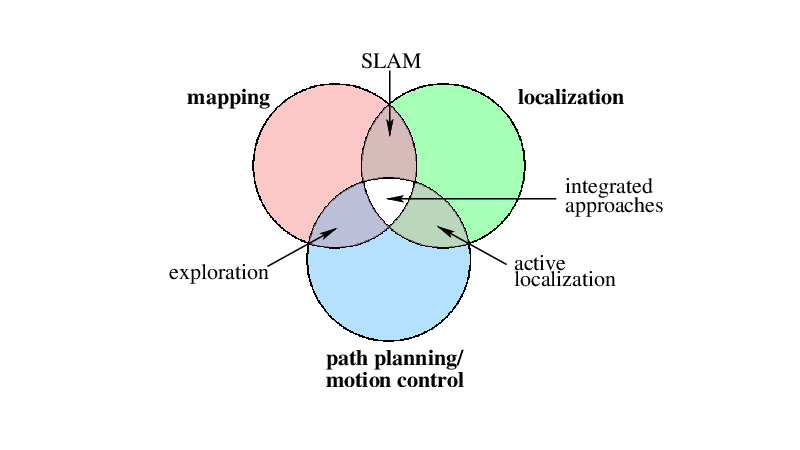
[picture p115: ARTICLE_RU/media/part_12/schemes/part_12_schemes_1.png]


Различные комбинации этих трех терминов позволяют мобильному роботу решать различные навигационные задачи:

- [SLAM (Simultaneous Localization and Mapping)](https://ru.wikipedia.org/wiki/SLAM_(метод)). Метод одновременной локализации и построения карты. Самый популярный метод в робототехнике. Существует тесная связь между Mapping и Localisation. В неизвестной окружающей среде вокруг робота Mapping и Localisation не могут быть разделены. Это происходит потому, что робот должен знать свое точное текущее положение, чтобы построить карту. В то же время роботу нужна качественная карта, чтобы определить свое текущее положение. Пример использования метода: оператор управляет движением робота дистанционно, робот не имеет подготовленной карты а строит ее в режиме реального времени используя сенсоры и локализуется в пространстве используя одометрию.

- Active localisation. Метод активной локализации. Метод основан на том чтобы используя Path planning направлять робота к целевым точкам на карте для уточнения его текущего положения (локализации). Пример использования метода: робот имеет подготовленную карту окружающего его пространтсва, робот движется к целевой точке на карте самостоятельно (автономно без оператора), в процессе движения к цели робот в режиме реального времени локализируется на карте используя не только одометрию но и сенсоры.

- Exploration. Метод исследования. Данный метод предполагает, что робот способен определять свое точное местоположение и без локализации. Метод фокусируется на эффективном движении робота в неизвестной среде для построения им карты в реальном времени. Пример использования метода: робот не имеет подготовленной карты, робот движется самостоятельно без участия оператора, в режиме реально времени робот движется в неизвестную для него территорию при этом непрерывно строя карту и планируя свой маршрут.

- SPLAM (Simultaneous Planning, Localization and Mapping). Метод одновременной локализации, построения карт и планирования пути. Комбинация всех вышеописанных методов. Пример использования метода: робот автономен, робот не имеет подготовленной карты, не имея практически никакой готовой информации об окружающем мире, робот в режиме реального времени самостоятельно строит карту, локализируется в ней и планирует свое дальнейшее движение.

Что из всего этого будем использовать мы? Прежде всего мы составим глобальную карту помещения где наш робот будет работать. Для этого мы будем использовать метод SLAM.

Затем мы дадим роботу эту карту помещения и будем управлять им на ней задавая целевые точки (Goal points). До этих точек робот должен будет добираться самостоятельно обьезжая все препятствия на пути, при этом не потеряв себя на карте. Таким образом мы будем использовать метод Active localisation.

### Построение карты

Существует несколько алгоритмов SLAM. Мы будем испозовать алгоритм [OpenSLAM](https://openslam-org.github.io/). Для этого алгоритма в ROS есть готовый пакет - [`gmapping`](http://wiki.ros.org/gmapping)`.

Как будет строиться наша карта? Карта будет строиться по принципу "Cетки занятости" ([Occupacy grid](https://en.wikipedia.org/wiki/Occupancy_grid_mapping)). Мы возьмем все пространство вокруг робота и разлинуем его на множество квадратных ячеек. Полученное таким образом разлинованное пространство называется сеткой занятости а каждая ячейка называется блоком (block). Каждый блок сетки может иметь только два состояния - занят или свободен. Свободный блок на сетке означает что в пространстве это место пусто. Занятый блок на сетке означает что пространтсве на месте этого блока есть преграда или какой то обьект. Используя лидар наш робот будет в режиме реального времени сканировать окружающее пространство и заполнять блоки сетки значениями занят/своболен используя вероятностную оценку.

### Пакет abot_slam

Сперва установим пакет [`gmapping`](http://wiki.ros.org/gmapping). Для ROS Noetic:

```bash
sudo apt-get install ros-noetic-gmapping
```

Данный пакет предназначен для работы с роботами построенными именно с использованием инфраструктуры ROS. Для любых других роботов данный пакет не подойдет. Для того чтобы пакет [`gmapping`](http://wiki.ros.org/gmapping) заработал у вас должно быть:

- Мобильный робот построенный на инфраструктуре ROS, описанный с использованием URDF и `robot_description` и с визуализацией.
- Реализованное управление роботом для оператора.
- Лидар, закрепленный на роботе и отсылающий сообщения в топик `/scan`.
- Одометрия с робота, находящаяся в топике `/odom`.

Все это у нас уже есть.

Создадим новый пакет для SLAM в нашем рабочем пространстве `ros`. Назовем его `abot_slam`. В качестве пакетов-зависимостей указываем:

- [`gmapping`](http://wiki.ros.org/gmapping)
- [`sensor_msgs`](http://wiki.ros.org/sensor_msgs?distro=noetic)

В пакете `abot_slam` создадим три папки `launch`, `config`, and `maps`. В папке `launch` будут храниться файлы запуска SLAM ноды `gmapping`, в папке `config` - настройки пакета `gmapping`, а в папку `maps` мы будем сохранять готовые карты.

#### Настройка SLAM

В папке `config` создадим новый файл формата .yaml с параметрами пакета `gmapping`. Назовем его `gmapping_params.yaml`.

Настройка параметров SLAM методов это долгое и кропотливое занятие. Параметров настройки много и от них зависит качество вашей карты. В действительности большинство этих параметров подбираются подбором, для каждого конкретного робота с его набором сенсоров. Подробнее о настройке параметров пакета `gmapping` вы можете прочесть в [ROS документаии на пакет](http://wiki.ros.org/gmapping).

Нас будут интересовать прежде всего следующие параметры:

- `base_frame` - имя базового сегмента описания вашего робота. У нас это `base_footprint`.
- `odom_frame` - имя фрейма который используется для визуализации одометрии. У нас он имет имя `odom`.
- `map_frame` - имя фрейма который используется для визуализации отображения карты. У нас он имет имя `map`.
- `xmax`, `xmin`, `ymax`, `ymin` - размеры области (в метрах) на которой будет строиться карта. Размеры задаются относительно нуля системы координат фрейма `map_frame`.
- `particles` - количество сгенерированных лидаром "точек" используемых в фильтре SLAM. Мы ставим `100`.
- `delta` - разрешение карты. Размер (в метрах) стороны квадратного блока сетки занятости. Мы устанавливаем размер одного блока в 2 см или `0.02` метра. Очевидно, чем меньше блок тем точнее карта.
- `map_update_interval` - частота (в секундах) обновления карты в процессе построения. Уменьшение этого интервала заставит сетку занятости обновляться чаще за счет большей вычислительной нагрузки. Мы обновляем нашу карту раз в `2` секунды.
- `maxUrange` - максимальный радиус действия лидара (в метрах). Лидары работают на очень большие расстояния, что не всегда необходимо. В каждый момент времени, нам не нужно знать что находится в 100 метрах от робота когда сам робот размером в 30см. Желательно задать радиус действия меньше реального. Мы ставим радиус действия - `5` метров.
- `linearUpdate` - при движении робота на такое расстояние (в метрах) алгоритм произведет новую оценку данных полученных с лидара. Устанавливаем параметр в 20 см или `0.2` метра.
- `angularUpdate` - при повороте робота на такой угол (в радианах) алгоритм произведет новую оценку данных полученных с лидара. Устанавливаем параметр в `0.2` радиана.
- `temporalUpdate` - при простое робота на месте, через такое время (в секундах) алгоритм произведет новую оценку данных полученных с лидара. При простое будем считывать данные с лидара 2 раза в секунду - `0.5`.

Наша готовая карта будет представлять собой изображение, состоящее из белых, черных или пустых блоков  Черный блок указывает на занятое пространство, белый - на свободное пространство. Пустой блок говорит о том что наличие преград в этой области неизвестно. Размер одного нашего блока равен 20 см а вся карта будет размером 40 на 40 метров.

Так выглядит наш файл настроек `gmapping_params.yaml`:

```yaml
base_frame: base_footprint # The frame attached to the mobile base. 
odom_frame: odom # The frame attached to the odometry system. 
map_frame: map # The frame attached to the map. 

map_update_interval: 1.0 # How long (in seconds) between updates to the map. Lowering this number updates the occupancy grid more often, at the expense of greater computational load. 
maxUrange: 7.0 # The maximum usable range of the laser. A beam is cropped to this value. 

linearUpdate: 0.2 # Process a scan each time the robot translates this far 
angularUpdate: 0.5 # Process a scan each time the robot rotates this far 
temporalUpdate: 0.2 # Process a scan if the last scan processed is older than the update time in seconds. A value less than zero will turn time based updates off. 
resampleThreshold: 0.5 # The Neff based resampling threshold 

particles: 30 # Number of particles in the filter (int, default: 30)
minimumScore: 0.0

xmax: 20.0
xmin: -20.0
ymax: 20.0
ymin: -20.0

delta: 0.025 # Resolution of the map (in metres per occupancy grid block)

# Keep default
sigma: 0.05 # The sigma used by the greedy endpoint matching (float, default: 0.05)
kernelSize: 1 # The kernel in which to look for a correspondence (int, default: 1)
lstep: 0.05 # The optimization step in translation (float, default: 0.05) 
astep: 0.05 # The optimization step in rotation
iterations: 5 # The number of iterations of the scanmatcher

lsigma: 0.075 # The sigma of a beam used for likelihood computation float, default: 0.075) 
ogain: 3.0 # Gain to be used while evaluating the likelihood, for smoothing the resampling effects float, default: 3.0)
lskip: 0 # Number of beams to skip in each scan. Take only every (n+1)th laser ray for computing a match (0 = take all rays)

srr: 0.1 # Odometry error in translation as a function of translation (rho/rho) (float, default: 0.1)
srt: 0.2 # Odometry error in translation as a function of rotation (rho/theta) (float, default: 0.2)
str: 0.1 # Odometry error in rotation as a function of translation (theta/rho) (float, default: 0.1)
stt: 0.2 # Odometry error in rotation as a function of rotation (theta/theta) (float, default: 0.2)

llsamplerange: 0.01 # Translational sampling range for the likelihood  (float, default: 0.01)
llsamplestep: 0.01 # Translational sampling step for the likelihood (float, default: 0.01)
lasamplerange: 0.005 # Angular sampling range for the likelihood (float, default: 0.005)
lasamplestep: 0.005 # Angular sampling step for the likelihood (float, default: 0.005)
```

#### Файлы запуска SLAM и визуализации

В папке `launch` создадим новый файл запуска для метода SLAM. Назовем его так же как и пакет `abot_slam.launch`. Этим файлом мы запустим ноду `slam_gmapping` пакета `gmapping` а так же загрузим SLAM параметры на параметрический сервер ROS.

```xml
<launch>
	<node pkg="gmapping" type="slam_gmapping" name="abot_slam_gmapping" output="screen">
		<rosparam command="load" file="$(find abot_slam)/config/gmapping_params.yaml" />
	</node>
</launch>
```

Теперь создадим файл запуска для визуализации SLAM. Визуализировать процесс построения карты будем как и раньше используя `rviz` на настольном компьютере. В пакете `abot_description` в папке `launch` создадим новый файл запуска `display_slam.launch`. В нем мы запустим визуализацию `rviz` с новыми параметрами `abot_slam.rviz` и сам метод SLAM.

```xml
<launch>
	<arg name="rvizconfig" default="$(find abot_description)/rviz/abot_slam.rviz" />
	<arg name="model" default="$(find abot_description)/urdf/abot.xacro" />
	<param name="robot_description" command="$(find xacro)/xacro --inorder $(arg model)" />
	<node name="rviz" pkg="rviz" type="rviz" args="-d $(arg rvizconfig)" required="false" output="screen"/>
	
	<include file="$(find abot_slam)/launch/abot_slam.launch" />
</launch>
```

В настройках визуализации `about_slam.rviz`, значение параметра **Global Options → Fixed Frame**  должно быть установлено в `map`. Кроме этого, камеру желательно расположить перпендикулярно земле. Так же, при желании можно отображать данные с лидара.

### Тестируем SLAM

Давайте протестируем работу SLAM на нашем роботе. Алгоритм SLAM трудоемкий и требует сложных вычислений. Мы можем запустить его на Raspberry Pi 4 но он "сожрет" всю ее вычислительнную мощность и визуализация алгоритма будет будет иметь очень низкий FPS. В действительности SLAM и не нужно запускать на роботе, ведь мы используем его лишь для генерации постоянной, глобальной карты помещения, а сам робот в данном случае управляется с джойстика оператором. Поэтому запускать SLAM будем на настольном компьютере.

Убедимся что на настольном компьютере запущено ядро `roscore`. На Raspberry запустим главный файл запуска робота `bringup.launch`:

```bash
cd ~/ros
sudo -s 
source devel/setup.bash
roslaunch abot_desription bringup.launch
```

На настольном компьютере запустим файл запуска SLAM и визуализации - `display_slam.launch`:

```bash
cd ~/ros
source devel/setup.bash
roslaunch abot_desription display_slam.launch
```

Примерно так выглядит наше окно `rviz`:



Как мы видим некоторые блоки нашей карты уже начали заполняться статусами свободно или занято.

Построим карту!

Мы будем строить карту того помещения где находимся, а именно - склад компании Амперка. Наше помещение большое и заставлено всевозможными столами и стеллажами, так что карта должна получиться интересной. Используя дистанционное управление джойстиком проедем по всему нашему помещению.

Чем больше площадь помещения вы охватите тем лучше. Ездить роботом желательно плавно, без резких ускорений и торможений. Для более качественной карты нужно проехать роботом вдоль всех стен и вокруг всех предметов на полу. Для большей точности можно проехать по одним и тем же местам несколько раз.

<iframe width="1280"
        height="720"
        src="https://www.youtube.com/embed/G_WgqKymDv8"
        title="Abot. SLAM."
        frameborder="0"
        class="article__cover-youtube"
        allowfullscreen="">
</iframe>

В процессе езды допускается незначительное проскальзывание колес и дрифт, такие ошибки решатся встроенной в `gmapping` локализацей. Однако не нужно вручную поднимать робота, переставлять его с места на место или поворачивать - такие ошибки исправить не получится и вам придется запускать SLAM по новой.

### Сохраняем карту

Когда карта будет готова, нужно ее сохранить. Карта сохраняется путем однократного запуска ноды `map_saver`.

На настольком компьютере, пока активен SLAM и визуализация, в новом терминале запустим `map_saver` с указанием имени карты. Карту сохраним в папку `maps` пакета `abot_slam`:

```bash
cd ~/ros/src/abot_slam/maps/
rosrun map_server map_saver -f map1
```

Вот такая карта у нас получилась:

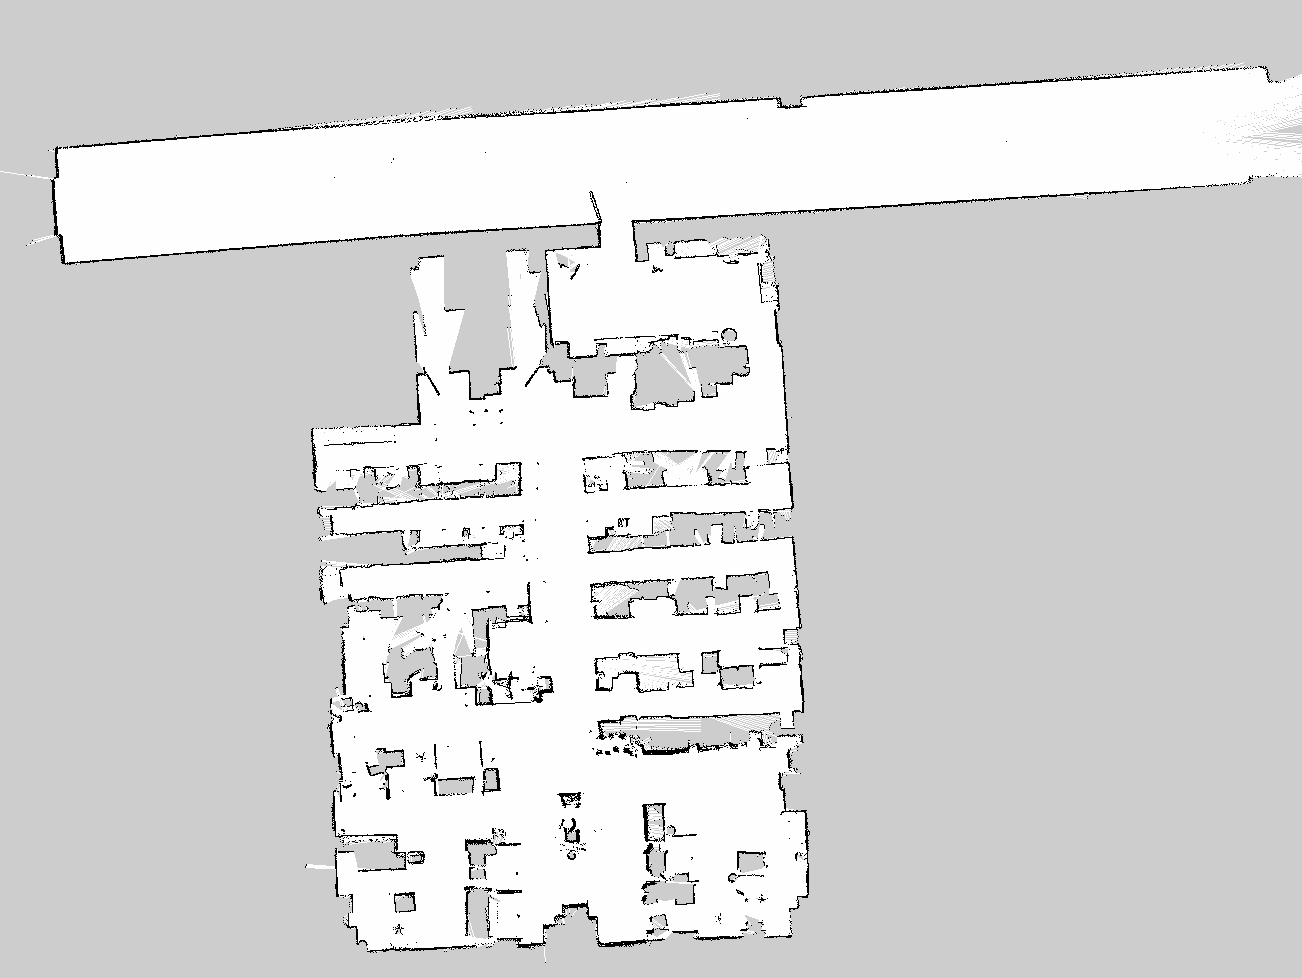
[picture p116: ARTICLE_RU/media/part_12/maps/part_12_maps_map_1.png]


Готовые карты сохраняются в виде файла расширения .yaml и графического изображения в формате .pgm.

### Редактируем карту

Теперь нужно отредактировать созданную карту.

Наша карта не очень точная, это обусловлено качеством лидара, местом его установки и сложностью помещения. Заметьте что робот отразил на карте все что он видел именно в плоскости лидара. Обьекты и преграды которые были ниже уровня лидара робот не заметил. Наример наш робот не может заметить провод на пути движения или полку шкафа которая стоит ниже лидара.

Поэтому нам надо открыть карту и отредактировать ее. Нужно вручную закрасить блоки на сетке карты в черный и белый цвет. Черный цвет для мест куда роботу не стоит ехать и белый для мест куда ехать можно. Например можно закрыть двери или поставить искуственные стены.

Редактирование сгенерированных карт не считается каким-то "читом", скорее это правило хорошего тона.

Чистим нашу карту в [GIMP](https://ru.wikipedia.org/wiki/GIMP). Так вы глядит наша отредактированная карта:

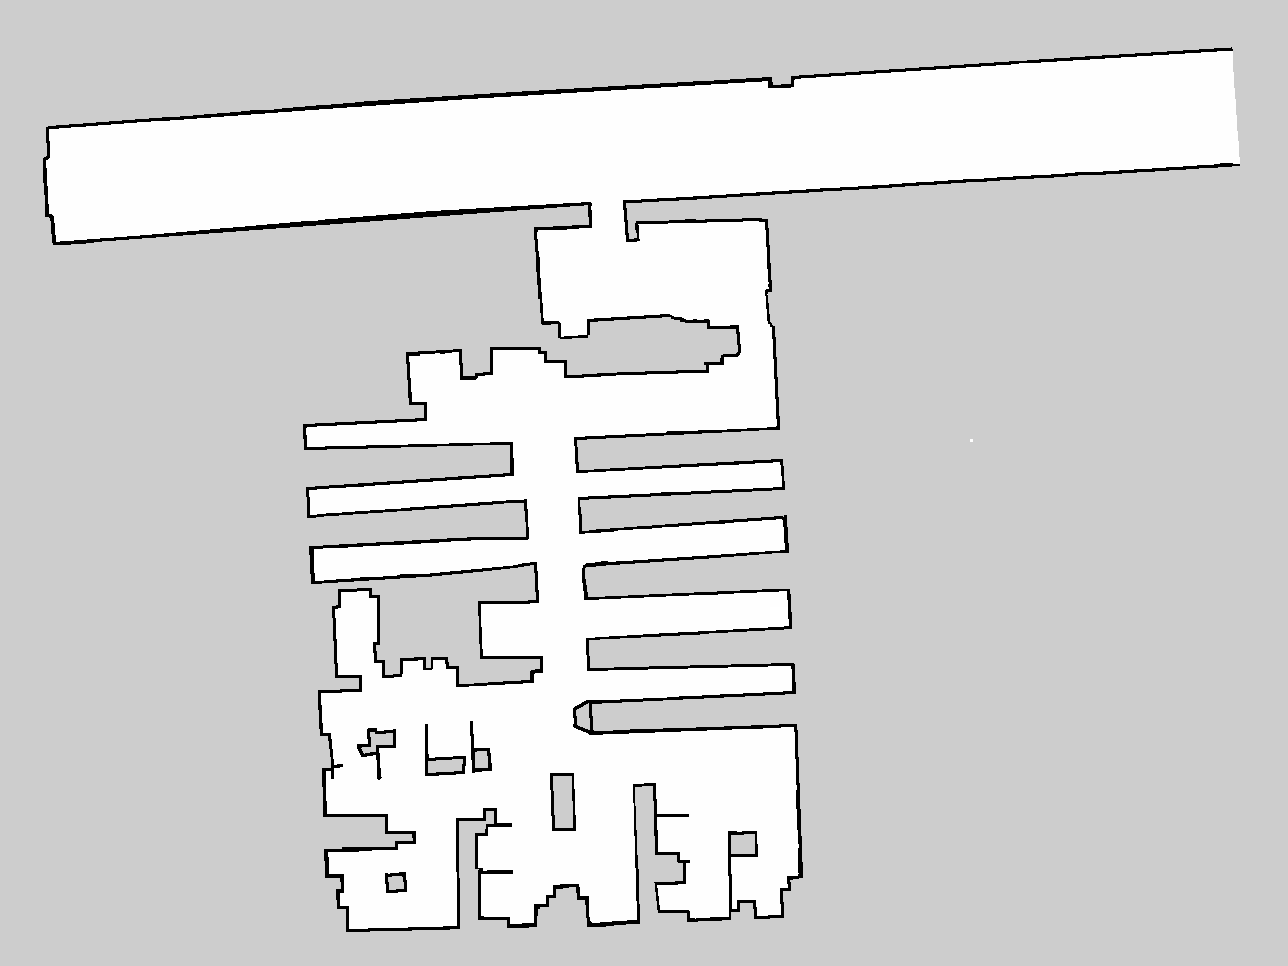
[picture p117: ARTICLE_RU/media/part_12/maps/part_12_maps_map_2.png]


### Стек навигации ROS

Когда карта готова, можно начать реализацию навигации на ней и планирование маршрута.

Для навигации робота в ROS мы используем так называемый [`navigation stack` (стек пакетов навигации)](http://wiki.ros.org/navigation?distro=noetic). Этот стек содержит множество инетересных пакетов и реализованных функций для 2D навигации роботов. Главная особенность `navigation stack` в том что он работает исключительно на роботах построенных с использованием инфраструктуры ROS.

Для работы стека ваш робот должен иметь:

- ROS топик одометрии

Он содержит много интересных пакетов. Суть стека заключается в том, что он берет данные из одометрии, данные с датчиков, положение цели робота на карте и вычисляет скорость робота для контроллера движения.

When the map is ready, you can start navigating it and path planning. For navigation in ROS, I use the conventional [navigation stack](http://wiki.ros.org/navigation?distro=noetic). It contains a lot of cool packages. The stack's essence is that it takes data from Odometry, data from sensors, robot's goal position on the map, and calculates the robot's speeds for the motion controller.

I create a new package and name it `abot_navigation`. There I make two folders `config` and `launch` to store the navigation settings and launch files, respectively.

My robot's navigation is based on two packages from the ROS stack: `[move_base](http://wiki.ros.org/move_base)` and `[acml](http://wiki.ros.org/amcl?distro=noetic)`. The `move_base` node is responsible for planning the path and reaching the specified point on the map. The `acml` is an active localization node that implements an adaptive (or KLD-sampling) [Monte Carlo localization algorithm](https://en.wikipedia.org/wiki/Monte_Carlo_method). I advise you to read the official ROS documentation for these nodes. Try to get an understanding of what these nodes are for and how they work.

At first, configure the `move_base` node. When planning a robot path, the `move_base` works with two types of path planners: `[global_planner](http://wiki.ros.org/global_planner?distro=noetic)` and [`base_local_planner`](http://wiki.ros.org/base_local_planner?distro=noetic). The global planner makes a route to the goal position using a global map. The map can be ready-made or can be built in real-time. The local planner is a kind of add-on to the global planner. The local planner is responsible for driving the robot around obstacles encountered on the global path. Suppose you have a ready-made map and place the robot on it and specify the goal position. The global planner builds you a path to this position avoiding the global obstacles found on the map (for example, the walls). While moving to the goal position, the local planner corrects the path if dynamic obstacles (such as a person) appear.
