MikAmperka/abot_src/Graphics/S1/SRC/c_z_OSeh0HY-poster-image.jpg

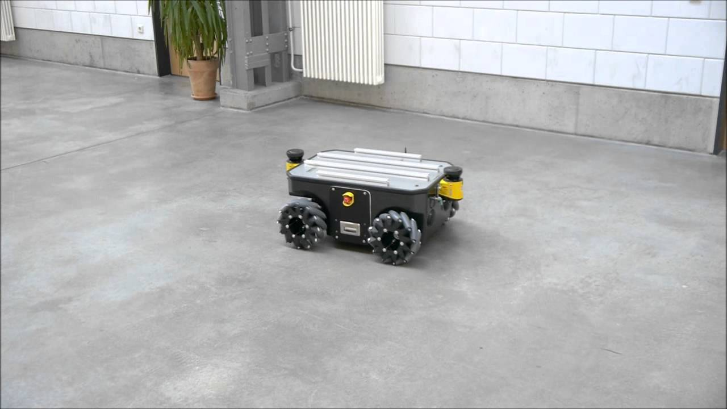
Graphics/S1/SRC/c_z_OSeh0HY-poster-image.jpg
