MikAmperka/abot_src/IMG/_W4A9917-.jpg

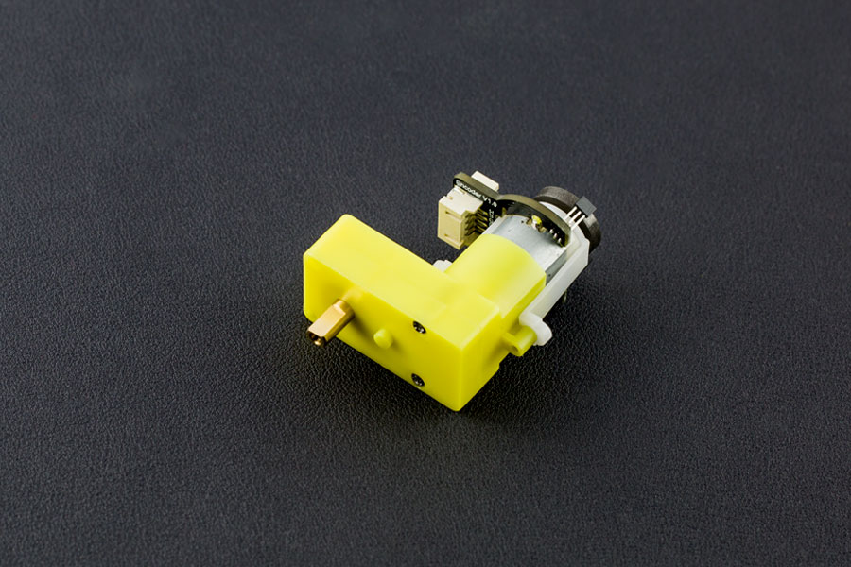
IMG/_W4A9917-.jpg
