MikAmperka/abot_src/IMG/COMPAS/1/2.png

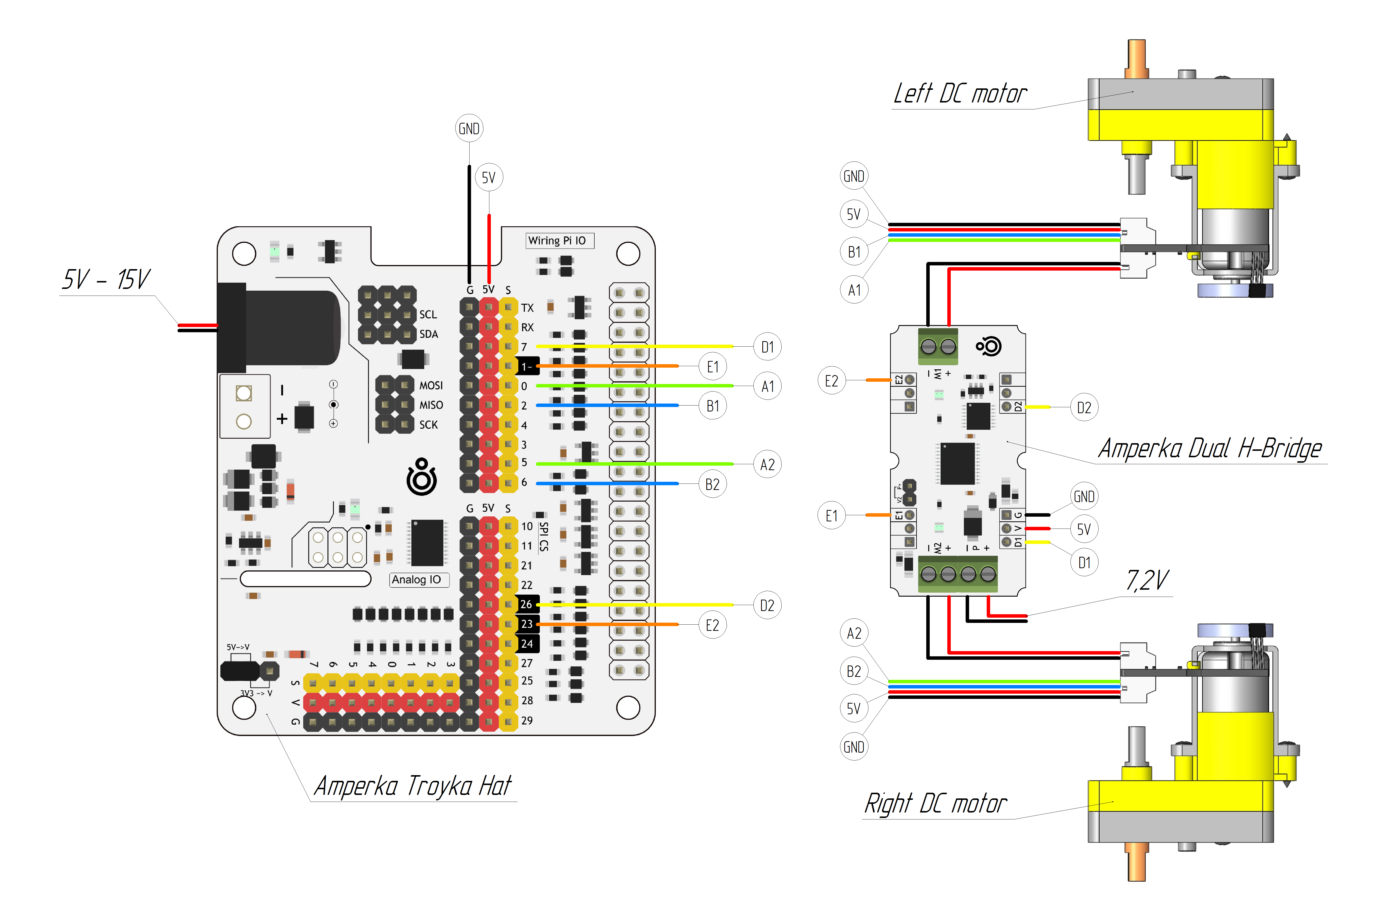
IMG/COMPAS/1/2.png
