MikAmperka/abot_src/IMG/COMPAS/1/raspberry-troyka-cap-2.png

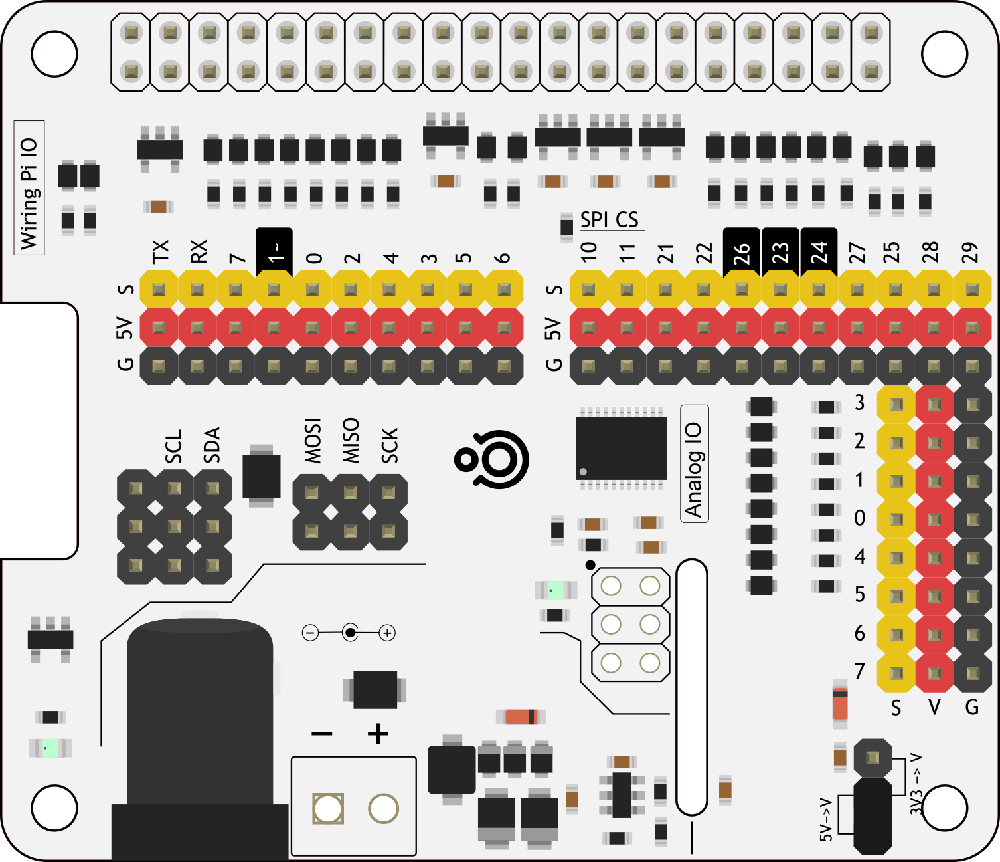
IMG/COMPAS/1/raspberry-troyka-cap-2.png
