MikAmperka/abot_src/IMG/COMPAS/1/top.png

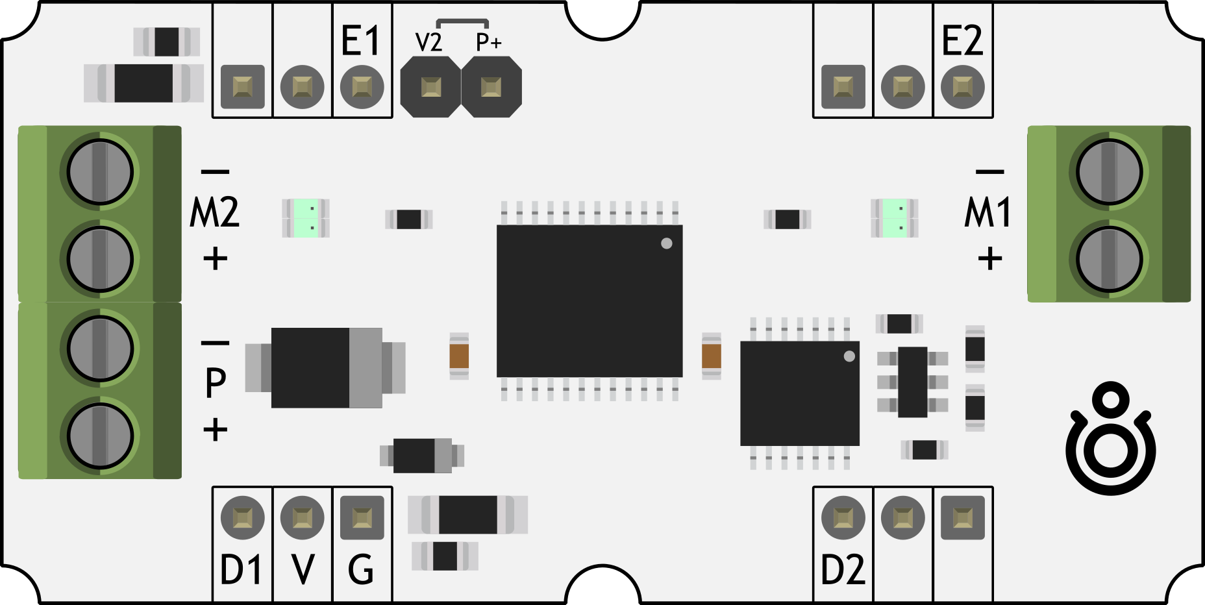
IMG/COMPAS/1/top.png
