MikAmperka/abot_src/IMG/COMPAS/1/TT_ANGLE_MOTOR_WITH_ENCODER.JPG

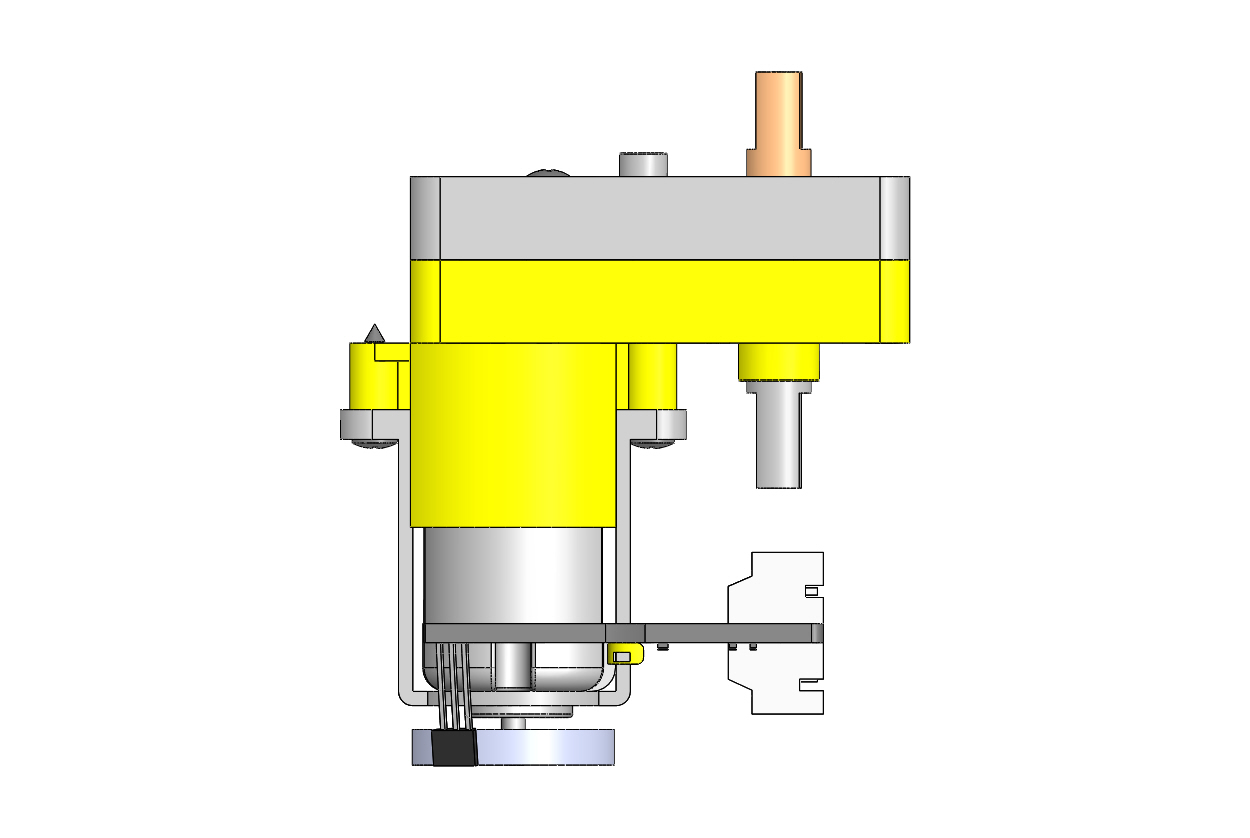
IMG/COMPAS/1/TT_ANGLE_MOTOR_WITH_ENCODER.JPG
