MikAmperka/abot_src/IMG/idvksKxFkuo.jpg

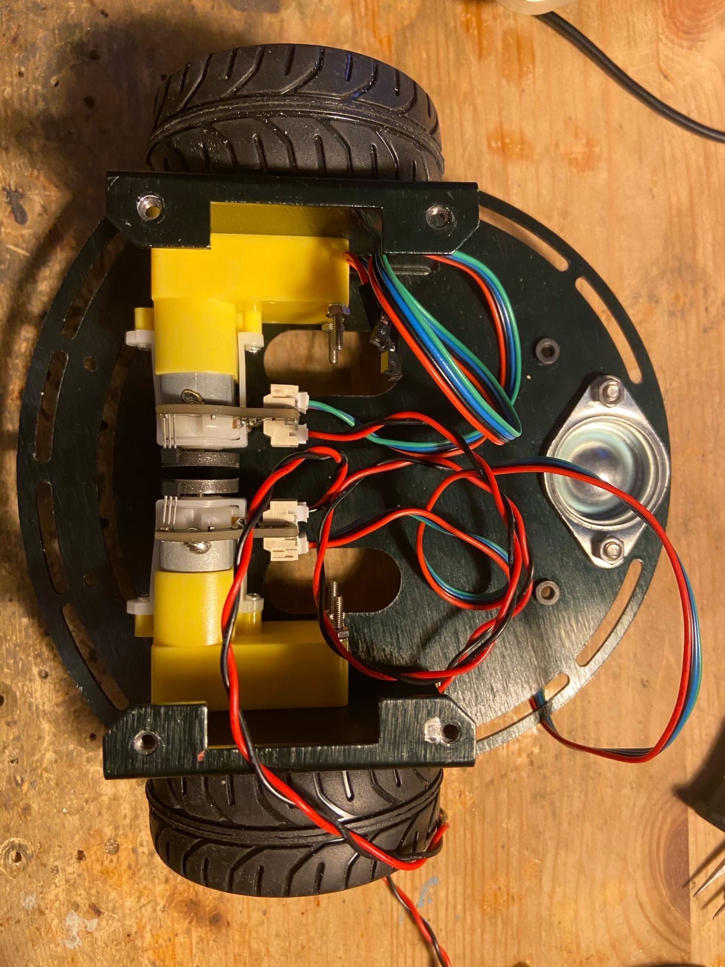
IMG/idvksKxFkuo.jpg
