MikAmperka/abot_src/IMG/IMG/1/R0.png

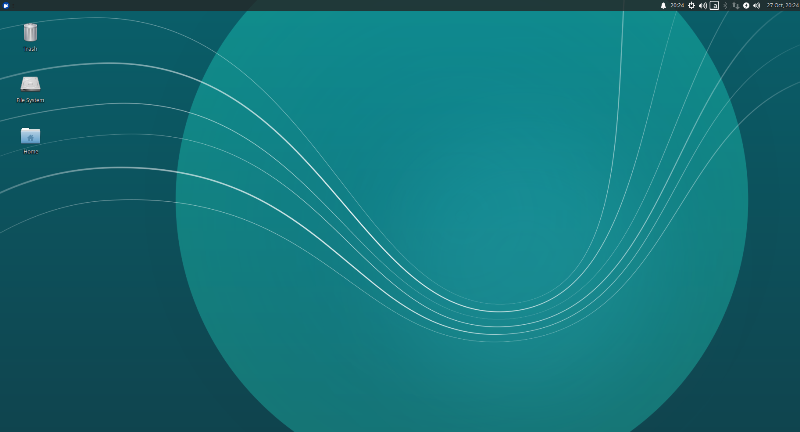
IMG/IMG/1/R0.png
