MikAmperka/abot_src/IMG/IMG/2/P3.png

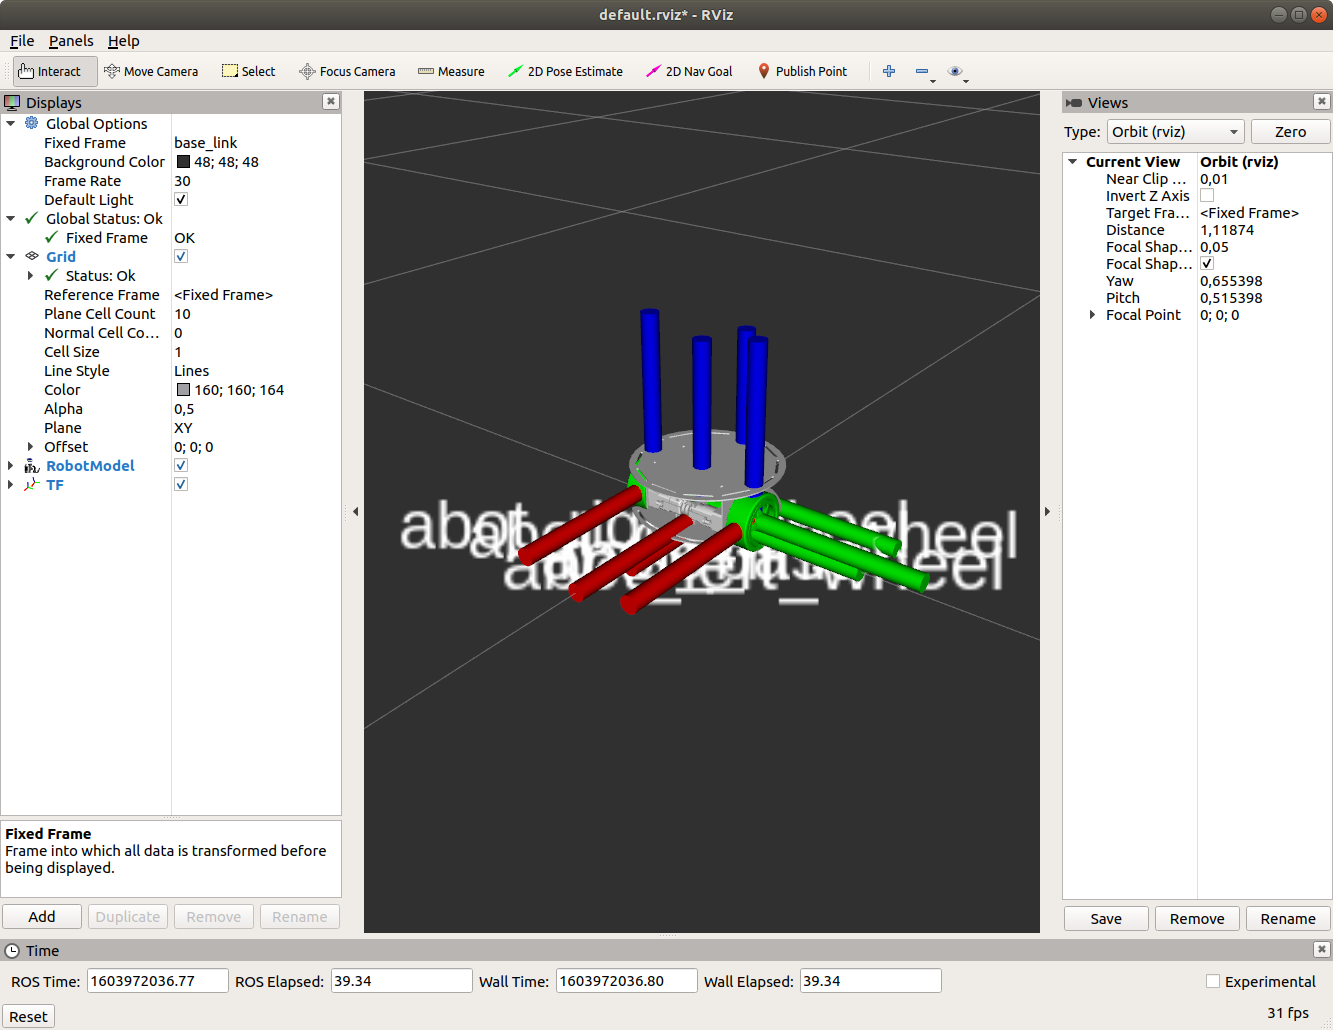
IMG/IMG/2/P3.png
