MikAmperka/abot_src/IMG/IMG/2/P5.png

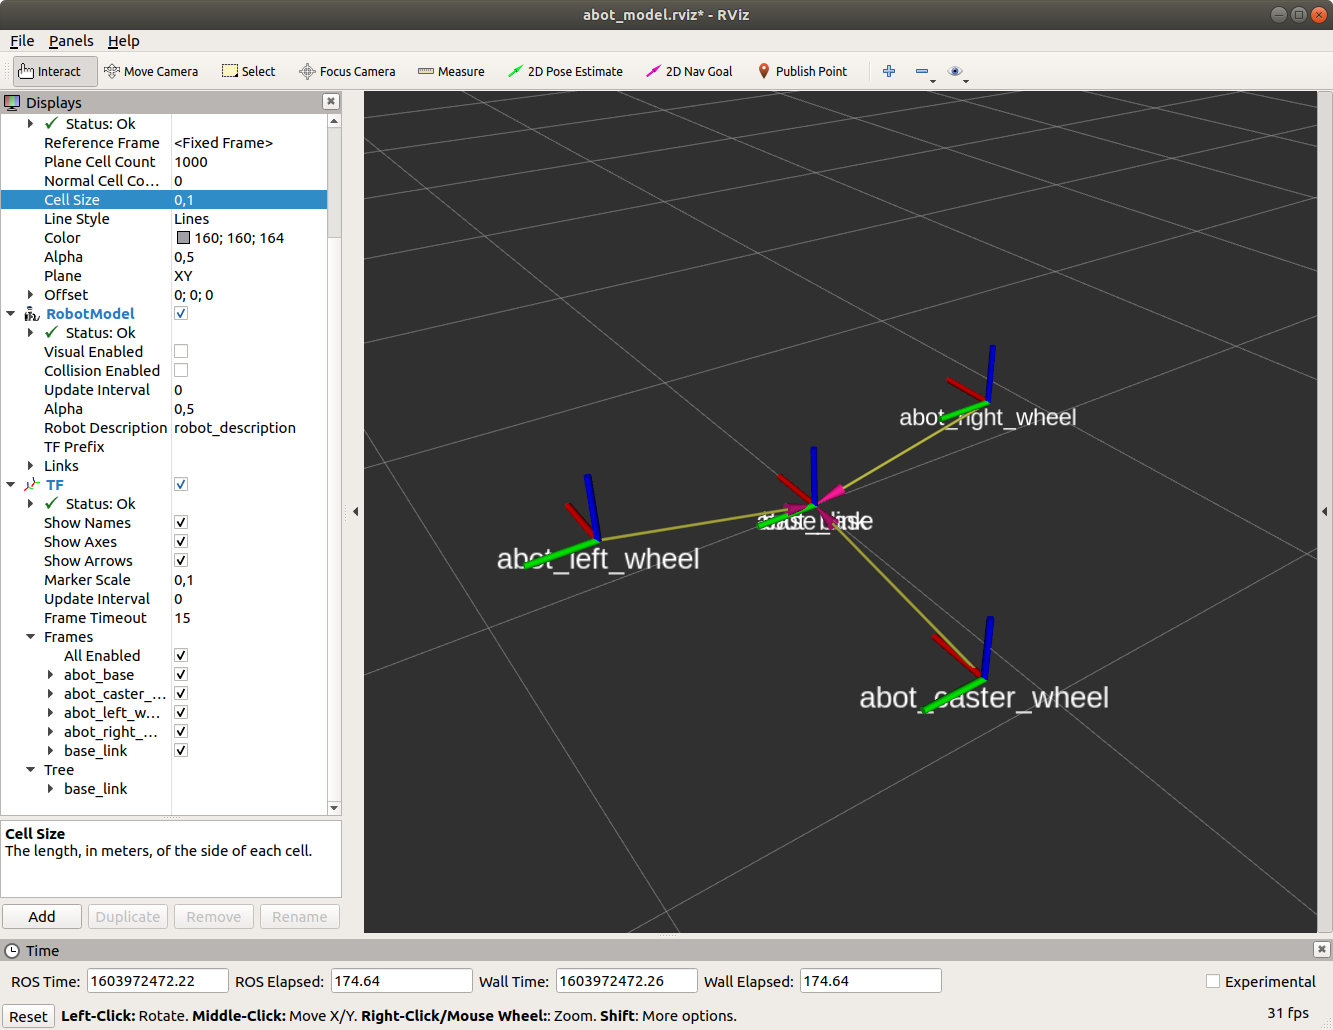
IMG/IMG/2/P5.png
