MikAmperka/abot_src/IMG/IMG/2/P6.png

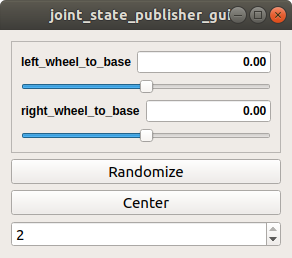
IMG/IMG/2/P6.png
