MikAmperka/abot_src/IMG/IMG/2/P7.png

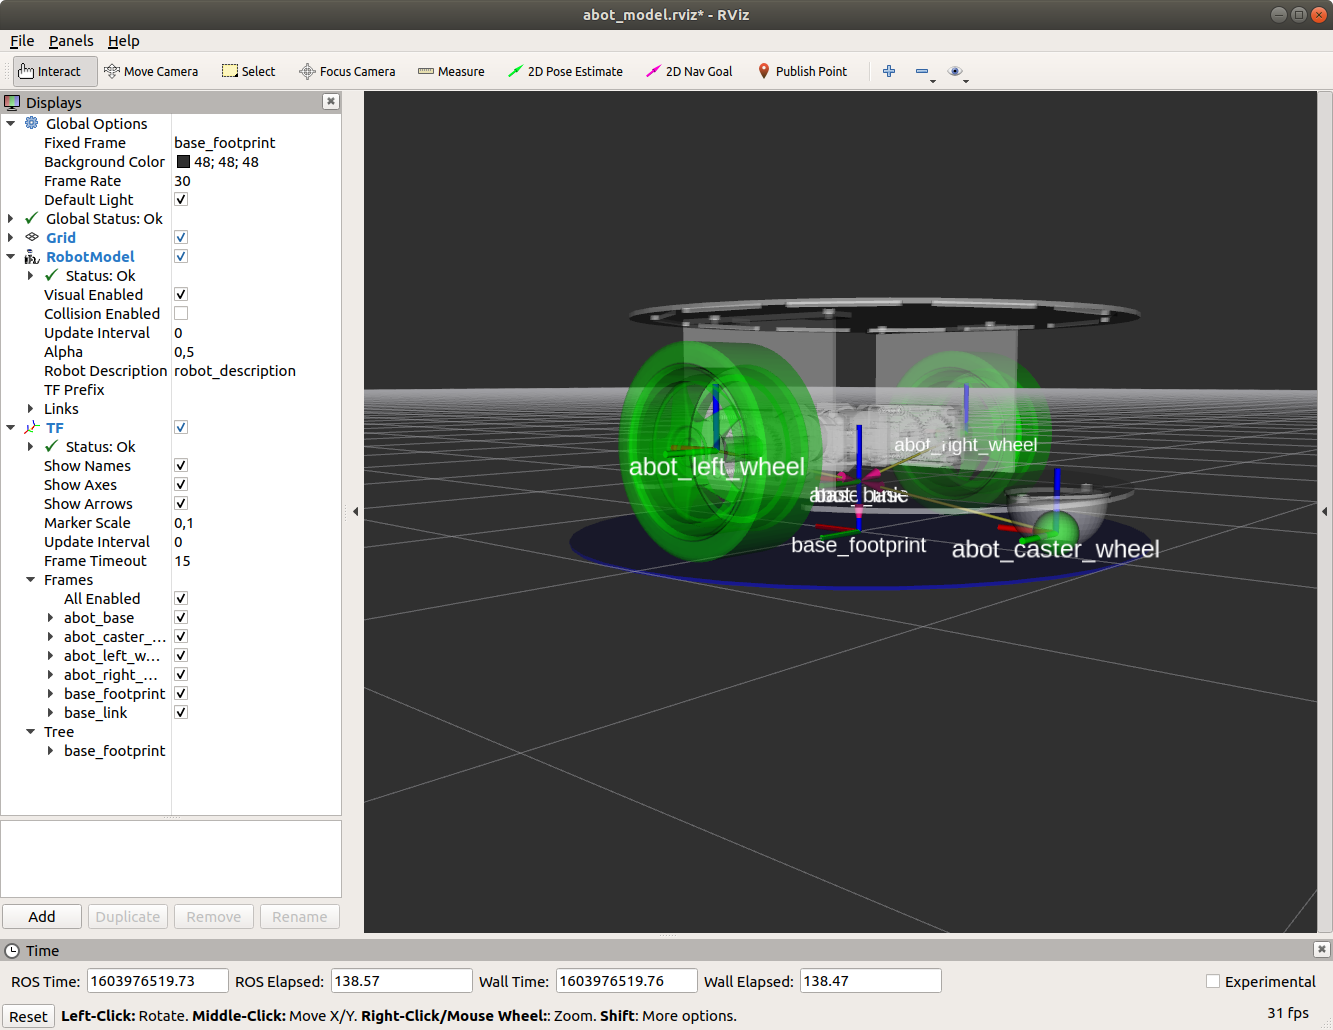
IMG/IMG/2/P7.png
