MikAmperka/abot_src/IMG/IMG/2/R2.png

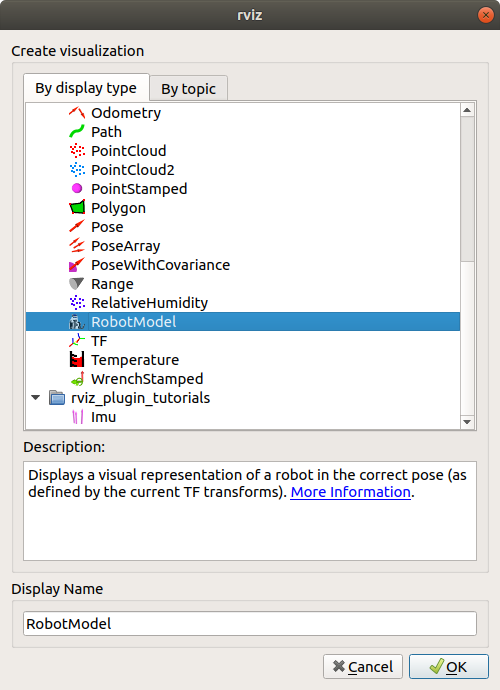
IMG/IMG/2/R2.png
