MikAmperka/abot_src/IMG/IMG/CAP_PINOUT_800.png

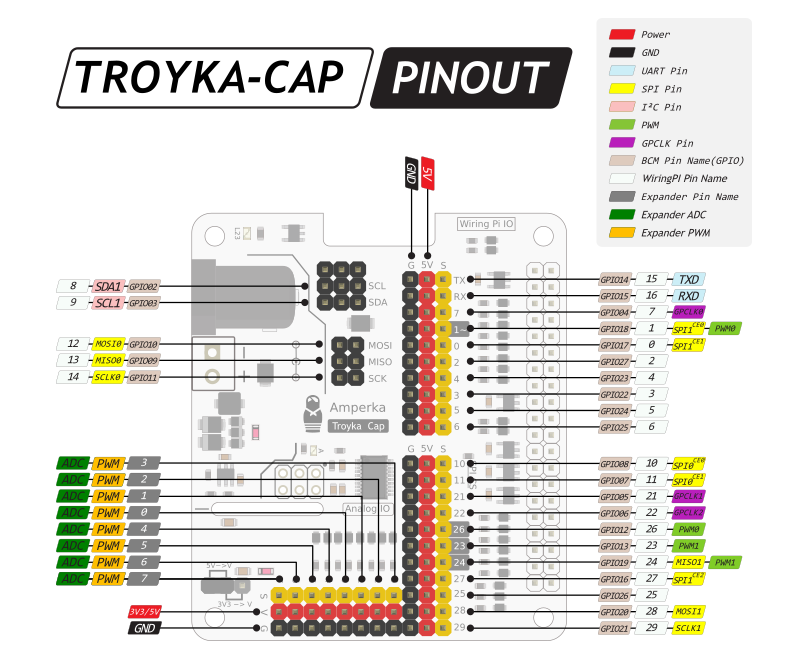
IMG/IMG/CAP_PINOUT_800.png
