MikAmperka/abot_src/IMG/IMG/rplidar_A1.png

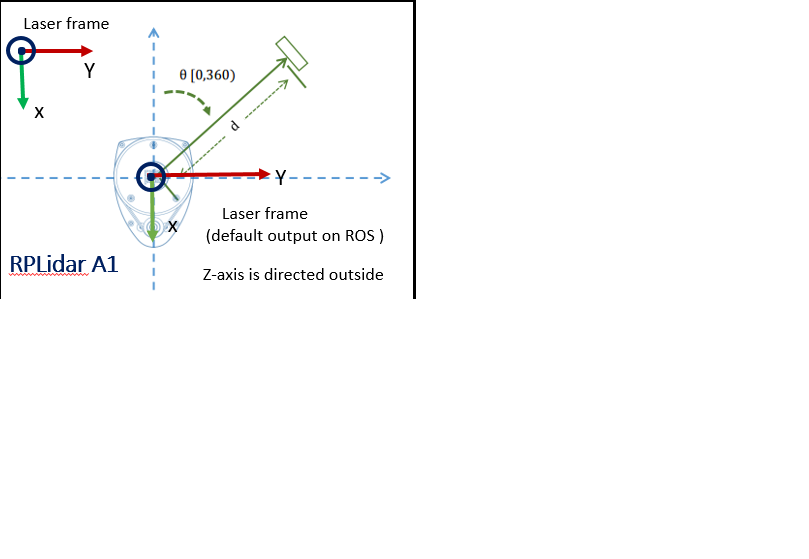
IMG/IMG/rplidar_A1.png
