MikAmperka/abot_src/IMG/IMG/TROYKA_CAP_800.jpg

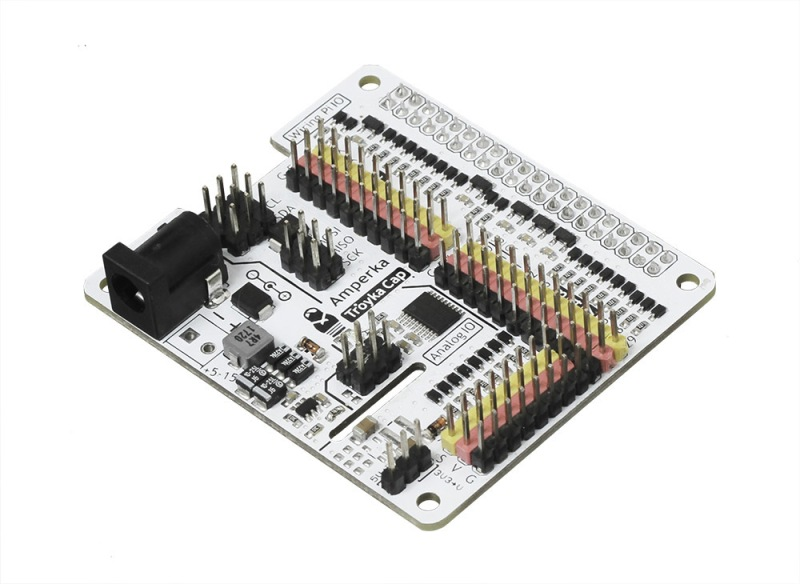
IMG/IMG/TROYKA_CAP_800.jpg
