MikAmperka/abot_src/IMG/IMG_CAD/1-2.png

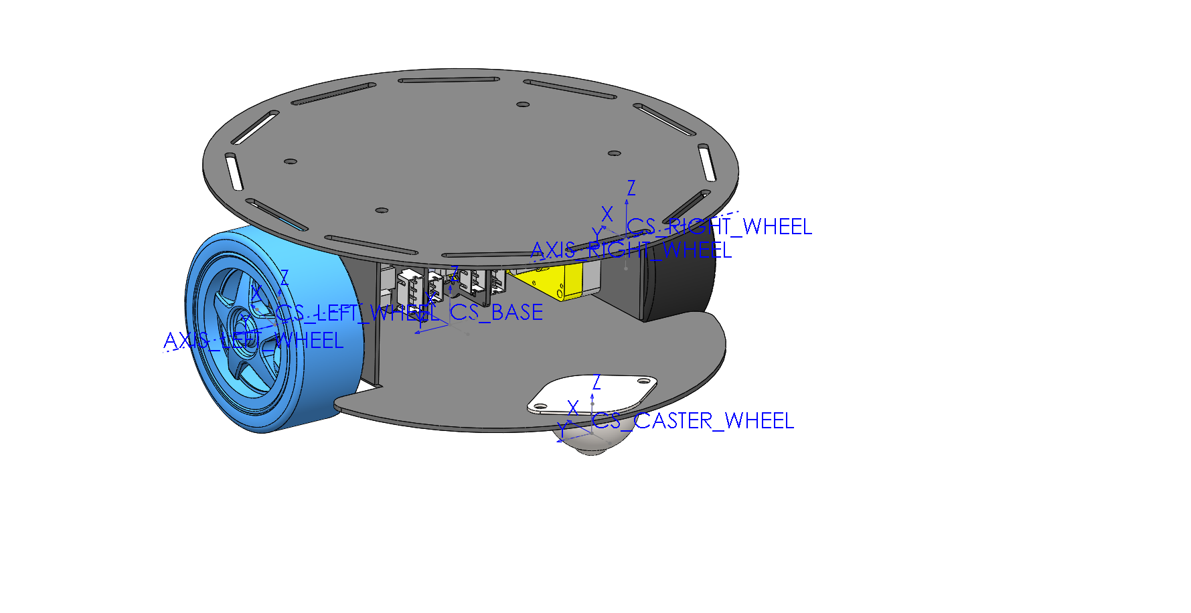
IMG/IMG_CAD/1-2.png
