MikAmperka/abot_src/IMG/IMG_CAD/1.png

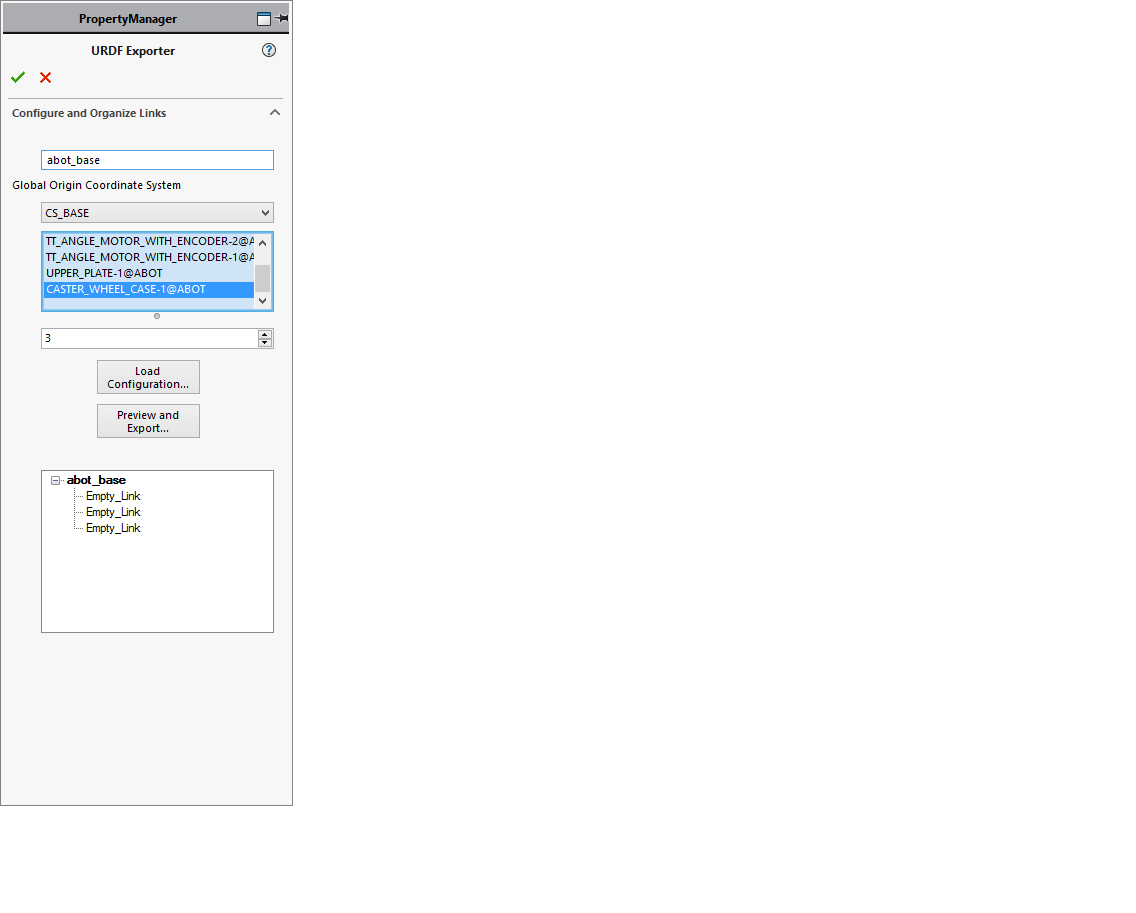
IMG/IMG_CAD/1.png
