MikAmperka/abot_src/IMG/IMG_CAD/2.png

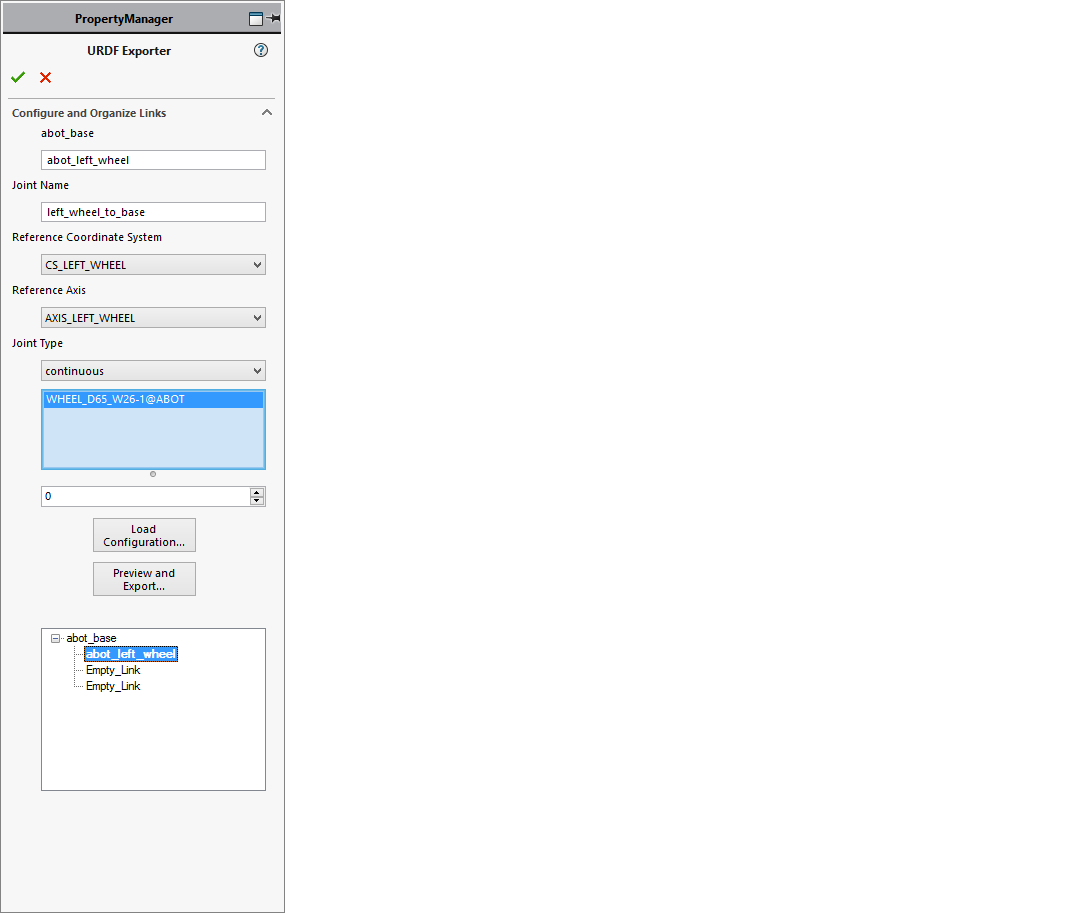
IMG/IMG_CAD/2.png
