MikAmperka/abot_src/IMG/IMG_CAD/3.png

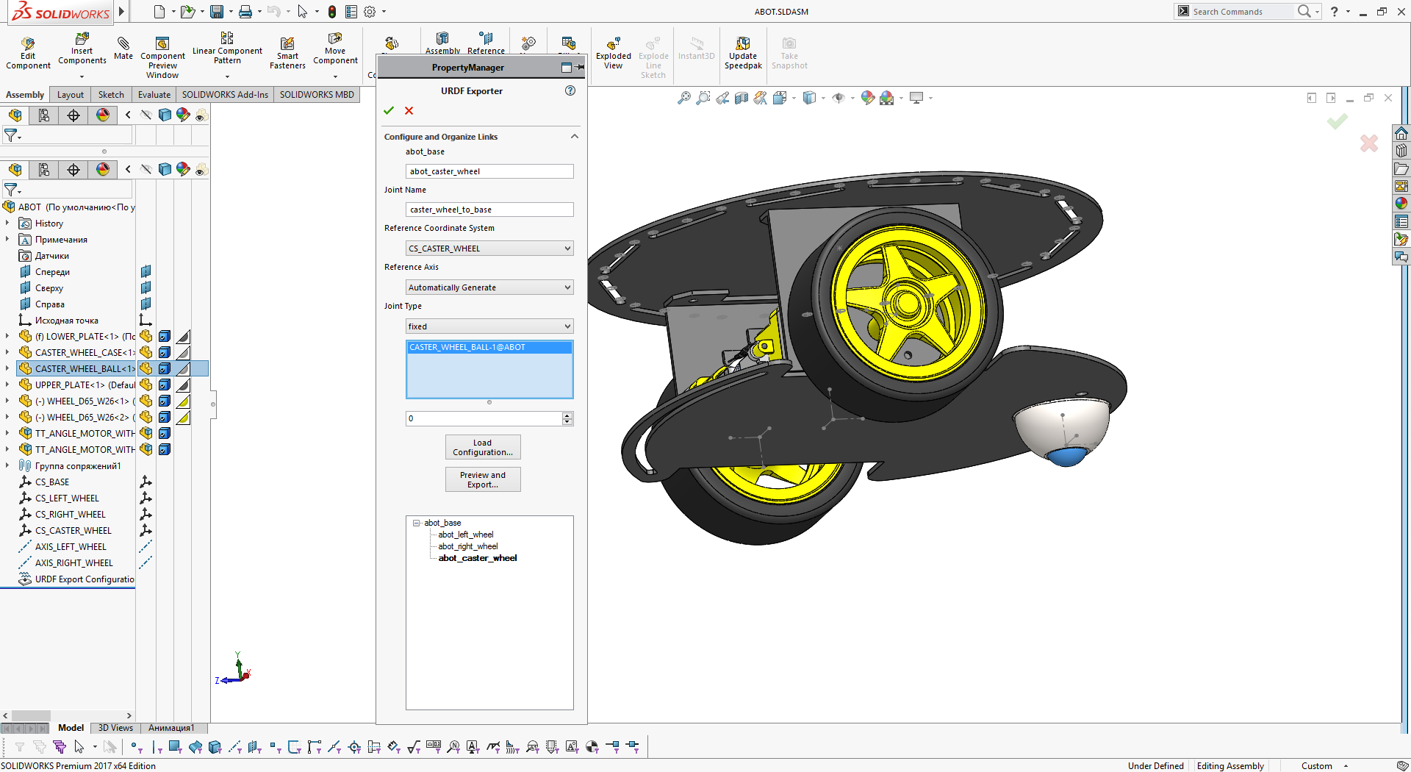
IMG/IMG_CAD/3.png
