MikAmperka/abot_src/IMG/IMG_CAD/4.png

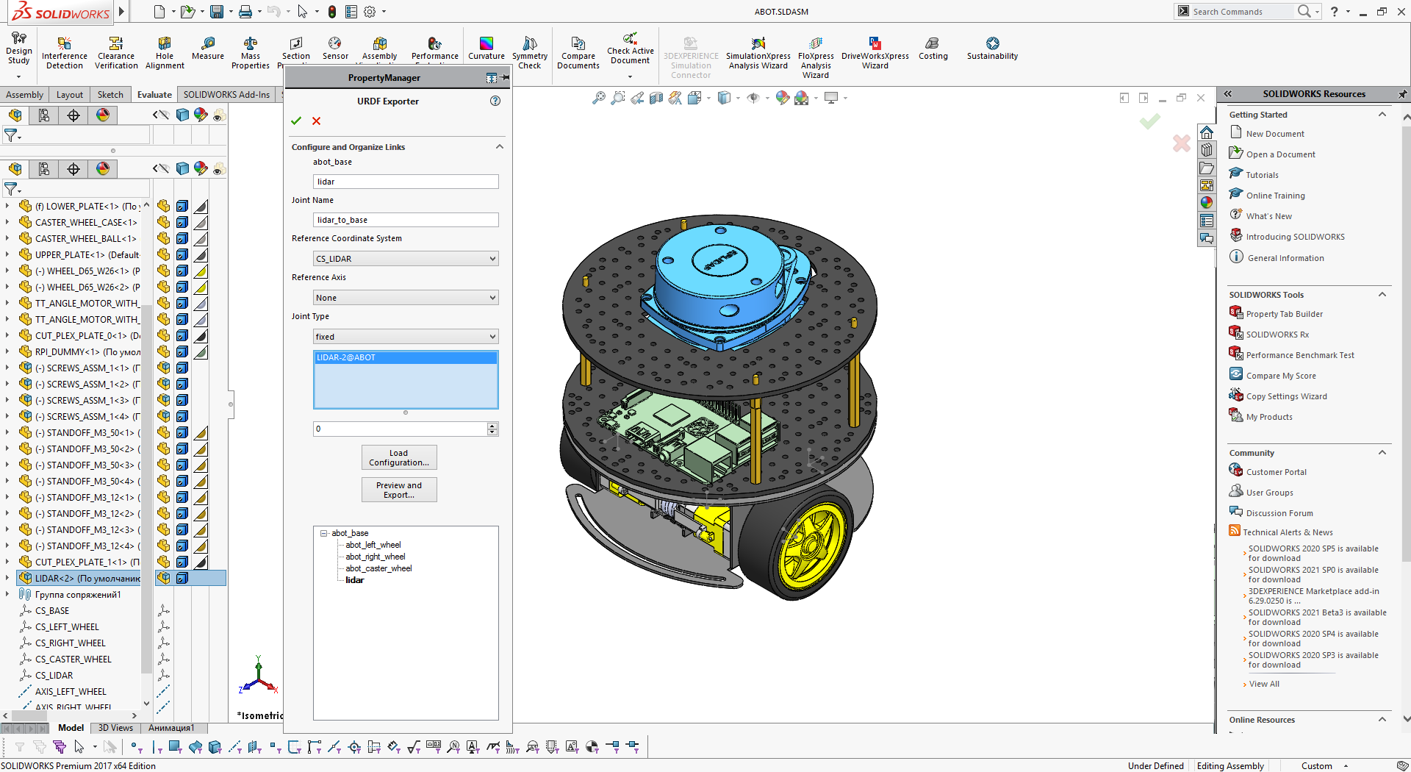
IMG/IMG_CAD/4.png
