MikAmperka/abot_src/IMG/IMG_CAD/5.PNG

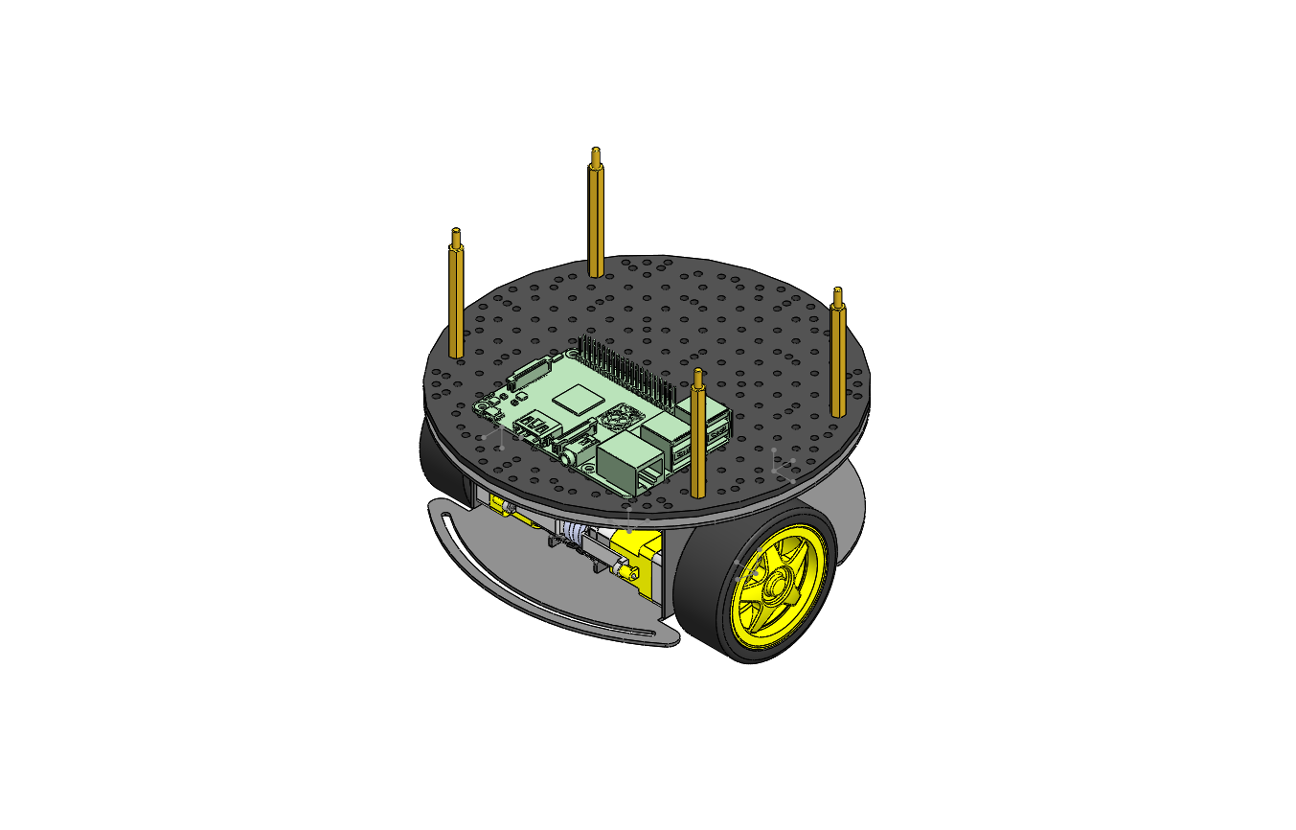
IMG/IMG_CAD/5.PNG
