MikAmperka/abot_src/IMG/IMG_CAD/6.PNG

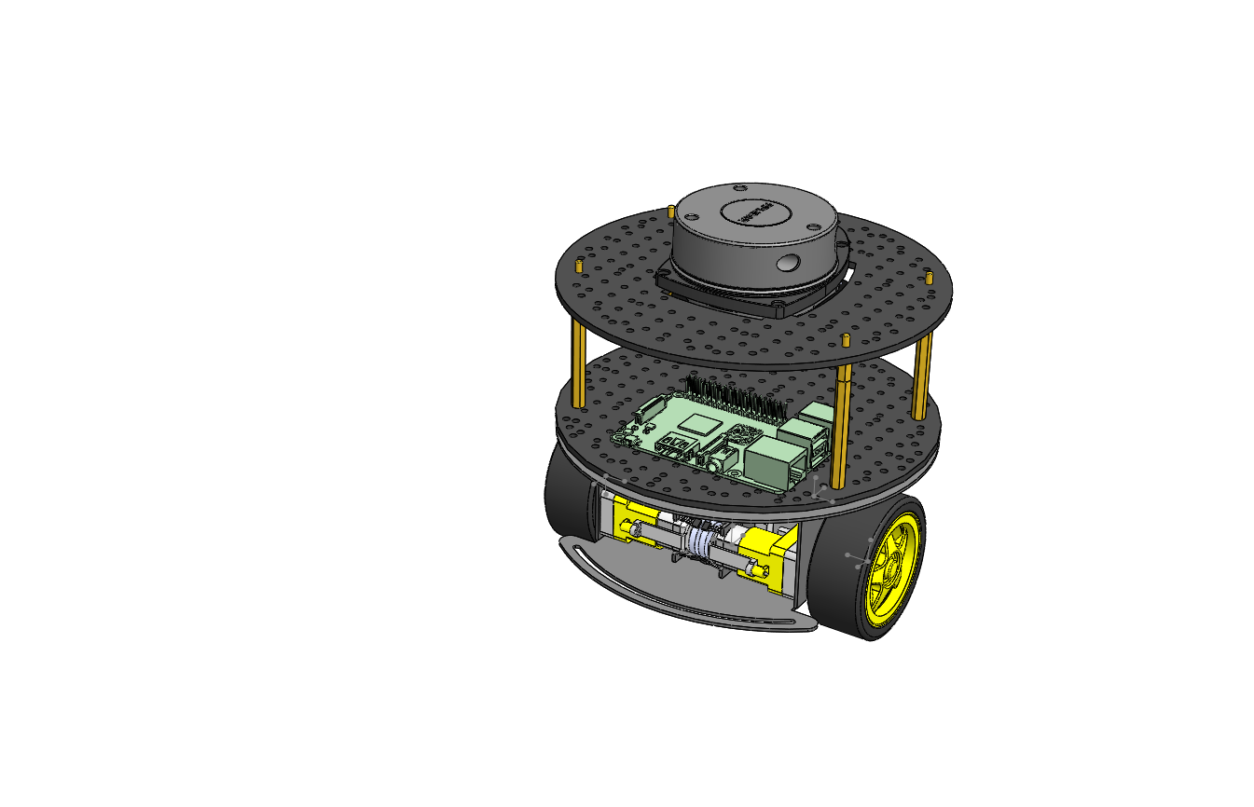
IMG/IMG_CAD/6.PNG
