MikAmperka/abot_src/IMG/IMG_CAD/ABOT_2.PNG

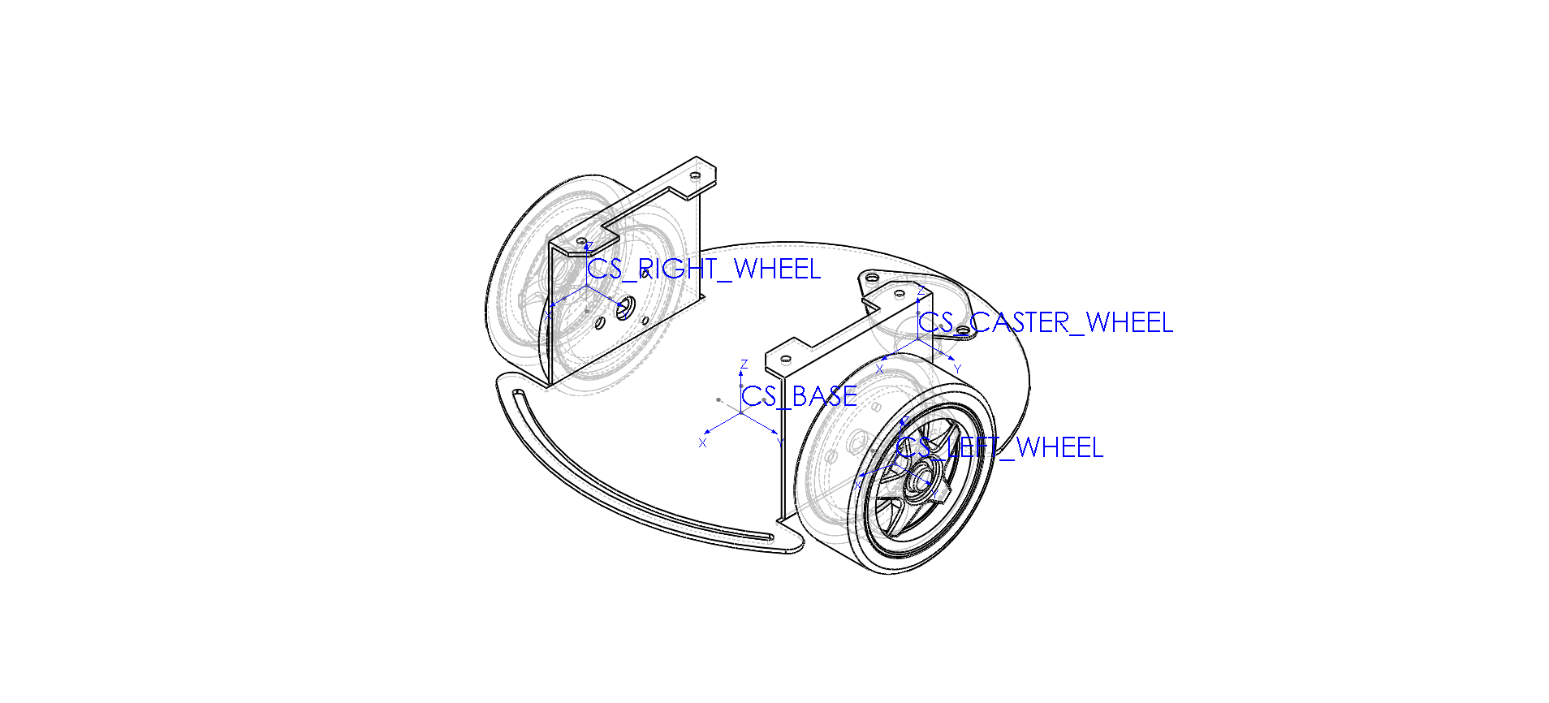
IMG/IMG_CAD/ABOT_2.PNG
