MikAmperka/abot_src/IMG/IMG_CAD/ABOT_11.PNG

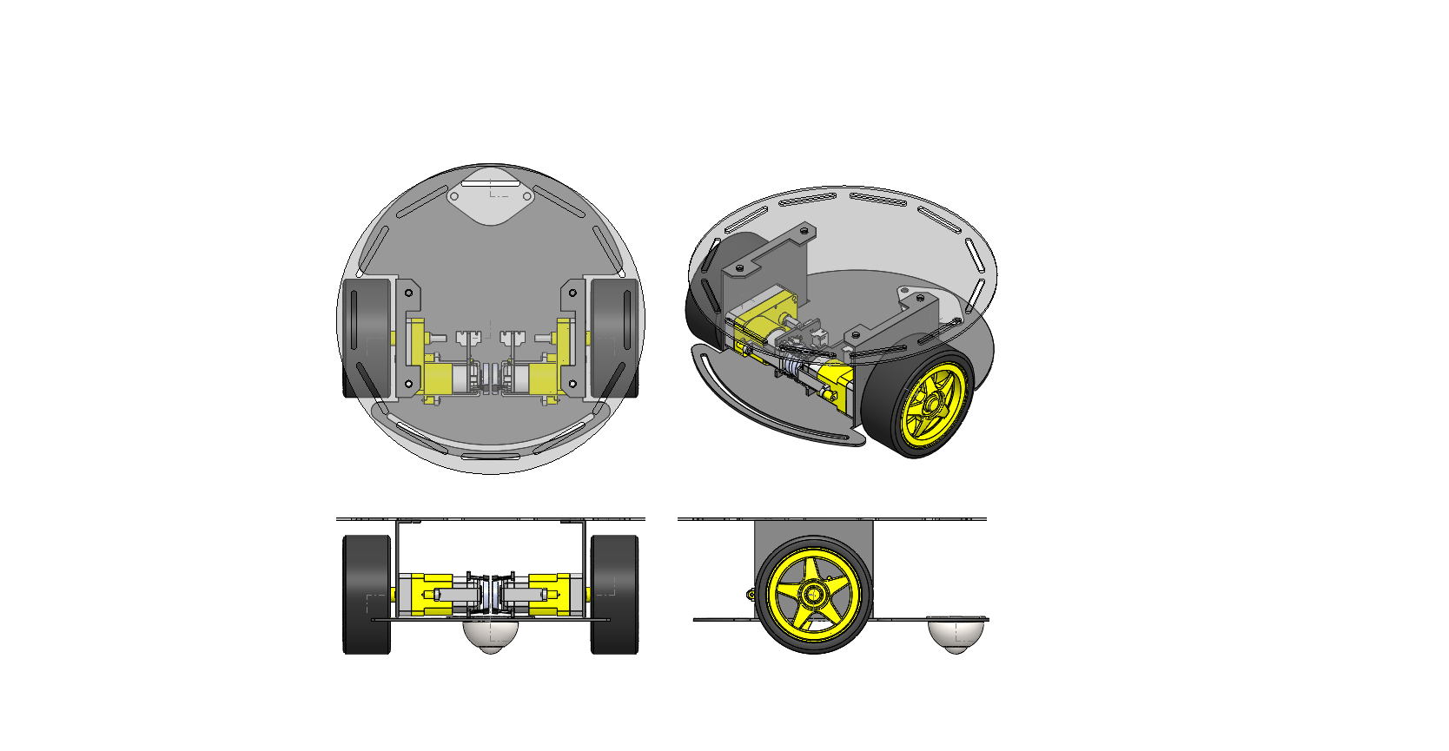
IMG/IMG_CAD/ABOT_11.PNG
