MikAmperka/abot_src/IMG/IMG_CAD/bin/ABOT.PNG

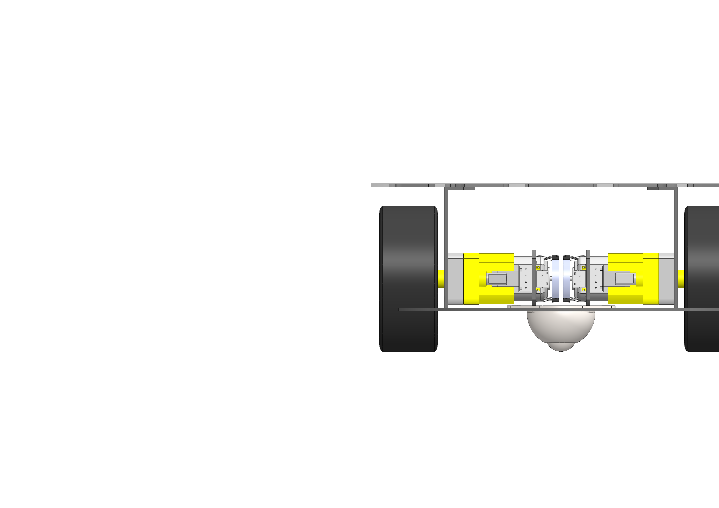
IMG/IMG_CAD/bin/ABOT.PNG
