MikAmperka/abot_src/IMG/IMG_CAD/bin/ABOT_F_1.PNG

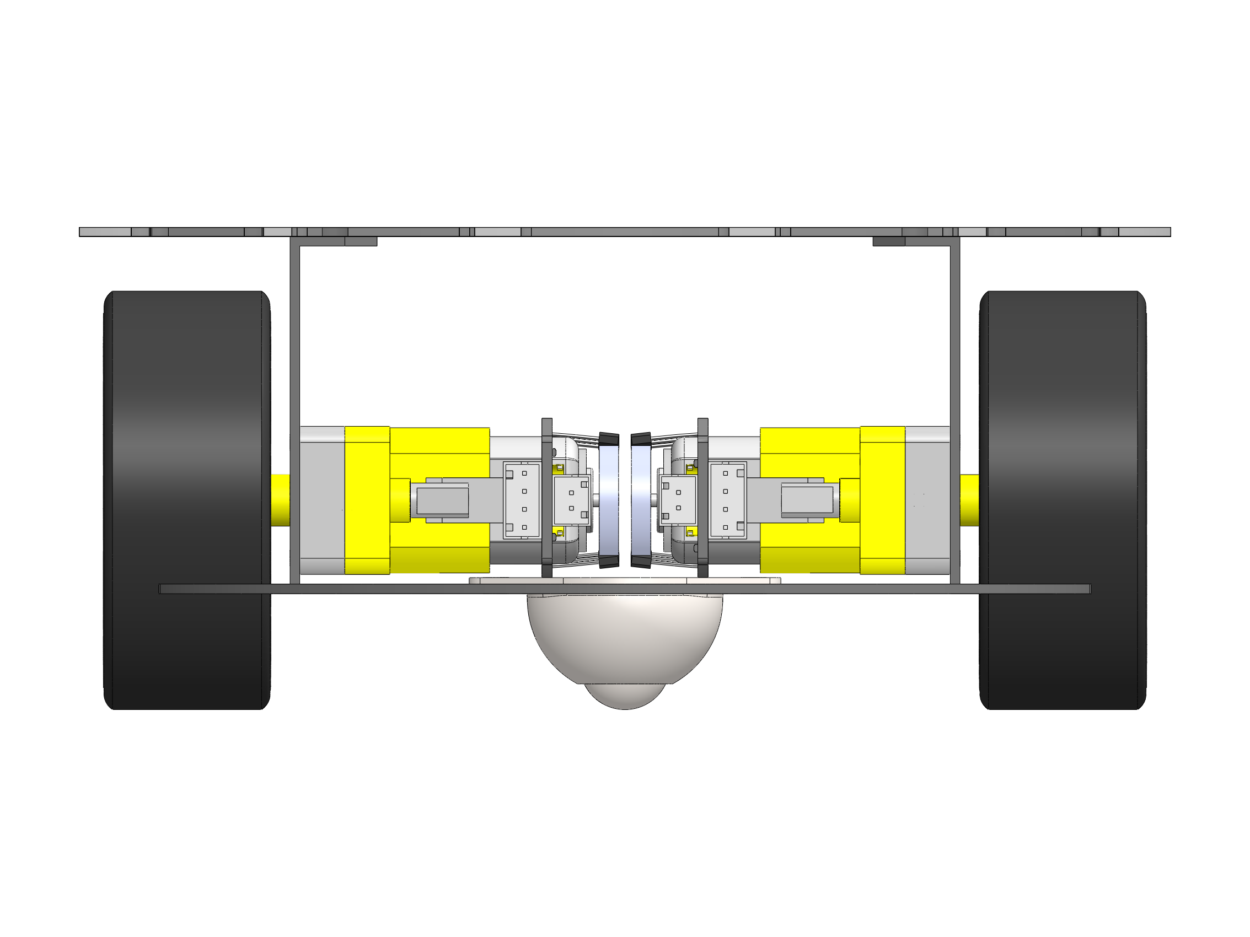
IMG/IMG_CAD/bin/ABOT_F_1.PNG
