MikAmperka/abot_src/IMG/IMG_CAD/bin/ABOT_ISO_1.PNG

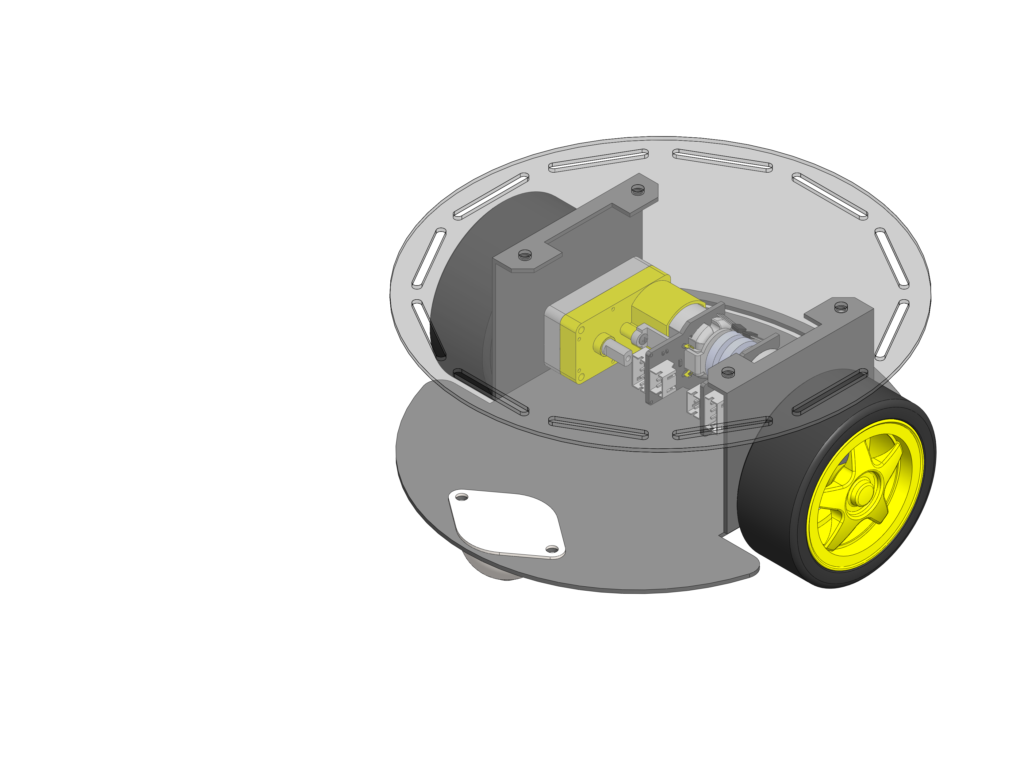
IMG/IMG_CAD/bin/ABOT_ISO_1.PNG
