MikAmperka/abot_src/IMG/IMG_CAD/bin/ABOT_T_1.PNG

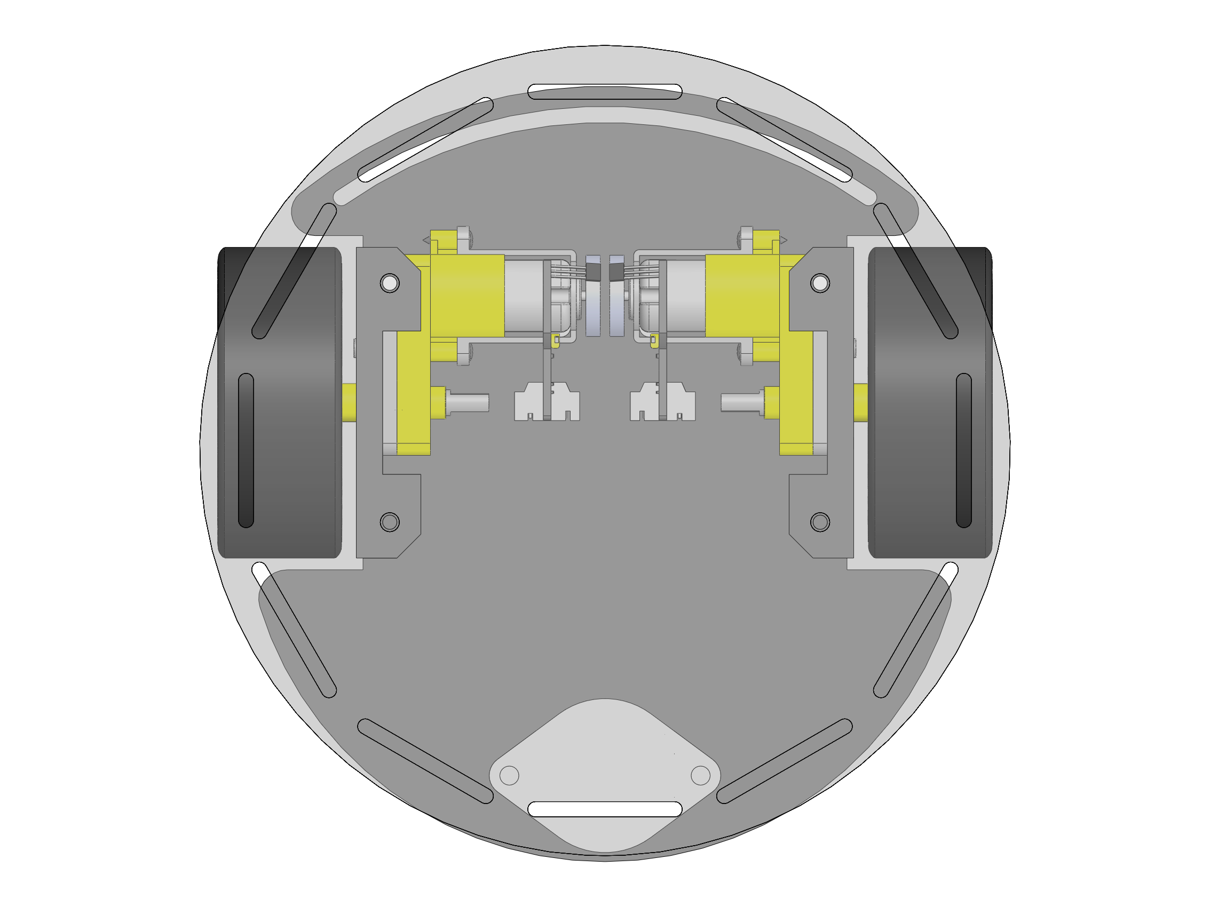
IMG/IMG_CAD/bin/ABOT_T_1.PNG
