MikAmperka/abot_src/IMG/IMG_CAD/READY/2-1-1-1.png

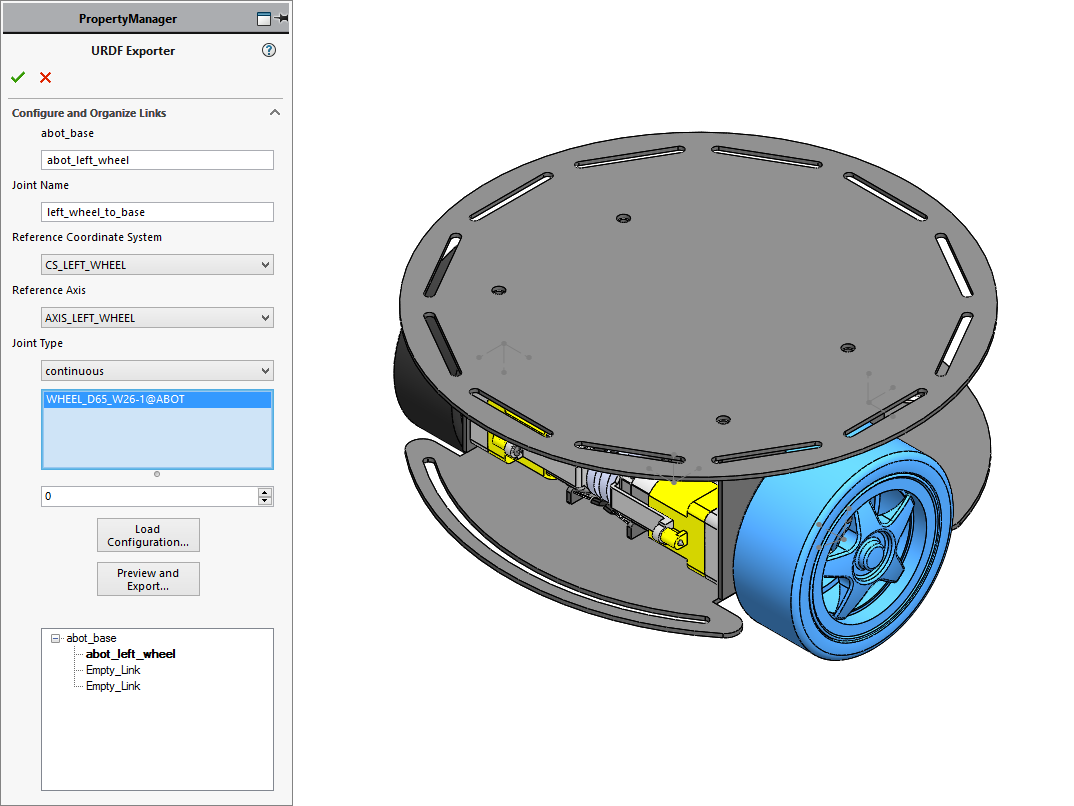
IMG/IMG_CAD/READY/2-1-1-1.png
