MikAmperka/abot_src/IMG/IMG_CAD/READY/5-1.png

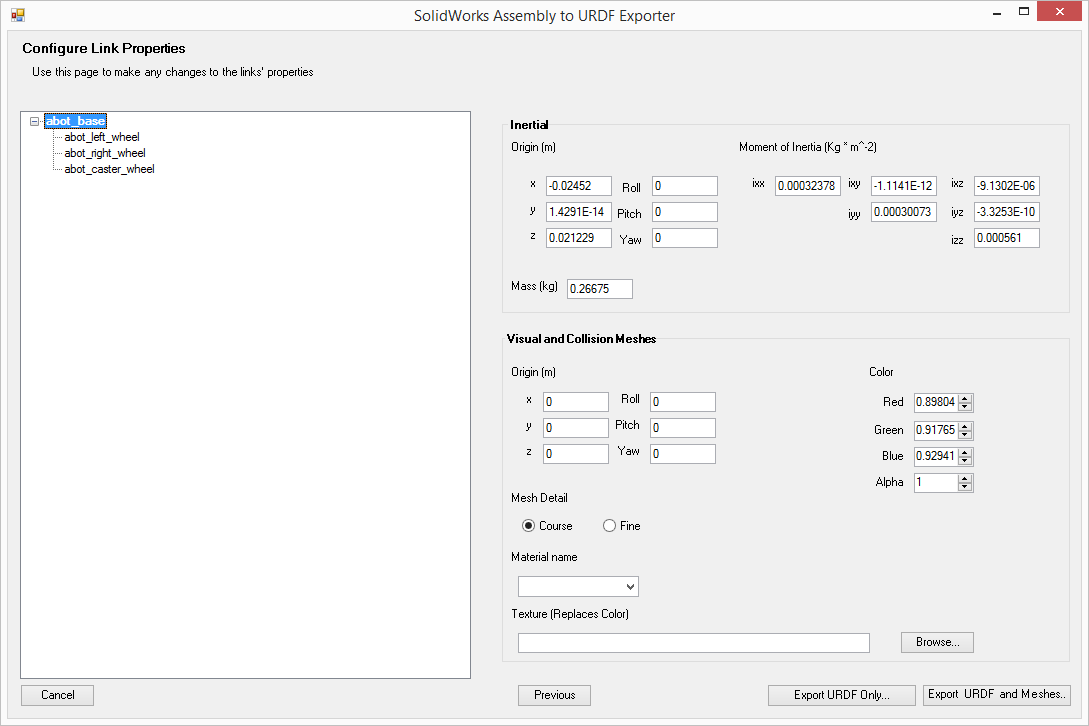
IMG/IMG_CAD/READY/5-1.png
