MikAmperka/abot_src/IMG/IMG_CAD/READY/6.png

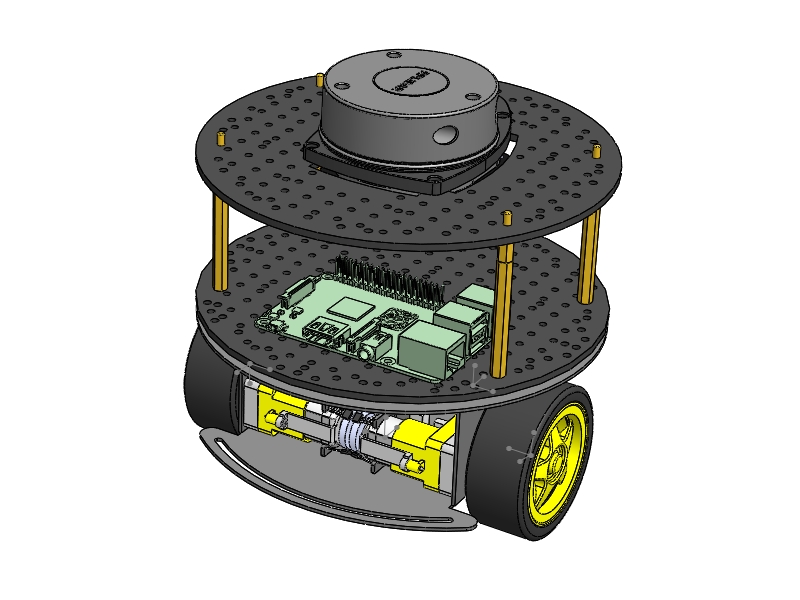
IMG/IMG_CAD/READY/6.png
