MikAmperka/abot_src/IMG/IMG_CAD/READY/ABOT_2.png

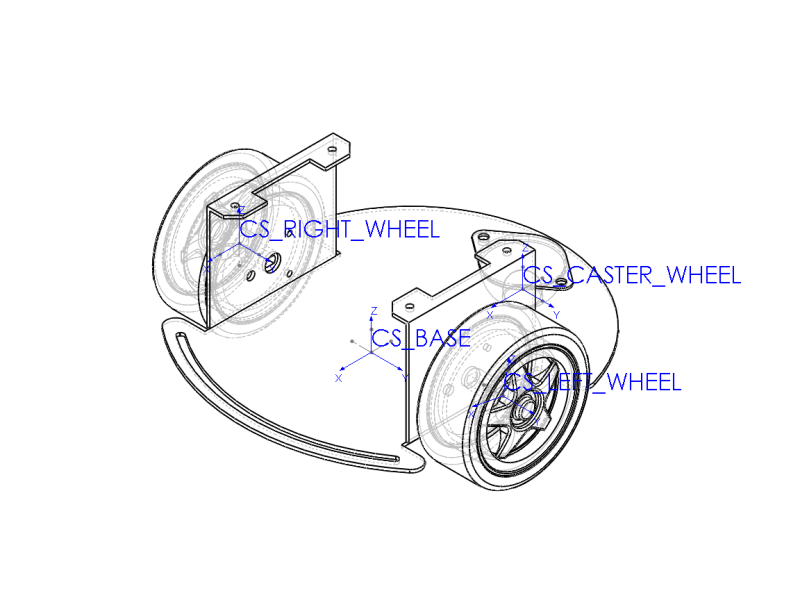
IMG/IMG_CAD/READY/ABOT_2.png
