MikAmperka/abot_src/IMG/IMG_CAD/READY_2/abot_1.PNG

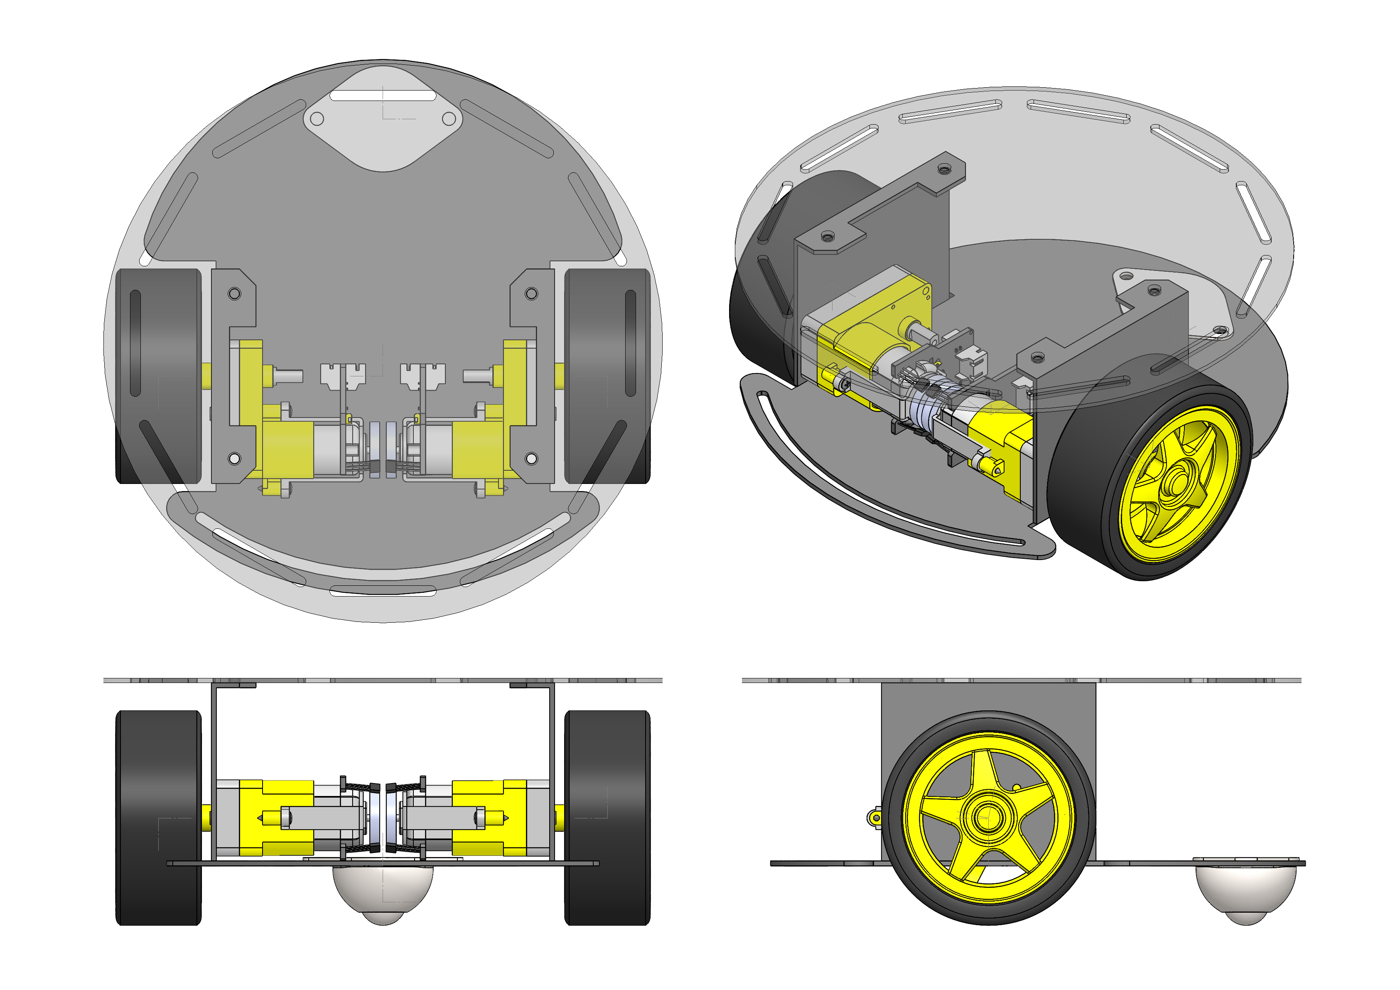
IMG/IMG_CAD/READY_2/abot_1.PNG
