MikAmperka/abot_src/IMG/IMG_CAD/READY_2/abot_9.PNG

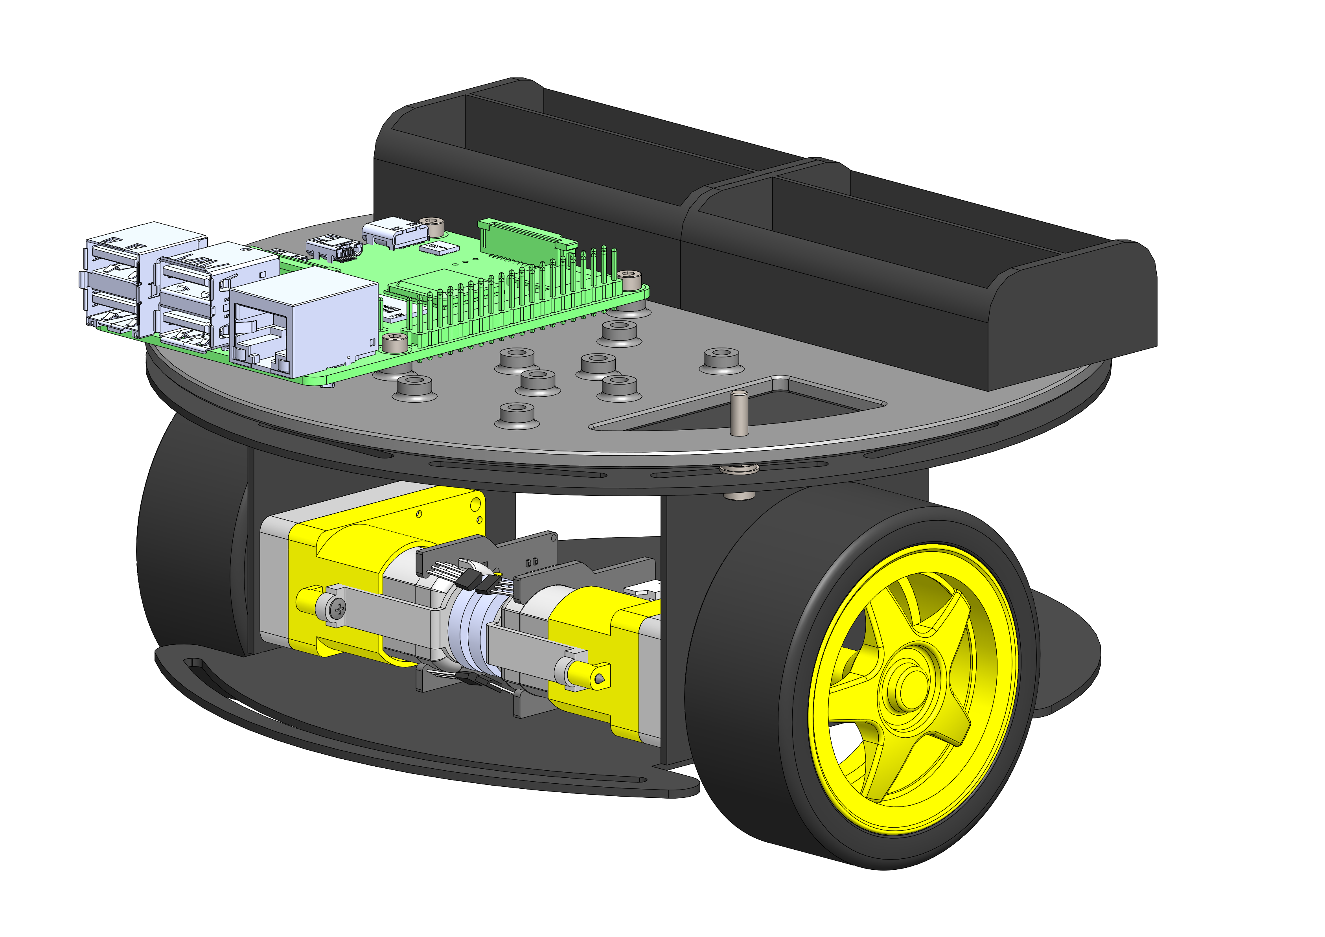
IMG/IMG_CAD/READY_2/abot_9.PNG
