MikAmperka/abot_src/IMG/LINUX/Screenshot from 2021-06-13 21-23-16.png

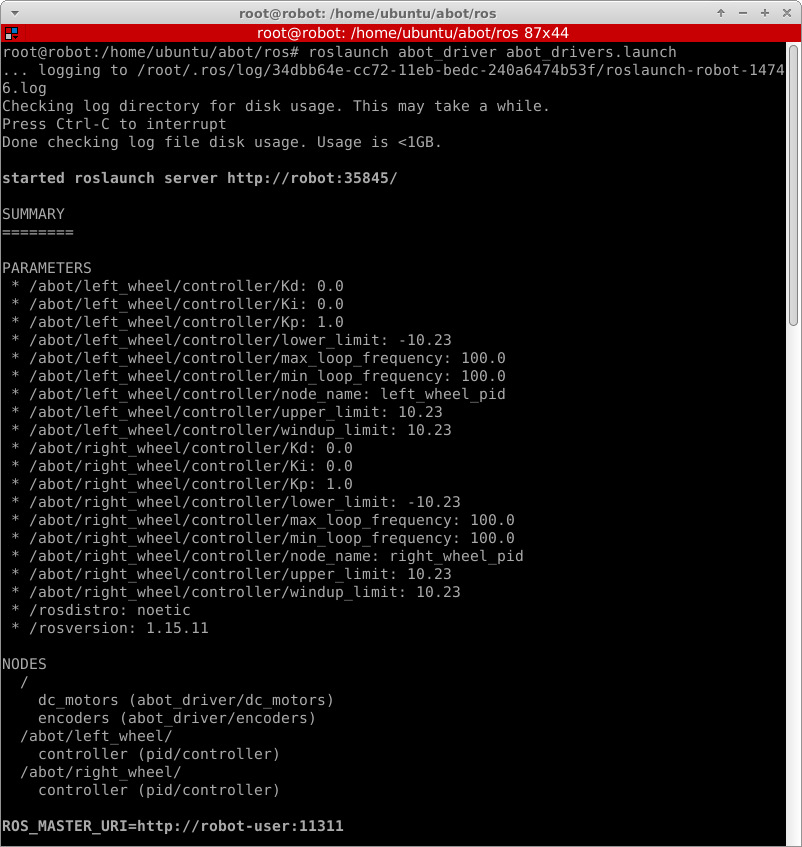
IMG/LINUX/Screenshot from 2021-06-13 21-23-16.png
