MikAmperka/abot_src/IMG/LINUX/Screenshot from 2021-06-13 21-35-25.png

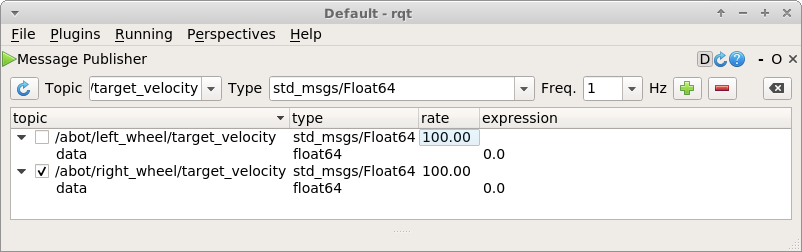
IMG/LINUX/Screenshot from 2021-06-13 21-35-25.png
