MikAmperka/abot_src/IMG/LINUX/Screenshot from 2021-06-13 22-09-54.png

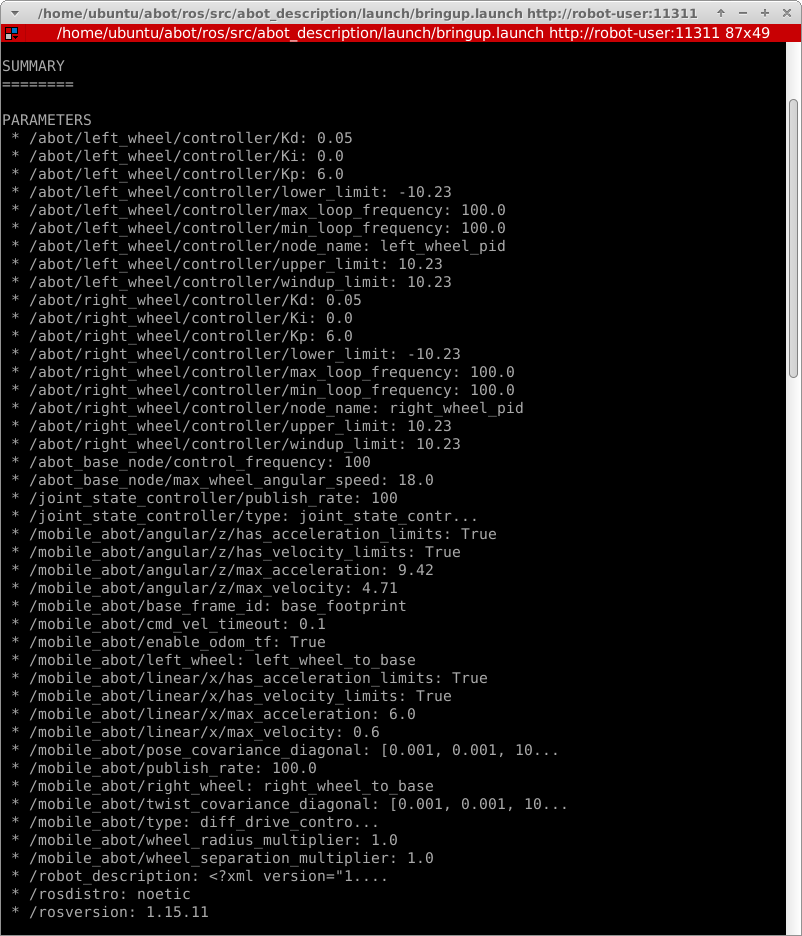
IMG/LINUX/Screenshot from 2021-06-13 22-09-54.png
