MikAmperka/abot_src/IMG/LINUX/Screenshot_2021-06-13_21-03-05.png

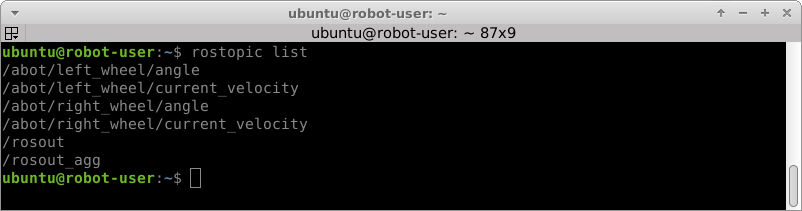
IMG/LINUX/Screenshot_2021-06-13_21-03-05.png
