MikAmperka/abot_src/IMG/LINUX/Screenshot_2021-06-13_21-14-12.png

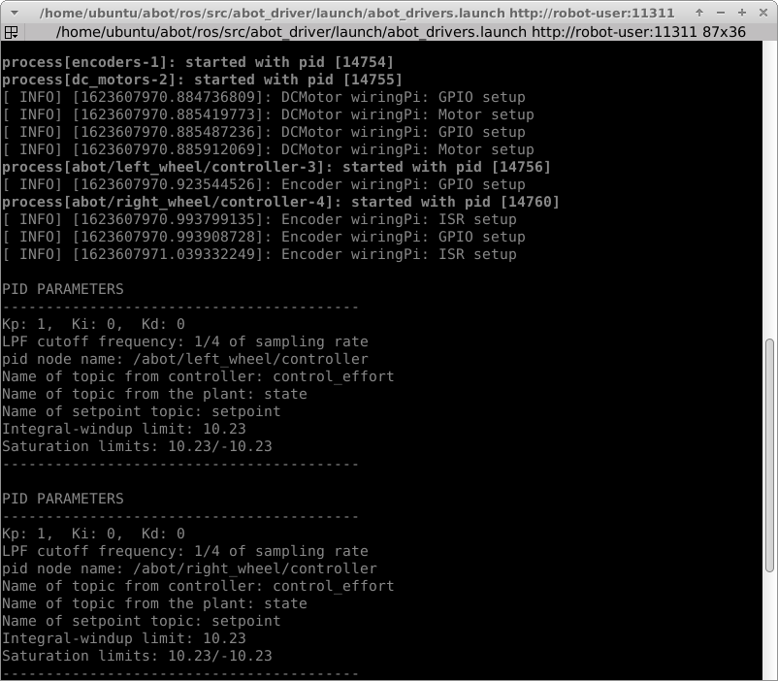
IMG/LINUX/Screenshot_2021-06-13_21-14-12.png
