MikAmperka/abot_src/IMG/LINUX/Снимок экрана_2021-05-25_17-25-52.png

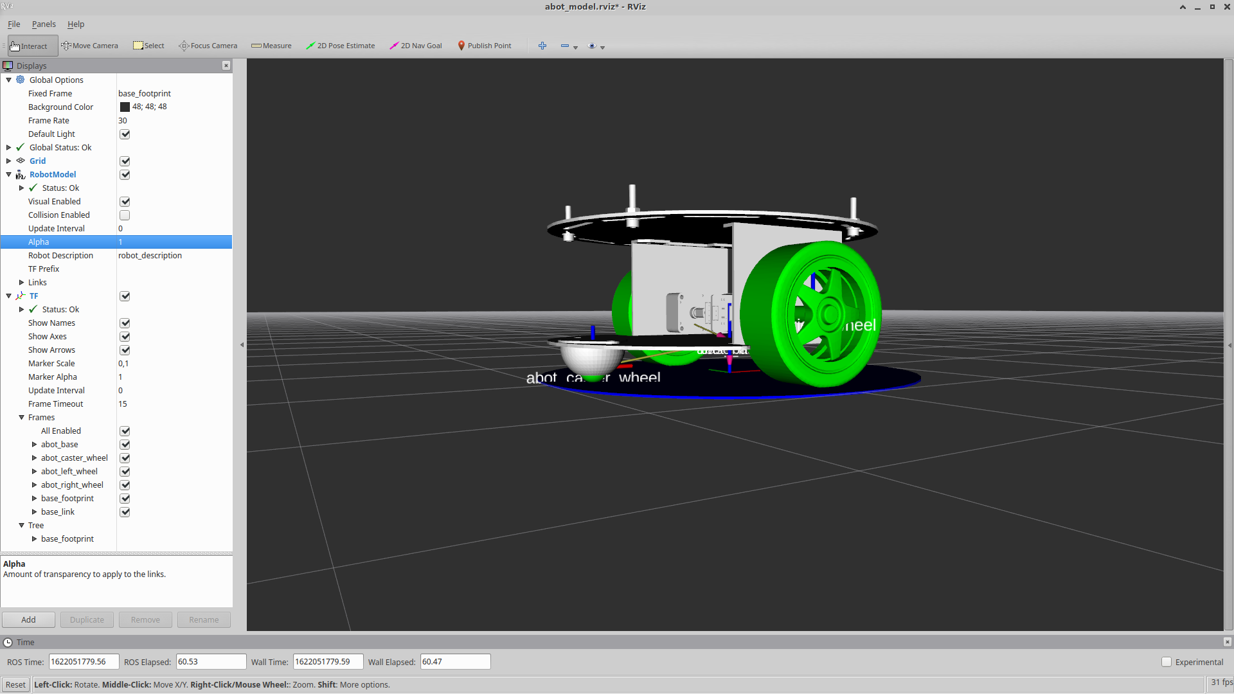
IMG/LINUX/Снимок экрана_2021-05-25_17-25-52.png
