MikAmperka/abot_src/IMG/LINUX/Снимок экрана_2021-05-28_16-23-25.png

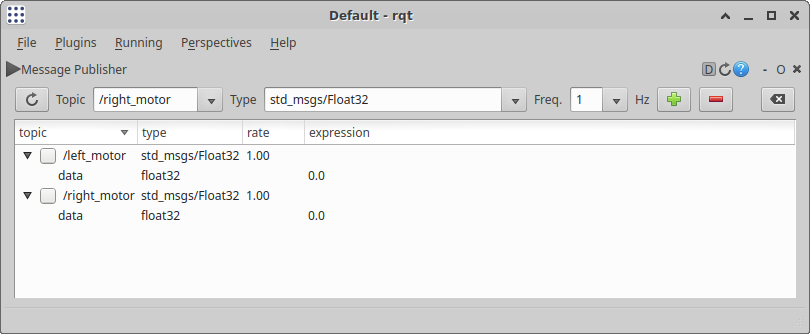
IMG/LINUX/Снимок экрана_2021-05-28_16-23-25.png
