MikAmperka/abot_src/IMG/LINUX/Снимок экрана_2021-05-31_14-33-17.png

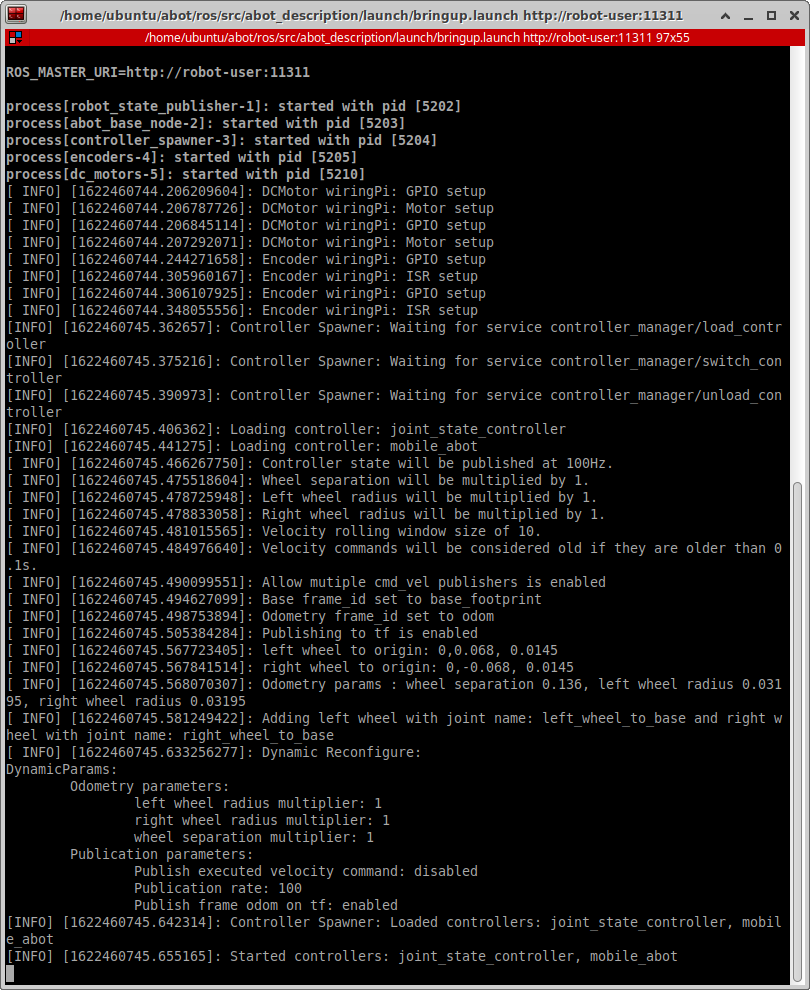
IMG/LINUX/Снимок экрана_2021-05-31_14-33-17.png
