MikAmperka/abot_src/IMG/LINUX/Снимок экрана_2021-06-01_15-47-41.png

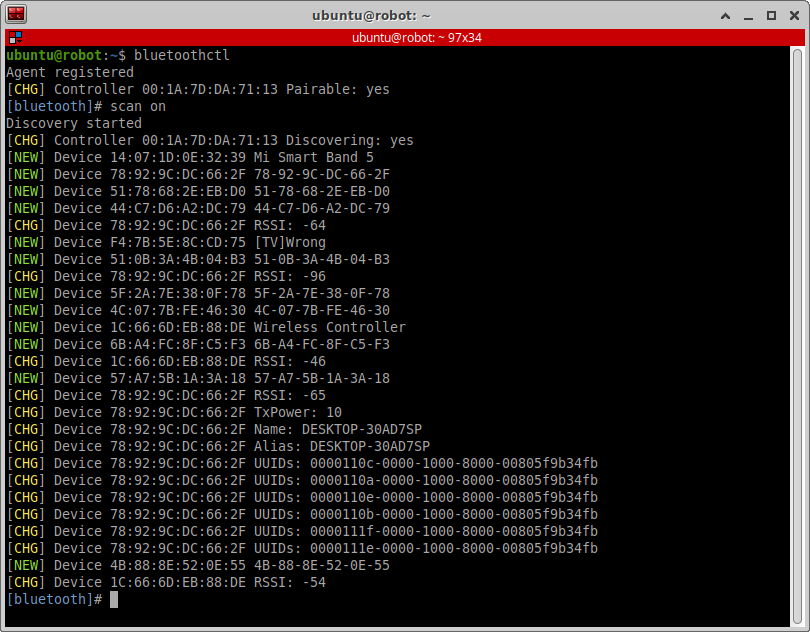
IMG/LINUX/Снимок экрана_2021-06-01_15-47-41.png
