MikAmperka/abot_src/IMG/LINUX/Снимок экрана_2021-06-09_20-35-39.png

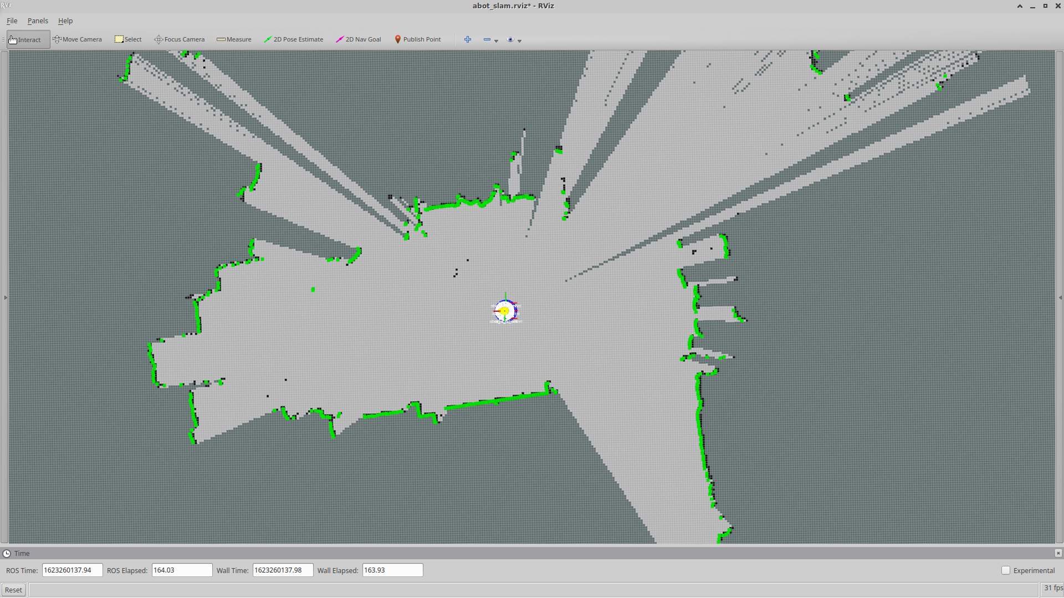
IMG/LINUX/Снимок экрана_2021-06-09_20-35-39.png
