MikAmperka/abot_src/IMG/LINUX/Снимок экрана_2021-06-10_15-49-52.png

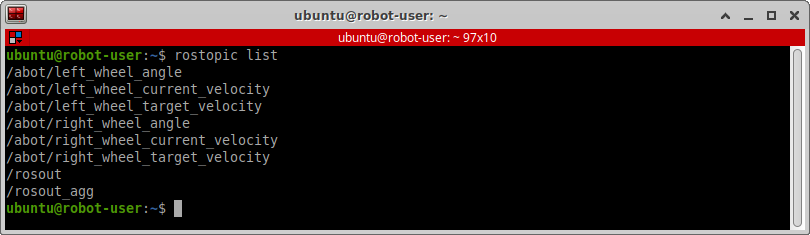
IMG/LINUX/Снимок экрана_2021-06-10_15-49-52.png
