MikAmperka/abot_src/IMG/LINUX/Снимок экрана_2021-06-10_16-10-43.png

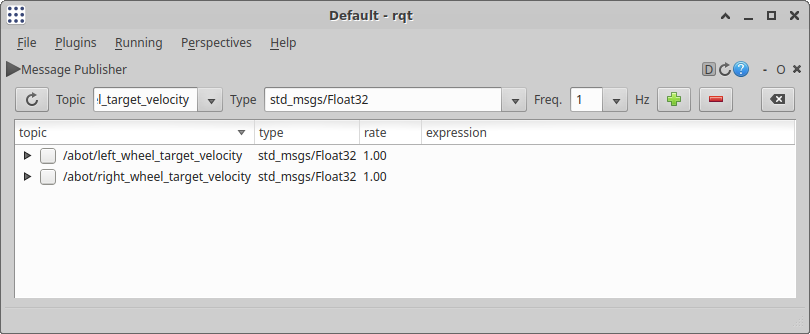
IMG/LINUX/Снимок экрана_2021-06-10_16-10-43.png
