MikAmperka/abot_src/IMG/pdzfIuKIZ2I.jpg

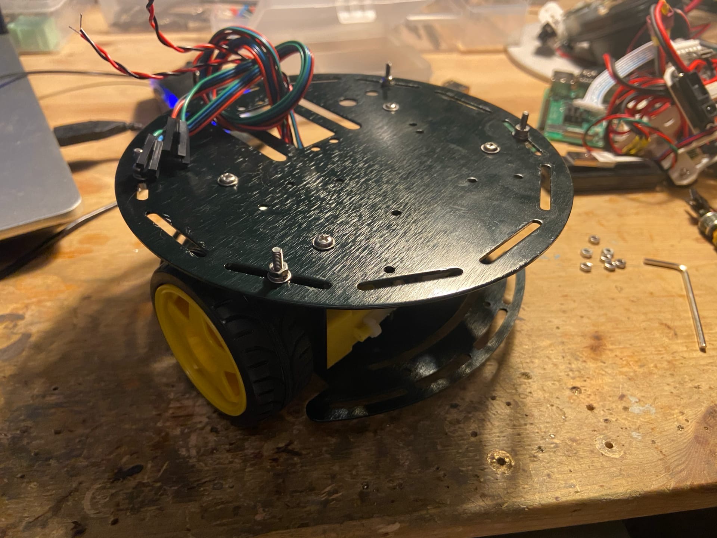
IMG/pdzfIuKIZ2I.jpg
