MikAmperka/abot_src/IMG/PROD/raspberry-troyka-hat.2.jpg

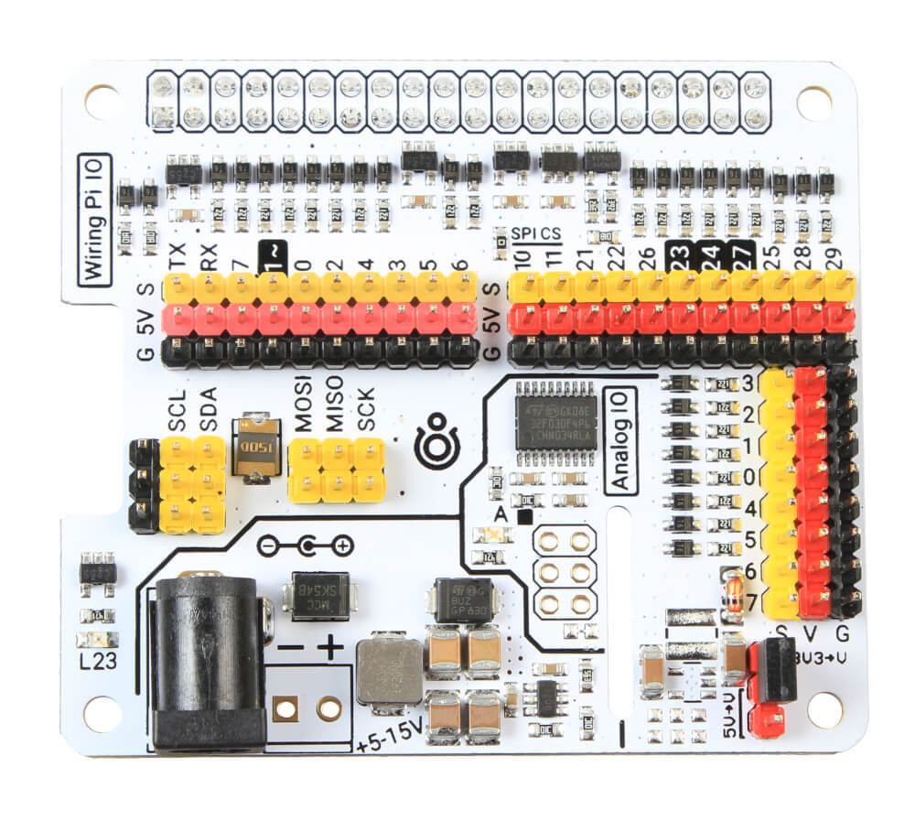
IMG/PROD/raspberry-troyka-hat.2.jpg
