MikAmperka/abot_src/IMG/PROD/raspberry-troyka-hat.6-1.jpg

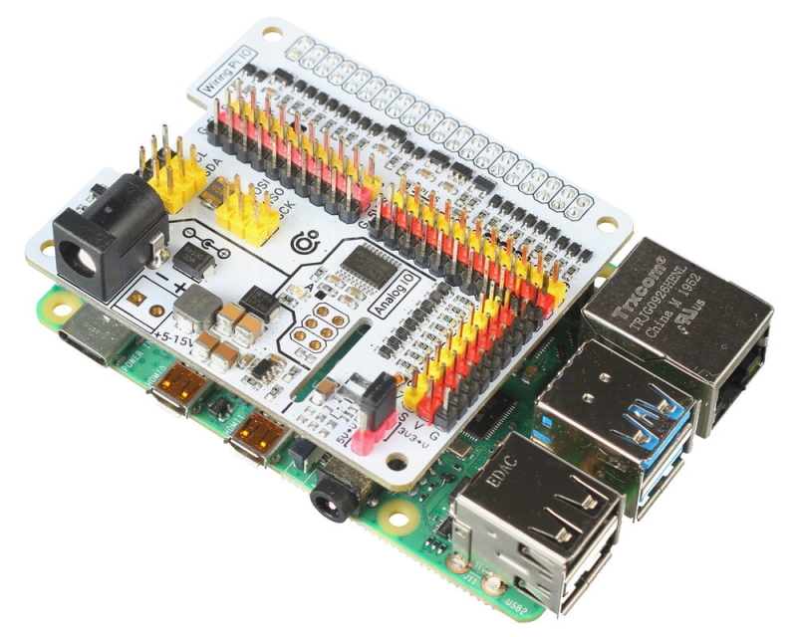
IMG/PROD/raspberry-troyka-hat.6-1.jpg
