MikAmperka/abot_src/IMG/raspberry-pi-troyka-hat-pinout.png

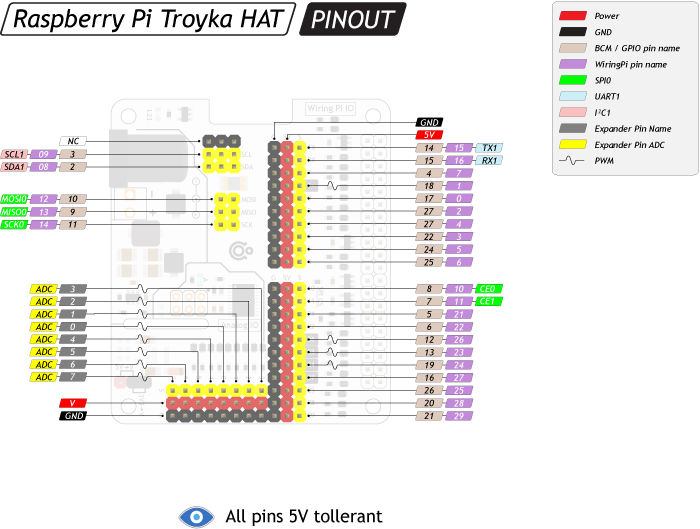
IMG/raspberry-pi-troyka-hat-pinout.png
