MikAmperka/abot_src/IMG/troyka_pad_1x2.1.jpg

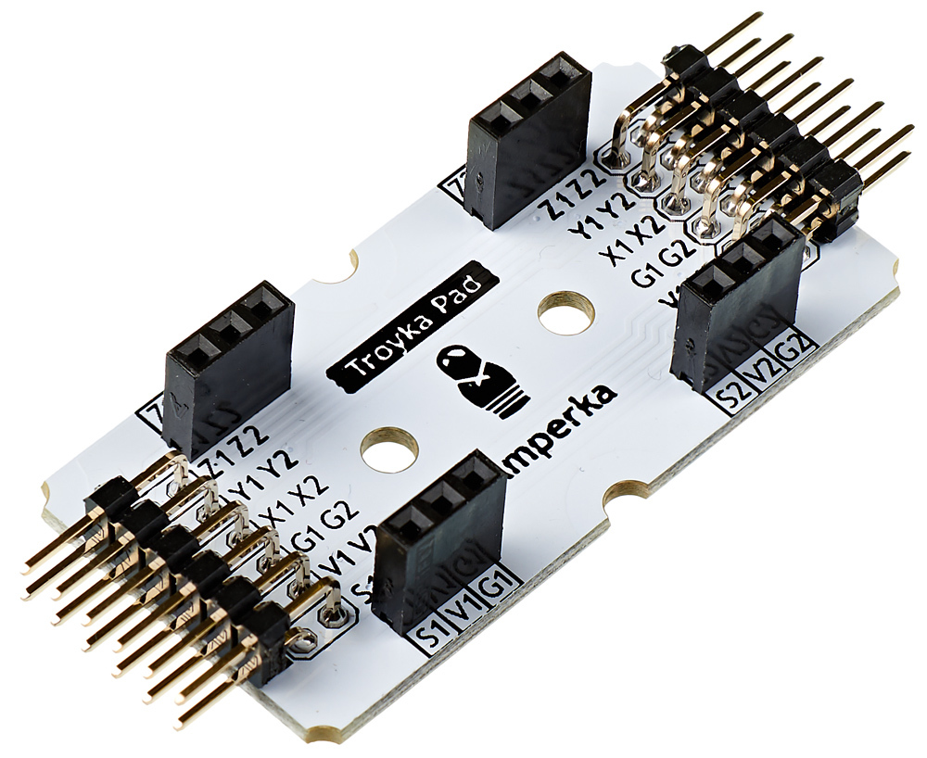
IMG/troyka_pad_1x2.1.jpg
