MikAmperka/abot_src/IMG/turtle-chassis.1.jpg

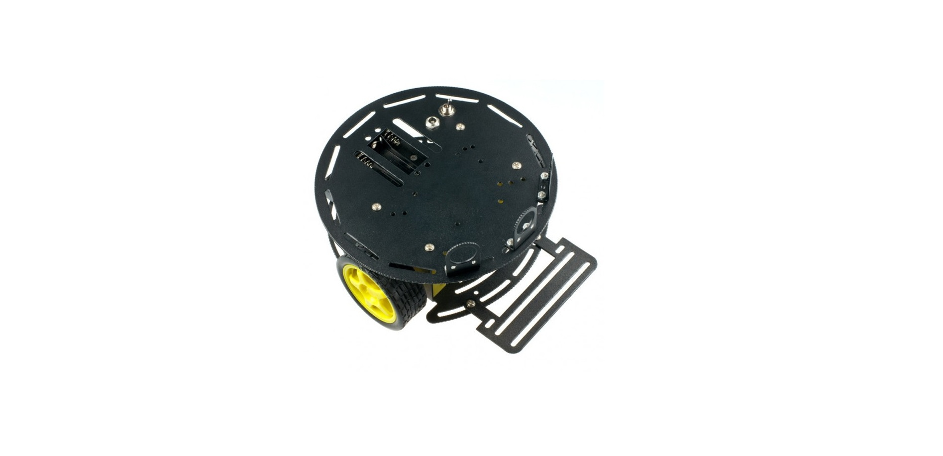
IMG/turtle-chassis.1.jpg
