MikAmperka/abot_src/IMG/W4A9932--900x600_1024x.jpg

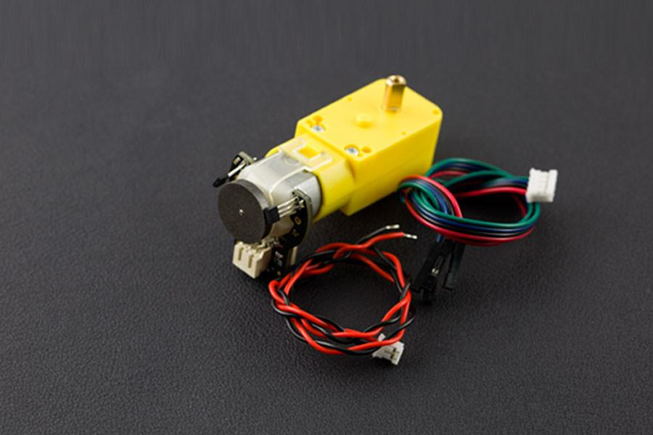
IMG/W4A9932--900x600_1024x.jpg
