MikAmperka/abot_src/PHOTOS/IMG_6408.JPG

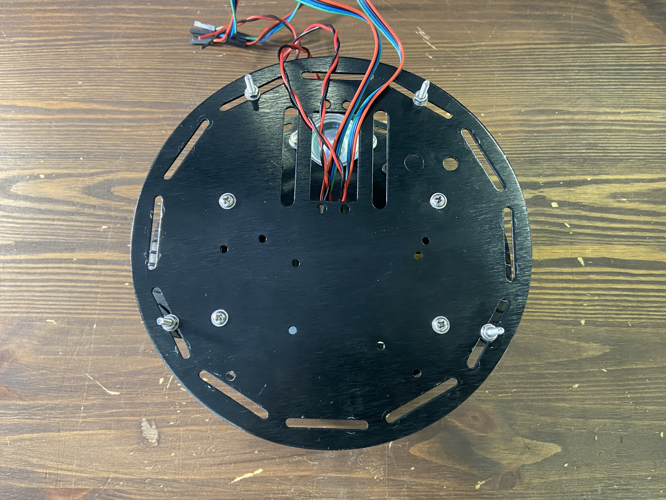
PHOTOS/IMG_6408.JPG
