MikAmperka/abot_src/PHOTOS/IMG_6409.JPG

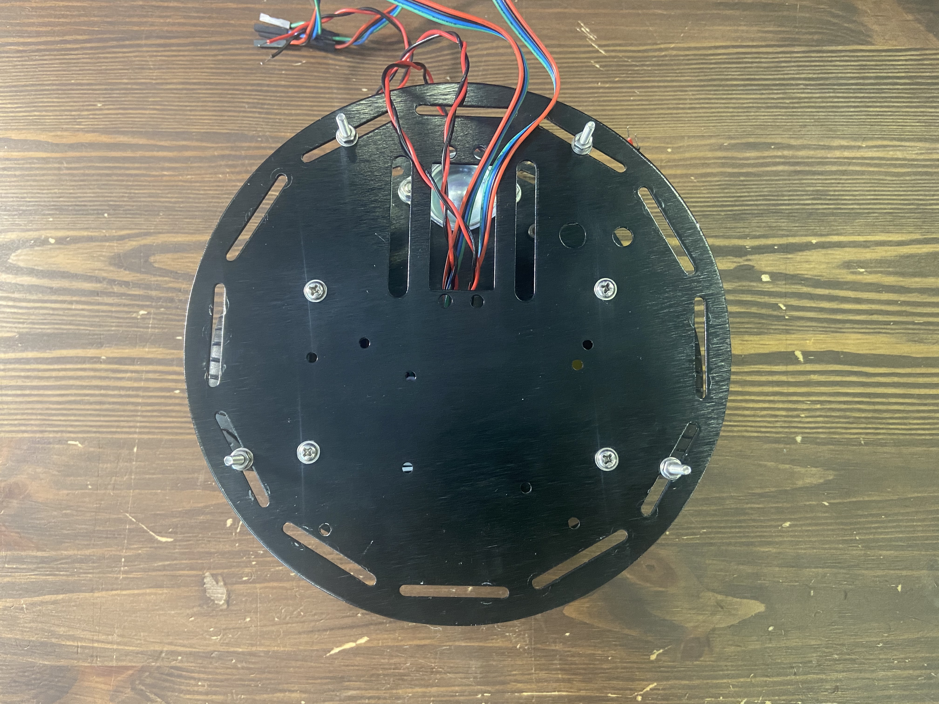
PHOTOS/IMG_6409.JPG
