MikAmperka/abot_src/PHOTOS/IMG_6413.JPG

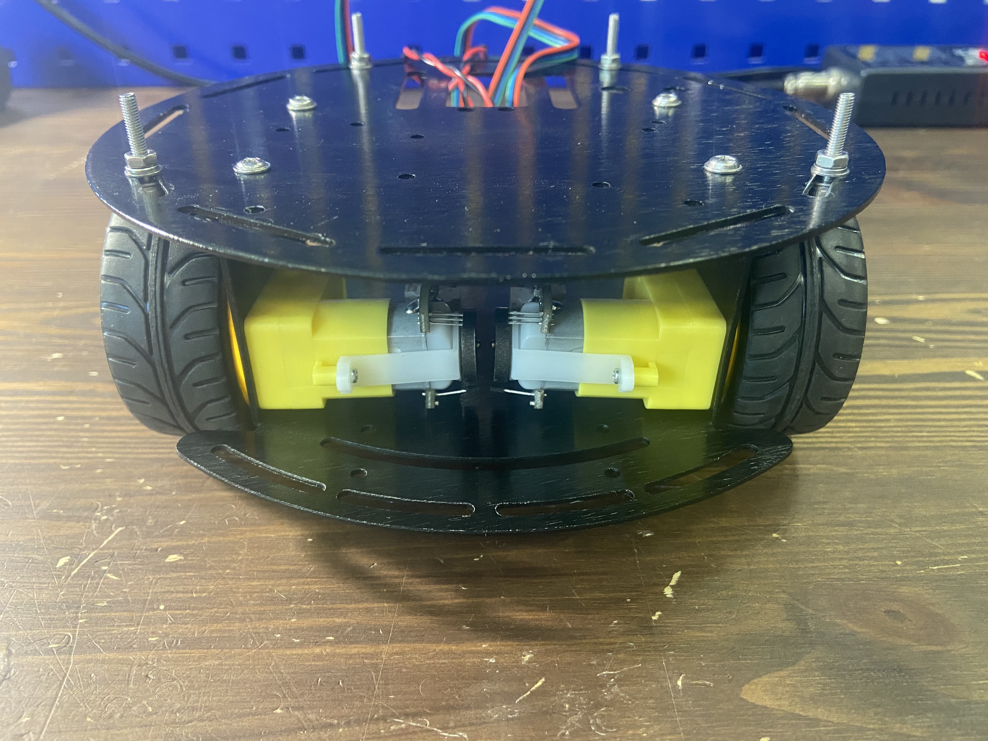
PHOTOS/IMG_6413.JPG
