MikAmperka/abot_src/PHOTOS/IMG_6414.JPG

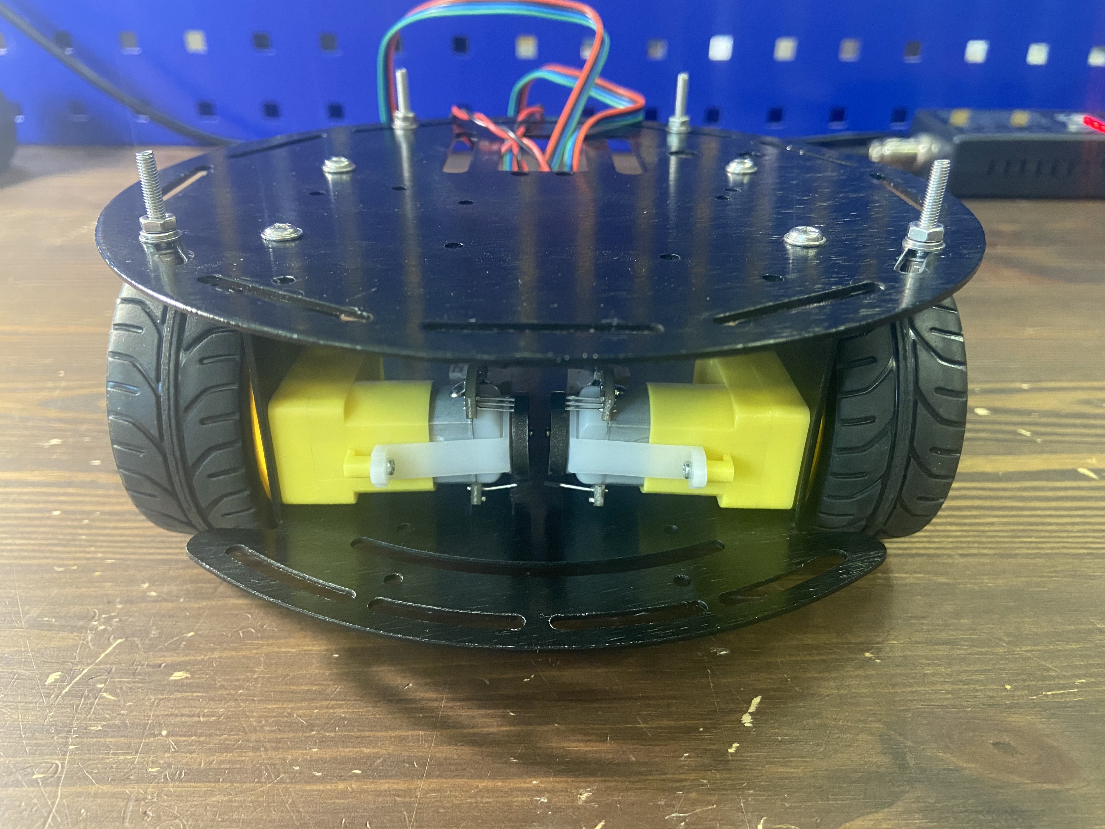
PHOTOS/IMG_6414.JPG
