MikAmperka/abot_src/PHOTOS/IMG_6418.JPG

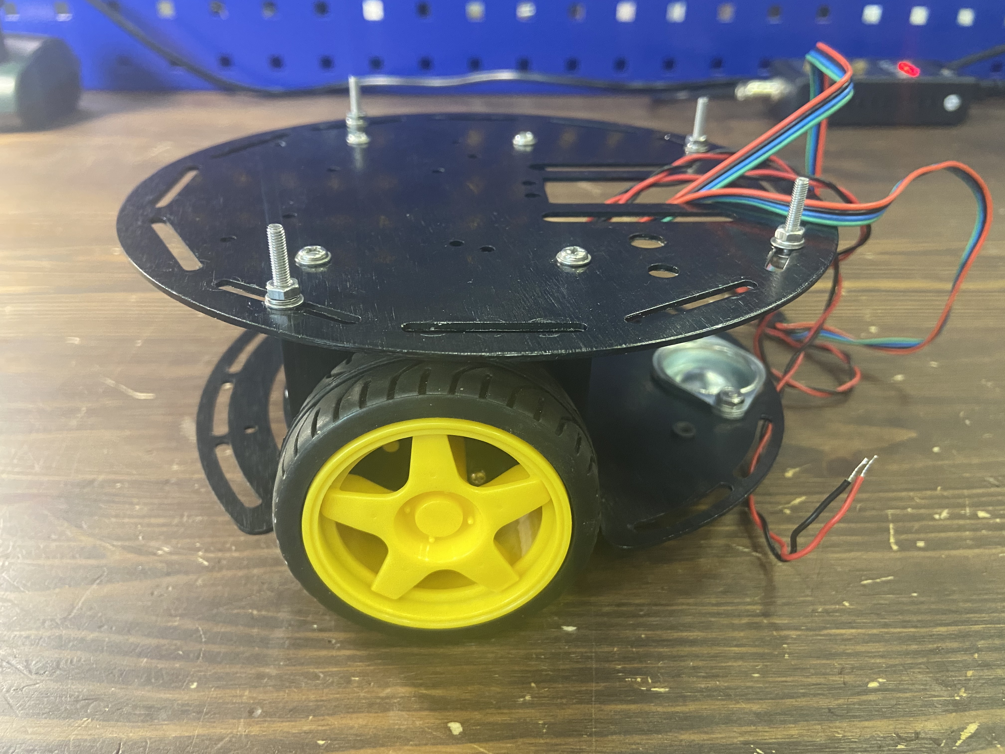
PHOTOS/IMG_6418.JPG
