MikAmperka/abot_src/PHOTOS/IMG_6419.JPG

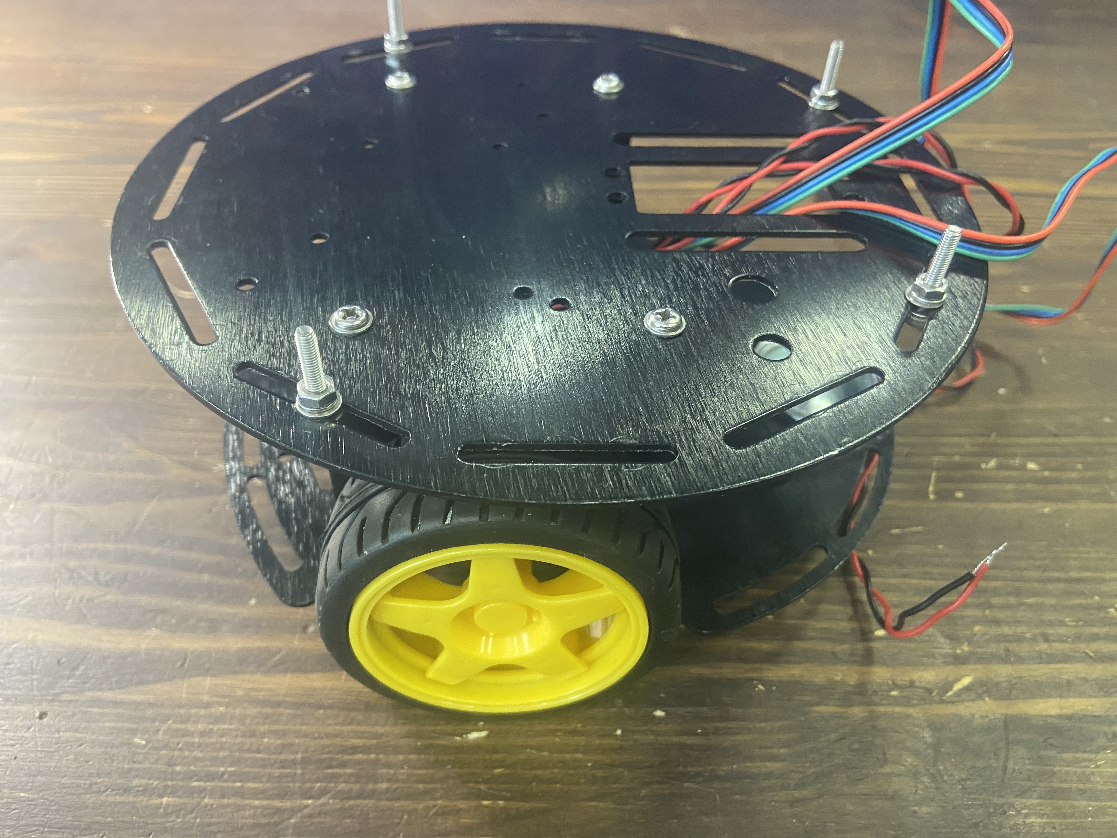
PHOTOS/IMG_6419.JPG
