MikAmperka/abot_src/PHOTOS/IMG_6426.JPG

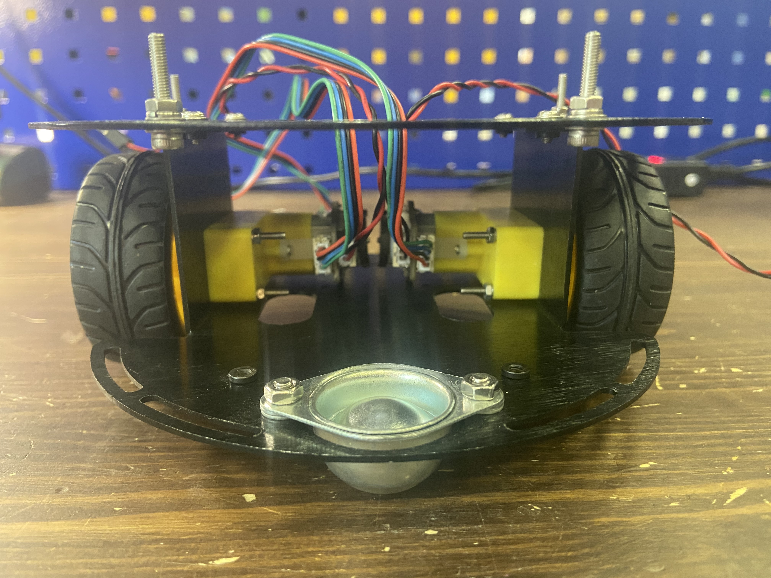
PHOTOS/IMG_6426.JPG
