MikAmperka/abot_src/PHOTOS/IMG_6428.JPG

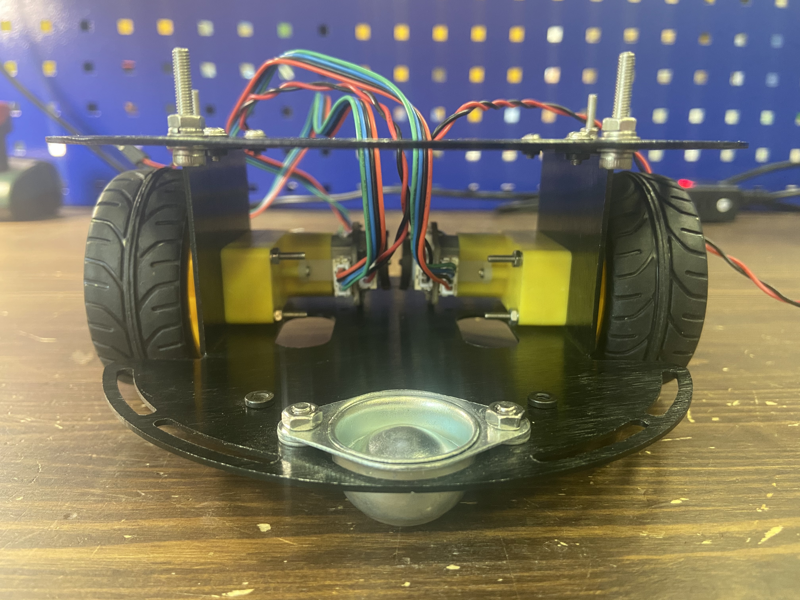
PHOTOS/IMG_6428.JPG
