MikAmperka/abot_src/PHOTOS/IMG_6495.JPG

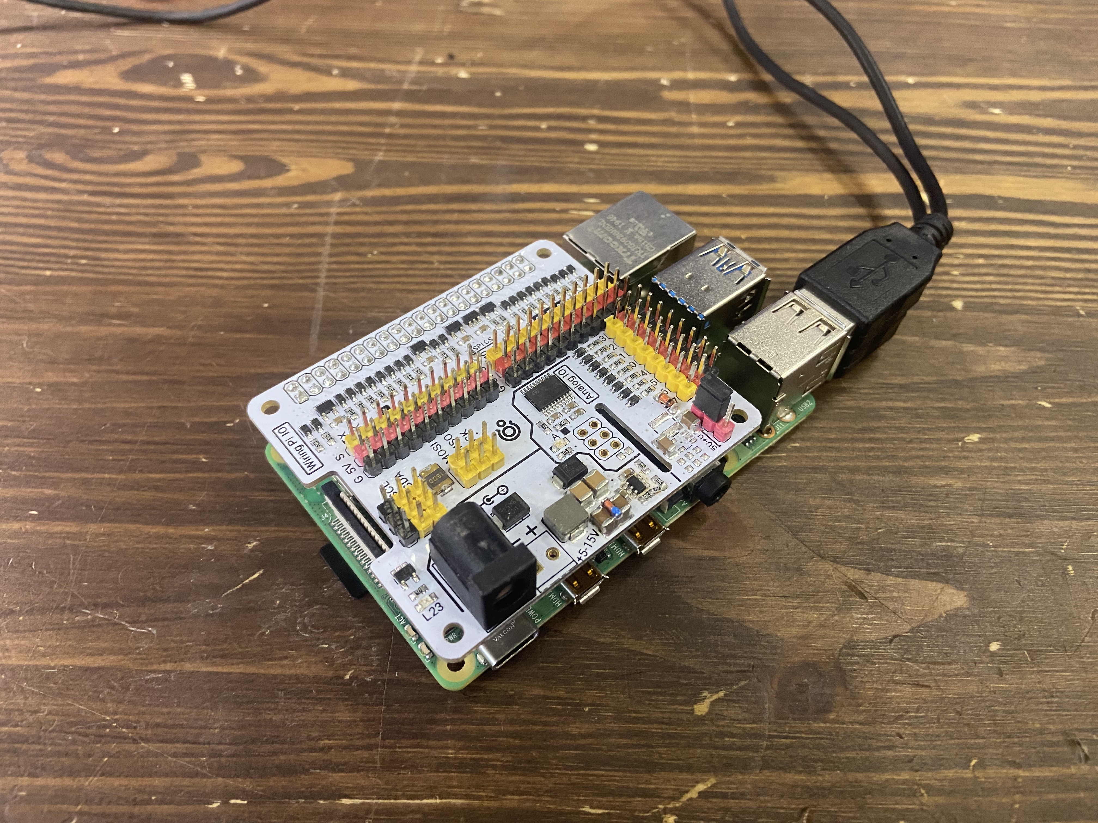
PHOTOS/IMG_6495.JPG
