MikAmperka/abot_src/PHOTOS/IMG_6500.JPG

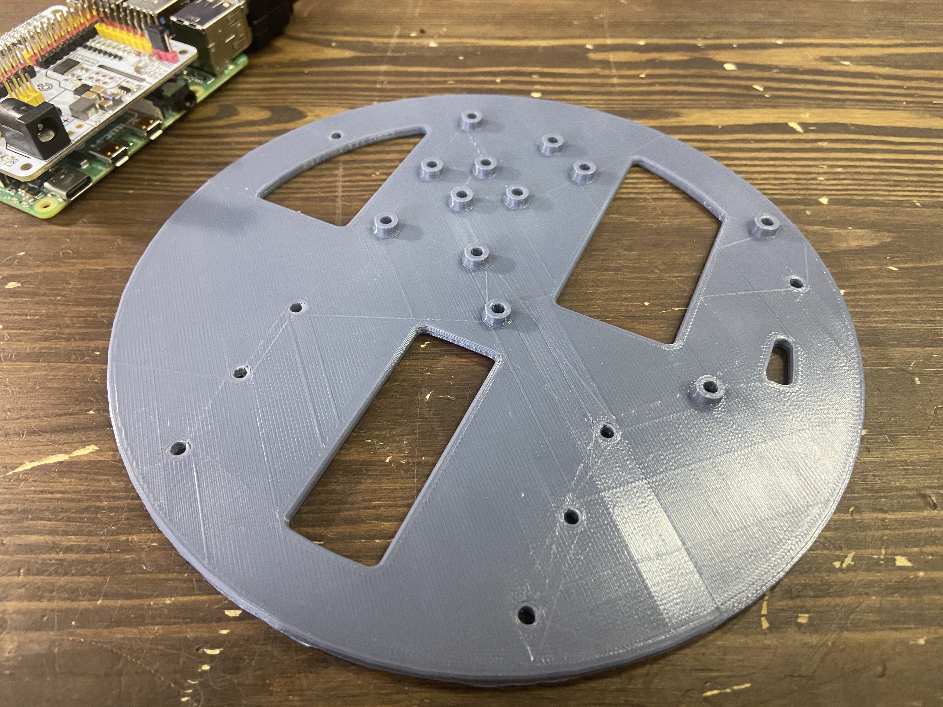
PHOTOS/IMG_6500.JPG
