MikAmperka/abot_src/CAD_2/SENSORS/SHARP_IR/GP2Y0A41SK0F_AXIS_FRAME.SLDASM

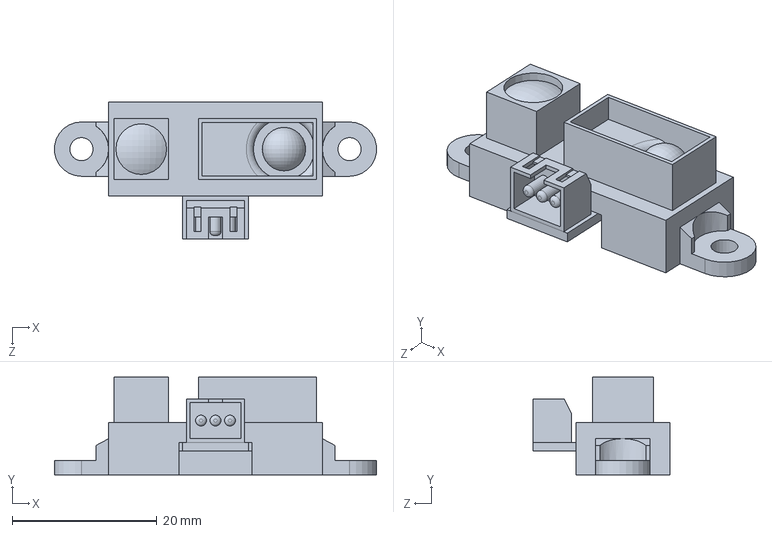
[picture p200: CAD file, 2021-05-23]
CAD_2/SENSORS/SHARP_IR/GP2Y0A41SK0F_AXIS_FRAME.SLDASM
44.4 x 13.5 x 18.9 mm
