MikAmperka/abot_src/CAD_2/MBOT_PARTS/MBOT_WHEEL.SLDASM

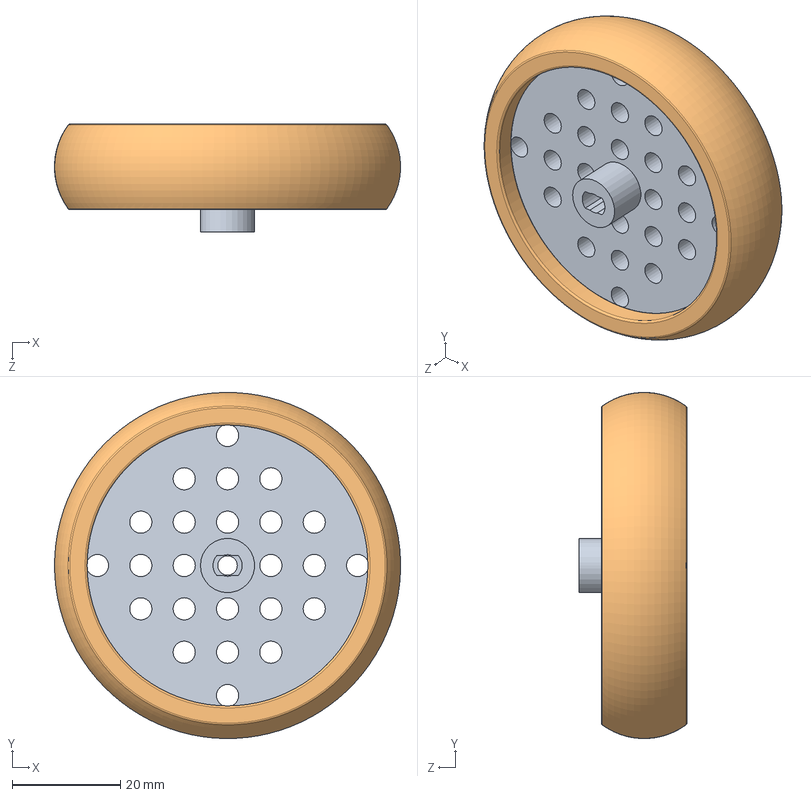
[picture p201: CAD file, 2021-05-23]
CAD_2/MBOT_PARTS/MBOT_WHEEL.SLDASM
63.9 x 63.9 x 19.9 mm
TIMING_PULLEY_90T
SLICK_TYRE_64x16
