MikAmperka/abot_src/CAD_2/MOTORS/TT_ANGLE_MOTOR.SLDASM

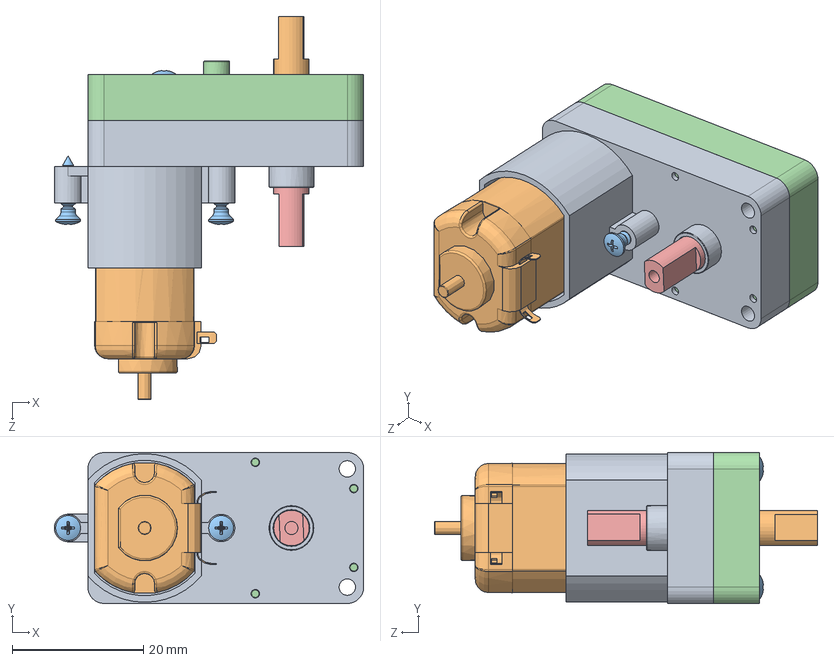
[picture p202: CAD file, 2021-05-23]
CAD_2/MOTORS/TT_ANGLE_MOTOR.SLDASM
47.1 x 23.0 x 58.3 mm
