MikAmperka/abot_src/CAD_2/MOTORS/TT_ANGLE_MOTOR_WITH_ENCODER.SLDASM

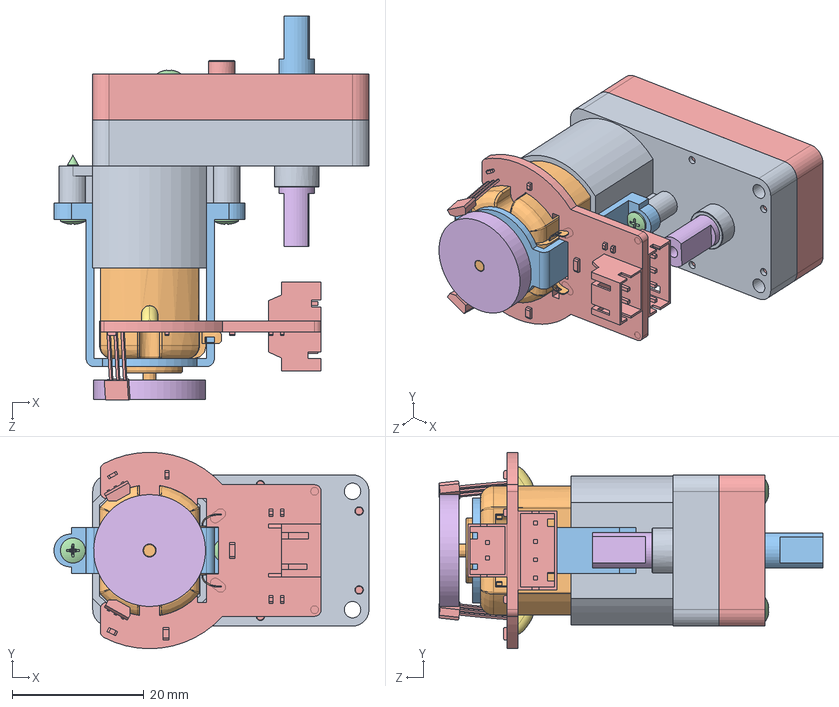
[picture p203: CAD file, 2021-05-23]
CAD_2/MOTORS/TT_ANGLE_MOTOR_WITH_ENCODER.SLDASM
47.9 x 29.9 x 58.4 mm
