MikAmperka/abot_src/CAD_2/SENSORS/LIDAR/LIDAR.SLDASM

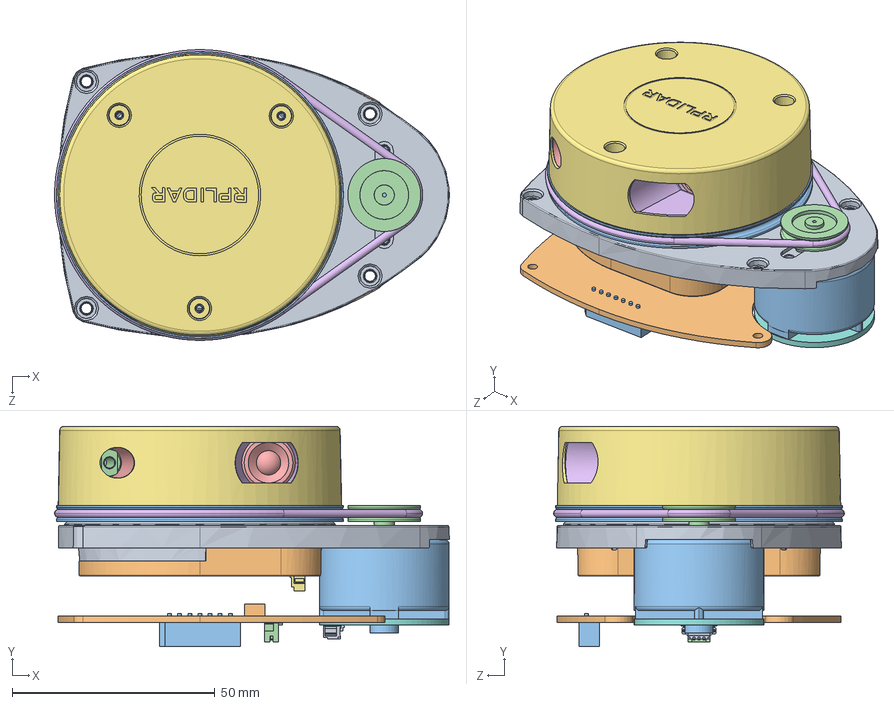
[picture p204: CAD file, 2021-05-23]
CAD_2/SENSORS/LIDAR/LIDAR.SLDASM
97.5 x 54.4 x 71.8 mm
