MikAmperka/abot_src/CAD_2/CHASSIS/UPPER_PLATE.SLDPRT

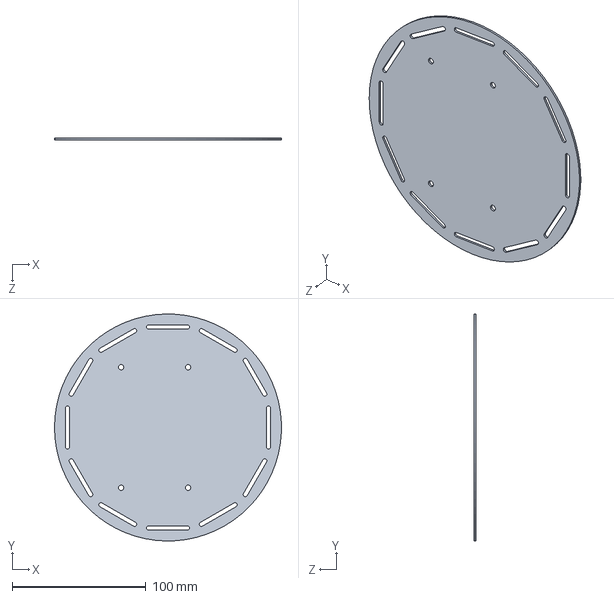
[picture p205: CAD file, 2021-05-23]
CAD_2/CHASSIS/UPPER_PLATE.SLDPRT
169.5 x 169.5 x 1.40 mm
