MikAmperka/abot_src/CAD_2/ENCODER/ENCODER_LPD3806-360BM-G5-24C.SLDPRT

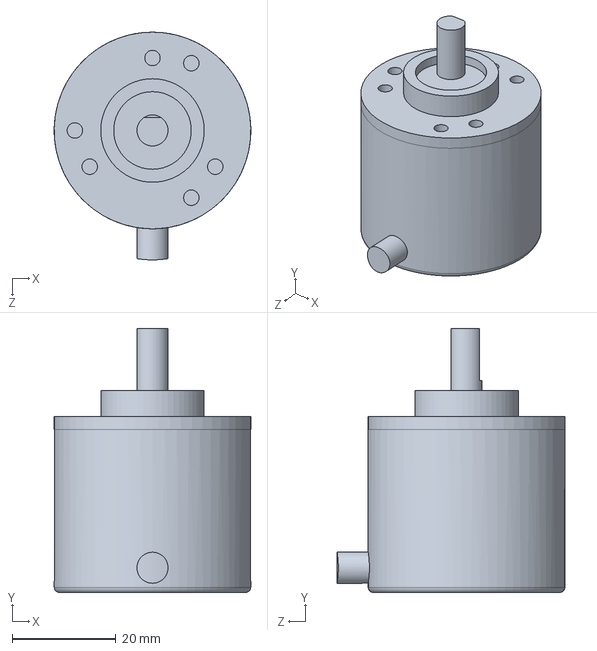
[picture p206: CAD file, 2021-05-23]
CAD_2/ENCODER/ENCODER_LPD3806-360BM-G5-24C.SLDPRT
38.0 x 51.0 x 44.0 mm
