MikAmperka/abot_src/CAD_2/MBOT_PARTS/SLICK_TYRE_64x16.SLDPRT

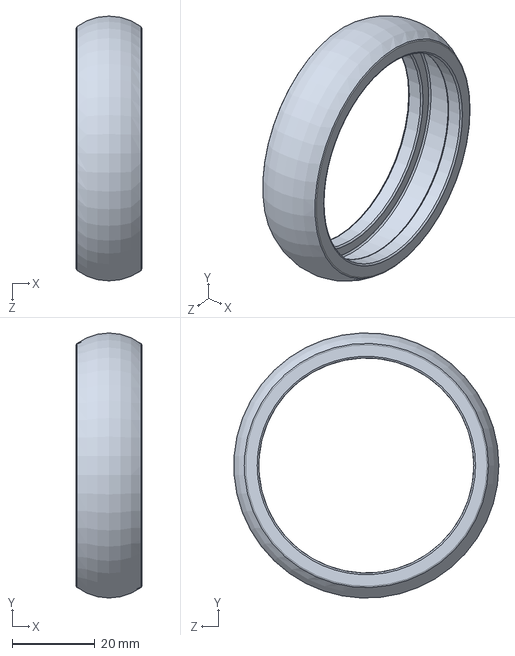
[picture p207: CAD file, 2021-05-23]
CAD_2/MBOT_PARTS/SLICK_TYRE_64x16.SLDPRT
15.8 x 63.9 x 63.8 mm
