MikAmperka/abot_src/CAD_2/METALWARE/SHARP_IR_MOUNTING_BRACKET_VERTICAL.SLDPRT

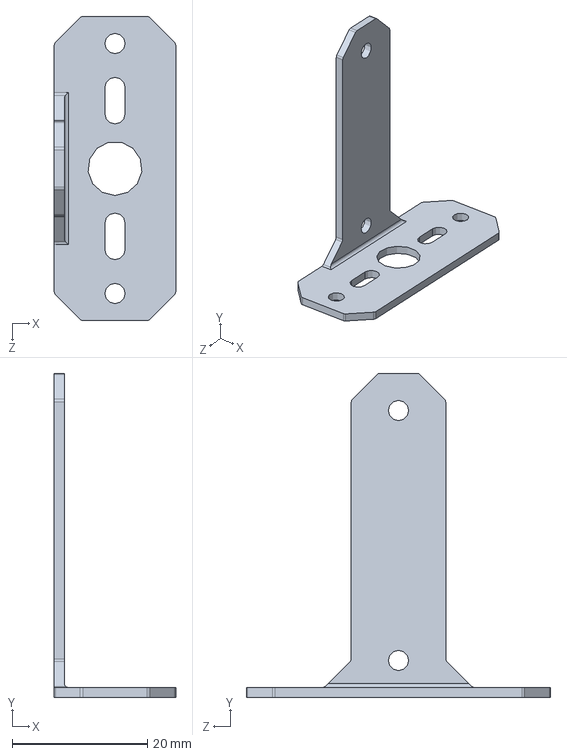
[picture p208: CAD file, 2021-05-23]
CAD_2/METALWARE/SHARP_IR_MOUNTING_BRACKET_VERTICAL.SLDPRT
18.0 x 48.0 x 45.0 mm
