MikAmperka/abot_src/CAD_2/MOTORS/2.SLDPRT

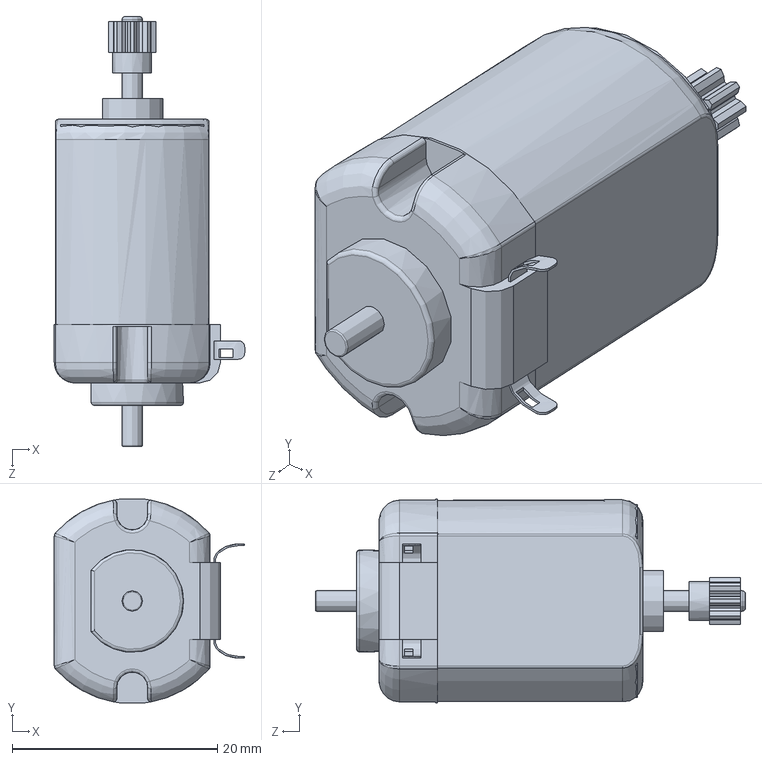
[picture p209: CAD file, 2021-05-23]
CAD_2/MOTORS/2.SLDPRT
18.6 x 19.9 x 41.9 mm
