MikAmperka/abot_src/CAD_2/PRINT_SHARP_IR_MOUNTING_BRACKET_VERTICAL.SLDPRT

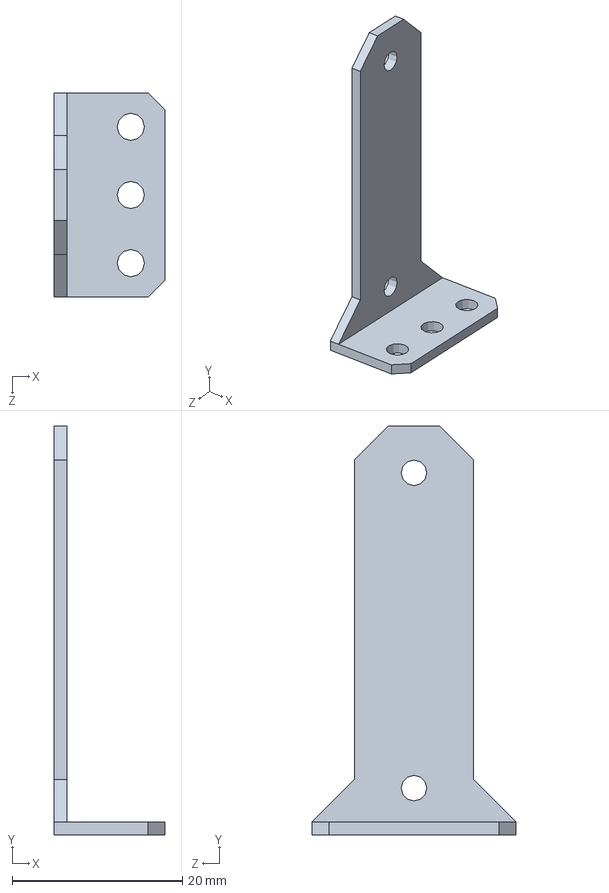
[picture p210: CAD file, 2021-05-23]
CAD_2/PRINT_SHARP_IR_MOUNTING_BRACKET_VERTICAL.SLDPRT
13.0 x 48.0 x 24.0 mm
