MikAmperka/abot_src/CAD_2/RPI/RPI3.SLDPRT

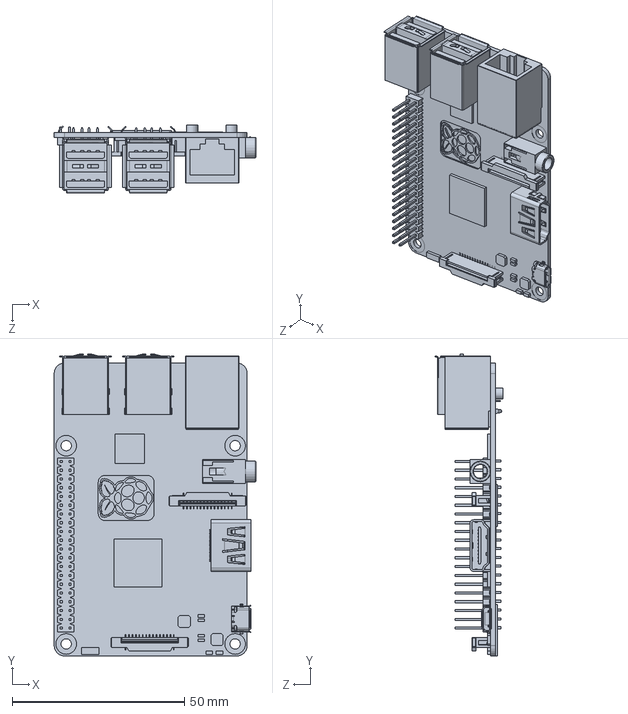
[picture p211: CAD file, 2021-05-23]
CAD_2/RPI/RPI3.SLDPRT
58.5 x 87.6 x 19.8 mm
