MikAmperka/abot_src/CAD_2/SENSORS/LIDAR/19.SLDPRT

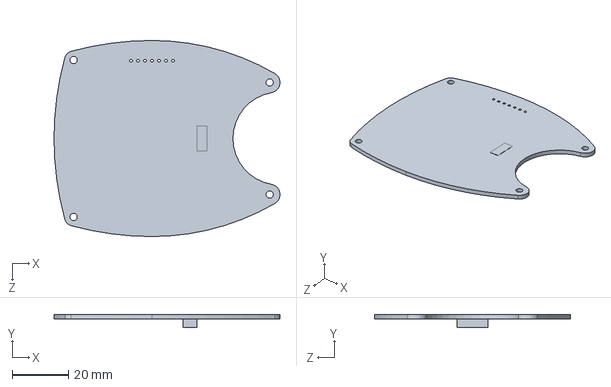
[picture p212: CAD file, 2021-05-23]
CAD_2/SENSORS/LIDAR/19.SLDPRT
80.7 x 4.70 x 70.0 mm
