MikAmperka/abot_src/PRINT_CUT/CUT/plates.dxf

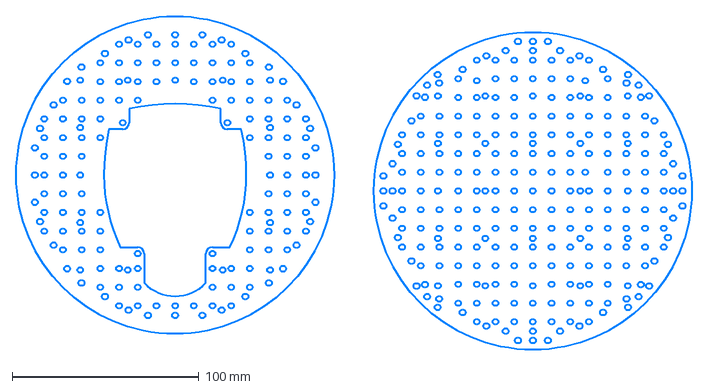
[picture p213: CAD file, 2021-05-23]
PRINT_CUT/CUT/plates.dxf
361.4 x 178.5 mm
