MikAmperka/abot_src/PRINT_CUT/PRINT/1/PRINT_PLATE_1.STL

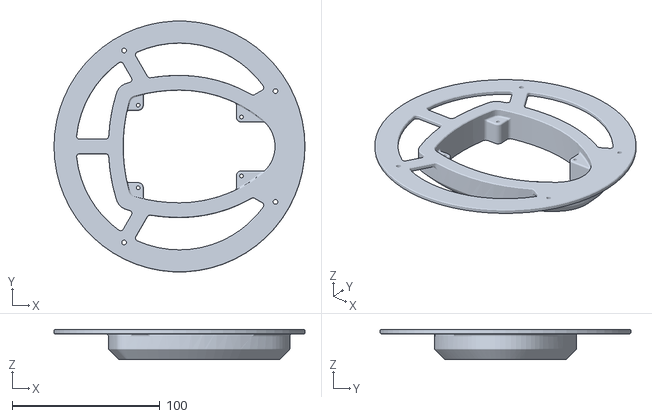
[picture p214: CAD file, 2021-06-02]
PRINT_CUT/PRINT/1/PRINT_PLATE_1.STL
170.0 x 169.8 x 20.5
