MikAmperka/abot_src/PRINT_CUT/PRINT/BIN/SHARP_IR_MOUNTING_BRACKET.STL

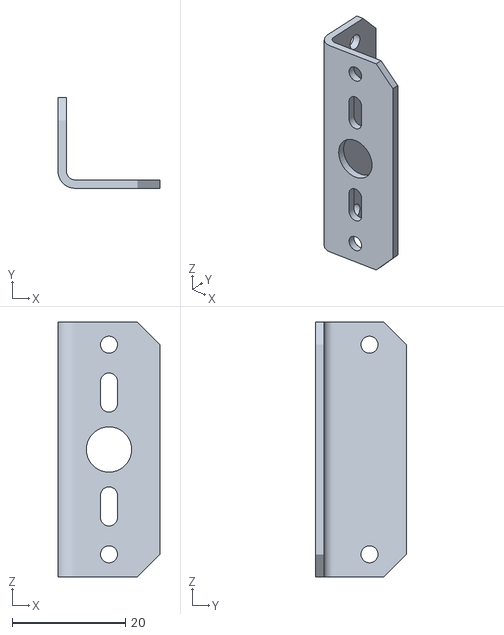
[picture p215: CAD file, 2021-05-23]
PRINT_CUT/PRINT/BIN/SHARP_IR_MOUNTING_BRACKET.STL
18.0 x 16.0 x 45.0
