MikAmperka/abot_src/PRINT_CUT/PRINT_ENCODER_MOUNT.STL

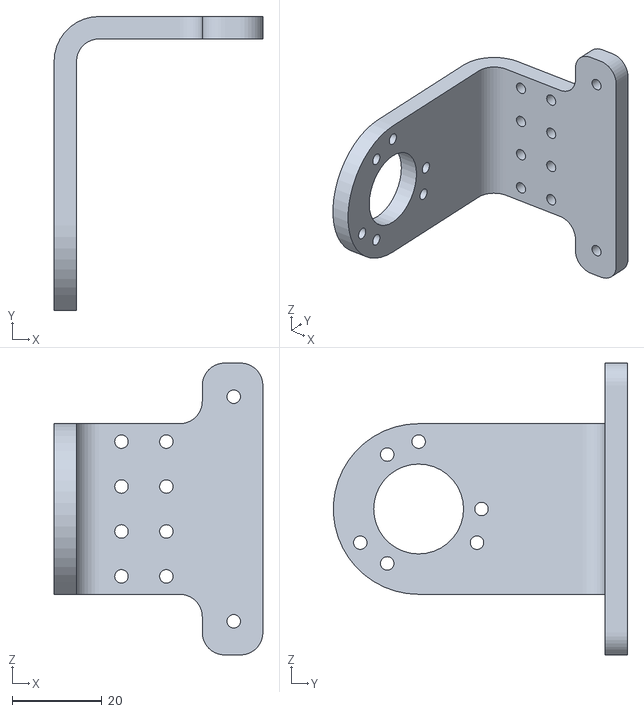
[picture p216: CAD file, 2021-05-23]
PRINT_CUT/PRINT_ENCODER_MOUNT.STL
46.5 x 65.5 x 65.0
