MikAmperka/abot_src/ros/src/abot_description/meshes/right_wheel.STL

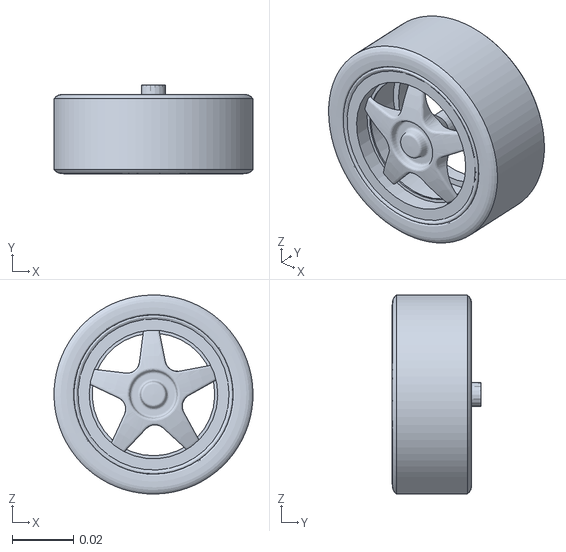
[picture p217: CAD file, 2021-05-23]
ros/src/abot_description/meshes/right_wheel.STL
0.065 x 0.029 x 0.065
