MikAmperka/abot_src/CAD_2/CHASSIS/CASTER_WHEEL_CASE.SLDPRT

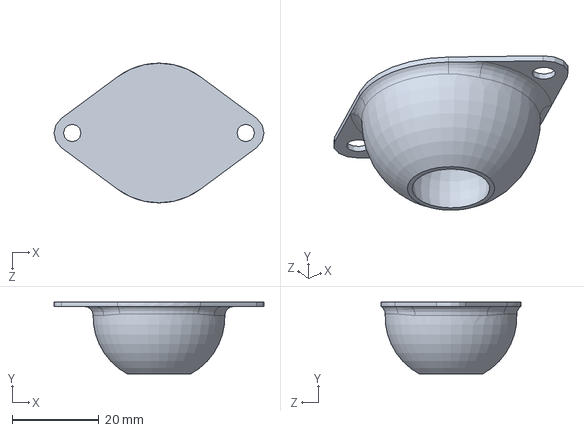
[picture p218: CAD file, 2021-05-23]
CAD_2/CHASSIS/CASTER_WHEEL_CASE.SLDPRT
48.4 x 16.5 x 32.2 mm
