MikAmperka/abot_src/CAD_2/CUT_PLEX_PLATE_1.SLDPRT

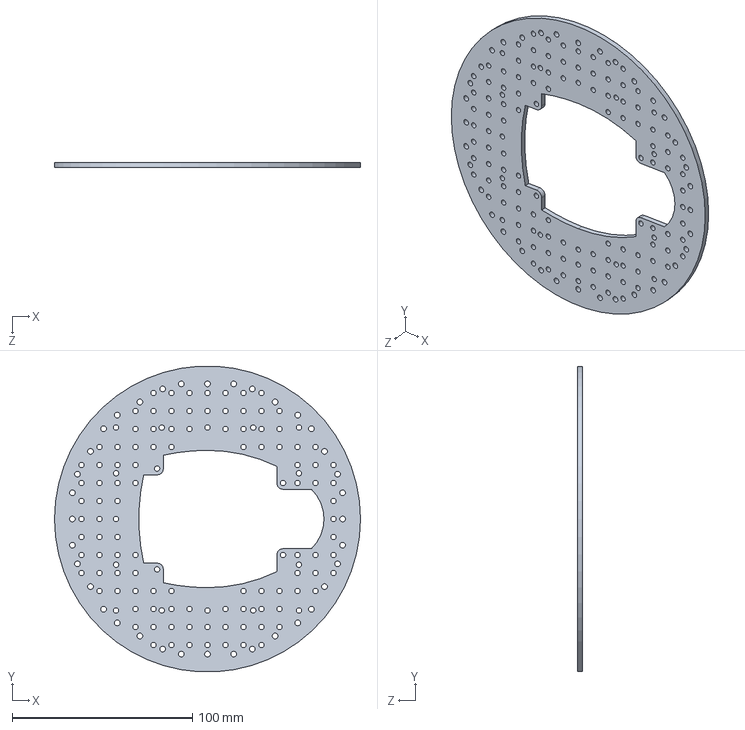
[picture p219: CAD file, 2021-05-23]
CAD_2/CUT_PLEX_PLATE_1.SLDPRT
170.0 x 169.7 x 3.00 mm
