MikAmperka/abot_src/CAD_2/MBOT_PARTS/TIMING_PULLEY_90T.SLDPRT

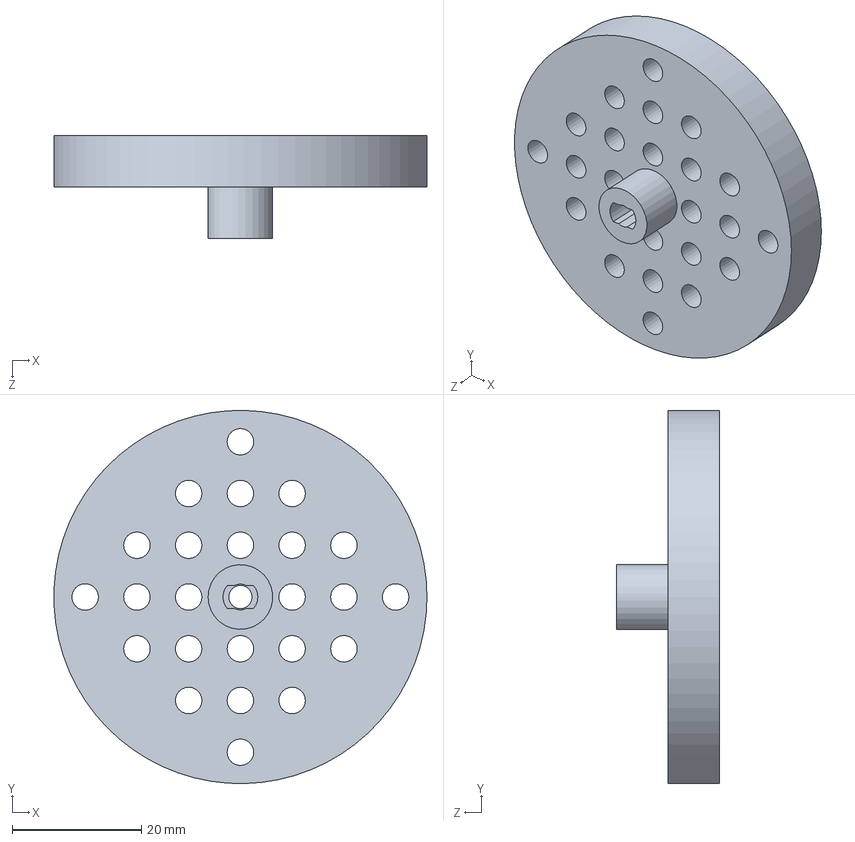
[picture p220: CAD file, 2021-05-23]
CAD_2/MBOT_PARTS/TIMING_PULLEY_90T.SLDPRT
57.7 x 57.7 x 16.0 mm
