MikAmperka/abot_src/CAD_2/METALWARE/6MM_SHAFT_FLANGE.SLDPRT

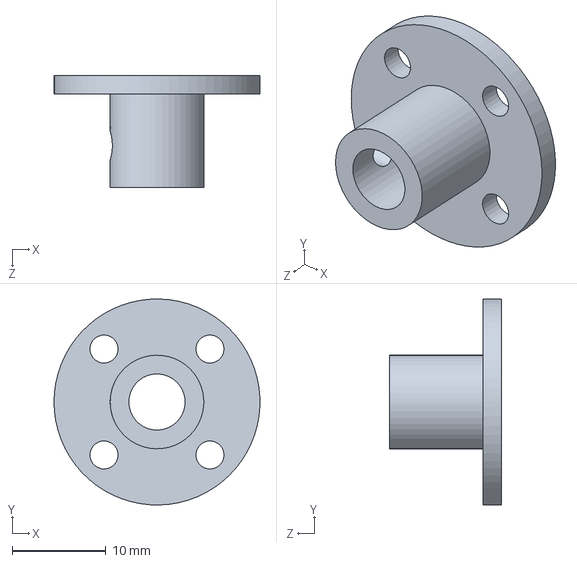
[picture p221: CAD file, 2021-05-23]
CAD_2/METALWARE/6MM_SHAFT_FLANGE.SLDPRT
22.0 x 22.0 x 12.0 mm
