MikAmperka/abot_src/CAD_2/MOTORS/12.SLDPRT

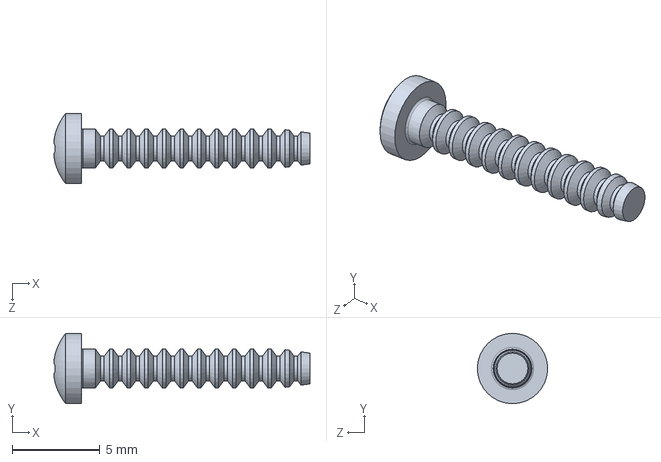
[picture p222: CAD file, 2021-05-23]
CAD_2/MOTORS/12.SLDPRT
14.6 x 4.00 x 4.00 mm
