MikAmperka/abot_src/CAD_2/SENSORS/LIDAR/12.SLDPRT

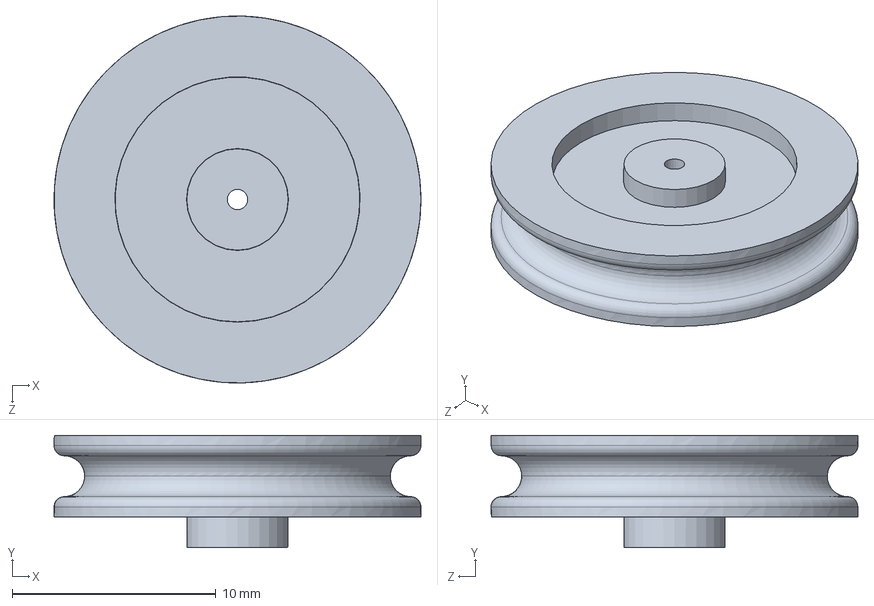
[picture p223: CAD file, 2021-05-23]
CAD_2/SENSORS/LIDAR/12.SLDPRT
18.0 x 5.50 x 18.0 mm
