MikAmperka/abot_src/PRINT_CUT/CUT/plate_1.dxf

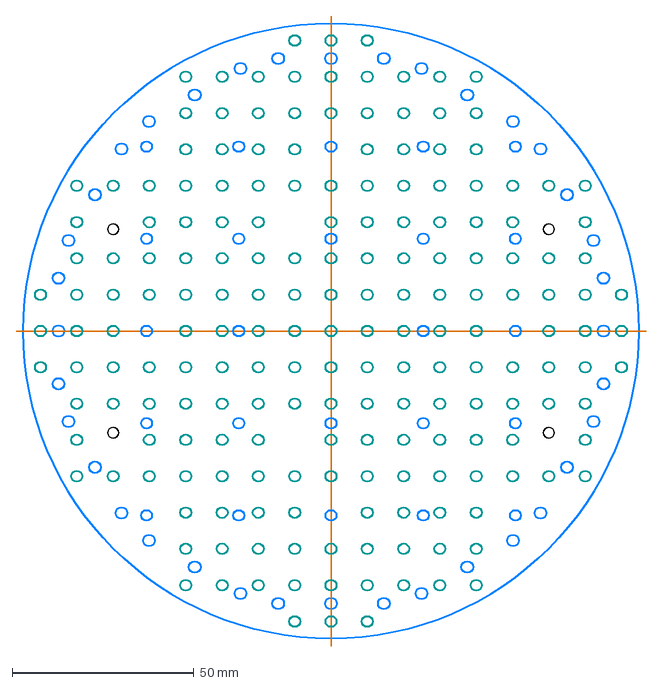
[picture p224: CAD file, 2021-05-23]
PRINT_CUT/CUT/plate_1.dxf
173.5 x 173.5 mm
