MikAmperka/abot_src/PRINT_CUT/PRINT/1/SHARP_IR_HOLDER.STL

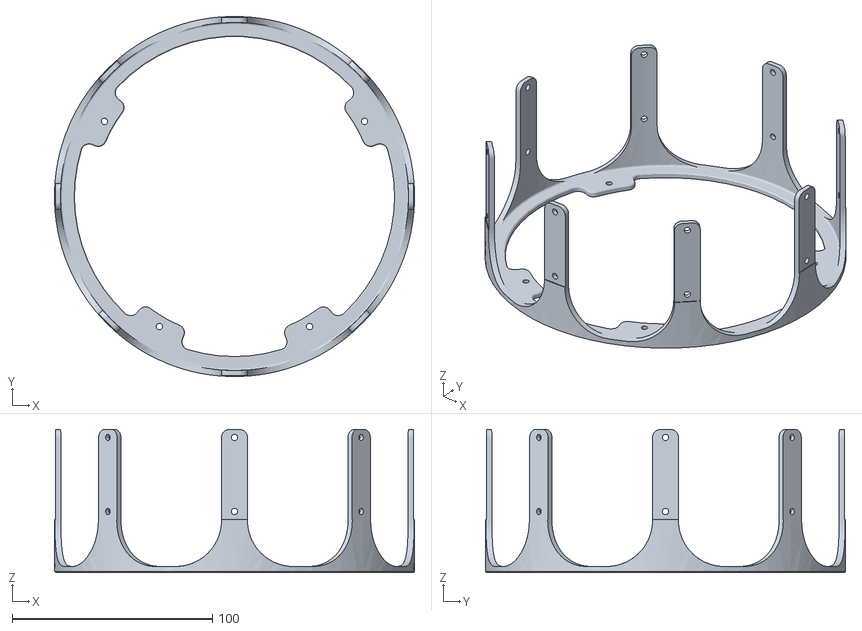
[picture p225: CAD file, 2021-05-25]
PRINT_CUT/PRINT/1/SHARP_IR_HOLDER.STL
180.0 x 179.9 x 71.5
