MikAmperka/abot_src/URDF/abot/meshes/abot_base.STL

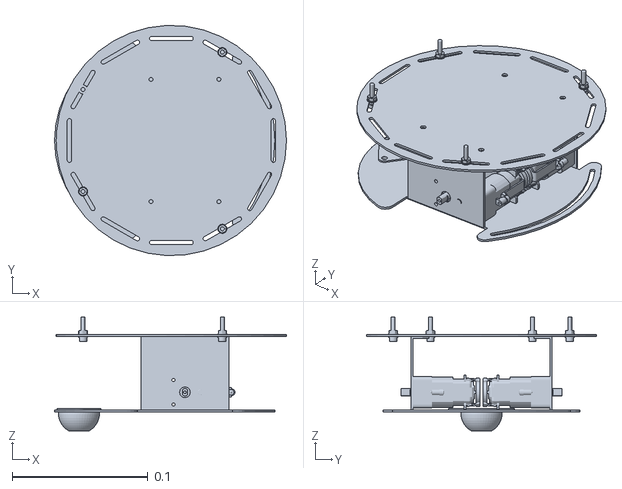
[picture p226: CAD file, 2021-05-26]
URDF/abot/meshes/abot_base.STL
0.171 x 0.169 x 0.0839
