MikAmperka/abot_src/URDF/abot_step_1/meshes/abot_caster_wheel.STL

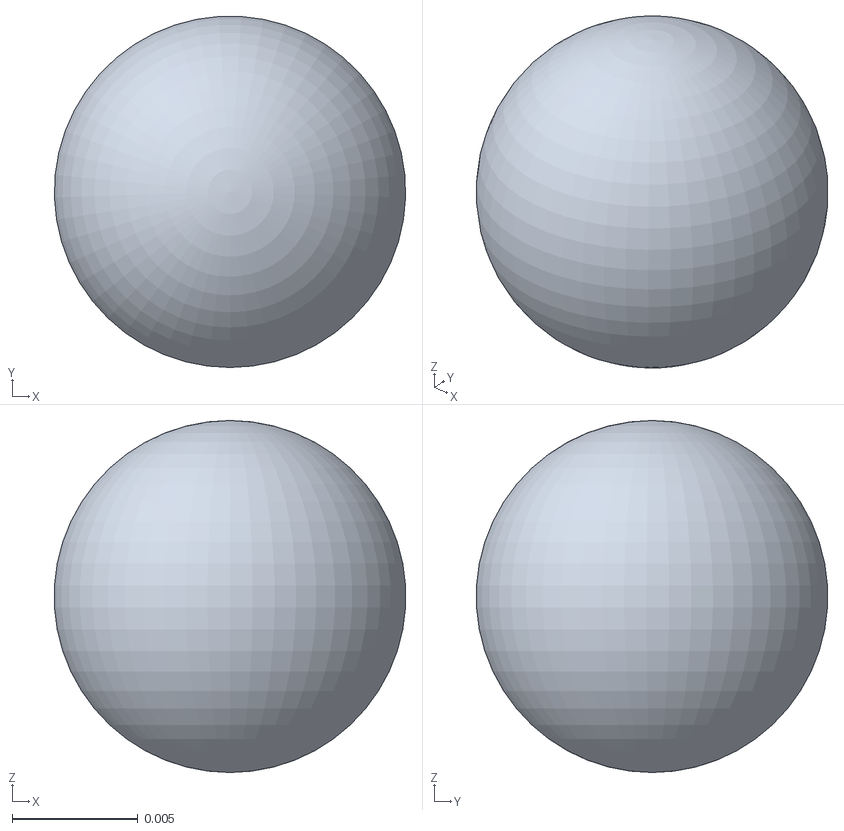
[picture p227: CAD file, 2021-05-26]
URDF/abot_step_1/meshes/abot_caster_wheel.STL
0.014 x 0.014 x 0.014
