MikAmperka/abot_src/CAD_2/CHASSIS/LOWER_PLATE.SLDPRT

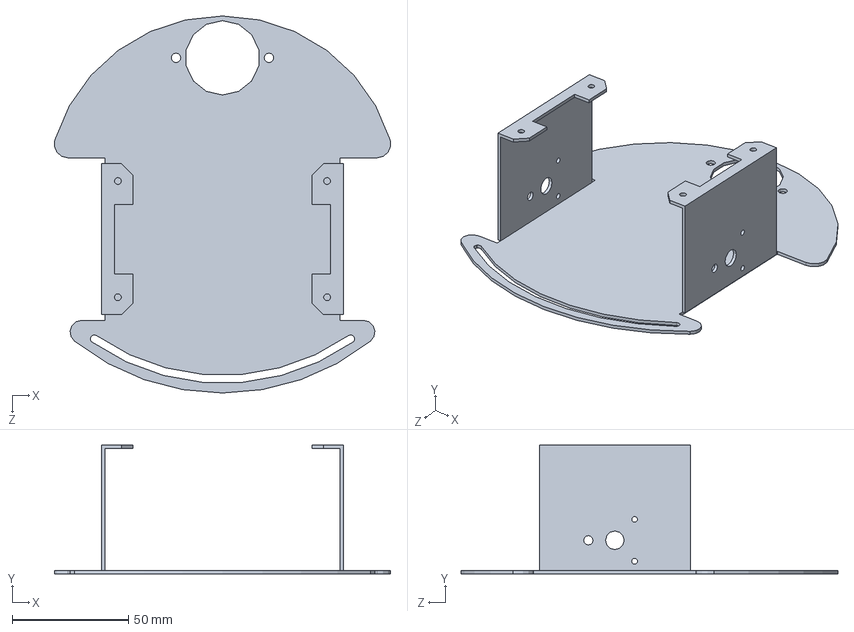
[picture p228: CAD file, 2021-05-23]
CAD_2/CHASSIS/LOWER_PLATE.SLDPRT
144.7 x 55.5 x 162.2 mm
