MikAmperka/abot_src/CAD_2/CUT_PLEX_PLATE_0.SLDPRT

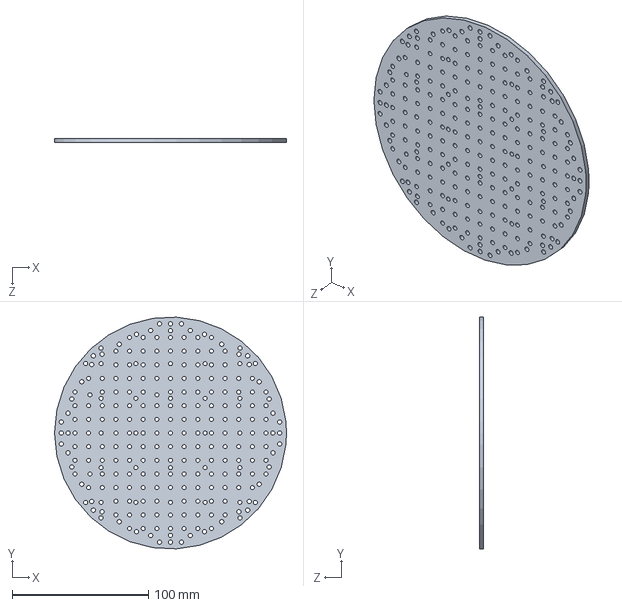
[picture p229: CAD file, 2021-05-23]
CAD_2/CUT_PLEX_PLATE_0.SLDPRT
170.0 x 169.8 x 3.00 mm
