MikAmperka/abot_src/CAD_2/SENSORS/LIDAR/2.SLDPRT

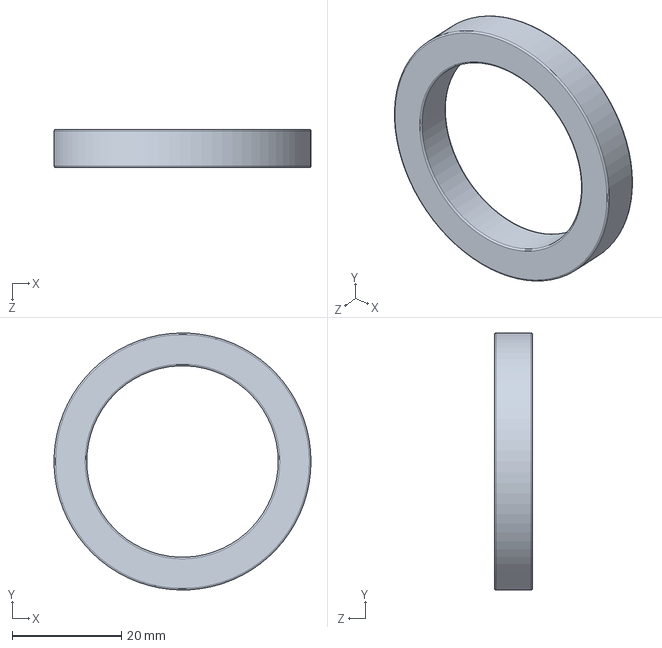
[picture p230: CAD file, 2021-05-23]
CAD_2/SENSORS/LIDAR/2.SLDPRT
47.0 x 47.0 x 7.00 mm
