MikAmperka/abot_src/PRINT_CUT/PRINT/1/PRINT_PLATE_0.STL

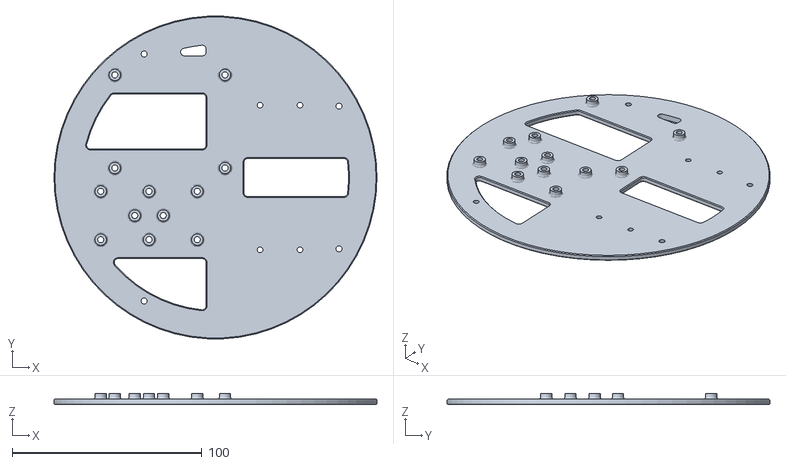
[picture p231: CAD file, 2021-05-25]
PRINT_CUT/PRINT/1/PRINT_PLATE_0.STL
170.0 x 169.8 x 6.00
