MikAmperka/abot_src/ros/src/abot_description/meshes/ir_l.STL

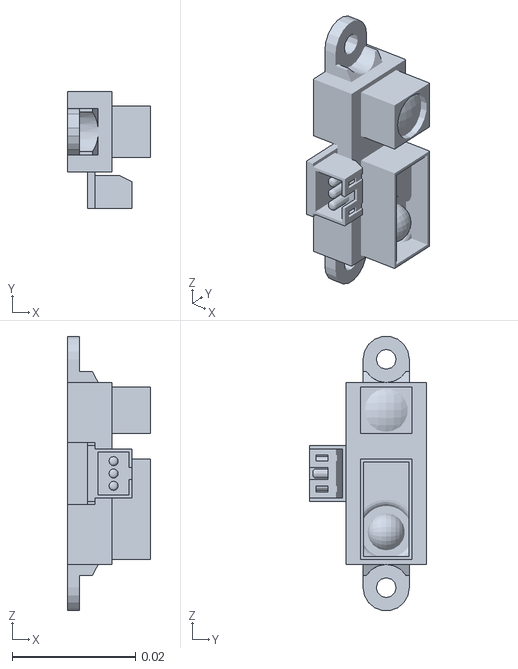
[picture p232: CAD file, 2021-05-23]
ros/src/abot_description/meshes/ir_l.STL
0.0135 x 0.0189 x 0.0444
