MikAmperka/abot_src/CAD_2/CHASSIS/CASTER_WHEEL_BALL.SLDPRT

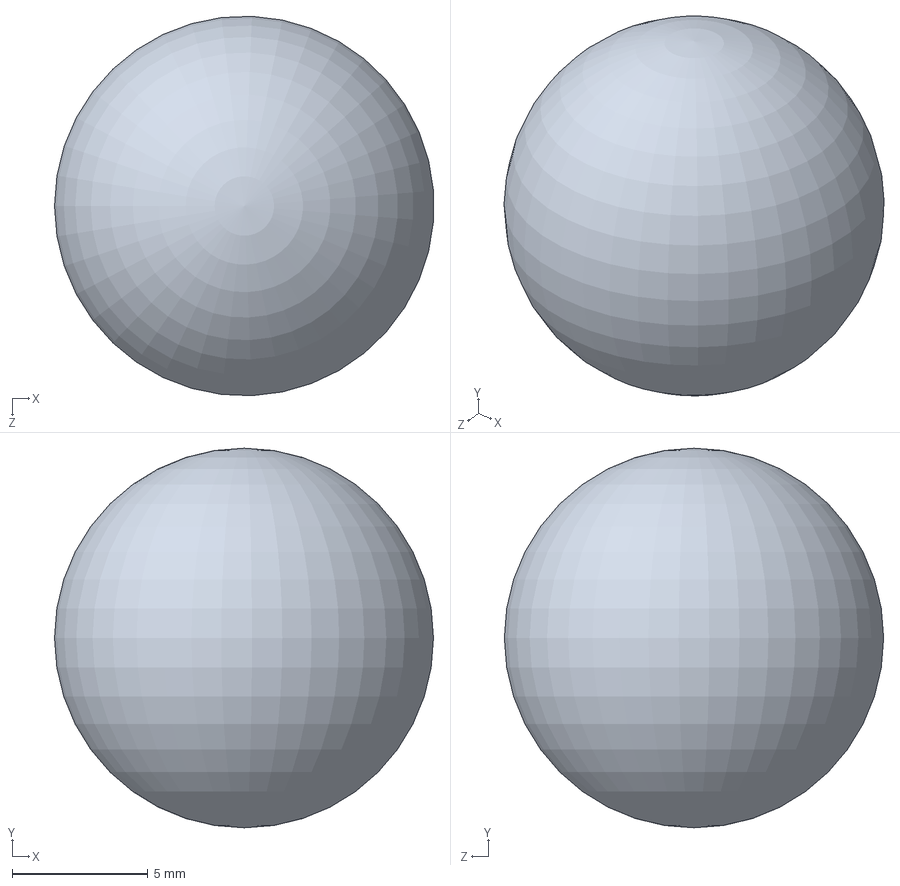
[picture p233: CAD file, 2021-05-23]
CAD_2/CHASSIS/CASTER_WHEEL_BALL.SLDPRT
14.0 x 14.0 x 14.0 mm
