MikAmperka/abot_src/CAD_2/MOTORS/9.SLDPRT

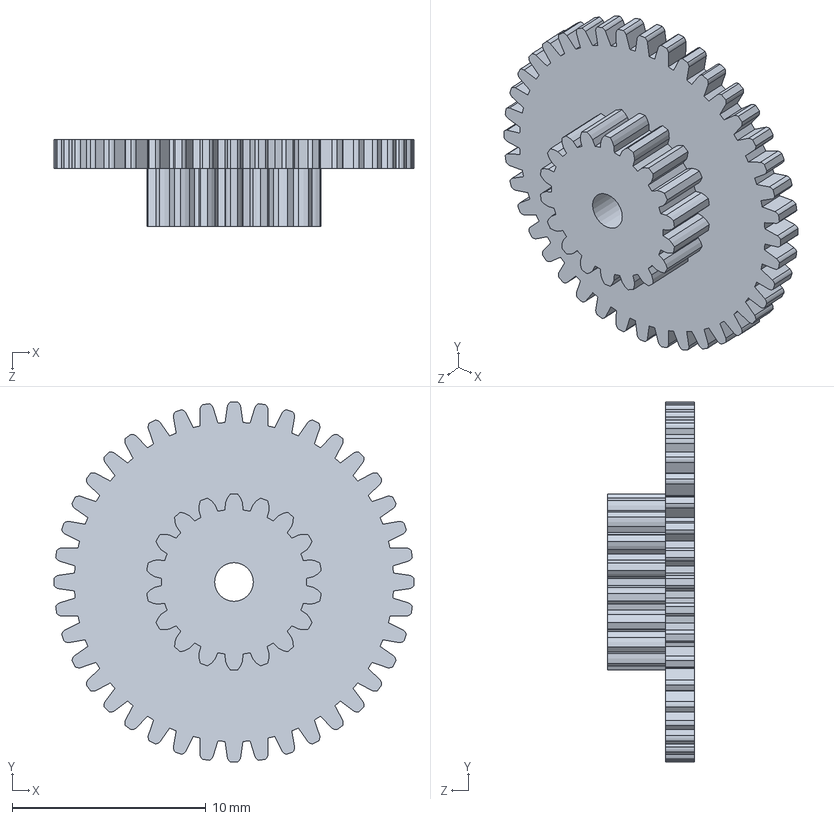
[picture p234: CAD file, 2021-05-23]
CAD_2/MOTORS/9.SLDPRT
18.6 x 18.6 x 4.50 mm
