MikAmperka/abot_src/CAD_2/SENSORS/LIDAR/18.SLDPRT

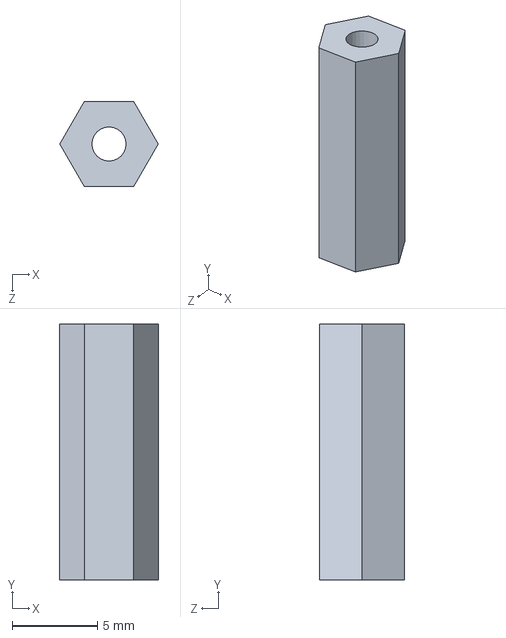
[picture p235: CAD file, 2021-05-23]
CAD_2/SENSORS/LIDAR/18.SLDPRT
5.77 x 15.0 x 5.00 mm
