MikAmperka/abot_src/CAD_2/CHASSIS/WHEEL_D65_W26.SLDPRT

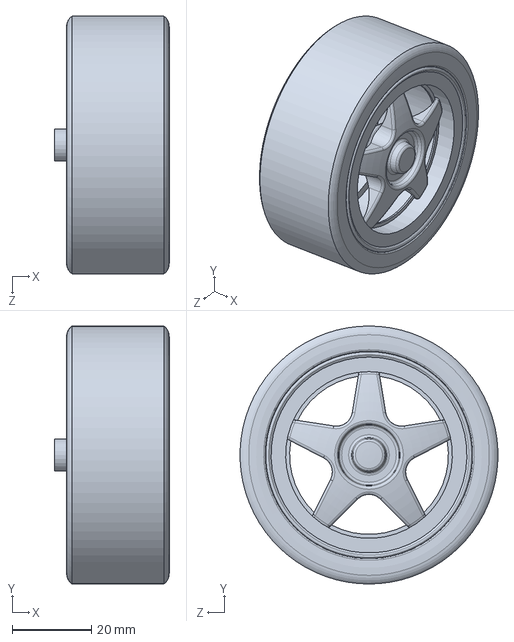
[picture p236: CAD file, 2021-05-23]
CAD_2/CHASSIS/WHEEL_D65_W26.SLDPRT
29.0 x 65.0 x 64.9 mm
