MikAmperka/abot_src/CAD_2/MOTORS/10.SLDPRT

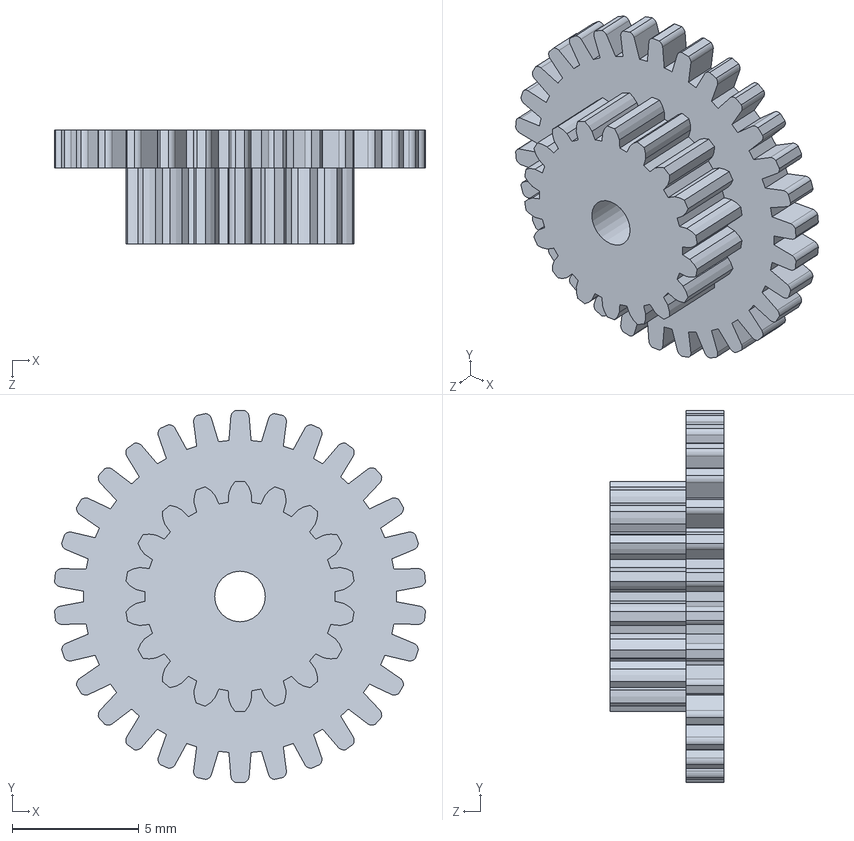
[picture p237: CAD file, 2021-05-23]
CAD_2/MOTORS/10.SLDPRT
14.7 x 14.7 x 4.50 mm
