MikAmperka/abot_src/CAD_2/SENSORS/LIDAR/16.SLDPRT

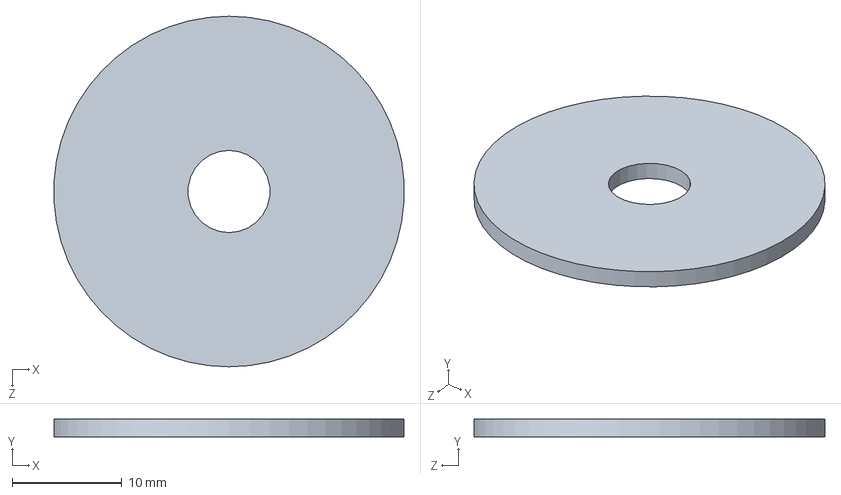
[picture p238: CAD file, 2021-05-23]
CAD_2/SENSORS/LIDAR/16.SLDPRT
31.9 x 1.60 x 32.0 mm
