MikAmperka/abot_src/PRINT_CUT/CUT/plate_0.dxf

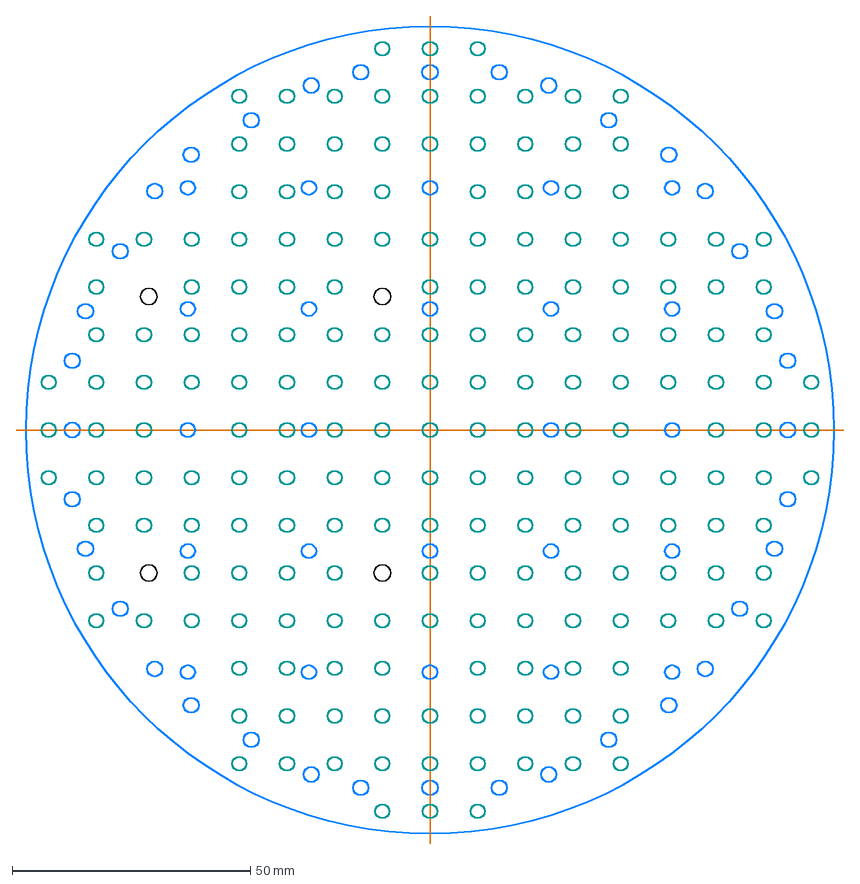
[picture p239: CAD file, 2021-05-23]
PRINT_CUT/CUT/plate_0.dxf
173.5 x 173.5 mm
