MikAmperka/abot_src/CAD_2/MOTORS/4.SLDPRT

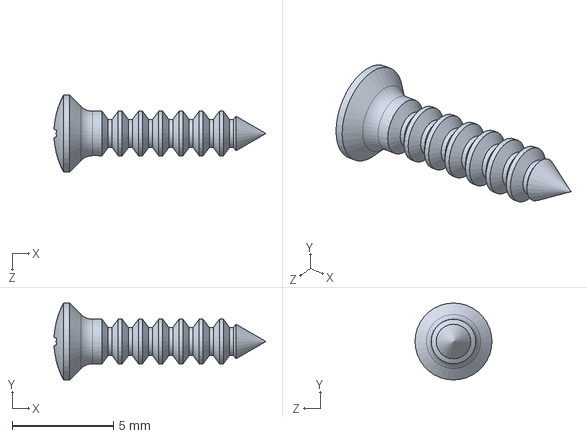
[picture p240: CAD file, 2021-05-23]
CAD_2/MOTORS/4.SLDPRT
10.5 x 3.80 x 3.80 mm
