MikAmperka/abot_src/CAD_2/SENSORS/LIDAR/7.SLDPRT

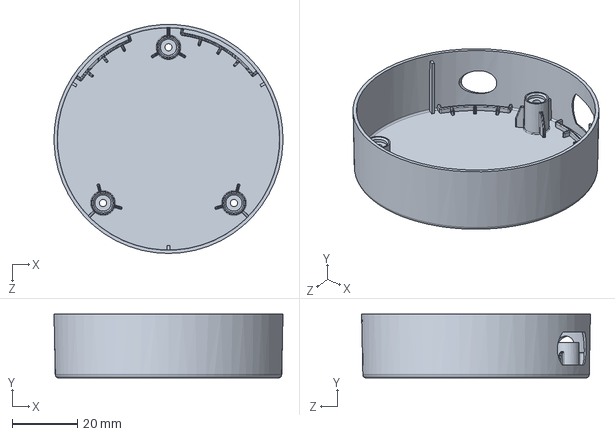
[picture p241: CAD file, 2021-05-23]
CAD_2/SENSORS/LIDAR/7.SLDPRT
70.0 x 19.5 x 69.9 mm
