MikAmperka/abot_src/CAD_2/MOTORS/3.SLDPRT

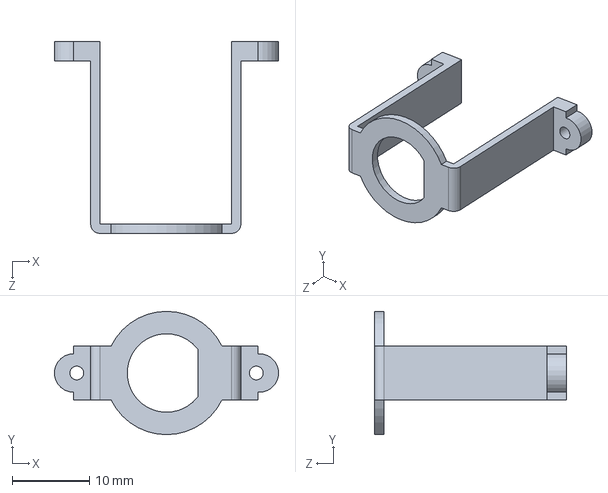
[picture p242: CAD file, 2021-05-23]
CAD_2/MOTORS/3.SLDPRT
29.1 x 16.0 x 24.9 mm
