MikAmperka/abot_src/CAD_2/SENSORS/LIDAR/9.SLDPRT

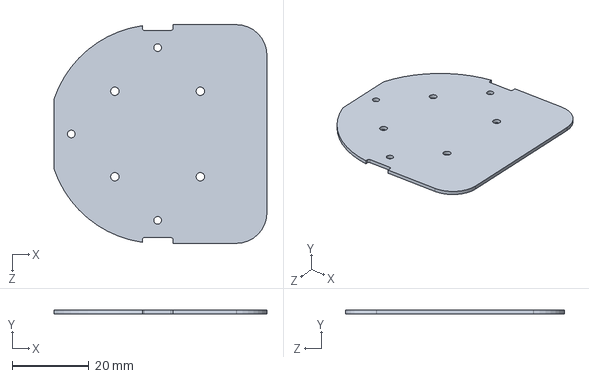
[picture p243: CAD file, 2021-05-23]
CAD_2/SENSORS/LIDAR/9.SLDPRT
55.5 x 1.00 x 57.0 mm
