MikAmperka/abot_src/CAD_2/MOTORS/11.SLDPRT

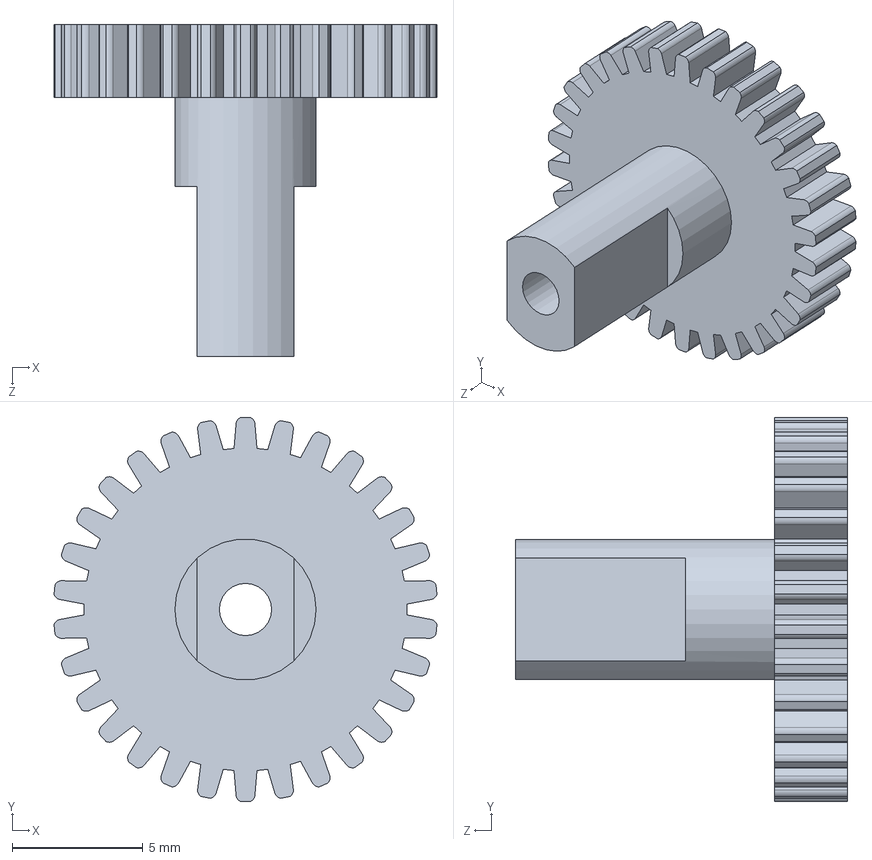
[picture p244: CAD file, 2021-05-23]
CAD_2/MOTORS/11.SLDPRT
14.7 x 14.7 x 12.7 mm
