MikAmperka/abot_src/CAD_2/SENSORS/LIDAR/17.SLDPRT

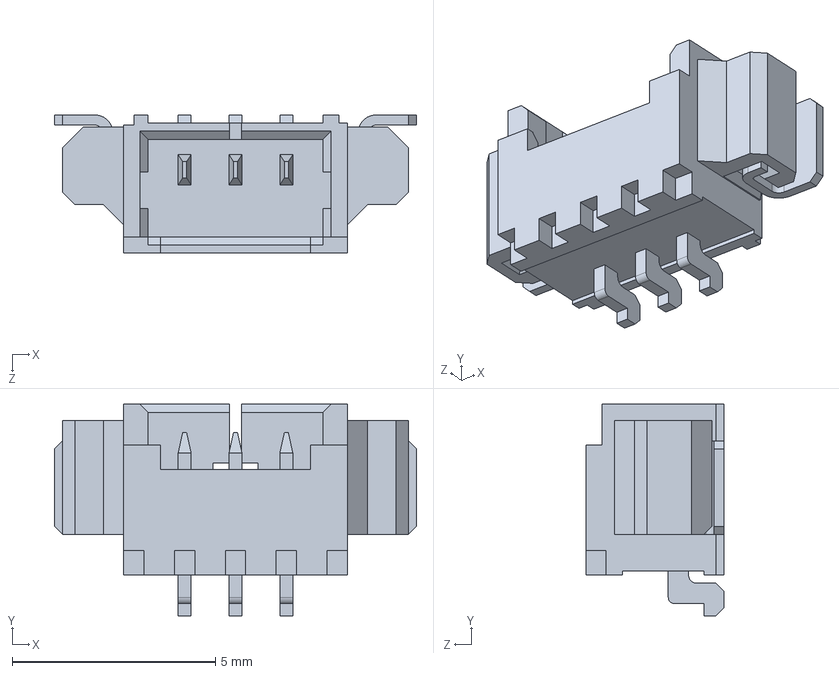
[picture p245: CAD file, 2021-05-23]
CAD_2/SENSORS/LIDAR/17.SLDPRT
8.90 x 5.20 x 3.40 mm
