MikAmperka/abot_src/CAD_2/MOTORS/5.SLDPRT

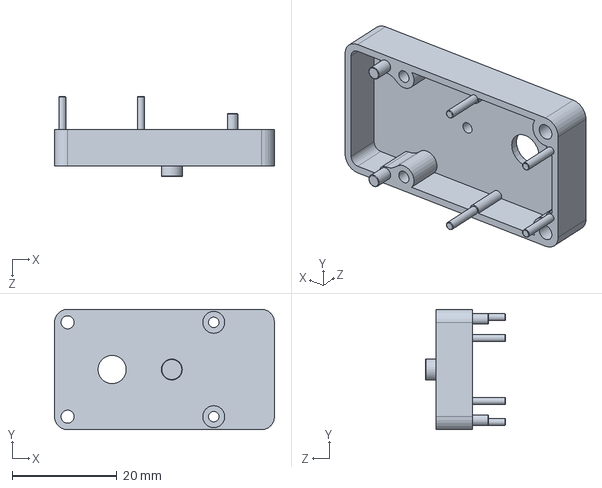
[picture p246: CAD file, 2021-05-23]
CAD_2/MOTORS/5.SLDPRT
42.0 x 23.0 x 15.3 mm
