MikAmperka/abot_src/CAD_2/SENSORS/LIDAR/STANDOFF_M3_16.8H.SLDPRT

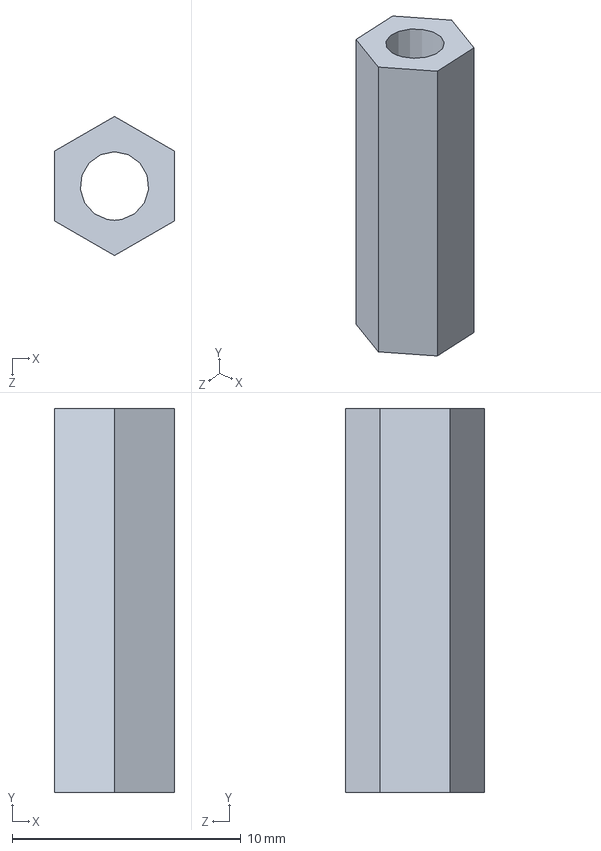
[picture p247: CAD file, 2021-05-23]
CAD_2/SENSORS/LIDAR/STANDOFF_M3_16.8H.SLDPRT
5.27 x 16.8 x 6.09 mm
