MikAmperka/abot_src/CAD_2/SENSORS/LIDAR/3.SLDPRT

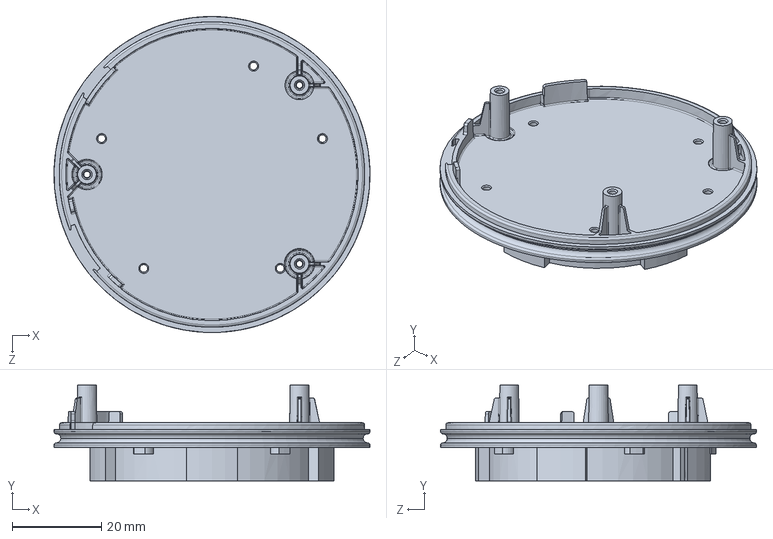
[picture p248: CAD file, 2021-05-23]
CAD_2/SENSORS/LIDAR/3.SLDPRT
70.8 x 21.4 x 70.8 mm
