MikAmperka/abot_src/CAD_2/MOTORS/13.SLDPRT

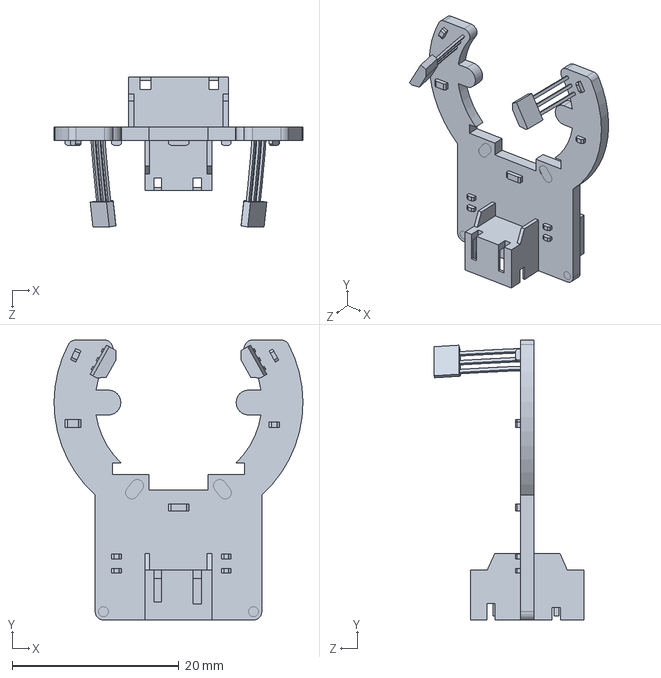
[picture p249: CAD file, 2021-05-23]
CAD_2/MOTORS/13.SLDPRT
29.9 x 33.6 x 18.0 mm
