MikAmperka/abot_src/CAD_2/SENSORS/LIDAR/8.SLDPRT

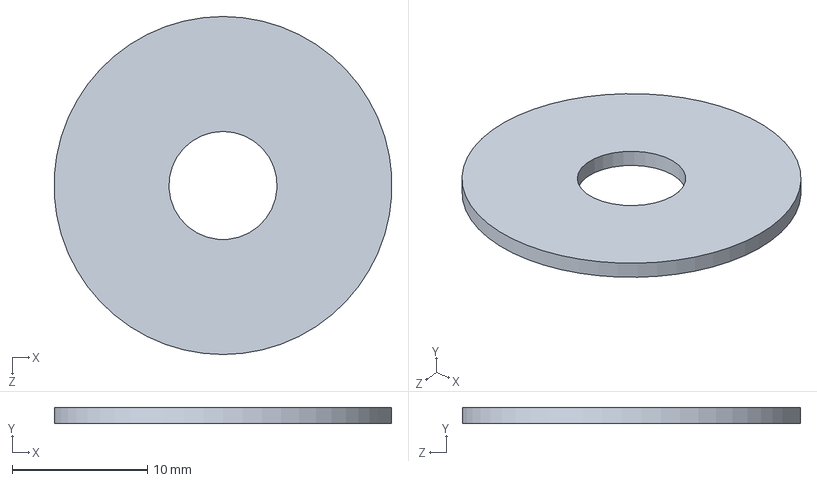
[picture p250: CAD file, 2021-05-23]
CAD_2/SENSORS/LIDAR/8.SLDPRT
25.0 x 1.20 x 25.0 mm
