MikAmperka/abot_src/CAD_2/MOTORS/15.SLDPRT

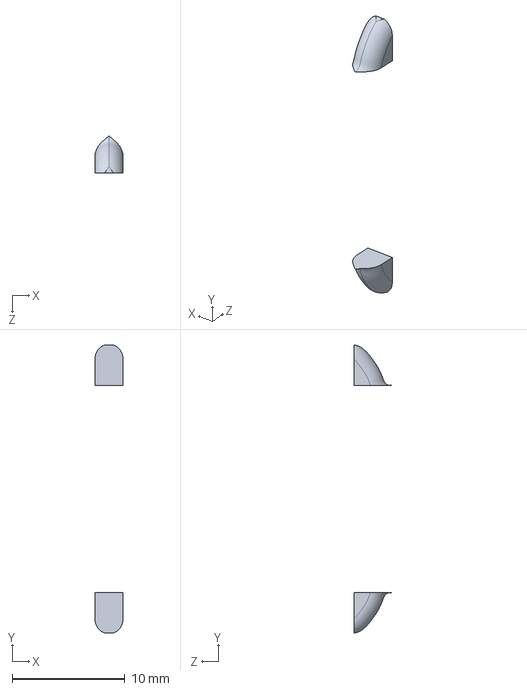
[picture p251: CAD file, 2021-05-23]
CAD_2/MOTORS/15.SLDPRT
2.50 x 25.5 x 3.29 mm
