MikAmperka/abot_src/CAD_2/SENSORS/LIDAR/STANDOFF_M3_14.8H.SLDPRT

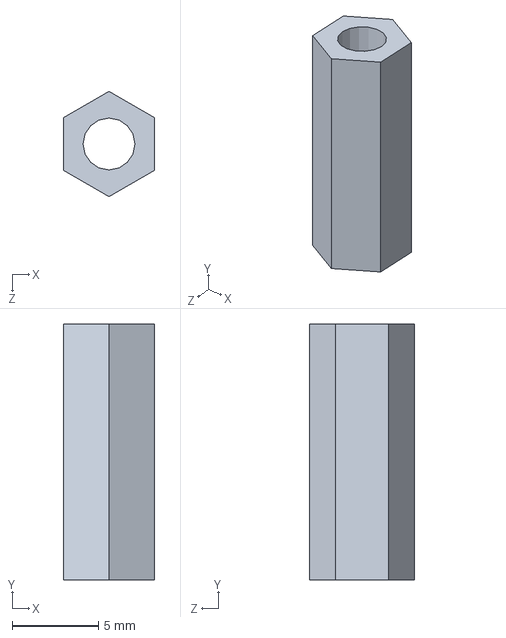
[picture p252: CAD file, 2021-05-23]
CAD_2/SENSORS/LIDAR/STANDOFF_M3_14.8H.SLDPRT
5.27 x 14.8 x 6.09 mm
