MikAmperka/abot_src/CAD_2/MOTORS/14.SLDPRT

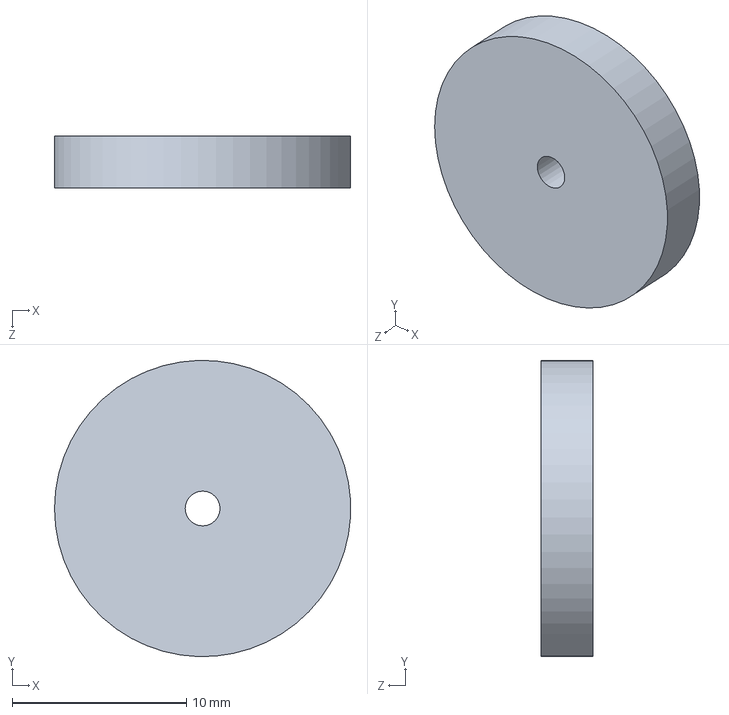
[picture p253: CAD file, 2021-05-23]
CAD_2/MOTORS/14.SLDPRT
17.0 x 17.0 x 3.00 mm
