MikAmperka/abot_src/CAD_2/SENSORS/LIDAR/10.SLDPRT

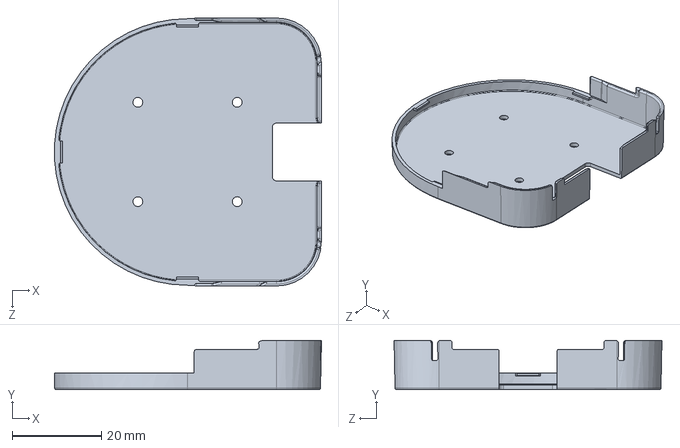
[picture p254: CAD file, 2021-05-23]
CAD_2/SENSORS/LIDAR/10.SLDPRT
59.9 x 11.0 x 60.1 mm
