MikAmperka/abot_src/CAD_2/MOTORS/8.SLDPRT

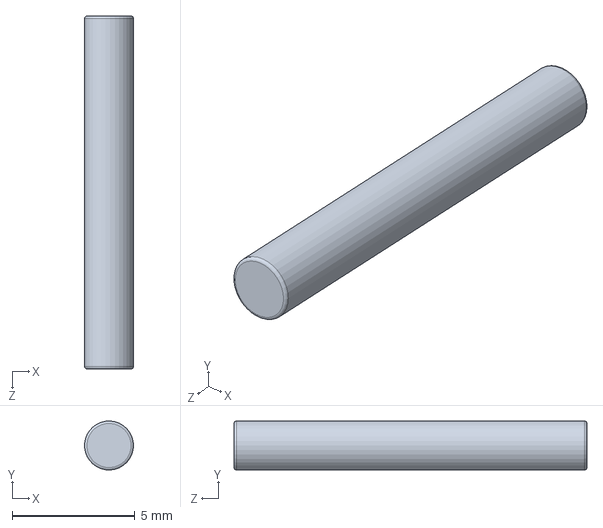
[picture p255: CAD file, 2021-05-23]
CAD_2/MOTORS/8.SLDPRT
2.00 x 2.00 x 14.4 mm
