MikAmperka/abot_src/CAD_2/SENSORS/LIDAR/15.SLDPRT

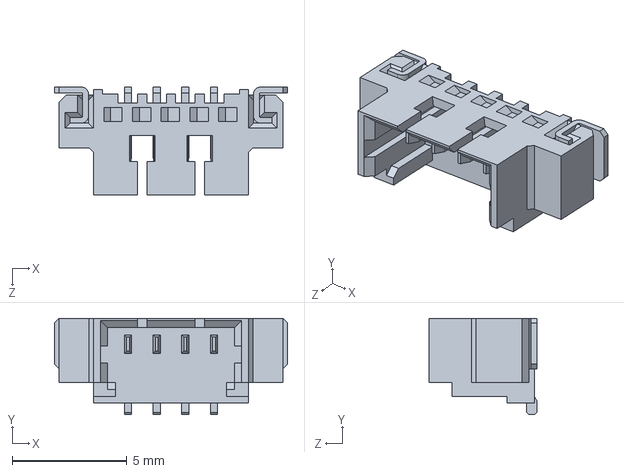
[picture p256: CAD file, 2021-05-23]
CAD_2/SENSORS/LIDAR/15.SLDPRT
10.2 x 4.20 x 4.70 mm
