MikAmperka/abot_src/CAD_2/SENSORS/LIDAR/11.SLDPRT

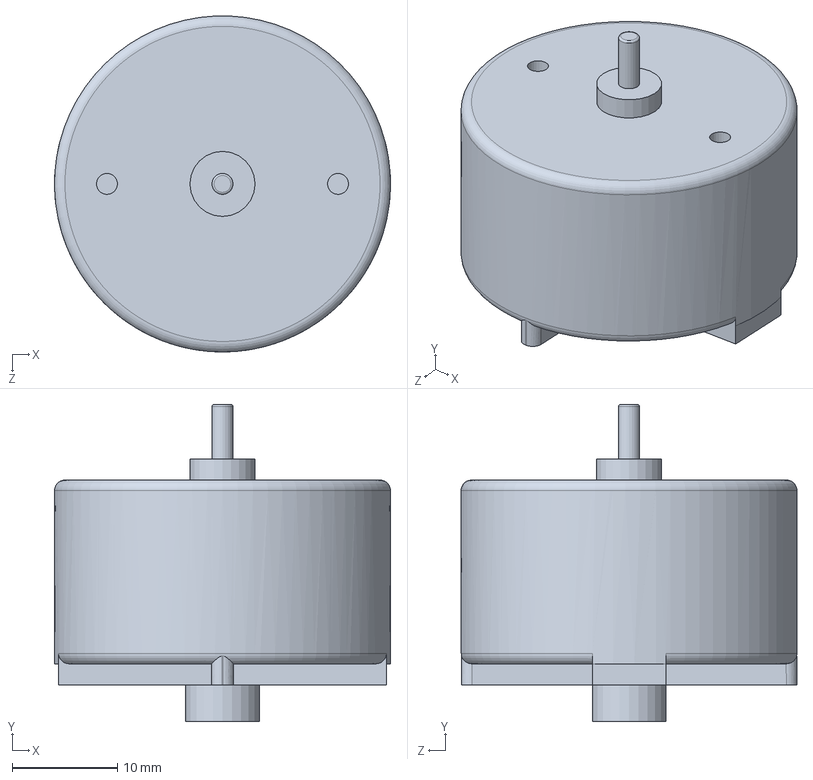
[picture p257: CAD file, 2021-05-23]
CAD_2/SENSORS/LIDAR/11.SLDPRT
32.0 x 30.2 x 32.0 mm
