MikAmperka/abot_src/CAD_2/MOTORS/7.SLDPRT

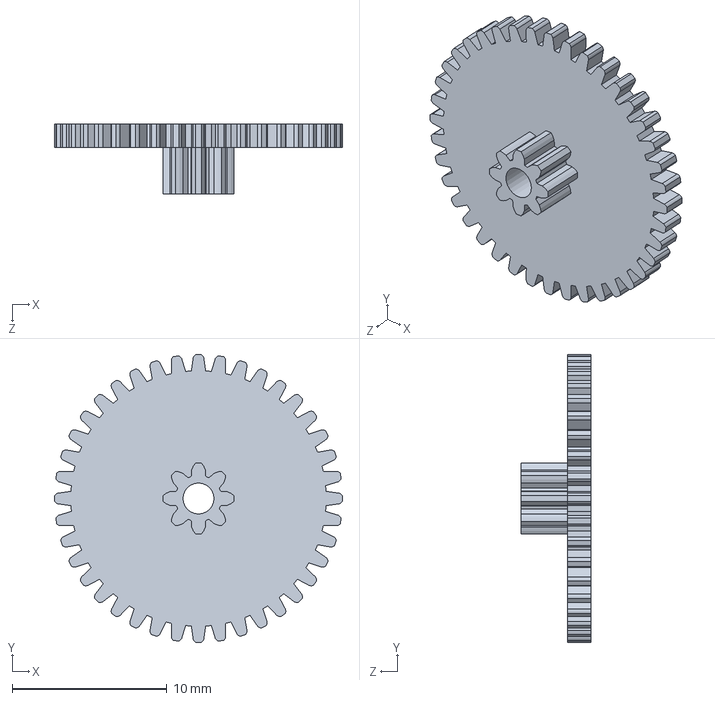
[picture p258: CAD file, 2021-05-23]
CAD_2/MOTORS/7.SLDPRT
18.6 x 18.6 x 4.50 mm
