MikAmperka/abot_src/CAD_2/SENSORS/LIDAR/22.SLDPRT

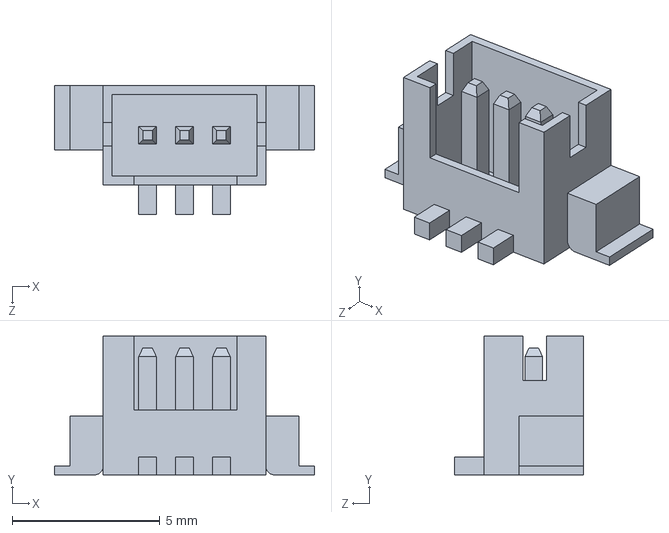
[picture p259: CAD file, 2021-05-23]
CAD_2/SENSORS/LIDAR/22.SLDPRT
8.80 x 4.70 x 4.36 mm
