MikAmperka/abot_src/CAD_2/MOTORS/6.SLDPRT

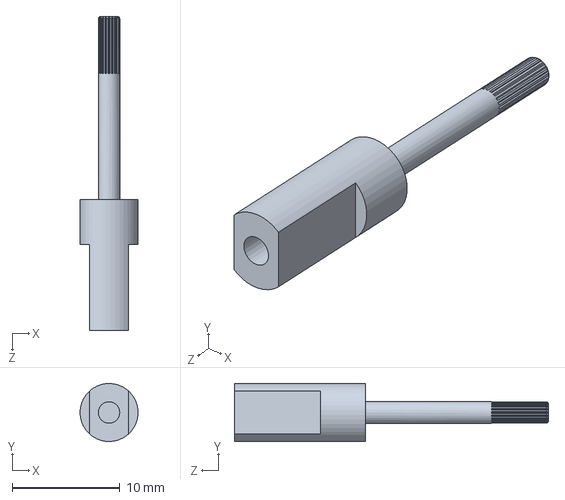
[picture p260: CAD file, 2021-05-23]
CAD_2/MOTORS/6.SLDPRT
5.39 x 5.40 x 29.2 mm
