MikAmperka/abot_src/CAD_2/SENSORS/LIDAR/20.SLDPRT

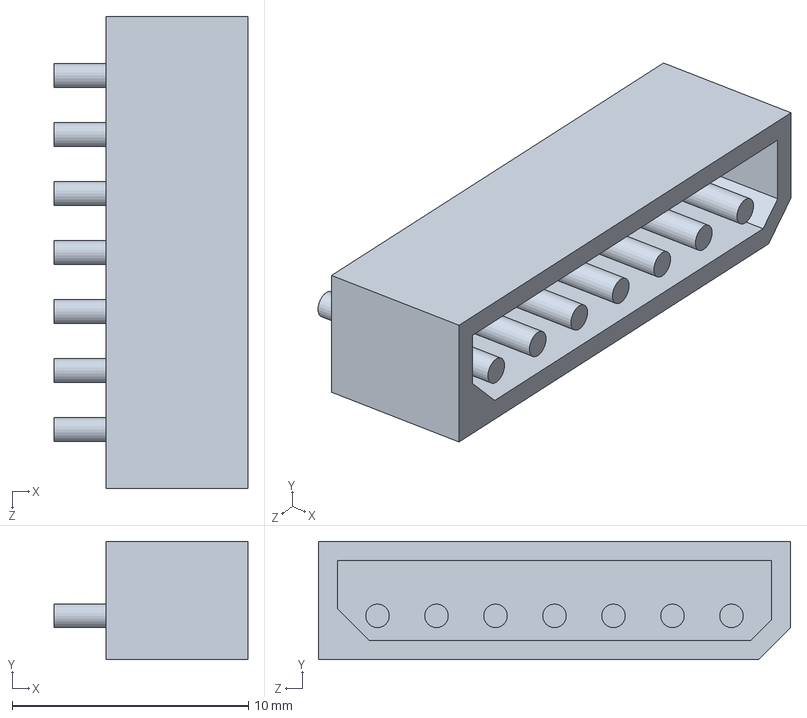
[picture p261: CAD file, 2021-05-23]
CAD_2/SENSORS/LIDAR/20.SLDPRT
8.20 x 5.00 x 20.0 mm
