MikAmperka/abot_src/CAD_2/MOTORS/1.SLDPRT

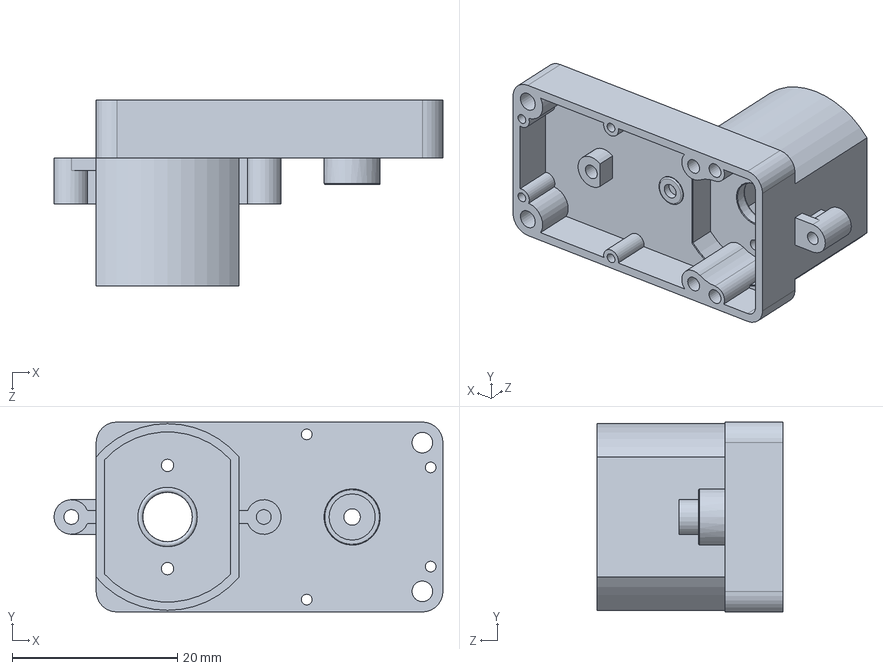
[picture p262: CAD file, 2021-05-23]
CAD_2/MOTORS/1.SLDPRT
47.1 x 23.0 x 22.5 mm
