MikAmperka/abot_src/CAD_2/SENSORS/LIDAR/21.SLDPRT

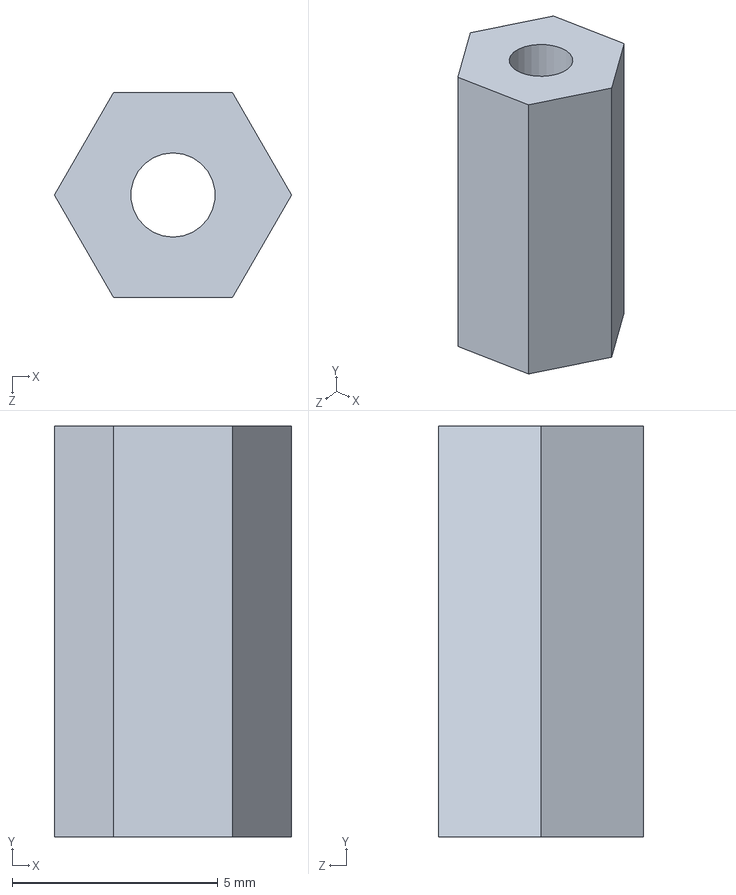
[picture p263: CAD file, 2021-05-23]
CAD_2/SENSORS/LIDAR/21.SLDPRT
5.77 x 10.0 x 5.00 mm
