MikAmperka/abot_src/CAD_2/SENSORS/LIDAR/13.SLDPRT

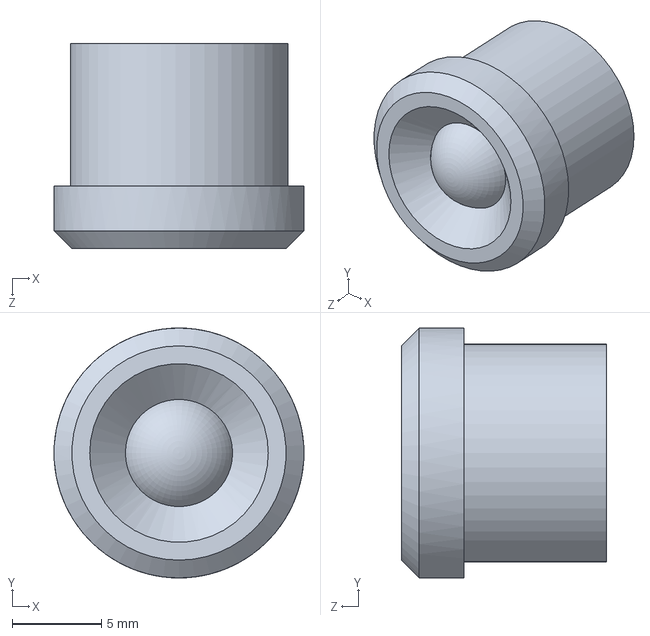
[picture p264: CAD file, 2021-05-23]
CAD_2/SENSORS/LIDAR/13.SLDPRT
14.0 x 14.0 x 11.5 mm
