MikAmperka/abot_src/CAD_2/SENSORS/LIDAR/4.SLDPRT

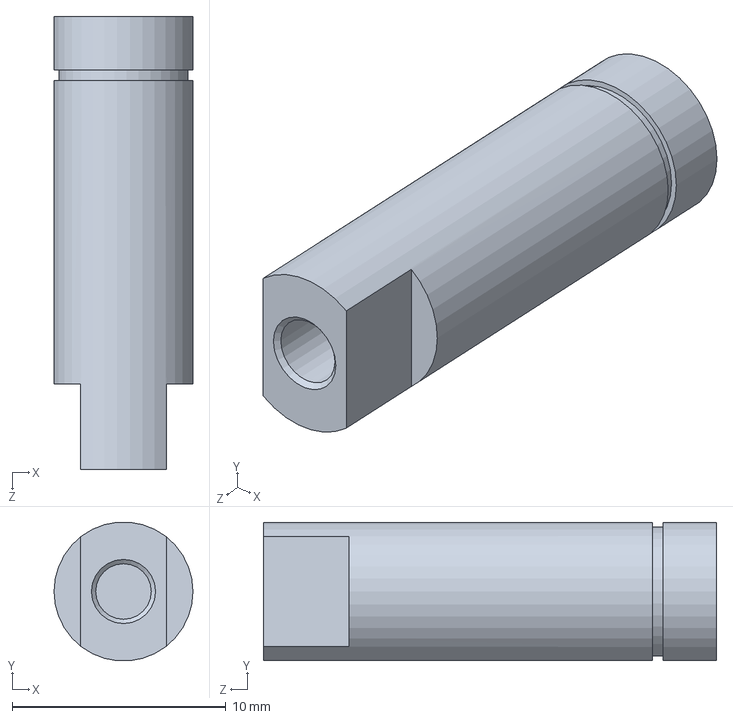
[picture p265: CAD file, 2021-05-23]
CAD_2/SENSORS/LIDAR/4.SLDPRT
6.50 x 6.47 x 21.2 mm
