MikAmperka/abot_src/CAD_2/SENSORS/LIDAR/14.SLDPRT

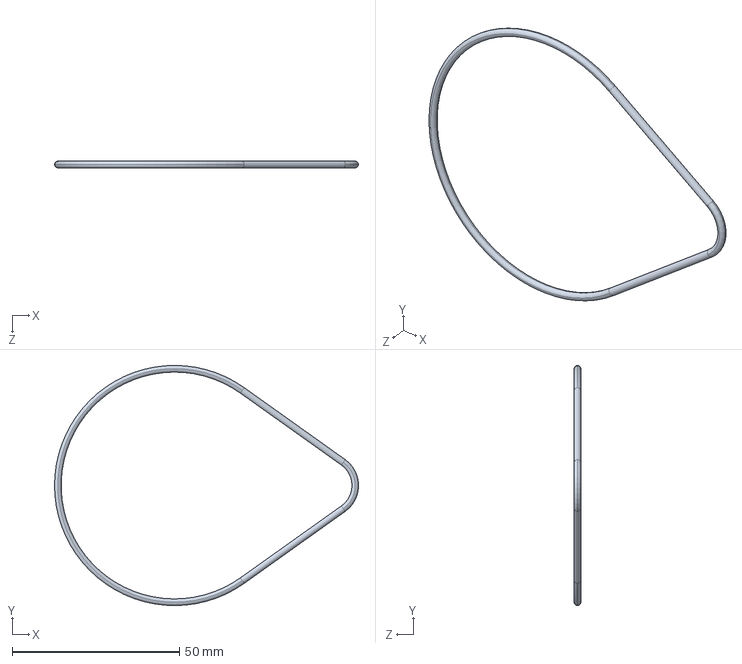
[picture p266: CAD file, 2021-05-23]
CAD_2/SENSORS/LIDAR/14.SLDPRT
90.9 x 71.8 x 2.00 mm
