MikAmperka/abot_src/CAD_2/SENSORS/LIDAR/1.SLDPRT

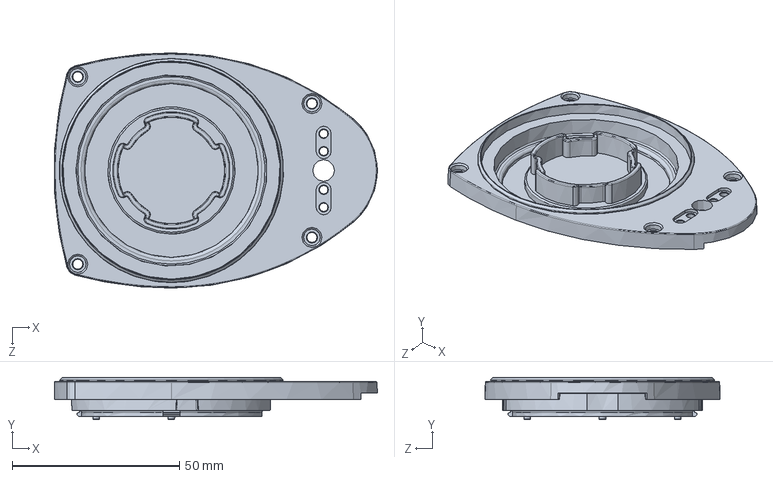
[picture p267: CAD file, 2021-05-23]
CAD_2/SENSORS/LIDAR/1.SLDPRT
96.6 x 12.7 x 70.3 mm
