MikAmperka/abot_src/CAD_2/SENSORS/LIDAR/5.SLDPRT

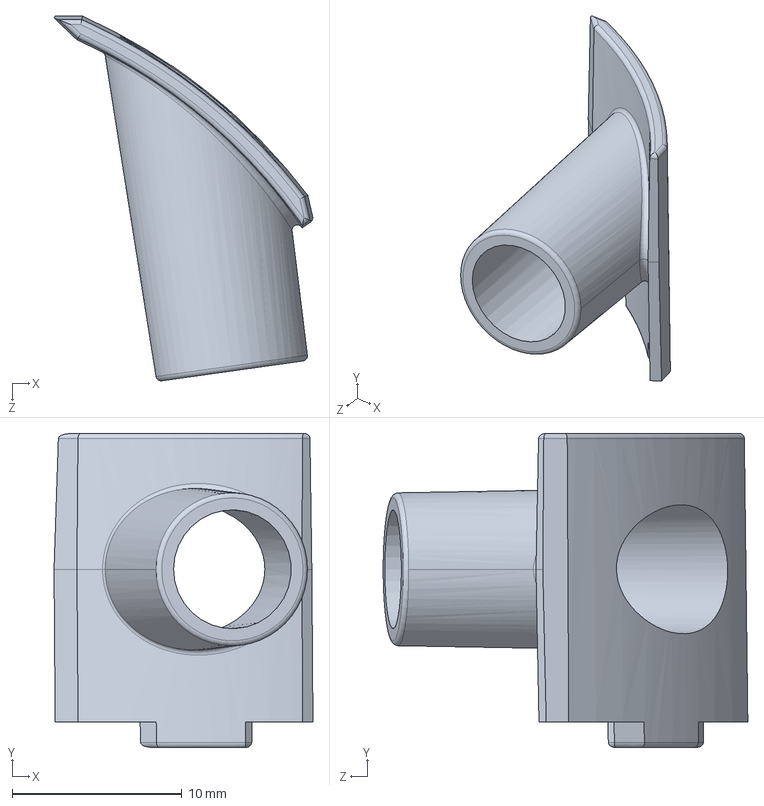
[picture p268: CAD file, 2021-05-23]
CAD_2/SENSORS/LIDAR/5.SLDPRT
15.3 x 18.5 x 21.5 mm
