MikAmperka/abot_src/CAD_2/SENSORS/LIDAR/6.SLDPRT

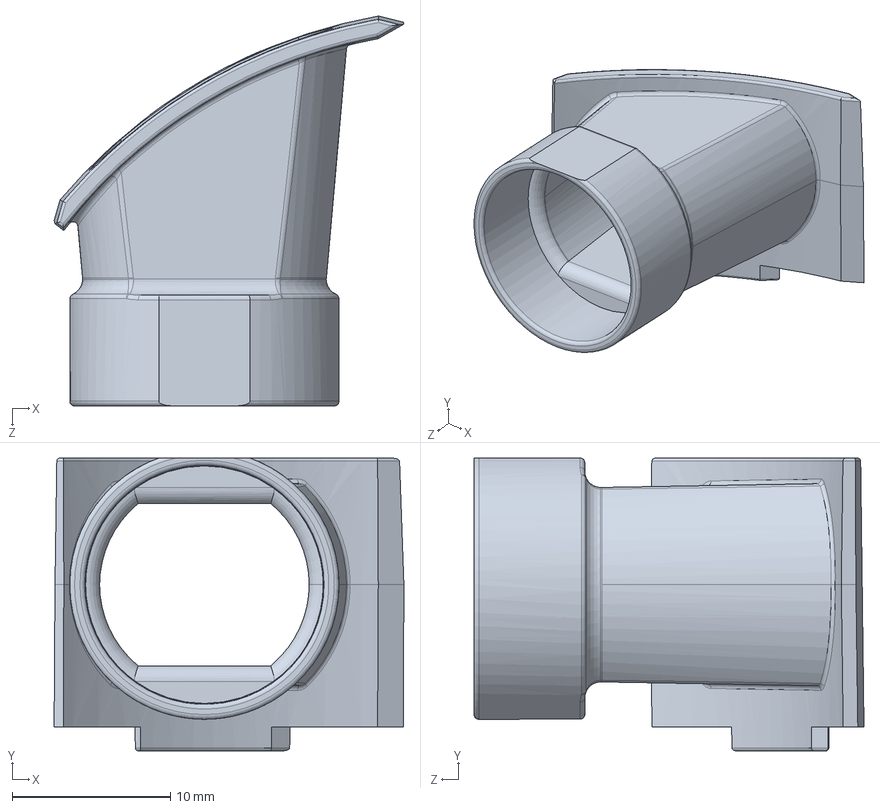
[picture p269: CAD file, 2021-05-23]
CAD_2/SENSORS/LIDAR/6.SLDPRT
22.1 x 18.5 x 24.6 mm
