MikAmperka/abot_src/(list of files, cad)

Other CAD files:
IMG/IMG_CAD/ABOT.DWG
URDF/ABOT/meshes/abot_right_wheel.STL
URDF/abot_step_1/meshes/abot_right_wheel.STL
CAD_2/SENSORS/SHARP_IR/GP2Y0A41SK0F.SLDPRT
PRINT_CUT/1.dwg
PRINT_CUT/PRINT/BIN/SHARP_IR_MOUNTING_BRACKET_VERTICAL.STL
ros/src/abot_description/meshes/left_wheel.STL
CAD_2/METALWARE/SHARP_IR_MOUNTING_BRACKET.SLDPRT
CAD_2/MOTORS/TT_ANGLE_MOTOR_PART.SLDPRT
PRINT_CUT/CUT/CUT_PLEX_PLATE_0.DWG
PRINT_CUT/PRINT/BIN/PRINT_ENCODER_MOUNT.STL
PRINT_CUT/PRINT_SHARP_IR_MOUNTING_BRACKET_VERTICAL.STL
URDF/abot_step_1/meshes/abot_left_wheel.STL
CAD_2/PRINT_ENCODER_MOUNT.SLDPRT
PRINT_CUT/CUT/CUT_PLEX_PLATE_1.DWG
ros/src/abot_description/meshes/ir_bl.STL
ros/src/abot_description/meshes/ir_r.STL
ros/src/abot_description/meshes/ir_fr.STL
ros/src/abot_description/meshes/ir_fl.STL
ros/src/abot_description/meshes/ir_f.STL
ros/src/abot_description/meshes/caster_wheel.STL
ros/src/abot_description/meshes/ir_br.STL
ros/src/abot_description/meshes/ir_b.STL
CAD_2/SCREWS/M3_12H.SLDPRT
CAD_2/SCREWS/M3_NUT.SLDPRT
CAD_2/SCREWS/M3_WASHER_NORMAL.SLDPRT
CAD_2/SENSORS/SHARP_IR/GP2Y0A41SK0F_AXIS_FRAME.SLDPRT
IMG/IMG_CAD/ABOT_1.SLDDRW
