MikAmperka/abot_src/Graphics/S3/INSTALL_1.png

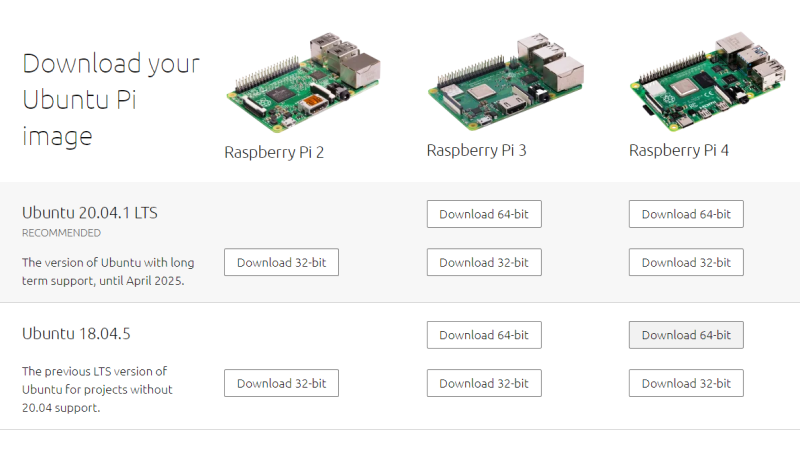
Graphics/S3/INSTALL_1.png
