MikAmperka/abot_src/Graphics/S3/INSTALL_2.png

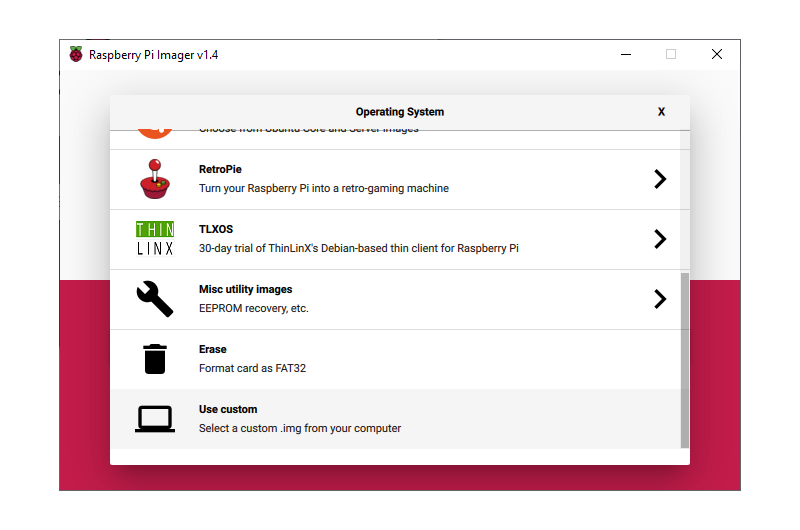
Graphics/S3/INSTALL_2.png
