MikAmperka/abot_src/Graphics/S3/INSTALL_3.png

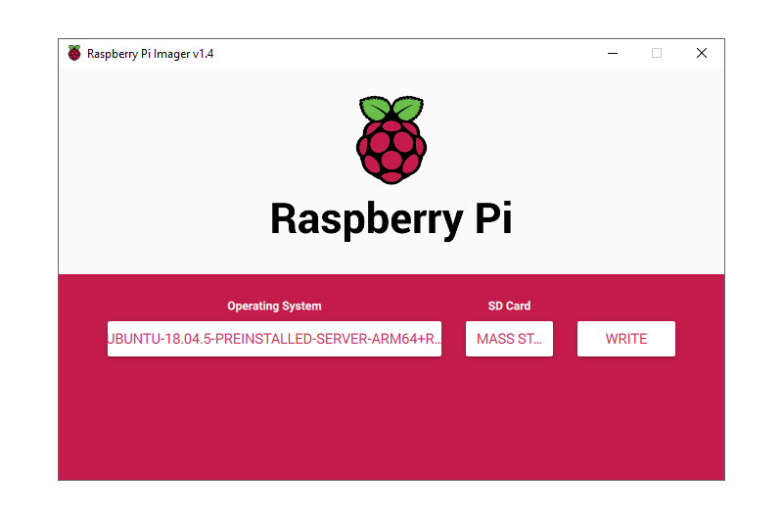
Graphics/S3/INSTALL_3.png
