MikAmperka/abot_src/media_unformatted/motors_friction_test.png

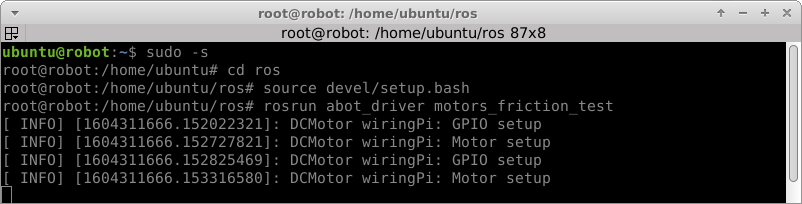
media_unformatted/motors_friction_test.png
