MikAmperka/abot_src/media_unformatted/rqt_friction_test.png

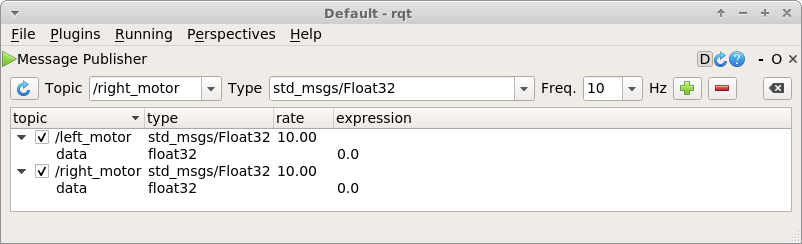
media_unformatted/rqt_friction_test.png
