MikAmperka/abot_src/(commit log)

2021-06-04 Fix Intro
    Правки во вступлении.
2021-06-18 Edit Purpose & Drive types
    Отредактировал главы «Цели робота» и «Привод робота».
