MikAmperka/abot_src/(notices)

Notices in the files:
ros/src/abot_driver/src/utility/wiringPiI2C_utility.h:
wiringPi is free software: you can redistribute it and/or modify
it under the terms of the GNU Lesser General Public License as
published by the Free Software Foundation, either version 3 of the
License, or (at your option) any later version.
