MikAmperka/abot_src/PHOTOS/IMG_6401.JPG

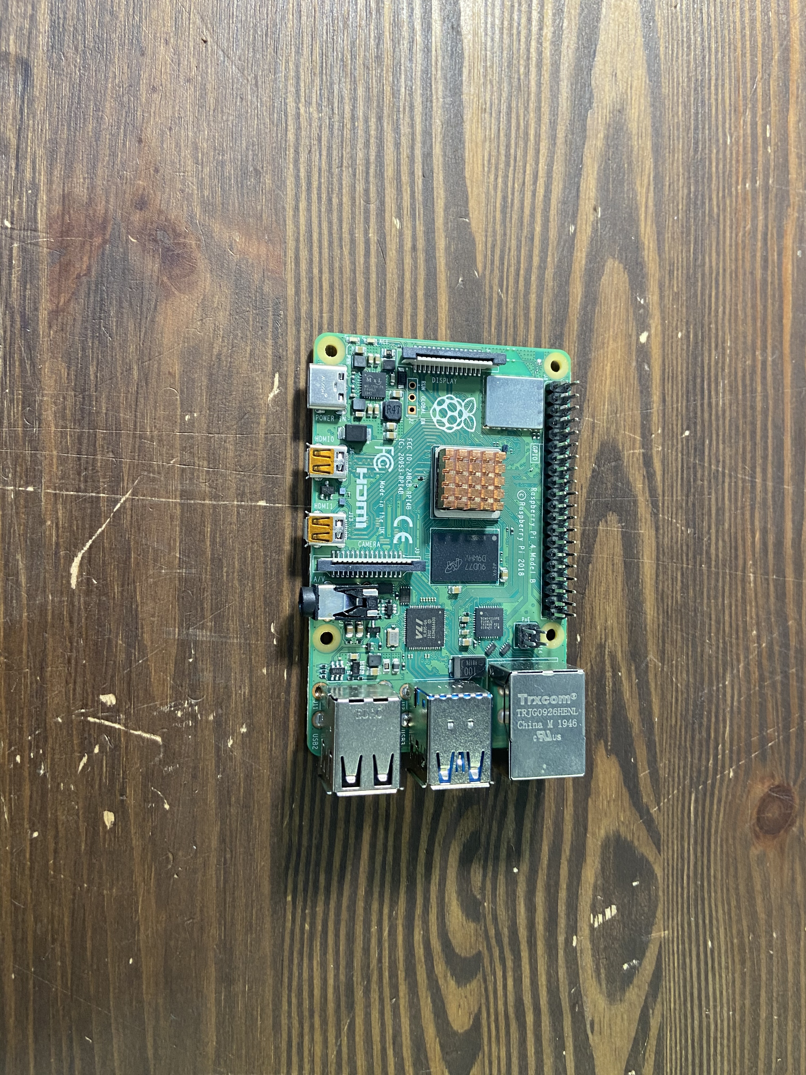
PHOTOS/IMG_6401.JPG
