MikAmperka/abot_src/PHOTOS/IMG_6402.JPG

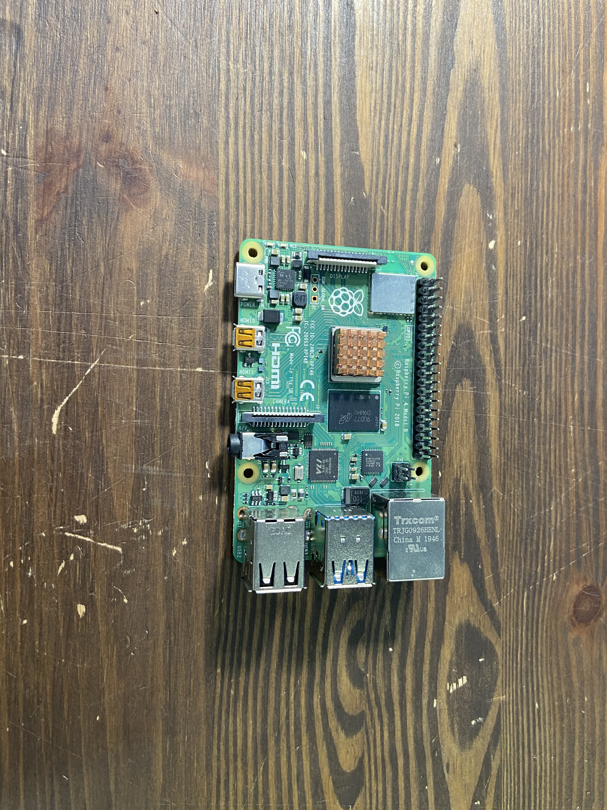
PHOTOS/IMG_6402.JPG
