MikAmperka/abot_src/PHOTOS/IMG_6403.JPG

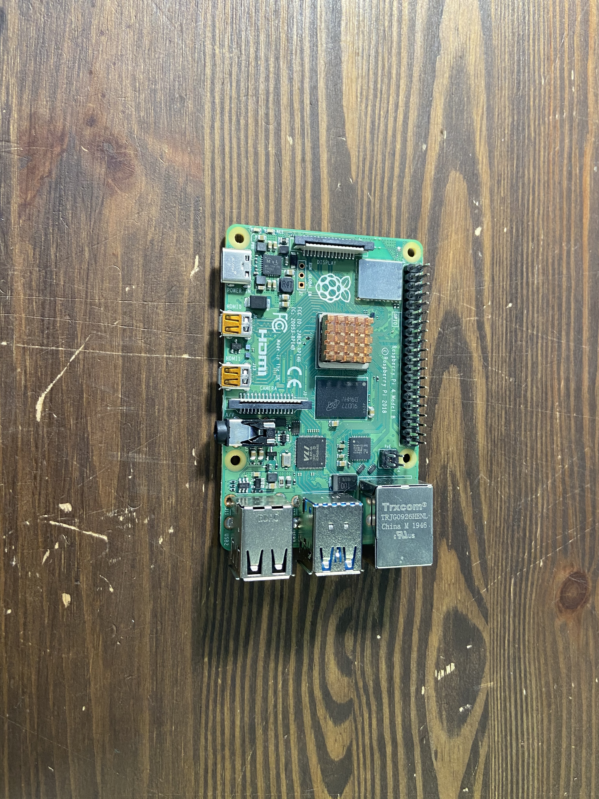
PHOTOS/IMG_6403.JPG
