MikAmperka/abot_src/PHOTOS/IMG_6404.JPG

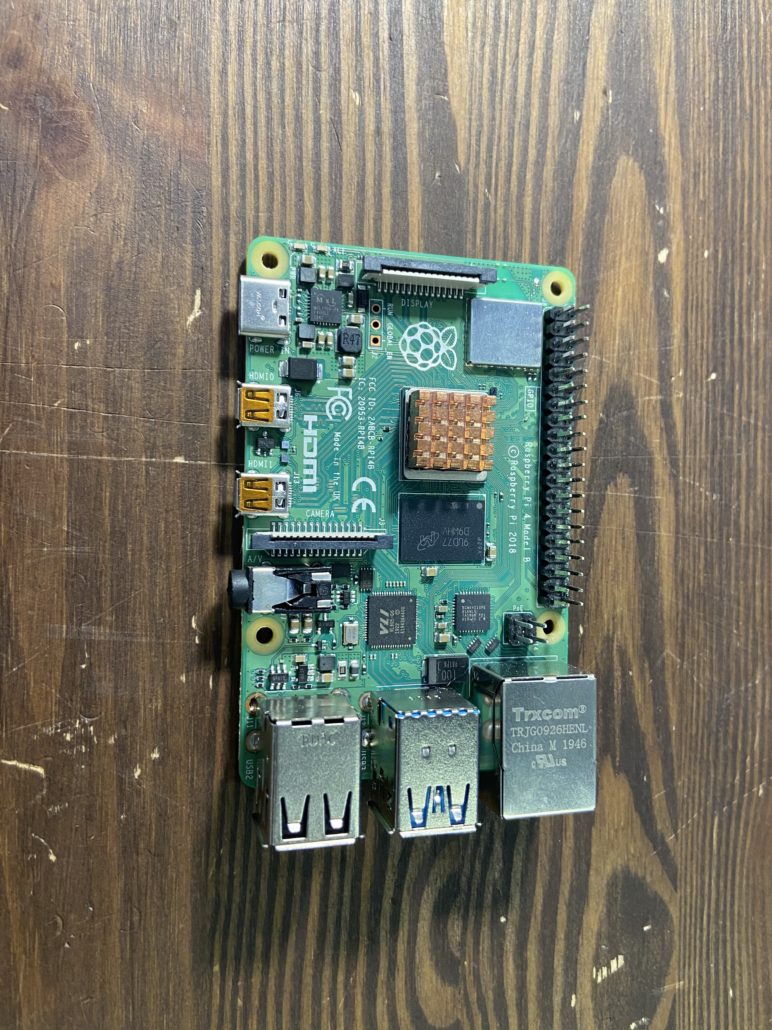
PHOTOS/IMG_6404.JPG
