MikAmperka/abot_src/PHOTOS/IMG_6405.JPG

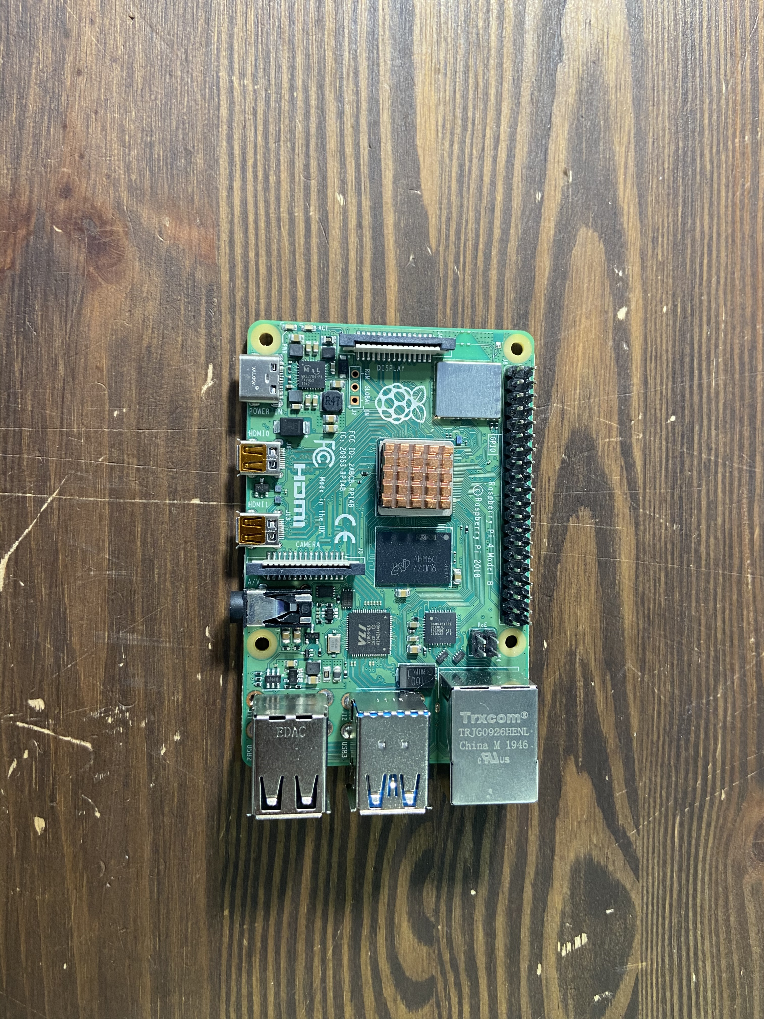
PHOTOS/IMG_6405.JPG
