MikAmperka/abot_src/PHOTOS/IMG_6406.JPG

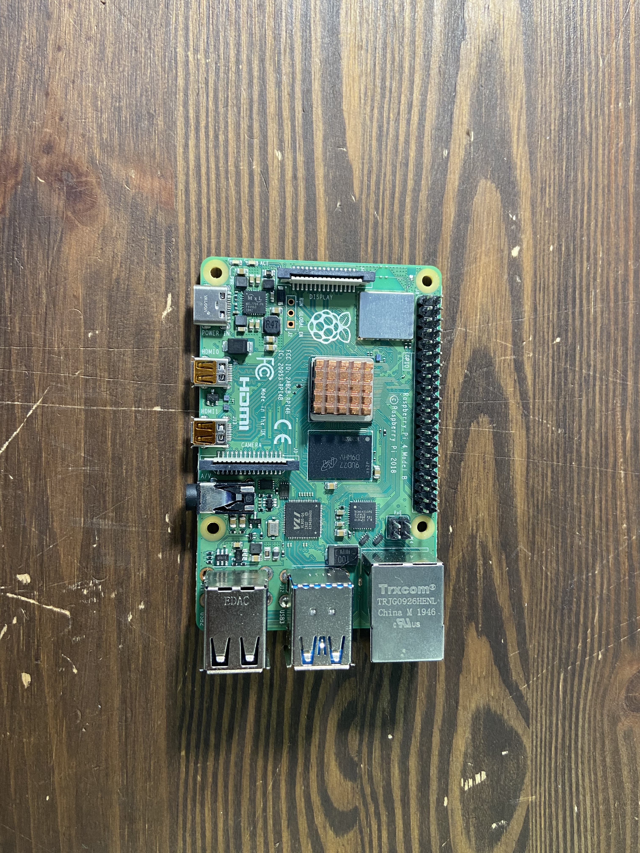
PHOTOS/IMG_6406.JPG
