MikAmperka/abot_src/PHOTOS/IMG_6506.JPG

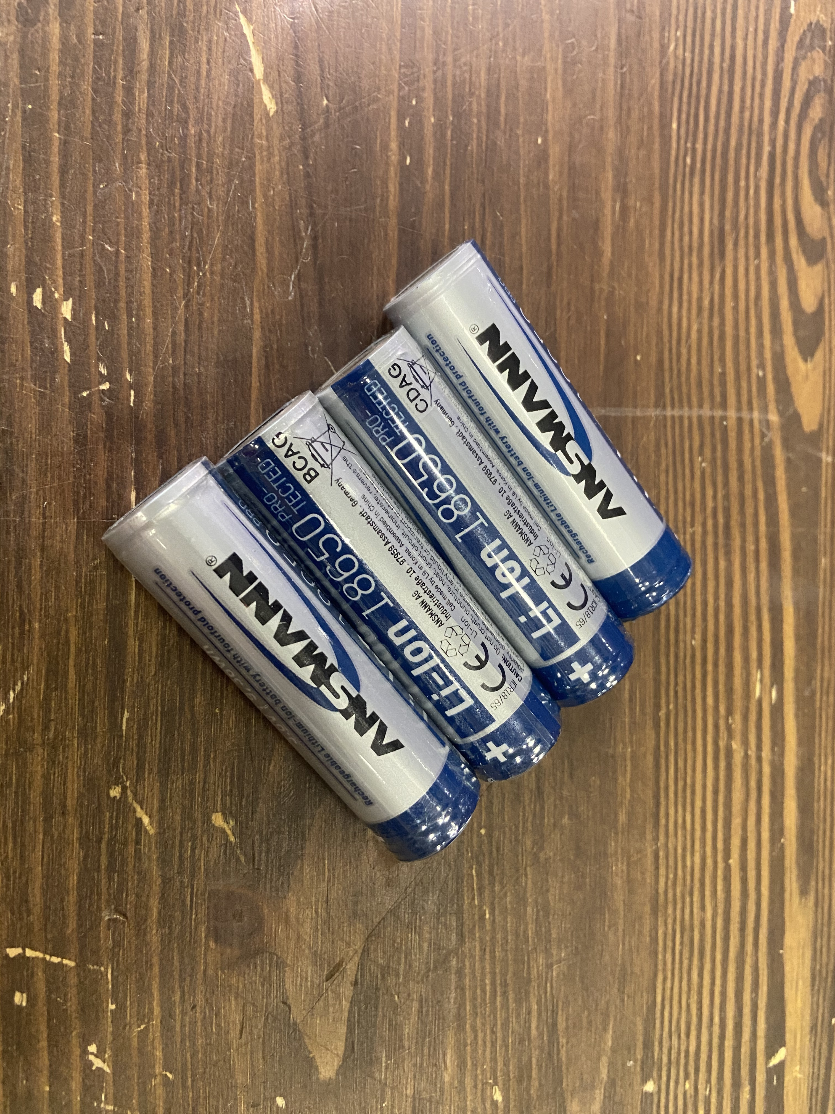
PHOTOS/IMG_6506.JPG
