MikAmperka/abot_src/PHOTOS/IMG_6524.JPG

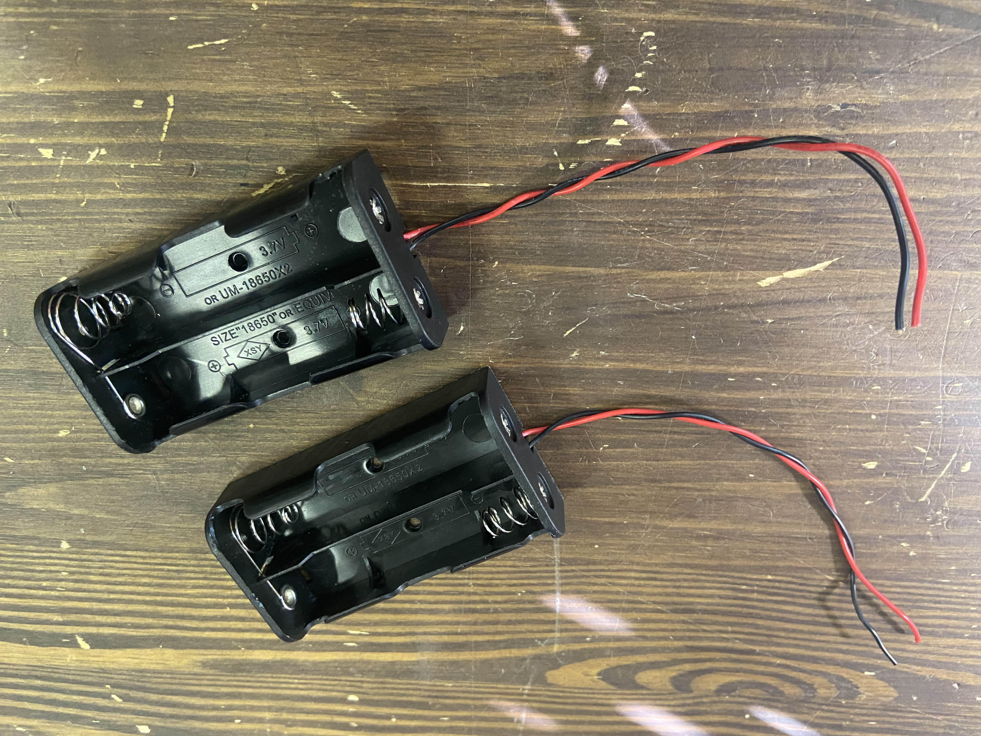
PHOTOS/IMG_6524.JPG
