MikAmperka/abot_src/PHOTOS/IMG_6529.JPG

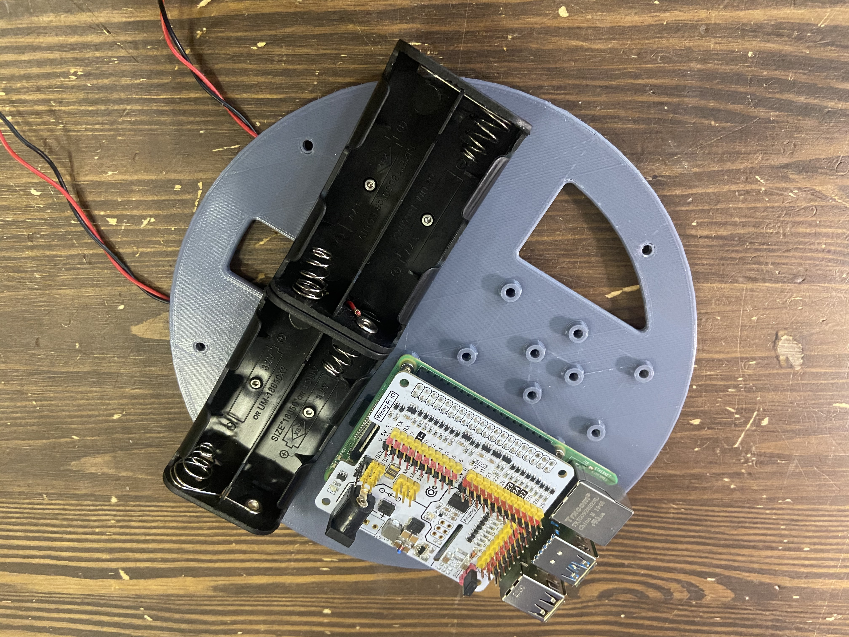
PHOTOS/IMG_6529.JPG
