MikAmperka/abot_src/PHOTOS/IMG_6657.JPG

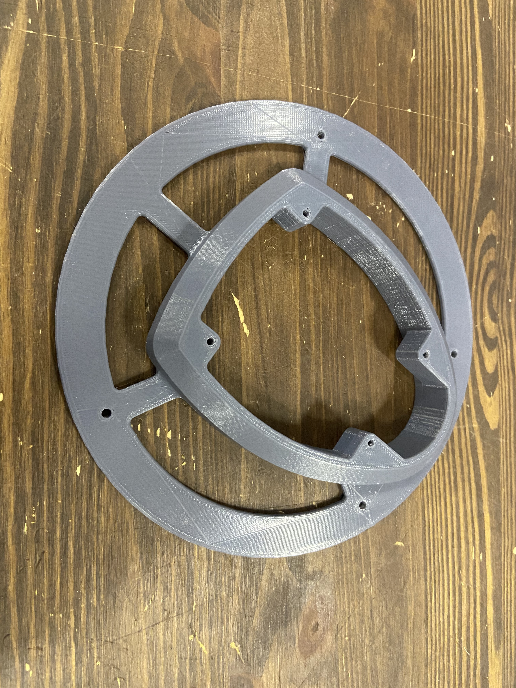
PHOTOS/IMG_6657.JPG
