MikAmperka/abot_src/PHOTOS/IMG_6670.JPG

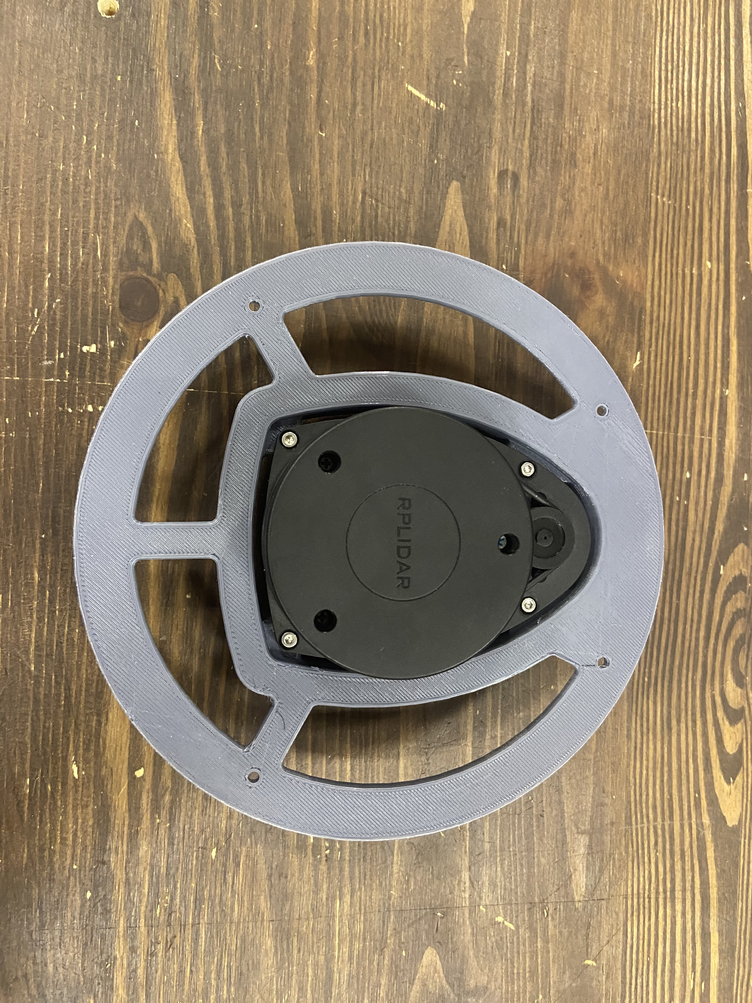
PHOTOS/IMG_6670.JPG
