MikAmperka/abot_src/PHOTOS/IMG_6676.JPG

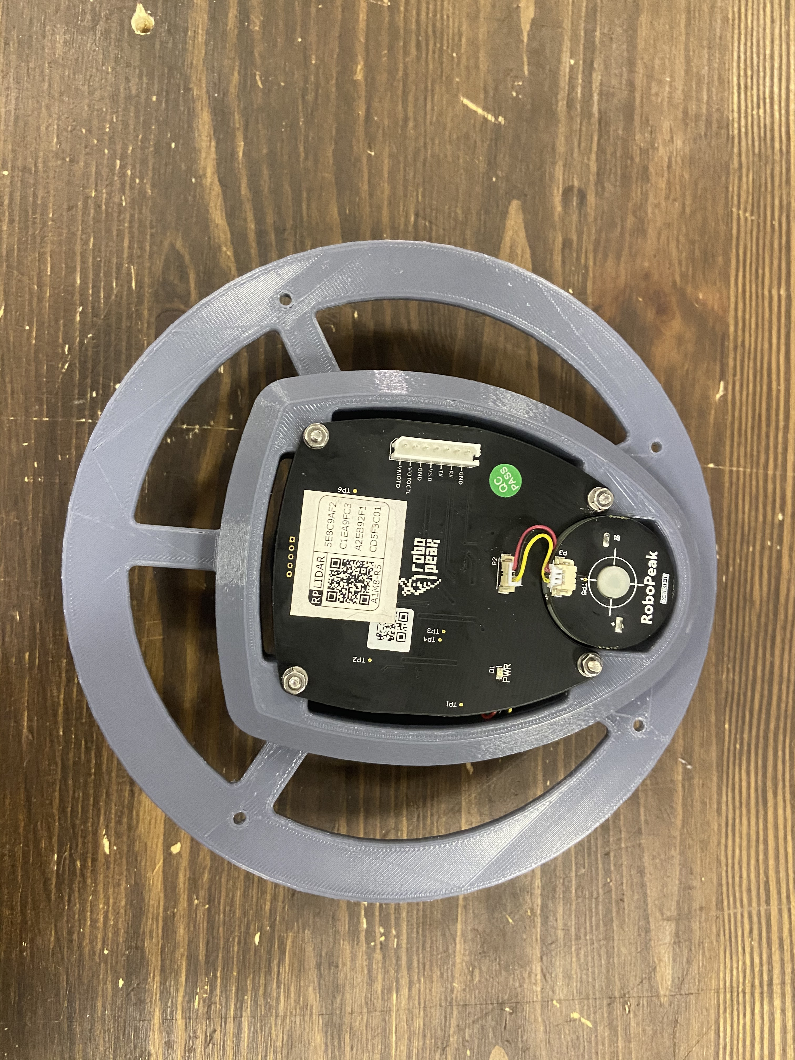
PHOTOS/IMG_6676.JPG
